lyy622516-web/phase_shifter/README.md

这是6bits移相器设计

当前腔体采用5 mm平底板、四块4 mm独立侧板和2 mm盖板，装配含PCB与左右两个SMA，共九件。SMA法兰孔为M2.2×0.45，针脚下侧至PCB顶面名义间隙0.25 mm。

四角各有两颗横向M2连接螺钉，共八颗：前角用M2×8，后角用M2×6。后角采用1 mm矩形接缝台阶，竖向框架保留六处连接位置；SMA、PCB、接口窗口及壳体外形保持原位置和尺寸。

- [加工文件包（六件壳体、七页工程图）](腔体/平底板腔体/加工文件_六件壳体.zip)
- [装配文件包（含PCB及两侧SMA）](腔体/平底板腔体/装配文件_含PCB及两侧SMA.zip)
- [原生模型、STEP及工程图](腔体/平底板腔体)
- [加工与装配说明](腔体/平底板腔体/说明.txt)

旧腔体模型及交付文件已移除，PCB和连接器参考源保存在[源模型](腔体/源模型)。设计报告保留在原目录，历史报告内容不代表本次几何已同步更新。
