lyy622516-web/phase_shifter/腔体/平底板腔体_侧向固定/说明.txt

移相器腔体（侧向固定版）

在 SolidWorks 中打开“移相器腔体.SLDASM”。装配包含六件壳体、PCB 参考件和左右 SMA，共九个组件。各组件及总装均提供 STEP。

四块 4 mm 厚侧板包围 5 mm 厚平底板，底面齐平，底板四周各留 0.02 mm 装配间隙。每块侧板开两个 Φ2.2 通孔，与底板边缘对应的 M2×0.4-6H 盲螺纹孔连接。底板攻丝底孔 Φ1.6，圆柱深 5 mm，有效牙深 4.5 mm。横向固定可采用 M2×8，穿过侧板及装配间隙后名义啮合约 3.98 mm。侧板四角和盖板的原连接仍保留。

每个 SMA 的 Φ4.1 穿墙孔和四个 M2.2×0.45 法兰孔均位于相应射频侧板上。法兰用 M2.2×5，1.7 mm 法兰厚度下名义啮合 3.3 mm。两侧针脚下缘到 PCB 顶面均为 0.250 mm。

壳体材料 6061-T6。普通线性尺寸公差 ±0.01 mm，普通光孔直径 +0.02/0 mm，螺纹按独立标注。工程图见“工程图”目录。SolidWorks 装配重开和九组件实体干涉核验通过，检查范围为已建模的壳体、SMA 和 PCB。
