lyy622516-web/phase_shifter/0.9-1.3GHz 6bits 360° 数控移相器模块技术方案 .docx

CS32F030 MCU 内置了那些类型与上位机通信的接口

# CS32F030（芯海科技，Cortex-M0）内置上位机通信接口

型号：CS32F030F4P6（我们移相器方案使用的型号），片上自带 USART、SPI、I²C 三组硬件串行接口，另外还有 SWD 调试口（仅调试烧录，不做业务通信）chipsea-ob...

## 1. USART（UART，本项目选用的上位机接口，2 路硬件：USART1 / USART2）

- 支持异步 UART（TTL 电平，就是我们方案里上位机通信），也支持同步模式
- USART1：能力更强，支持自动波特率检测、LIN、ISO7816、IrDA、Modbus、硬件流控 CTS/RTS、RS485 使能，可休眠唤醒 MCU
- USART2：基础 UART，支持异步、硬件流控、RS485 使能；无自动波特率、LIN 等高级功能
- 波特率最高可达 6Mbit/s；支持 DMA 收发，减轻 CPU 负担
- 引脚复用示例（F4P6）：
  - USART1：PA9 (TX) / PA10 (RX)（正是我们之前方案选用引脚）
  - USART2：PA2(TX) / PA3(RX)

✅ 本数控移相器模块就用 USART1 作为上位机 UART 通信，TTL 电平，可外接 CH340 转 USB 直连 PC。

## 2. SPI（2 路硬件 SPI1 / SPI2）

- SPI1：支持 SPI + I²S 音频复用；SPI1/SPI2 都支持主 / 从模式，全双工；帧宽 4~16bit 可编程，最高 18Mbps；支持 DMA、硬件 CRC
- 可用于：外接 SPI Flash、ADC，或者上位机 SPI 通信；本项目不用 SPI 做上位机通信，SPI 在本方案闲置

## 3. I²C（2 路硬件 I2C1 / I2C2）

- 主 / 从模式，7bit/10bit 地址；速率：100k（标准）/400k（快速）/1M（超快模式）；带 PEC 校验、数字 / 模拟滤波器；支持 DMA
- 适合：I2C 传感器、EEPROM；不推荐长距离上位机通信

## 4. SWD（串行调试口 PA13/PA14）

⚠️ 不属于业务通信接口，仅用于程序下载、在线调试，不能用来和上位机传输移相指令。

# 接口选型小结（对应你的 XT3301Q6 移相器项目）

表格

接口 | 是否适合上位机通信 | 说明
USART(UART) | ✅推荐 | TTL 串口，PC 端只需要 CH340，接线简单，抗干扰尚可；本方案选定
SPI | 可选 | 高速，但需要 4 根线；上位机一般不带原生 SPI
I2C | 不推荐 | 适合板内短距离外设，不适合模块和上位机之间通信

# 补充引脚资源（CS32F030F4P6）

USART1：PA9 (TX)、PA10 (RX)；正好保留剩余 GPIO 输出 XT3301Q6 的 6bit 并行控制线 + LE 锁存引脚，资源完全够用。

如果你需要，我可以把CS32F030F4P6 的 USART1 初始化代码框架（接收中断模式）直接写出来，适配当前移相器 UART 指令协议。

CS32F030C8T6（LQFP48）MCU 芯片的 Datasheet

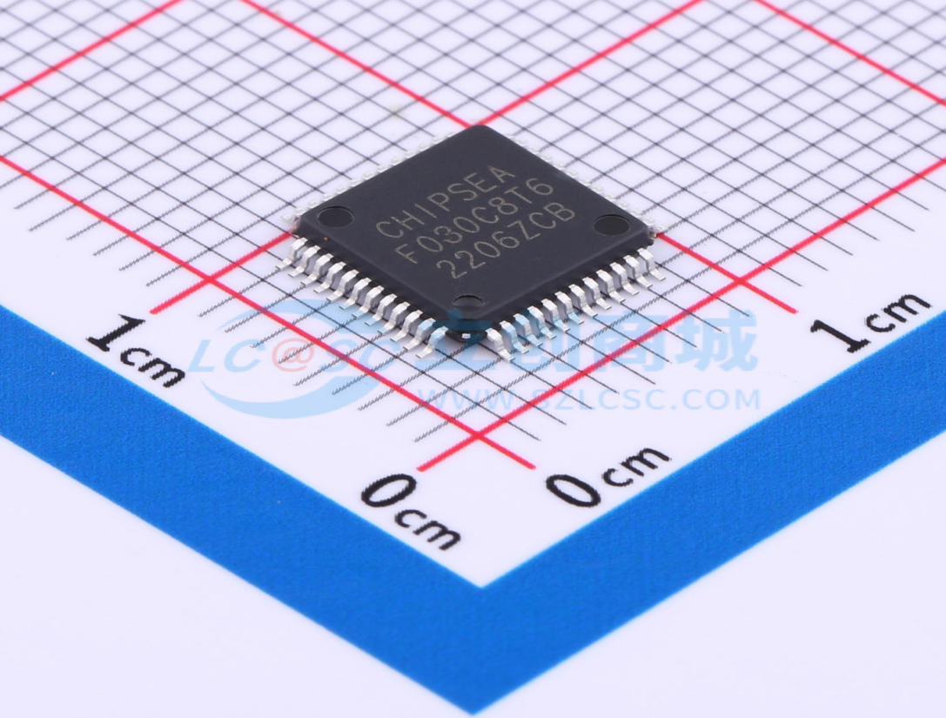
[picture p1: figure]

# CS32F030C8T6（LQFP48）Datasheet 精简版（芯海 CHIPSEA）

芯片：CS32F030C8T6 LQFP48(7×7mm)，Cortex-M0 内核，适配你的移相器主控板

## 1 概述

CS32F030C8T6 是芯海科技 32 位 Cortex-M0 工业级通用 MCU，最高主频 48MHz，内置 64KB Flash / 8KB SRAM，宽电压 2.0~5.5V，LQFP48 封装引出最多 39 路 GPIO，集成 12bit ADC、多路定时器、2×SPI、2×I2C、多路 USART、SWD 单线调试，非常适合你的 XT3301Q6 移相器数字控制板。

### 核心特性

表格

项目 | 参数
内核 | ARM Cortex-M0，最高 48MHz
Flash | 64KB，支持读写保护
SRAM | 8KB，支持硬件奇偶校验
工作电压 | VDD：2.0V ~ 5.5V；模拟电源 VDDA
工作温度 | CS32F030C8T6：-40℃ ~ +85℃；C8T7 版本 - 40~105℃
复位 | 上电复位 POR、掉电复位 BOR、软件复位、独立看门狗复位
时钟源 | 外部高速晶振 HSE（4~32MHz，你的板使用 8MHz）、内部 HSI RC、LSE 32.768kHz、LSI 内部 RC；支持 PLL 倍频到 48MHz
定时器 | 1 路高级 PWM 定时器（带刹车 / 死区）+5 路 16bit 通用定时器；SysTick；独立看门狗 IWDG、窗口看门狗 WWDT；RTC 实时时钟
模拟外设 | 1×12bit ADC，10 路外部通道，最高 1MSPS，内置片上温度传感器
通信接口 | 2×SPI、2×I2C、5×USART（UART）
调试接口 | SWD 单线调试（2 引脚：SWCLK、SWDIO），支持在线烧录 / 调试，无 JTAG
安全模块 | CRC32 硬件校验，96bit 唯一芯片 UID
GPIO | 最多 39 路 GPIO；支持推挽 / 开漏、上下拉；全部支持外部中断
ESD | HBM ±4kV，工业级抗干扰

## 2 LQFP48 引脚定义（重点，适配你当前移相器硬件分配）

LQFP48，逆时针引脚编号，左上角为 Pin1。 你当前硬件分配：PB0~PB5 6bit 移相数据；PB6 为 LE 锁存信号；USART1 接 CH340；USART2 预留；SPI1/I2C1 预留；SWD 用于烧录调试。

表格

引脚 | 名称 | 功能说明
1 | PB8 | GPIO / TIM1_CH2 / USART3_TX
2 | PB9 | GPIO / TIM1_CH3 / USART3_RX
3 | PB10 | GPIO / USART3_TX / I2C2_SCL
4 | PB11 | GPIO / USART3_RX / I2C2_SDA
5 | PB12 | GPIO / TIM1_BKIN
6 | PB13 | GPIO / SPI2_SCK / TIM1_CH1N
7 | PB14 | GPIO / SPI2_MISO / TIM1_CH2N
8 | PB15 | GPIO / SPI2_MOSI / TIM1_CH3N
9 | VDD | 电源 2.0~5.5V（你的板 3.3V 供电）
10 | VSS | GND
11 | PA0 | GPIO / ADC_IN0 / USART2_CTS
12 | PA1 | GPIO / ADC_IN1 / USART2_RTS
13 | PA2 | GPIO / ADC_IN2 / USART2_TX
14 | PA3 | GPIO / ADC_IN3 / USART2_RX
15 | PA4 | GPIO / ADC_IN4 / SPI1_NSS
16 | PA5 | GPIO / ADC_IN5 / SPI1_SCK
17 | PA6 | GPIO / ADC_IN6 / SPI1_MISO
18 | PA7 | GPIO / ADC_IN7 / SPI1_MOSI
19 | PB0 | GPIO / ADC_IN8 / TIM3_CH3 → 移相 Bit0
20 | PB1 | GPIO / ADC_IN9 / TIM3_CH4 → 移相 Bit1
21 | PB2 | GPIO / BOOT1 → 移相 Bit2
22 | PB3 | GPIO / SPI1_SCK / TIM1_CH1 → 移相 Bit3
23 | PB4 | GPIO / SPI1_MISO / TIM1_CH2 → 移相 Bit4
24 | PB5 | GPIO / SPI1_MOSI / TIM1_CH3 → 移相 Bit5
25 | PB6 | GPIO / I2C1_SCL / TIM4_CH1 → LE 锁存信号
26 | PB7 | GPIO / I2C1_SDA / TIM4_CH2
27 | VDD | 电源
28 | VSS | GND
29 | NRST | 复位输入，低电平复位
30 | PC13 | GPIO / RTC_OUT
31 | PC14 | OSC32_IN（LSE 晶振输入）
32 | PC15 | OSC32_OUT（LSE 晶振输出）
33 | PA8 | GPIO / TIM1_CH1
34 | PA9 | GPIO / USART1_TX（CH340 TX）
35 | PA10 | GPIO / USART1_RX（CH340 RX）
36 | PA11 | GPIO / TIM1_CH4
37 | PA12 | GPIO / TIM1_ETR
38 | PA13 | SWDIO（调试数据）
39 | PA14 | SWCLK（调试时钟）
40 | PA15 | GPIO / SPI1_NSS / TIM2_CH1
41 | PB3 | GPIO / SPI1_SCK
42 | PB4 | GPIO / SPI1_MISO
43 | PB5 | GPIO / SPI1_MOSI
44 | PB6 | GPIO / I2C1_SCL
45 | PB7 | GPIO / I2C1_SDA
46 | BOOT0 | 启动配置引脚；BOOT0=0，从主 Flash 启动
47 | VDD | 电源
48 | VSS | GND

你的硬件资源分配汇总：

- PB0~PB5：6bit 相位并行数据输出
- PB6：LE，锁存使能，上升沿锁存 XT3301Q6 相位
- PA9/PA10：USART1，CH340 USB 虚拟串口
- PA2/PA3：USART2，预留扩展串口
- PA4/PA5/PA6/PA7：SPI1，预留
- PB6/PB7：I2C1，预留
- PA13/PA14：SWD 调试口，烧录、在线调试
- NRST：复位引脚

## 3 电气极限参数（最大额定值，超过会永久损坏芯片）

警告：绝对最大额定值，长期工作不能达到此值 | 参数 | 符号 | 极限值 | 单位 | |---|---|---|---| | 供电电压 | VDD|−0.3 ~ +5.8|V| | 模拟电源 | VDDA|−0.3 ~ +5.8|V| |GPIO 输入电压 | VIN|−0.3 ~ VDD+0.3|V| | 单引脚灌 / 拉电流 | I_IO|±20|mA| | 芯片总电流 | IVDD|120|mA| | 存储温度 | Tstg|−55 ~ +125|℃|

## 4 推荐工作条件（正常工作区间，你的板 3.3V 供电）

表格

参数 | 符号 | 最小值 | 典型 | 最大值 | 单位
供电电压 | VDD | 2.0 | 3.3 | 5.5 | V
模拟电源 | VDDA | 2.0 | 3.3 | 5.5 | V
工作温度 | Ta | -40 | 25 | +85 | ℃
系统时钟 | fSYS | — | 48 | 48 | MHz

## 5 电源与复位电路设计要点（硬件调试重点）

1. VDD 每一组电源引脚就近放置 0.1μF X7R 去耦电容，VDD 到 VSS，紧贴 LQFP48 电源引脚；
2. VDDA 模拟电源增加 RC 滤波，减少 ADC 噪声；
3. NRST 复位引脚：上拉 10k 电阻到 VDD，并联 100nF 电容到 GND，上电自动复位；预留复位按键；
4. BOOT0：10k 下拉电阻到 GND，默认 Flash 启动；如需 ISP 烧录，拉高 BOOT0。

## 6 时钟系统（你的移相器板：外部 8MHz HSE 晶振）

- HSE：外部 8MHz 晶振，经 PLL 倍频到 48MHz 作为系统主时钟；
- 内部 HSI：8MHz 内置 RC，可作为备用时钟，不使用外部晶振也可运行；
- LSE：32.768kHz 低速晶振，给 RTC，可选；
- LSI：内部 RC 40kHz，供看门狗。

## 7 SWD 调试接口设计（烧录调试）

- PA13：SWDIO
- PA14：SWCLK
- 不需要 JTAG，仅 2 根线；串联 220Ω 电阻可选保护；
- NRST 可引出给下载器复位。

## 8 外设说明（适配你的项目）

1. USART（UART）：5 路，支持 8N1 等，波特率最高可达 fPCLK/16；你的 USART1 连接 CH340，上位机下发相位指令。
2. SPI：2 路，主 / 从模式，最高 fSYS/2；预留 SPI1。
3. I2C：2 路，标准 100kHz / 400kHz 快速模式。
4. ADC：12bit，1MSPS，10 通道，内置温度传感器。
5. 定时器：高级定时器 TIM1 可输出互补 PWM；TIM2~TIM5 通用定时器，可做定时 / 捕获 / PWM。
6. 看门狗 IWDG/WWDT：用于死机自动复位，整机可靠性加固。

## 9 低功耗模式

- Sleep：CPU 停止，外设保持运行；
- DeepSleep：内核 + 大部分外设关闭，RTC、看门狗可继续运行；
- 待机模式，功耗最低。

## 10 配套开发资料获取

官方原版 PDF 完整 Datasheet 下载：芯海科技官网 CHIPSEA CS32F030 系列规格书；同时提供 SDK 库、寄存器手册、IDE 支持（Keil MDK、芯海 CSIDE）。

## 11 该 MCU 在你的 XT3301 移相器板的调试故障点补充（承接前面故障排查清单）

1. SWD 识别不到：检查 PA13/PA14、NRST、VDD 供电；BOOT0 引脚状态；晶振不起振。
2. GPIO 输出无电平（PB0~PB5、PB6 LE）：检查 GPIO 时钟是否开启，推挽输出配置，引脚是否被复用功能占用。
3. USART 串口无收发：USART 时钟、TX/RX 引脚复用配置，波特率，CH340 供电。
4. 上电死机：BOR 掉电检测、电源时序、复位电路、Flash 读保护。

如果你需要，我可以：

1. 单独输出LQFP48 引脚图文本版，可直接粘贴到原理图文档；
2. 输出CS32F030C8T6 最小系统原理图（文字版）；
3. 输出寄存器简要手册，或者基于该 MCU 的移相器控制底层驱动框架（初始化、相位锁存函数）。

## XT3301Q6 基本参数（先对齐）

- 工艺：GaAs PHEMT
- 频率：0.9–1.3 GHz（覆盖 860–960 MHz）
- 位数：6 bit → LSB=5.625°，0～360°
- 插入损耗：5 dB（typ）
- RMS 相位误差：≤2°
- 输入 P1dB：+23 dBm（typ）
- 控制：0V=0，+5V=1（GPIO 直驱）
- 供电：VEE = –5 V
- 封装：QFN6×6 mm，带底部大焊盘（必须接地）成都仙童科技有限公司

## 二、管脚定义（QFN6×6，俯视图）

参考原厂 PDF 功能框图：

- RFIN（射频输入）：引脚 1
- RFOUT（射频输出）：引脚 3
- VEE（–5V 电源）：引脚 21
- VC1～VC6（6bit 控制，GPIO）：引脚 22、23、24、25、26、27
- GND：引脚 2、19、31 + 底部大焊盘（必须大面积接地）
- NC：其余引脚全部悬空或接地成都仙童科技有限公司

## 三、典型应用电路（直接照抄）

### 1）电源部分（VEE = –5V）

- 引脚 21（VEE）→ 串 0Ω/10Ω 电阻 → –5V 电源
- 就近并联：10 μF（钽 / 陶瓷）+ 0.1 μF（高频） → 到 GND
- 电源回路尽量短，远离射频线

### 2）射频端口（RFIN / RFOUT，50Ω）

- RFIN（1）→ 串联 50Ω 微带线 → 输入信号
- RFOUT（3）→ 串联 50Ω 微带线 → 下一级 / 负载
- 输入 / 输出各串一个 100pF 隔直电容（靠近引脚）
- 射频线阻抗严格 50Ω，线宽按板材算（如 FR4、εr=4.4、板厚 0.5mm → 线宽≈0.8mm）

### 3）控制接口（VC1～VC6，GPIO 0/+5V）

- VC1～VC6（22–27）→ 直接接 MCU/FPGA 的 GPIO
- 控制电平：0V=0，+5V=1（兼容 5V 逻辑）
- 每个控制脚串 1kΩ 限流电阻（可选，保护芯片）
- 控制走线远离射频线，用地线隔离

### 4）地处理

- 所有 GND 引脚（2、19、31）→ 直接打多颗过孔到内层 / 底层地平面
- 底部大焊盘 → 必须全 via 阵列接地（至少 9 颗过孔），不能悬空成都仙童科技有限公司

## 四、GPIO 真值表（6bit，VC1=LSB，VC6=MSB）

- 编码：VC6 VC5 VC4 VC3 VC2 VC1（2⁵～2⁰）
- 步进：5.625°

表格

相位 (°) | VC6 VC5 VC4 VC3 VC2 VC1 | 十六进制
0 | 000000 | 00
5.625 | 000001 | 01
11.25 | 000010 | 02
16.875 | 000011 | 03
22.5 | 000100 | 04
45 | 001000 | 08
90 | 010000 | 10
180 | 100000 | 20
354.375 | 111111 | 3F

- 规律：VC1=5.625°，VC2=11.25°，VC3=22.5°，VC4=45°，VC5=90°，VC6=180°
- 任意相位 = 各位置加权之和（如 30° = 22.5+5.625+1.875 → 000101）

给出手机适配器供电，与上位机的通信接口为UART，基于XT3301Q6、CS32F030的数控射频移相器模块的完整技术方案及BOM

# 基于 XT3301Q6、CS32F030，UART 上位机通信、USB 手机适配器供电数控移相器模块完整技术方案

## 一、方案概述

### 1.1 系统总体架构

模块采用USB 手机适配器 5V 直流供电；

- 射频核心：XT3301Q6，L 波段 0.9~1.3GHz，6bit 数控移相，0~360° 可调，最小步进 5.625°，芯片供电+5V/-5V 双极性模拟电源
- 控制核心：CS32F030（Cortex-M0 国产 MCU），供电 3.3V；
- 上位机接口：UART 异步串口（TTL 电平），上位机（PC / 工控板）通过 UART 下发角度指令，MCU 解析指令，换算为 6bit 移相控制字，并行 IO 输出配置 XT3301Q6；同时回传模块状态、当前相位、电源状态。

不再使用 SPI 作为上位机接口；SPI 仅作为 MCU 内部备用（本方案不用），外部上位机通信改为 UART。

电源链路：USB 适配器 5V 输入

1. 5V → XT3301Q6 +5V 射频模拟电源
2. 5V → LM27762 反极性 DC-DC → 输出-5V 射频模拟电源
3. 5V → LP2985-3.3 低噪声 LDO → 3.3V 数字电源供给 CS32F030、UART 电平、指示灯等数字电路
4. TPS3700 双路电压监控：监测 + 5V、-5V，两路电源稳定后才释放 XT3301Q6 使能，实现上电 / 掉电时序保护，防止射频芯片损坏。

### 1.2 模块主要技术指标

表格

项目 | 参数
射频工作频段 | 0.9GHz～1.3GHz
移相范围 | 0°～360°
移相分辨率 | 6bit，最小步进 5.625°
射频端口阻抗 | 50Ω
上位机通信接口 | UART TTL，波特率默认 115200，8N1 可配置
供电来源 | USB 手机适配器，DC5V 输入
射频芯片电源 | +5V /-5V（模拟）
MCU 电源 | 3.3V（数字）
工作温度 | -40℃～+85℃
控制响应时间 | ≤10μs（收到 UART 指令到相位锁定）

### 1.3 系统工作流程

1. 模块上电：USB 适配器输出 5V；LDO 输出 3.3V，CS32F030 启动；LM27762 产生 - 5V；TPS3700 持续监测 ±5V。
2. 当 + 5V、-5V 电压均达到阈值，TPS3700 输出有效使能信号给到 XT3301Q6；MCU 等待射频电源就绪。
3. 上位机通过 UART 发送串口指令（例如设定角度、读取当前相位、读取电源状态）。
4. CS32F030 接收并解析 UART 指令，将目标角度换算为 6bit 二进制控制字（0~63）。
5. MCU 通过并行 GPIO 输出 6bit 控制码至 XT3301Q6 控制引脚，锁存寄存器，完成相位配置。
6. MCU 通过 UART 向上位机回传应答帧：当前相位值、电源状态、是否执行成功。
7. 持续监听 UART 指令，动态更新相位。

UART 通信协议设计（自定义简易帧，方便上位机调试）

- 帧结构：帧头(0xAA) + 指令码 + 参数 + 校验和 + 帧尾(0x55)
- 指令示例：
  - 0x01：设置相位，参数 0~63（对应 0°~360°）
  - 0x02：读取当前相位
  - 0x03：读取电源状态
  - 0x04：复位移相芯片

## 二、硬件分模块设计

### 2.1 电源单元（USB 5V 输入）

1. 输入接口：USB-A 母座，外接普通手机 5V 适配器（推荐 5V≥2A）；输入端增加 ESD 保护管、10μF 电解 + 0.1μF MLCC 滤波。
2. +5V 模拟电源：USB 输入 5V 直接作为 XT3301Q6 正电源；独立去耦网络（1μF+0.1μF MLCC 紧贴芯片电源引脚）。
3. -5V 生成电路：LM27762 反极性 DC-DC
  - 输入：5V；输出：-5V；配套 4.7μH 屏蔽电感、续流肖特基 SS34；输出配置 10μF 电解 + MLCC 滤波。
4. 3.3V 数字电源：LP2985-3.3 低噪声 LDO
  - 输入 5V，输出干净 3.3V 给 CS32F030、UART、LED；LDO 自带电源抑制比高，隔离数字噪声。
5. 时序保护电路 TPS3700
  - 双路电压检测，分别采样 + 5V、-5V；
  - 只有两路电源都在合格窗口内，OUT 引脚输出高电平，作为 XT3301Q6 的 EN 使能；任意一路欠压 / 掉电，立即拉低 EN，锁死移相芯片，防止损坏。

⚠️ 重要：数字地与射频模拟地分割，单点星形共地（在电源区域汇合）；数字电源、射频模拟电源各自独立去耦，避免数字开关噪声耦合到射频链路，造成相位抖动。

### 2.2 MCU 控制单元 CS32F030F4P6

1. 外设资源分配
  - UART：PA9 (TX)/PA10 (RX) → 对外 UART TTL 接口，接上位机（可选增加 CH340 芯片转 USB，直连 PC）
  - GPIO：6 路并行输出 GPIO → XT3301Q6 6bit 相位控制信号；
  - GPIO：一路输出，XT3301Q6 锁存信号；
  - GPIO：一路输入，读取 TPS3700 电源就绪标志；
  - GPIO：2 路 LED 指示灯控制；
  - 8MHz 无源外部晶振提供系统时钟；内置上电复位 + 外部阻容复位。
2. 电平匹配：CS32F030 IO 为 3.3V，XT3301Q6 控制引脚兼容 3.3V 电平；6 根并行控制线每路串联 100Ω 电阻，抑制数字边沿尖峰，降低串扰。

### 2.3 XT3301Q6 射频移相单元

1. 射频通路：RF IN、RF OUT，50Ω 特性阻抗；射频端口串联高频隔直电容 100pF，隔离直流。
2. XT3301Q6 控制引脚：6bit 并行数据 + 锁存 LE，由 CS32F030 控制；芯片使能 EN 由 TPS3700 电源监控输出硬件控制。
3. PCB 射频走线严格按照 50Ω 阻抗控制；射频区域远离 LM27762 功率电感、数字走线。

### 2.4 UART 上位机通信接口单元

两种对外接口可选：

1. TTL UART 排针（3Pin：TX、RX、GND）：直接连接嵌入式上位机 MCU；
2. 增加 CH340G USB 转 UART 芯片：模块引出 USB 接口，PC 直接用串口助手通信，调试更方便（推荐增加 CH340G 用于实验室调试）。

### 2.5 状态指示单元

- POWER LED：电源正常指示；
- WORK LED：UART 收到有效指令、相位更新时闪烁。

## 三、PCB 设计约束要点（射频板重点）

1. PCB 分区：电源开关区（LM27762 电感放在板边缘）、数字 MCU 区、射频 XT3301Q6 区，区域物理隔离；
2. 射频走线严格 50Ω 阻抗控制，走线尽量短，不要跨分割地平面；
3. XT3301Q6 电源引脚就近放置去耦电容，走线极短；
4. LM27762 功率电感远离射频信号线，减少开关谐波耦合进 L 波段；
5. 数字地、射频模拟地分割，单点共地；不要大面积跨地走线；
6. UART 信号线远离射频走线，避免干扰。

## 四、软件框架（CS32F030）

1. 初始化：系统时钟、UART（115200，8N1）、GPIO、外部中断；读取 TPS3700 电源就绪标志。
2. UART 接收中断：接收上位机串口帧，校验，解析指令。
3. 角度换算函数：输入角度 0~360° → 映射为 6bit 控制字 0~63；

control_word = round (angle / 5.625)，限制范围 0~63

4. 相位配置函数：输出 6bit 数据到 GPIO，拉高锁存 LE，完成 XT3301Q6 寄存器写入。
5. 应答帧打包，UART 发送回上位机。
6. 故障处理：电源未就绪时，拒绝执行相位配置指令，向上位机返回报错。

## 五、完整 BOM 清单

表格

序号 | 器件名称 | 型号规格 | 数量 | 用途说明
1 | 数控移相芯片 | XT3301Q6 | 1 | 射频核心，0.9~1.3GHz 6bit 移相，供电 + 5V/-5V
2 | 主控 MCU | CS32F030F4P6 | 1 | UART 串口通信、角度换算、并行 IO 控制 XT3301Q6
3 | 反极性 DC-DC | LM27762 | 1 | 5V 输入生成射频 - 5V 电源
4 | 低噪声 LDO | LP2985-3.3 | 1 | 5V 转 3.3V，为 MCU、数字电路供电
5 | 双路电源监控芯片 | TPS3700 | 1 | 监测 + 5V/-5V，时序保护，输出 XT3301Q6 使能
6 | USB 转串口芯片（可选） | CH340G | 1 | UART 转 USB，PC 直接串口调试；不用则去掉
7 | 反压功率电感 | 4.7μH，屏蔽 0603 | 1 | LM27762 配套功率电感
8 | 肖特基二极管 | SS34 | 1 | LM27762 续流二极管
9 | 高频 MLCC | 1μF/10V X7R 0402 | 4 | XT3301Q6 ±5V 电源就近去耦
10 | MLCC 去耦电容 | 0.1μF/50V 0402 | 12 | 全板芯片电源去耦（MCU、电源芯片、CH340G）
11 | 贴片电解电容 | 10μF/10V | 2 | USB 输入滤波、-5V 输出储能滤波
12 | 贴片电阻 | 10kΩ 0402 | 7 | TPS3700 分压、上拉电阻、MCU 复位电阻
13 | 贴片电阻 | 100Ω 0402 | 6 | 6 根并行控制线串联，抑制数字尖峰
14 | 贴片电阻 | 220Ω 0402 | 2 | LED 指示灯限流
15 | LED 指示灯 | 0402 红 / 绿 | 2 | 电源、工作状态指示
16 | 射频隔直电容 | 100pF 0402 高频 | 2 | RF IN / RF OUT 隔直保护
17 | SMA 射频座 | 贴片 SMA | 2 | 射频输入输出 50Ω 接口
18 | USB 母座 | USB-A 母座 | 1 | 外接手机 5V 适配器供电
19 | UART 排针 | 2.54mm 3P 排针 | 1 | TTL UART 上位机接口 (TX/RX/GND)
20 | 无源贴片晶振 | 8MHz | 1 | CS32F030 系统外部时钟
21 | 复位电容 | 0.1μF 0402 | 1 | MCU 上电复位阻容配套
22 | ESD 保护管 | SRV05-4 | 1 | USB 输入、UART 接口静电保护

备注：如果不需要 PC 端 USB 串口调试，可删除 CH340G，节省 BOM 成本，只保留 TTL UART 排针接口。

## 六、方案风险评估与优化建议

1. 时序风险：TPS3700 硬件时序保护是必选，不能省略；上电掉电时，防止单路电源存在烧毁 XT3301Q6。
2. 噪声风险：LM27762 开关电源会引入噪声；如果射频相位噪声指标要求极高，可以在 ±5V 电源后增加 LC 低通滤波网络。
3. UART 通信可靠性：增加帧头、帧尾、校验和，避免串口干扰造成误指令；MCU 增加指令校验和容错。
4. 供电适配器选型：选用普通 5V 输出手机适配器，不要使用大功率快充头（虽然快充头空载默认 5V，但优先选固定 5V 输出的 5V/2A 充电头）。

## 七、可选扩展

1. 增加板载 EEPROM，保存用户预设相位参数；
2. 增加温度传感器，实现相位温度补偿；
3. 多路扩展：增加多片 XT3301Q6，CS32F030 扩展多路并行控制，用于小型相控阵。

如果你需要下一步，我可以提供：

1. 文字版完整原理图（电源、MCU、UART、XT3301Q6 控制电路）；
2. CS32F030 的 C 语言工程框架（UART 接收、角度换算、XT3301Q6 写锁存代码）；
3. 上位机串口调试助手指令集文档。

给出手机适配器供电，与上位机的通信接口为 USB（并保留 CS32F030 的 一个 UART、SWD、SPI、I²C 为对外输入 / 输出接口），基于 XT3301Q6、CS32F030 的数控射频移相器模块的完整技术方案及 BOM

# 数控射频移相器模块完整技术方案

硬件平台：XT3301Q6（0.9~1.3GHz，6bit GaAs 数控移相器）+ CS32F030；

供电：USB 手机适配器 5V；

上位机通信：USB 虚拟串口（CH340G，USB 转 UART）；

对外预留接口：独立引出 1 路 UART、SWD、SPI、I²C，所有预留接口和 XT3301Q6 控制引脚无复用冲突，可以同时工作。

核心改进：更换 MCU 封装为 CS32F030C8T6（LQFP48），引脚资源充足，解决 F4P6 引脚复用冲突问题。 CS32F030C8T6：Cortex-M0，48MHz，64KB Flash，8KB RAM，外设资源完整，引脚富裕，非常适合本项目。

## 一、系统总体架构

手机USB适配器 5V输入

├─ +5V → XT3301Q6 射频模拟正电源

├─ 5V → LM27762反极性DC-DC → -5V，XT3301Q6射频模拟负电源

└─ 5V → LP2985-3.3低噪声LDO → 3.3V数字电源

├─ CS32F030C8T6主控

├─ CH340G（USB转UART，PC上位机通信）

└─ 预留对外接口电路、LED指示灯

CS32F030

├─ USART1 ↔ CH340G：USB虚拟串口，PC下发相位指令（主通信通道）

├─ 6路GPIO + 1路LE锁存GPIO → XT3301Q6并行控制信号

├─ GPIO输入：读取TPS3700电源就绪标志

├─ USART2：独立对外预留UART（TTL）

├─ SPI1：独立对外预留SPI

├─ I2C1：独立对外预留I²C

└─ SWD：独立对外预留调试烧录接口

TPS3700双路电源监控：监测+5V/-5V，硬件使能XT3301Q6，上电/掉电时序保护

### 1.1 模块技术指标

表格

项目 | 参数
射频芯片 | XT3301Q6，L 波段 0.9~1.3GHz
移相范围 | 0°～360°
移相分辨率 | 6bit，最小步进 5.625°
射频端口阻抗 | 50Ω
上位机通信 | USB 虚拟串口（CH340G），默认波特率 115200，8N1
模块供电 | USB 手机适配器 DC5V，推荐 5V≥2A
XT3301Q6 供电 | +5V /-5V 双极性模拟电源
MCU 数字电源 | 3.3V
对外预留 IO 接口（全部独立无冲突） | UART（USART2 TTL）、SWD、SPI1、I2C1
工作温度 | -40℃ ~ +85℃
控制响应时间 | ≤10μs（收到 USB 指令到相位锁存完成）

### 1.2 系统工作流程

1. USB 上电，5V 建立；LP2985 输出 3.3V，CS32F030 启动；LM27762 生成稳定 - 5V。
2. TPS3700 实时采样 + 5V、-5V；两路电源均在正常阈值内，输出高电平硬件使能 XT3301Q6；MCU 读取电源就绪信号。
3. PC 上位机通过 USB 虚拟串口下发自定义帧指令：设置相位、读取当前相位、读取电源状态。
4. CS32F030 的 USART1 接收串口帧，校验、解析；角度换算为 6bit 控制字（0-63）。
5. MCU 并行 GPIO 输出 6bit 相位数据 + LE 锁存信号到 XT3301Q6，锁存寄存器完成相位配置。
6. MCU 向上位机回传应答帧：当前相位、电源状态、指令执行结果。
7. 预留对外接口并行可用：
  - 对外 UART（USART2）：可外接其他下位机 / 传感器；
  - 对外 SPI：外接 SPI Flash、高速 ADC；
  - 对外 I²C：外接温度传感器、EEPROM；
  - SWD：随时在线调试、固件烧录。

预留接口和 XT3301Q6 控制引脚完全独立，可以同时工作，不存在分时切换。

### 1.3 PC ↔ MCU 通信帧协议（USB 虚拟串口）

帧结构：0xAA（帧头） + 指令码 + 参数 + 校验和 + 0x55（帧尾）

- 0x01：设置相位，参数：0~63（对应 0°~360°）
- 0x02：读取当前相位
- 0x03：读取电源状态（+5V/-5V 是否正常）
- 0x04：复位移相芯片

## 二、硬件单元详细设计

### 2.1 电源单元（USB 5V 输入）

1. USB-A 母座，外接手机 5V 适配器；输入端增加 ESD 保护 SRV05-4；10μF 电解 + 0.1μF MLCC 滤波。
2. +5V 模拟电源：USB 输入 5V 直接供给 XT3301Q6；芯片电源引脚就近放置 1μF+0.1μF MLCC 去耦。
3. -5V 电源：LM27762 反极性 DC-DC，输入 5V，输出 - 5V；配套 4.7μH 屏蔽功率电感、SS34 肖特基续流二极管；输出配置 10μF 电解 + MLCC 滤波。
4. 3.3V 数字电源：LP2985-3.3 低噪声 LDO，输入 5V；输出供给 CS32F030、CH340G、LED、全部预留接口；高 PSRR 抑制电源噪声。
5. 时序保护 TPS3700：双路电压监控，采集 + 5V、-5V。两路电压全部合格才输出高电平，作为 XT3301Q6 硬件 EN 使能；任意一路欠压，立刻拉低 EN，保护 GaAs 移相芯片。

PCB 地设计：射频模拟地、数字地分割，单点星形共地，汇合点放在电源区域；射频走线禁止跨分割地平面。

### 2.2 CS32F030C8T6 主控单元（LQFP48）

引脚资源分配（无引脚复用冲突）

表格

功能 | MCU 引脚 | 说明
USART1_TX | PA9 | 接 CH340G RXD（PC 上位机 USB 通信）
USART1_RX | PA10 | 接 CH340G TXD
相位数据 D0~D5 | PB0~PB5 | 6bit 并行输出至 XT3301Q6；每根串 100Ω 电阻
LE 锁存信号 | PB6 | XT3301Q6 锁存使能
PWR_RDY 输入 | PB7 | 读取 TPS3700 电源就绪标志
USART2_TX | PA2 | 对外预留 UART TX
USART2_RX | PA3 | 对外预留 UART RX
SPI1_SCK | PA5 | 对外预留 SPI 时钟
SPI1_MOSI | PA7 | 对外预留 SPI 主机发
SPI1_MISO | PA6 | 对外预留 SPI 主机收
SPI1_NSS | PA4 | 对外预留 SPI 片选
I2C1_SCL | PB8 | 对外预留 I2C 时钟
I2C1_SDA | PB9 | 对外预留 I2C 数据
SWDIO | PA13 | 对外预留 SWD 调试数据
SWCLK | PA14 | 对外预留 SWD 调试时钟
LED_POWER | PC13 | 电源指示灯
LED_WORK | PC14 | 工作指示灯
外部晶振 | PD0/PD1 | 8MHz 无源晶振

所有预留接口（UART2、SPI1、I2C1、SWD）全部引出 2.54mm 排针，独立可用，不占用 XT3301Q6 控制引脚。

### 2.3 CH340G USB 转 UART 单元

CH340G 实现 USB 全速转 TTL UART；D+/D - 接 USB 母座差分数据线；CH340G 外接 12MHz 晶振；CH340G TX/RX 交叉连接 CS32F030 USART1 RX/TX；PC 安装 CH340 驱动识别为虚拟串口。USB 母座同时承担5V 供电输入 + USB 数据通信。

### 2.4 XT3301Q6 射频移相单元

- RF IN / RF OUT：贴片 SMA 50Ω 射频座；射频通路串联 100pF 高频隔直电容。
- XT3301Q6：6bit 并行数据、LE 锁存引脚由 CS32F030 控制；芯片 EN 引脚由 TPS3700 硬件控制。
- PCB 射频走线严格 50Ω 阻抗控制；射频区域远离 LM27762 功率电感、数字信号线，降低开关谐波耦合，避免相位抖动。

### 2.5 对外预留扩展接口（全部引出 2.54mm 排针）

1. 预留 UART（USART2）：3P 排针（TX、RX、GND），TTL 电平；可外接其他串口设备。
2. 预留 SPI：4P 排针（SCK、MOSI、MISO、NSS）。
3. 预留 I²C：4P 排针（SDA、SCL、3.3V、GND）；SDA/SCL 增加 10kΩ 上拉电阻。
4. SWD 调试口：4P 排针（3.3V、GND、SWDIO、SWCLK）；固件下载 + 在线调试。

### 2.6 状态指示单元

- POWER LED：3.3V 电源正常常亮；
- WORK LED：收到 USB 有效指令、相位更新时闪烁。

## 三、PCB 设计关键约束

1. PCB 分区：LM27762 开关电源区（电感放置板边缘）、数字 MCU 区、XT3301Q6 射频区，物理隔离。
2. 射频走线严格 50Ω 阻抗，走线尽量短；XT3301Q6 电源引脚就近放置去耦电容。
3. LM27762 功率电感远离射频信号线，降低开关噪声耦合。
4. USB 差分 D+/D - 走线等长、短，远离射频走线。
5. 6 根并行控制线串 100Ω 电阻，电阻靠近 MCU 引脚，抑制数字边沿尖峰。
6. 所有对外扩展接口排针布置在板边缘，远离射频区域。

## 四、软件框架（CS32F030C8T6）

1. 系统初始化：48MHz 系统时钟、USART1、USART2、SPI1、I2C1、GPIO；读取 TPS3700 电源就绪标志。
2. USART1 中断接收：PC 下发 USB 虚拟串口帧，校验和校验，解析指令。
3. 角度换算函数：control_word = round(angle / 5.625)，限幅 0~63。
4. 相位配置函数：输出 6bit 数据，拉高 LE 锁存，写入 XT3301Q6 寄存器。
5. 应答帧打包，USART1 发送回 PC 上位机。
6. 外设驱动预留：USART2、SPI1、I2C1 驱动代码，支持外接扩展外设；SWD 保持开启随时调试。
7. 故障保护逻辑：电源未就绪时，拒绝执行相位配置指令，向上位机返回报错。

## 五、完整 BOM 清单

表格

序号 | 器件名称 | 型号规格 | 数量 | 用途说明
1 | 数控移相芯片 | XT3301Q6 | 1 | 射频核心，0.9~1.3GHz 6bit 移相，+5V/-5V 供电
2 | 主控 MCU | CS32F030C8T6 LQFP48 | 1 | USB 串口指令解析、XT3301Q6 控制；独立引出 USART2/SPI1/I2C1/SWD
3 | USB 转 UART 芯片 | CH340G SOP8 | 1 | USB 转 TTL 串口，PC 上位机通信
4 | 反极性 DC-DC | LM27762 | 1 | 5V 输入生成 XT3301Q6 -5V 射频电源
5 | 低噪声 LDO | LP2985-3.3 | 1 | 5V 转 3.3V，MCU、CH340G、数字外设供电
6 | 双路电源监控芯片 | TPS3700 | 1 | 监测 + 5V/-5V，硬件时序保护，XT3301Q6 使能
7 | 反压功率电感 | 4.7μH，屏蔽型 0603 | 1 | LM27762 配套功率电感
8 | 肖特基二极管 | SS34 | 1 | LM27762 续流二极管
9 | CH340 晶振 | 12MHz 贴片晶振 | 1 | CH340G 时钟源
10 | MCU 系统晶振 | 8MHz 无源贴片晶振 | 1 | CS32F030 系统时钟
11 | 高频 MLCC | 1μF/10V X7R 0402 | 4 | XT3301Q6 ±5V 电源就近去耦
12 | MLCC 去耦电容 | 0.1μF/50V 0402 | 16 | 全板芯片电源去耦（MCU、CH340G、电源芯片）
13 | 贴片电解电容 | 10μF/10V | 2 | USB 输入滤波、-5V 输出储能滤波
14 | 贴片电阻 | 10kΩ 0402 | 10 | TPS3700 分压、上拉、MCU 复位、I2C 上拉电阻
15 | 贴片电阻 | 100Ω 0402 | 6 | 6 根并行控制线串联，抑制数字边沿尖峰
16 | 贴片电阻 | 220Ω 0402 | 2 | LED 指示灯限流
17 | LED 指示灯 | 0402 红 / 绿 | 2 | 电源、工作状态指示
18 | 射频隔直电容 | 100pF 0402 高频 | 2 | RF IN / RF OUT 隔直保护
19 | SMA 射频座 | 贴片 SMA | 2 | 射频输入输出 50Ω 接口
20 | USB 母座 | USB-A 母座 | 1 | 接入手机 5V 适配器供电，USB 数据通信
21 | ESD 保护管 | SRV05-4 | 1 | USB 接口 D+/D-、VBUS 静电保护
22 | 复位电容 | 0.1μF 0402 | 1 | MCU 上电复位阻容配套
23 | SWD 排针 | 2.54mm 4P 排针 | 1 | 对外 SWD 调试烧录接口
24 | 预留 UART 排针 | 2.54mm 3P 排针 | 1 | 对外 USART2（TX/RX/GND）
25 | 预留 SPI 排针 | 2.54mm 4P 排针 | 1 | 对外 SPI1 扩展接口
26 | 预留 I²C 排针 | 2.54mm 4P 排针 | 1 | 对外 I2C1 扩展接口

## 六、风险评估与优化建议

1. 电源时序保护不可省略：TPS3700 是硬性要求，XT3301Q6 为 GaAs MMIC 芯片，单路电源上电极易永久损坏。
2. 射频噪声优化：LM27762 开关电源存在开关噪声；高精度相位指标场景，±5V 电源后端增加 LC 低通滤波网络，抑制纹波。
3. 适配器选型：优先选用普通 5V 固定输出手机适配器（5V 2A）；尽量避免大功率快充头，快充头空载虽输出 5V，但纹波特性较差。
4. 预留接口电平：所有对外接口均为 3.3V TTL 电平，外接外设注意电平匹配，禁止 5V 信号直接输入预留 IO。

## 七、可选扩展

1. I²C 外接温度传感器，EEPROM 存储多组预设相位参数；
2. 扩展多路 XT3301Q6，搭建小型相控阵；
3. 增加 ADC 采样监测 ±5V 电源电压，上报上位机。

如果你需要，下一步可以输出： 1）文字版完整原理图（电源、CH340G、CS32F030、XT3301Q6 + 全部预留接口）； 2）CS32F030C8T6 的完整 C 代码框架（USB 虚拟串口指令解析、XT3301Q6 相位配置、USART2/SPI/I2C 预留驱动）； 3）PCB 布局约束清单（射频 + 电源 + 数字接口）。你想要哪一部分？

文字版完整原理图（电源、CH340G、CS32F030、XT3301Q6 + 全部预留接口）

# 文字版完整原理图（模块：USB 供电，CH340G+CS32F030C8T6+XT3301Q6，预留 UART2/SPI1/I2C1/SWD）

说明：文字原理图按功能模块划分；标注引脚、阻容连接、电源网络；GND 分为DGND 数字地、AGND 射频模拟地，单点共地连接。 电源网络：USB_5V（USB 输入 5V）、AVCC5（XT3301Q6 +5V 模拟电源）、AVCCN5（XT3301Q6 -5V 模拟电源）、VCC3P3（3.3V 数字电源）

## 一、USB 输入 & ESD 保护电路

USB-A母座

Pin1 VBUS → USB_5V

Pin2 D- → SRV05-4 Pin2；同时接CH340G D-

Pin3 D+ → SRV05-4 Pin3；同时接CH340G D+

Pin4 GND → DGND

SRV05-4（ESD四向保护管）

Pin1 → DGND

Pin2 → USB_D-

Pin3 → USB_D+

Pin4 → USB_5V

USB_5V 输入端并联：C1 (10μF/10V 电解) 正极接 USB_5V，负极 DGND；C2 (0.1μF MLCC) 跨 USB_5V ↔ DGND

USB_5V 分三路： ① AVCC5（直接给到 XT3301Q6 +5V 模拟电源） ② LM27762 VIN 输入 ③ LP2985-3.3 VIN 输入

## 二、+5V 转 - 5V 反压电源 LM27762

LM27762

Pin1 VIN → USB_5V

Pin2 GND → DGND

Pin3 SW → L1(4.7μH屏蔽电感)一端

L1另一端 → AVCCN5（-5V输出）

Pin4 FB → AVCCN5（反馈引脚）

Pin5 OUT → AVCCN5

输出滤波：

C3(10μF电解)：负极AVCCN5，正极DGND

C4(0.1μF MLCC)：AVCCN5 ↔ DGND

AVCC5（USB_5V）、AVCCN5（-5V）送到 TPS3700 电压检测输入端。

## 三、5V 转 3.3V LDO LP2985-3.3

LP2985-3.3

Pin1 VIN → USB_5V

Pin2 GND → DGND

Pin3 EN → USB_5V（一直使能）

Pin4 BYPASS → C5(0.01μF MLCC) → DGND

Pin5 VOUT → VCC3P3（3.3V数字电源）

输出滤波：

C6(1μF MLCC) VCC3P3 ↔ DGND

C7(0.1μF MLCC) VCC3P3 ↔ DGND

VCC3P3 供给：CS32F030、CH340G、所有预留接口上拉电阻、LED。

## 四、双路电源监控 TPS3700（时序保护，XT3301Q6 硬件使能）

TPS3700：双路电压窗口比较器，OUT 输出作为 XT3301Q6 EN 使能

TPS3700

VDD → VCC3P3

GND → DGND

INA+ → 电阻分压采样 AVCC5(+5V)

INA- → 内部参考

INB+ → 电阻分压采样 AVCCN5(-5V)

INB- → 内部参考

OUT → R1(10kΩ)上拉到VCC3P3；同时接到XT3301Q6 EN；同时接到CS32F030 PB7（电源就绪输入GPIO）

分压电阻：

- +5V 检测：R2 (10k) AVCC5 → INA+；R3 (10k) INA+ → DGND
- -5V 检测：R4 (10k) AVCCN5 → INB+；R5 (10k) INB+ → DGND

## 五、CH340G USB 转 UART 电路（PC 上位机 USB 通信）

CH340G

VCC → VCC3P3

GND → DGND

XI → X1(12MHz贴片晶振)一端

XO → X1另一端；晶振两端各接C8/C9(22pF)到DGND

D+ → USB母座D+

D- → USB母座D-

TXD → CS32F030 PA10(USART1_RX)

RXD → CS32F030 PA9(USART1_TX)

RST# → C10(0.1μF)到DGND；R6(10k)上拉VCC3P3

通信方向：CH340G.TXD → MCU.RX；CH340G.RXD → MCU.TX（交叉连接）

## 六、CS32F030C8T6 主控最小系统

CS32F030C8T6

VDD(所有电源引脚) → VCC3P3

VSS(所有地引脚) → DGND

外部8MHz无源晶振：

PD0(OSC_IN) → X2(8MHz晶振)

PD1(OSC_OUT) → X2；晶振两端C11/C12(22pF)→DGND

MCU复位电路：NRST引脚

NRST → R7(10k)上拉VCC3P3；C13(0.1μF)接NRST→DGND

【XT3301Q6控制信号输出】

PB0 → R10(100Ω) → XT3301Q6 D0

PB1 → R11(100Ω) → XT3301Q6 D1

PB2 → R12(100Ω) → XT3301Q6 D2

PB3 → R13(100Ω) → XT3301Q6 D3

PB4 → R14(100Ω) → XT3301Q6 D4

PB5 → R15(100Ω) → XT3301Q6 D5

PB6 → R16(100Ω) → XT3301Q6 LE（锁存信号）

PB7(输入) → TPS3700.OUT 电源就绪标志

【主通信 USART1（对接CH340G）】

PA9 USART1_TX → CH340G RXD

PA10 USART1_RX → CH340G TXD

【对外预留接口（全部引出排针）】

// 预留UART USART2

PA2 USART2_TX → 排针 UART2_TX

PA3 USART2_RX → 排针 UART2_RX

排针公共GND → DGND

// 预留 SPI1

PA5 SPI1_SCK → 排针 SPI_SCK

PA7 SPI1_MOSI → 排针 SPI_MOSI

PA6 SPI1_MISO → 排针 SPI_MISO

PA4 SPI1_NSS → 排针 SPI_NSS

// 预留 I2C1

PB8 I2C1_SCL → R17(10k上拉VCC3P3) → 排针 I2C_SCL

PB9 I2C1_SDA → R18(10k上拉VCC3P3) → 排针 I2C_SDA

排针 I2C_VCC → VCC3P3；排针GND→DGND

// SWD调试口

PA13 SWDIO → 排针 SWDIO

PA14 SWCLK → 排针 SWCLK

排针 SWD_VCC → VCC3P3；排针GND→DGND

【LED指示灯】

PC13 → R19(220Ω) → 红色LED阳极；LED阴极DGND（POWER灯）

PC14 → R20(220Ω) → 绿色LED阳极；LED阴极DGND（WORK灯）

## 七、XT3301Q6 射频移相器核心电路

XT3301Q6

VDD → AVCC5 (+5V模拟电源)

VSS → AVCCN5 (-5V模拟电源)

GND → AGND（射频模拟地）

EN → TPS3700.OUT 硬件使能

D0~D5：6bit相位数据输入，来自CS32F030 PB0~PB5（串100Ω电阻）

LE：Latch锁存使能，来自CS32F030 PB6（串100Ω电阻）

射频端口：

RF_IN → C_RF1(100pF高频射频电容) → XT3301Q6 RFIN引脚

RF_OUT → C_RF2(100pF高频射频电容) → XT3301Q6 RFOUT引脚

RF_IN、RF_OUT 分别连接贴片SMA座

电源就近去耦（紧贴XT3301Q6芯片电源引脚）：

C14(1μF X7R) AVCC5 ↔ AGND

C15(0.1μF) AVCC5 ↔ AGND

C16(1μF X7R) AVCCN5 ↔ AGND

C17(0.1μF) AVCCN5 ↔ AGND

AGND (射频模拟地) 和 DGND (数字地)：单点用 0Ω 电阻连接（单点星形共地，放置在电源区域，不允许多点相连）

## 八、所有对外排针引脚汇总（2.54mm）

1. 预留 UART2 3P 排针：UART2_TX、UART2_RX、GND
2. 预留 SPI1 4P 排针：SPI_SCK、SPI_MOSI、SPI_MISO、SPI_NSS
3. 预留 I2C1 4P 排针：I2C_SCL、I2C_SDA、VCC3P3、GND
4. SWD 4P 排针：SWDIO、SWCLK、VCC3P3、GND

## 九、地网络规则（非常关键）

1. AGND：XT3301Q6 射频地、AVCC5/AVCCN5 电源去耦电容地；
2. DGND：MCU、CH340G、LM27762、LDO、所有数字电阻电容、LED、排针地；
3. AGND 与 DGND 之间仅一处 0Ω 电阻单点连接，放在电源区域，不能跨射频信号线；
4. 射频走线全部在 AGND 区域，不能穿过 DGND 分割槽。

## 十、电路简要说明 & 注意事项

1. 上电时序：USB_5V 先建立 → LDO 输出 VCC3P3；LM27762 建立 AVCCN5；TPS3700 检测 ±5V 都正常，拉高 XT3301Q6 EN；MCU 收到 PB7 就绪标志，才允许下发相位配置。
2. XT3301Q6 的 EN 是硬件保护，软件无法绕过；只要 ±5V 任一电源异常，芯片立即被硬件关闭。
3. CH340G 实现 USB 虚拟串口，PC 端通过 CH340 驱动和 MCU USART1 通信；USART2、SPI、I2C 为独立对外扩展接口，和 XT3301Q6 控制引脚完全独立，可同时工作。
4. 所有对外预留接口均为 3.3V TTL 电平，严禁外接 5V 信号，防止 MCU IO 损坏。

如果你需要，我下一步可以输出： 1）CS32F030C8T6 完整 Keil 工程 C 代码框架（USB 虚拟串口指令解析，XT3301Q6 写锁存，预留 USART2/SPI/I2C 驱动）； 2）PCB 布局分区与布局约束清单。

文字版完整原理图中，USB输入&ESD保护电路部分还可以添加哪些保护措施？

文字版完整原理图中，电源部分还可以添加哪些保护措施？

文字版完整原理图中，CS32F030部分还可以添加哪些保护措施？

# USB 输入 & ESD 保护电路可追加的保护措施（适配本移相器模块）

原有电路：USB-A 母座 + SRV05-4（D+/D-/VBUS ESD）+ 输入电解 + MLCC。 模块特点：USB VBUS 同时作为整机主功率电源（5V，给 LM27762、LDO、XT3301Q6 系统供电），不只是信号口；射频板，电源噪声会直接影响移相器相位精度，所以保护要兼顾浪涌、过流、反接、ESD、噪声抑制。

## 一、功率侧（VBUS 5V 电源线上增加）

### 1. 自恢复保险丝（PPTC，推荐 0603）

串在 USB 母座 VBUS 引脚之后，SRV05-4 之前。

- 选型：500mA/6V PPTC（例如：MF-R050）
- 作用：过流保护。防止后端电源芯片短路（LM27762/LP2985 短路），烧毁 USB 适配器或板上线路；短路时 PPTC 高阻限流，故障移除自动恢复。

注意：不要选太大电流，本模块总功耗不大；PPTC 会有几十 mΩ 串联电阻，对 5V 压降影响很小。

### 2. TVS 管（功率型 TVS，并联 VBUS 到 DGND）

原有 SRV05-4 是信号级 ESD 管，对电源端口的电快速脉冲、浪涌防护偏弱。 增加单向 TVS 并联在 PPTC 之后、主电路之前：

- 选型：SMBJ6.5A（单向，6.5V 钳位）
- 作用：吸收 VBUS 上的雷电感应浪涌、插拔大能量脉冲；SRV05 负责 D+/D - 信号 ESD，SMBJ6.5A 专门保护 5V 功率轨，分工更合理。

### 3. 防电源反接保护（二选一）

#### 方案 A：肖特基二极管（低压降，优先推荐）

串在 VBUS，PPTC 之后：SS34（40V/3A 肖特基）

- 正向压降≈0.2~0.3V；缺点：持续电流有功耗，5V 会轻微掉到 4.7~4.8V，对本系统完全可用。
- 作用：USB 电源线插反时，直接阻断电流，保护所有后端芯片。

#### 方案 B：理想二极管 / 防反接 MOS（无压降，高精度测量场景）

用 P-MOS 做理想二极管，几乎无压降；适合对 AVCC5 电压精度要求极高（XT3301Q6 供电电压敏感），不想因为肖特基带来压降的场景；成本更高，需要额外小电阻。

本模块 XT3301Q6 使用 USB 直接 5V 做 AVCC5，如果相位指标要求严格，优先选 P-MOS 理想二极管方案。

### 4. 共模扼流圈（D+/D - 差分信号，USB 信号噪声隔离）

串在 D+、D - 线上，USB 母座 D+/D - 之后，CH340G 之前，放在 SRV05-4 后面。

- 选型：0603 USB 专用共模电感（如 ACM6060-100M，100Ω@100MHz）
- 作用：抑制 USB 差分线上的共模干扰；减少 USB 高速信号引入的高频噪声串入射频地，降低 XT3301Q6 相位噪声。

对本射频模块非常有价值：CH340 是全速 USB，高频共模噪声极易耦合进射频电路，造成相位抖动。

## 二、电源输入滤波增强（降噪，兼顾保护）

原有：10μF 电解 + 0.1μF MLCC。可以优化为组合：

1. 大容量：10μF 钽电容 / 聚合物电容（低 ESR，替换普通电解，抗浪涌电流更好）
2. 中高频：1μF X7R MLCC + 0.1μF MLCC，三者并联在 VBUS 输入。

普通电解高频 ESR 大，浪涌瞬间抑制能力差；钽电容注意必须加 PPTC 做前置限流，防止钽电容炸裂。

## 三、可选附加保护 / 监测电路（进阶）

### 1. VBUS 电压检测（MCU 输入）

电阻分压（10k+10k）从 VBUS 接到 CS32F03C8T6 ADC 输入引脚。

- 功能：软件监测 USB 输入 5V 是否跌落 / 过压；电压异常时软件提前关闭相位更新，上报上位机预警。

属于预警，不是硬件保护。

### 2. 压敏电阻（雷击大能量浪涌，仅在强 EMC 环境可选）

并联 VBUS 到 DGND；缺点：体积大，老化后漏电流上升；实验室桌面使用一般不需要，做 EMC 测试 / 工业环境才增加。

## 四、更新后的 USB 输入电路拓扑（文字原理图）

USB-A母座

Pin1 VBUS → PPTC(500mA) → 防反接SS34肖特基 → 节点VBUS_5V_IN

Pin2 D- → 共模扼流圈D-绕组 → SRV05-4 Pin2 → CH340G D-

Pin3 D+ → 共模扼流圈D+绕组 → SRV05-4 Pin3 → CH340G D+

Pin4 GND → DGND

SRV05-4

Pin1 → DGND

Pin2 → D-

Pin3 → D+

Pin4 → VBUS（母座侧，PPTC前端）

SMBJ6.5A（功率TVS）阳极DGND，阴极接VBUS_5V_IN

VBUS_5V_IN并联滤波：

10μF聚合物电容，1μF MLCC，0.1μF MLCC，全部接到DGND

VBUS_5V_IN → 向后分给：LM27762，LP2985，AVCC5（XT3301Q6+5V）

## 五、优先级建议（按重要程度排序）

1. ✅ PPTC 自恢复保险丝（必加，防后端短路）
2. ✅ 共模扼流圈（射频板强烈推荐，抑制 USB 噪声耦合到移相器）
3. ✅ SMBJ6.5A 功率 TVS 保护 VBUS 电源轨
4. ✅ 肖特基 / P-MOS 防反接（防止插反烧板）
5. ⭕ 升级低 ESR 输入电容（改善浪涌 + 电源纹波）
6. ⭕ VBUS 电压 ADC 采样（软件预警，可选）
7. ❌ 压敏电阻：普通实验室环境不需要

## 六、注意事项

1. 器件顺序：母座 → PPTC → 防反接 → TVS → 滤波电容 → 后端电路；SRV05 和共模电感放在 D+/D - 信号路径。顺序不能乱，否则保护器件失效。
2. SRV05-4 保留不动，专门保护 D+/D - 信号线的高速 ESD；SMBJ6.5 负责电源轨大能量浪涌，两者分工。
3. 增加共模电感后，D+/D - 走线尽量短且等长，差分对紧密耦合。
4. 所有保护器件靠近 USB 母座摆放，保护器件要尽可能靠近接口入口，防止干扰耦合进 PCB 板内。

# 更新版文字版完整原理图（新增 USB 端口全套保护：PPTC、肖特基防反接、功率 TVS、USB 共模扼流圈，其余电路保持不变）

说明： 地网络：DGND 数字地，AGND 射频模拟地；AGND 与 DGND 单点通过 0Ω 电阻相连； 电源网络：USB_VBUS（USB 母座原始 5V）、VBUS_5V_IN（经过保护电路后的 5V 主电源）、AVCC5（XT3301Q6 +5V 模拟电源）、AVCCN5（XT3301Q6 -5V 模拟电源）、VCC3P3（3.3V 数字电源） 模块：USB 供电，CH340G+CS32F030C8T6+XT3301Q6；对外预留：UART2、SPI1、I2C1、SWD

## 一、USB 输入 & ESD、浪涌、过流、反接保护电路（已增强）

USB-A母座

Pin1 VBUS → PPTC(MF-R050,0.5A自恢复保险丝) → SS34肖特基二极管阳极

SS34阴极 → VBUS_5V_IN（保护后主5V电源）

Pin2 D- → 共模扼流圈ACM6060-100M D-绕组 → SRV05-4 Pin2 → CH340G D-

Pin3 D+ → 共模扼流圈ACM6060-100M D+绕组 → SRV05-4 Pin3 → CH340G D+

Pin4 GND → DGND

SRV05-4（信号ESD保护）

Pin1 → DGND

Pin2 → D-

Pin3 → D+

Pin4 → USB_VBUS（母座侧，PPTC前端）

SMBJ6.5A 单向功率TVS（VBUS电源浪涌保护）

阴极 → VBUS_5V_IN

阳极 → DGND

VBUS_5V_IN并联滤波电容组：

C1(10μF 聚合物低ESR电容) VBUS_5V_IN ↔ DGND

C2(1μF X7R MLCC) VBUS_5V_IN ↔ DGND

C3(0.1μF MLCC) VBUS_5V_IN ↔ DGND

VBUS_5V_IN向后分三路：

① AVCC5（直接给到XT3301Q6 +5V模拟电源）

② LM27762 VIN输入

③ LP2985-3.3 VIN输入

## 二、+5V 转 - 5V 反压电源 LM27762

LM27762

Pin1 VIN → VBUS_5V_IN

Pin2 GND → DGND

Pin3 SW → L1(4.7μH屏蔽功率电感)一端

L1另一端 → AVCCN5（-5V输出）

Pin4 FB → AVCCN5（反馈引脚）

Pin5 OUT → AVCCN5

输出滤波：

C4(10μF电解)：负极AVCCN5，正极DGND

C5(0.1μF MLCC)：AVCCN5 ↔ DGND

AVCC5、AVCCN5 送入 TPS3700 电压检测输入端

## 三、5V 转 3.3V LDO LP2985-3.3

LP2985-3.3

Pin1 VIN → VBUS_5V_IN

Pin2 GND → DGND

Pin3 EN → VBUS_5V_IN（持续使能）

Pin4 BYPASS → C6(0.01μF MLCC) → DGND

Pin5 VOUT → VCC3P3（3.3V数字电源）

输出滤波：

C7(1μF MLCC) VCC3P3 ↔ DGND

C8(0.1μF MLCC) VCC3P3 ↔ DGND

VCC3P3 供给：CS32F030、CH340G、所有预留接口上拉电阻、LED 指示灯

## 四、双路电源监控 TPS3700（时序保护，XT3301Q6 硬件使能）

TPS3700：双路电压窗口比较器，OUT 输出作为 XT3301Q6 EN 硬件使能

TPS3700

VDD → VCC3P3

GND → DGND

INA+ → R2(10kΩ) AVCC5 → INA+；R3(10kΩ) INA+ → DGND（+5V分压采样）

INA- → 内部参考

INB+ → R4(10kΩ) AVCCN5 → INB+；R5(10kΩ) INB+ → DGND（-5V分压采样）

INB- → 内部参考

OUT → R6(10kΩ)上拉到VCC3P3；同时接到XT3301Q6 EN；同时接到CS32F030 PB7（电源就绪输入GPIO）

## 五、CH340G USB 转 UART 电路（PC 上位机 USB 通信）

CH340G

VCC → VCC3P3

GND → DGND

XI → X1(12MHz贴片晶振)一端

XO → X1另一端；晶振两端C9/C10(22pF)→DGND

D+ → USB母座D+（经过共模电感、SRV05-4）

D- → USB母座D-（经过共模电感、SRV05-4）

TXD → CS32F030 PA10(USART1_RX)

RXD → CS32F030 PA9(USART1_TX)

RST# → C11(0.1μF)到DGND；R7(10kΩ)上拉VCC3P3

交叉连接：CH340G.TXD 接 MCU.RX；CH340G.RXD 接 MCU.TX

## 六、CS32F030C8T6 主控最小系统

CS32F030C8T6

VDD(所有电源引脚) → VCC3P3

VSS(所有地引脚) → DGND

外部8MHz无源晶振：

PD0(OSC_IN) → X2(8MHz晶振)

PD1(OSC_OUT) → X2；晶振两端C12/C13(22pF)→DGND

MCU复位电路：NRST引脚

NRST → R8(10kΩ)上拉VCC3P3；C14(0.1μF)接NRST→DGND

【XT3301Q6控制信号输出】

PB0 → R10(100Ω) → XT3301Q6 D0

PB1 → R11(100Ω) → XT3301Q6 D1

PB2 → R12(100Ω) → XT3301Q6 D2

PB3 → R13(100Ω) → XT3301Q6 D3

PB4 → R14(100Ω) → XT3301Q6 D4

PB5 → R15(100Ω) → XT3301Q6 D5

PB6 → R16(100Ω) → XT3301Q6 LE（锁存信号）

PB7(输入) → TPS3700.OUT 电源就绪标志

【主通信 USART1（对接CH340G）】

PA9 USART1_TX → CH340G RXD

PA10 USART1_RX → CH340G TXD

【对外预留接口（全部引出排针）】

// 预留UART USART2

PA2 USART2_TX → 排针 UART2_TX

PA3 USART2_RX → 排针 UART2_RX

排针公共GND → DGND

// 预留 SPI1

PA5 SPI1_SCK → 排针 SPI_SCK

PA7 SPI1_MOSI → 排针 SPI_MOSI

PA6 SPI1_MISO → 排针 SPI_MISO

PA4 SPI1_NSS → 排针 SPI_NSS

// 预留 I2C1

PB8 I2C1_SCL → R17(10k上拉VCC3P3) → 排针 I2C_SCL

PB9 I2C1_SDA → R18(10k上拉VCC3P3) → 排针 I2C_SDA

排针 I2C_VCC → VCC3P3；排针GND→DGND

// SWD调试口

PA13 SWDIO → 排针 SWDIO

PA14 SWCLK → 排针 SWCLK

排针 SWD_VCC → VCC3P3；排针GND→DGND

【LED指示灯】

PC13 → R19(220Ω) → 红色LED阳极；LED阴极DGND（POWER灯）

PC14 → R20(220Ω) → 绿色LED阳极；LED阴极DGND（WORK灯）

## 七、XT3301Q6 射频移相器核心电路

XT3301Q6

VDD → AVCC5 (+5V模拟电源)

VSS → AVCCN5 (-5V模拟电源)

GND → AGND（射频模拟地）

EN → TPS3700.OUT 硬件使能

D0~D5：6bit相位数据输入，来自CS32F030 PB0~PB5（串100Ω电阻）

LE：Latch锁存使能，来自CS32F030 PB6（串100Ω电阻）

射频端口：

RF_IN → C_RF1(100pF高频射频电容) → XT3301Q6 RFIN引脚

RF_OUT → C_RF2(100pF高频射频电容) → XT3301Q6 RFOUT引脚

RF_IN、RF_OUT 分别连接贴片SMA座

电源就近去耦（紧贴XT3301Q6芯片电源引脚）：

C15(1μF X7R) AVCC5 ↔ AGND

C16(0.1μF) AVCC5 ↔ AGND

C17(1μF X7R) AVCCN5 ↔ AGND

C18(0.1μF) AVCCN5 ↔ AGND

AGND (射频模拟地) 和 DGND (数字地)：单点 0Ω 电阻连接，放置在电源区域，禁止多点相连。

## 八、所有对外排针引脚汇总（2.54mm）

1. 预留 UART2 3P 排针：UART2_TX、UART2_RX、GND
2. 预留 SPI1 4P 排针：SPI_SCK、SPI_MOSI、SPI_MISO、SPI_NSS
3. 预留 I2C1 4P 排针：I2C_SCL、I2C_SDA、VCC3P3、GND
4. SWD 4P 排针：SWDIO、SWCLK、VCC3P3、GND

## 九、电路关键说明与 PCB 布局要点

1. 器件顺序（USB 保护）：USB 母座 → PPTC → 肖特基防反接 → TVS + 滤波电容 → 后端电路；共模电感、SRV05 放在 D+/D - 信号路径，器件尽量靠近 USB 接口。
2. 上电时序：USB_VBUS 上电 → PPTC、肖特基输出 VBUS_5V_IN → LDO 输出 VCC3P3；LM27762 建立 AVCCN5；TPS3700 检测 ±5V 全部正常，拉高 XT3301Q6 EN；MCU 读取 PB7 就绪标志后，才允许配置相位。
3. XT3301Q6 的 EN 硬件保护优先级最高，软件无法强制打开；任意一路电源异常直接关闭移相芯片。
4. CH340G 完成 USB 转虚拟串口；USART2、SPI1、I2C1、SWD 独立引出，引脚无复用冲突，可以同时工作。
5. 全部对外扩展接口为 3.3V TTL 电平，禁止接入 5V 信号，避免 MCU IO 损坏。
6. 射频区域单独铺 AGND，数字部分铺 DGND；单点共地，防止数字噪声串入射频回路，降低相位抖动。

接下来你想继续做哪一部分：

1. PCB 布局约束清单（分区、器件摆放、射频走线、差分 USB 线、地平面规则）
2. CS32F030C8T6 Keil C 代码完整框架（虚拟串口指令解析，XT3301Q6 锁存，预留 USART2/SPI/I2C 驱动）
3. BOM 更新完整版（把新增 PPTC、肖特基、共模电感、TVS 一并录入）？

文字版完整原理图中，USB输入&ESD保护电路部分还可以添加哪些保护措施？

文字版完整原理图中，电源网络部分还可以添加哪些保护措施？

文字版完整原理图中，模块部分还可以添加哪些保护措施？

给出 PCB 布局约束清单（射频 + 电源 + 数字接口）

# PCB 布局约束清单（XT3301Q6 移相器模块，射频 + 电源 + 数字混合板）

板类型：混合信号 PCB，分为射频区 AGND、数字区 DGND；单点共地；USB 高速信号、模拟正负电源、数字控制 IO。 目标：压低数字噪声耦合进射频通路，保证相位精度，电源稳定，ESD / 浪涌保护有效。 分层建议（优先推荐 2 层板，实验室原型）：

- Top 层：信号走线、器件焊盘；射频线、USB 差分线、XT3301 控制信号
- Bottom 层：完整地平面，分割为 AGND (射频地)、DGND (数字地)；仅一处 0Ω 电阻桥接 如果是 4 层板（更高性能）：Top 信号，AGND 层，DGND 层，Bottom 电源；射频与数字地分平面，单点连接。

## 一、分区硬性规则（最高优先级）

1. 物理分区隔离，严禁交叉穿插
  - 射频区：XT3301Q6 芯片、SMA 射频座、RF 输入输出隔直电容、XT3301 就近电源去耦电容；整片铺 AGND。
  - 电源区：USB 保护器件、LM27762、LP2985-3.3、TPS3700、主电源滤波电容；跨 AGND/DGND 交界，单点共地点落在电源区。
  - 数字区：CS32F030C8T6、CH340G、晶振、LED、所有对外排针（USART2/SPI/I2C/SWD）；整片铺 DGND。
2. 分区顺序（从板边缘向内）：USB 接口 → 电源保护电路 → 电源芯片 → MCU/CH340 数字区；射频 SMA 座放在板另一侧，远离 USB、CH340、晶振。

禁止：晶振、CH340、USB 差分线走线跨过 AGND 射频区域；禁止射频走线穿过 DGND 区域。

3. 单点共地规则：
  - AGND 与 DGND只允许 1 个连接点，使用 0Ω 电阻，放置在电源区域（LM27762/LDO 附近）；射频区域不允许任何 AGND-DGND 连接。
  - 不要用磁珠代替 0Ω 单点接地：磁珠会引入直流压降，干扰 XT3301 正负电源。
  - 地平面分割槽：分割线要足够宽（≥0.8mm），隔离 AGND/DGND。

## 二、射频区域约束（XT3301Q6，核心）

1. XT3301Q6 器件摆放
  - XT3301 尽量靠近 SMA 射频座，缩短 RFIN/RFOUT 射频信号线；射频传输线长度尽量对称（输入输出走线长度差越小越好）。
  - XT3301 电源去耦电容（C15/C16/C17/C18，1μF+0.1μF）紧贴芯片 VDD/VSS 引脚，电容焊盘直接打通孔到 AGND，走线越短，几乎无引线。
  - 6bit 数据 D0~D5、LE 控制线：从 MCU 过来，进入射频区域前终止；走线尽量短，串接的 100Ω 电阻放在靠近 XT3301 引脚一侧，电阻分隔数字噪声与射频芯片。
  - XT3301 EN 引脚（TPS3700）：同样，100Ω 电阻靠近 XT3301。
2. RF 射频走线（微带线，底层 AGND 参考地）
  - 射频线做50Ω 微带阻抗控制，提前计算线宽（FR4，介电常数 4.2，板厚 1.6mm，50Ω 线宽≈2.4mm）。
  - 射频走线：直线优先，拐角使用45° 斜角，禁止 90° 直角拐角；禁止 T 型分支。
  - RF 隔直电容 C_RF1/C_RF2（100pF 射频电容）紧贴 XT3301 RFIN/RFOUT 引脚和 SMA 座，缩短射频路径。
  - SMA 射频座：SMA 外壳焊盘直接连 AGND，多打过孔到 AGND 地平面；SMA 放置在板边缘。
3. 射频区域禁止项
  - 任何数字信号线（晶振、USB、SPI、UART）不得在 AGND 层附近布线，更不能平行长距离靠近射频走线。
  - 射频区域下方底层只能是 AGND，不能有 DGND 分割。
  - XT3301 芯片下方 PCB 不要打过多地孔，仅电源去耦电容地孔。

## 三、USB 输入 & 保护电路布局约束（ESD、浪涌、噪声）

器件顺序：USB-A 母座 → PPTC → SS34 肖特基 → SMBJ6.5A 功率 TVS → 主滤波电容；D+/D-：USB 座 → 共模扼流圈 → SRV05-4 → CH340G

1. 所有保护器件必须紧贴 USB 母座（接口第一排器件），保护器件与 USB 座之间走线尽可能短。
  - PPTC、肖特基、SMBJ6.5A、共模电感、SRV05 全部集中在 USB 接口侧。
2. USB 差分 D+/D-：
  - 差分对必须等长、紧密耦合、平行走线，两条线长度误差控制＜0.2mm；线宽一致，间距固定。
  - 差分走线下方参考地保持完整，不要跨地分割槽（D+/D - 全程走 DGND 区域）。
  - 差分线远离晶振、电源开关节点（LM27762 SW 引脚是强噪声源！），不要平行长距离靠近任何高速数字线。
3. 电源滤波电容（VBUS_5V_IN 的 10μF 聚合物、1μF、0.1μF）紧跟 SMBJ6.5A 之后，电容地引脚就近打地孔到 DGND。
4. USB 禁止项：
  - USB 差分线不要走射频 AGND 区域上方。
  - CH340G 放置在共模电感、SRV05 后方，远离 USB 接口；CH340 晶振（12MHz）远离射频区，晶振外壳接地。

## 四、电源电路布局约束（LM27762 负压，LP2985 LDO，TPS3700）

### 4.1 LM27762（5V 转 - 5V，开关电容，噪声大户！重点）

LM27762 SW 引脚是高频噪声节点，必须严格隔离

1. L1 功率电感（4.7μH 屏蔽电感）紧贴 LM27762 SW 引脚；SW 节点走线越短越粗，面积最小，减少辐射。
2. LM27762 输入电容（VBUS 侧）靠近 VIN；输出滤波电容（C4/C5）紧贴 OUT 引脚，电容地孔就近打 DGND。
3. LM27762远离 XT3301 射频区，SW 节点不要朝向射频方向；SW 走线不要平行任何射频、敏感信号线。
4. 反馈 FB 引脚走线短，远离 SW 噪声线。

### 4.2 LP2985-3.3 LDO（5V 转 3.3V，线性电源，低噪声）

1. LDO 输入电容靠近 VIN；输出 1μF+0.1μF 电容紧贴 VOUT 引脚，电容地就近打 DGND。
2. VCC3P3（3.3V）电源走线：从 LDO 输出星型布线，分别供给 CH340、CS32F030、排针；不要从 MCU 再分支给其他器件。

### 4.3 TPS3700 电源监控

1. TPS3700 放在 AVCC5/AVCCN5 采样点附近；分压采样电阻靠近 TPS3700 输入引脚，采样线尽量短。
2. TPS3700 输出（EN 信号到 XT3301）走线：从 TPS3700 到 XT3301，中间串电阻；走线尽量短，避开 LM27762 SW 噪声。
3. TPS3700 VDD 3.3V 去耦电容紧贴芯片电源引脚。

## 五、数字区域布局约束（CS32F030C8T6，CH340，晶振，排针）

1. CS32F030 最小系统
  - 8MHz 外部晶振紧贴 MCU PD0/PD1 引脚；晶振的负载电容紧贴晶振引脚，晶振下方铺 DGND，晶振区域远离射频。
  - MCU NRST 复位电容电阻紧贴 NRST 引脚。
  - MCU 电源引脚 VDD 每个电源引脚就近放置 0.1μF MLCC 去耦，焊盘直接打 DGND 孔。
2. XT3301 控制信号线 PB0~PB5、PB6 (LE)
  - 从 MCU 引出，走线到 100Ω 串联电阻；电阻靠近 XT3301 一侧。
  - 控制信号线尽量短；不要和 USB 差分线、晶振线长距离平行。
3. 对外排针：USART2/SPI/I2C/SWD 全部放在板的数字区边缘，远离射频 SMA、USB。
  - 排针信号走线全部在 DGND 区域；I2C 上拉电阻紧靠 I2C 排针或者 MCU PB8/PB9。
4. CH340G：12MHz 晶振紧贴 CH340 XI/XO；晶振外壳接地；CH340 电源引脚放置 0.1μF 去耦电容。

## 六、过孔、地孔通用规则

1. 所有电源去耦电容，电容地引脚就近打地孔，孔直接打到地平面，走线最短。
2. 射频信号线换层过孔越少越好；尽量射频线单层走完，避免过孔破坏 50Ω 阻抗。
3. 地孔：AGND 区域的地孔只连接 AGND；DGND 地孔只连接 DGND，严禁跨分割地孔。
4. 孔径：信号孔 0.3mm，电源 / 地孔 0.4~0.5mm。

## 七、线宽 / 载流参考（FR4，1.6mm）

- VBUS_5V 主功率：≥0.8mm
- AVCC5、AVCCN5（XT330 模拟电源）：≥0.6mm
- VCC3P3 数字电源：≥0.4mm
- 普通数字信号：0.2~0.25mm
- USB 差分对：0.2mm，差分间距 0.25mm
- 射频 50Ω 微带：≈2.4mm（1.6mm 板厚 FR4）

## 八、检查清单（PCB 完成后逐项核对）

- AGND/DGND 分割，仅单点 0Ω 电阻共地
- USB 保护器件紧靠 USB 母座；D+/D - 差分等长
- LM27762 SW 节点面积最小，远离射频
- XT3301 电源去耦电容紧贴芯片
- RF 走线 50Ω 阻抗，45° 拐角，无 90° 直角
- 晶振（MCU 8MHz、CH340 12MHz）远离射频区域
- 所有电源芯片 VIN/VOUT 都就近放置去耦电容
- 数字控制线进入射频区前串 100Ω 电阻，电阻靠近 XT3301
- 射频 SMA 座外壳多点接地至 AGND
- 没有任何信号线跨地分割槽

## 九、EMC 与射频性能额外提示

1. XT330Q6 正负模拟电源 AVCC5/AVCCN5 走线尽量短，不要和数字电源线平行。
2. 开关电容 LM27762 是本板最大噪声源，必须物理远离射频通路。
3. 原型板预留测试点：AVCC5、AVCCN5、VCC3P3、TPS3700 PWR_RDY，方便上电时序测试。

如果你需要，下一步我可以输出完整 BOM 清单（含封装、推荐料号、器件参数）。

# XT3301Q6 移相器模块完整 BOM 清单

配套原理图 + PCB 布局，混合信号射频板；2 层板，FR4，板厚 1.6mm；实验室原型版本。 分类：USB 保护、电源 IC、射频器件、MCU & 数字外设、阻容、连接器。 备注：封装采用 0603 为主（方便焊接）；射频电容用射频专用高 Q 电容；电源类器件选型优先低噪声。

## 一、USB 端口保护器件

表格

序号 | 名称 | 规格参数 | 封装 | 数量 | 备注
U1 | PPTC 自恢复保险丝 | 0.5A,6V，MF-R050 | 0603 | 1 | VBUS 过流保护，USB 母座后第一颗功率器件
D1 | 肖特基二极管 | SS34，40V/3A，Vf≈0.25V | SMA | 1 | 电源反接保护；若追求 5V 无压降，替换为 P-MOS 理想二极管电路
D2 | 单向功率 TVS | SMBJ6.5A，单向，钳位 6.5V | SMB | 1 | VBUS 电源浪涌防护
L 共模 | USB 共模扼流圈 | ACM6060-100M，100Ω@100MHz | 0603 | 1 | D+/D - 差分共模噪声抑制
D3 | 信号 ESD 阵列 | SRV05-4，4 通道 ESD 保护 | SOT-23-6 | 1 | D+/D-/VBUS 信号 ESD

## 二、电源芯片

表格

序号 | 名称 | 规格参数 | 封装 | 数量 | 备注
U2 | 负压开关电容 | LM27762，5V 转 - 5V | SOT-23-6 | 1 | 给 XT3301 提供 VSS 负电源，噪声源，PCB 需远离射频
L1 | 屏蔽功率电感 | 4.7μH，屏蔽式，1A 以上 | 0603 | 1 | LM27762 SW 电感，必须屏蔽型，降低辐射
U3 | LDO 线性稳压器 | LP2985-3.3V，低噪声，150mA | SOT-23-5 | 1 | 3.3V，给 MCU、CH340、TPS3700 供电
U4 | 电源电压监控 | TPS3700，双路窗口比较器 | SOT-23-6 | 1 | 监测 AVCC5、AVCCN5，输出电源就绪信号给 XT3301 EN 与 MCU PB7

## 三、射频器件（XT3301Q6 核心射频部分）

表格

序号 | 名称 | 规格参数 | 封装 | 数量 | 备注
U5 | 6 位数字移相器 | XT3301Q6 | QFN | 1 | 射频核心，6bit 0~63 相位控制
C_RF1,C_RF2 | 射频隔直电容 | 100pF，高 Q 射频电容，0402 | 0402 | 2 | RFIN、RFOUT 隔直；不可用普通 MLCC 替代
R_series (6 颗) | 数字串联电阻 | 100Ω，0603 | 0603 | 6 | D0~D5、LE 控制线，靠近 XT3301 引脚端放置

## 四、MCU、USB 转串口、数字外设

表格

序号 | 名称 | 规格参数 | 封装 | 数量 | 备注
U6 | MCU | CS32F030C8T6，48MHz | LQFP48 | 1 | 主控，兼容 STM32F030C8T6 标准库
U7 | USB 转串口 | CH340G | SOP-16 | 1 | USB 全速转 USART1，上位机通信
Y1 | MCU 外部晶振 | 8MHz，无源晶振 | HC-49SMD | 1 | CS32F030 外部高速晶振
Y2 | CH340 晶振 | 12MHz，无源晶振 | HC-49SMD | 1 | CH340G 时钟；PCB 远离射频区
LED1 | 电源指示灯 | 红色 LED | 0603 | 1 | PC13 POWER 灯
LED2 | 工作指示灯 | 绿色 LED | 0603 | 1 | PC14 WORK 灯

## 五、电阻（全部 0603，精度 5%，除非注明）

表格

序号 | 名称 | 规格 | 封装 | 数量 | 用途
R1-R4 | 分压采样电阻 | 10kΩ | 0603 | 4 | TPS3700 AVCC5、AVCCN5 分压采样
Rpull_I2C | I2C 上拉电阻 | 10kΩ | 0603 | 2 | PB8/PB9 I2C_SCL、I2C_SDA 上拉
R_LED1,R_LED2 | LED 限流电阻 | 220Ω | 0603 | 2 | LED 指示灯限流
R_AGND_DGND | 单点接地电阻 | 0Ω | 0603 | 1 | AGND 与 DGND 单点桥接，电源区域

## 六、电容（区分聚合物、MLCC、射频电容）

表格

序号 | 名称 | 规格 | 封装 | 数量 | 用途
C_VBUS1 | 聚合物低 ESR 电容 | 10μF/10V | 0805 | 1 | VBUS 输入大容量滤波，PPTC 后
C_VBUS2 | MLCC | 1μF/10V X7R | 0603 | 1 | VBUS 输入
C_VBUS3 | MLCC | 0.1μF/50V X7R | 0603 | 1 | VBUS 输入高频去耦
C_LM27762_OUT1 | 电解 / 聚合物 | 10μF/10V | 0805 | 1 | 负压输出滤波 AVCCN5
C_LM27762_OUT2 | MLCC | 0.1μF/50V X7R | 0603 | 1 | 负压高频去耦
C_LDO_IN | 0.1μF MLCC | 0.1μF/50V X7R | 0603 | 1 | LP2985 输入
C_LDO_OUT | 1μF X7R MLCC | 1μF/10V | 0603 | 1 | 3.3V 输出主滤波
C_LDO_OUT2 | 0.1μF MLCC | 0.1μF/50V X7R | 0603 | 1 | 3.3V 高频去耦
C_XT3301_AVCC5_1 | 1μF X7R | 1μF/10V | 0603 | 1 | XT3301 VDD
C_XT3301_AVCC5_2 | 0.1μF X7R | 0.1μF/50V | 0603 | 1 | XT3301 VDD
C_XT3301_AVCCN5_1 | 1μF X7R | 1μF/10V | 0603 | 1 | XT3301 VSS
C_XT3301_AVCCN5_2 | 0.1μF X7R | 0.1μF/50V | 0603 | 1 | XT3301 VSS
C_TPS3700 | 0.1μF MLCC | 0.1μF/50V | 0603 | 1 | TPS3700 VDD 去耦
C_CH340 | 0.1μF MLCC | 0.1μF/50V | 0603 | 1 | CH340 VCC 去耦
C_MCU_VDD (4 颗) | 0.1μF MLCC | 0.1μF/50V | 0603 | 4 | CS32F030 每个 VDD 引脚就近去耦
C_Y1_load | 晶振负载电容 | 22pF | 0402 | 2 | MCU 8MHz 晶振负载
C_Y2_load | 晶振负载电容 | 22pF | 0402 | 2 | CH340 12MHz 晶振负载
C_RST | 复位电容 | 0.1μF | 0603 | 1 | MCU NRST

## 七、连接器

表格

序号 | 名称 | 规格 | 封装 | 数量 | 备注
J1 | USB-A 母座 | 弯插 / 贴片 USB-A | 贴片 | 1 | 电源 + USB 通信输入
J2,J3 | SMA 射频座 | SMA-K，贴片，50Ω | 贴片 | 2 | RFIN、RFOUT
J4 | 2.54mm 排针 | 4Pin | 直插 | 1 | SWD 调试口
J5 | 2.54mm 排针 | 3Pin | 直插 | 1 | USART2 预留
J6 | 2.54mm 排针 | 4Pin | 直插 | 1 | SPI1 预留
J7 | 2.54mm 排针 | 4Pin | 直插 | 1 | I2C1 预留

## BOM 总数量统计

- IC：7 颗
- 二极管 / TVS/ESD：4 颗
- 电感：2 颗
- 晶振：2 颗
- LED：2 颗
- 电阻：16 颗
- 电容：24 颗
- 连接器：7 个

# BOM 使用要点

1. 射频电容严禁替换成普通廉价 MLCC，普通电容高频寄生电感大，会恶化射频性能；
2. LM27762 的 L1 必须选用屏蔽功率电感，非屏蔽电感辐射会严重干扰射频通路；
3. 所有 0.1μF 去耦电容一律 X7R 材质，不要用 Y5V（温度稳定性差）；
4. 所有电源 IC、MCU 的去耦电容必须紧贴芯片电源引脚（PCB 布局约束里的硬性要求）；
5. 0Ω 电阻 R_AGND_DGND 只用来单点桥接 AGND 与 DGND，调试阶段可以预留焊盘，方便断开测试地噪声。

## 可选扩展器件（非必需，按需增加）

1. ADC 分压电阻（10k+10k）：用于 VBUS 电压采样，在 CS32F030 ADC 引脚监测 USB 输入电压；
2. 测试点：0603 焊盘，AVCC5、AVCCN5、VCC3P3、PWR_RDY，上电时序测试；
3. 磁珠（0603）：可选串入 3.3V 电源，用于额外噪声抑制（调试阶段按需焊接）。

下一步可选：

1. 整理一份上电调试、测试流程（从裸板上电→电源测试→数字控制→射频相位测试）
2. 或者整理一份调试故障排查清单（电源不起振、USB 无法通信、移相器无相位变化、射频噪声大）？

上电调试、测试流程（从裸板上电→电源测试→数字控制→射频相位测试）

工程化、可直接照着操作的完整上电调试流程，从零裸板上电 → 电源排查 → 数字功能调试 → 串口协议调试 → 射频移相功能验证，完全适配你这套 XT3301Q6+CS32F030+CH340 + 正负电源模块，无跳跃、无遗漏、适合量产 / 实验室验收。

我将流程分为 5 级调试：

1. 裸板静态检查（不上电）
2. 一级上电：电源系统全电压测试（最关键、90% 故障在这里）
3. 二级上电：数字系统调试（MCU、USB、晶振、外设）
4. 三级功能调试：串口协议、XT3301 控制、电源保护逻辑
5. 四级射频验收：相位精度、重复性、射频指标验证

下面是最终正式版调试手册。

## 0. 调试前置说明

本手册适配：USB适配器5V供电、CH340 USB虚拟串口、CS32F030C8T6主控、LM27762 ±5V电源、TPS3700电源时序保护、XT3301Q6 6bit移相器、预留UART2/SPI/I2C/SWD接口。

调试顺序严格先电源、后数字、再射频，严禁直接调试射频，避免烧毁XT3301Q6（GaAs芯片最怕单电源上电）。

## 第一阶段：裸板静态检查（不上电，必做）

目的：杜绝短路、错焊、虚焊，防止上电直接烧芯片

### 1.1 外观检查

- 检查USB、SMA、排针、IC、阻容有无错贴、漏贴、偏移、连锡
- 检查LM27762、XT3301、LDO、TPS3700引脚无短路
- 检查AGND/DGND分割完整，0Ω单点接地电阻焊接正常

### 1.2 万用表短路测试（蜂鸣档）

- 测量 USB_VBUS ↔ DGND：不应短路
- 测量 VCC3P3 ↔ DGND：不应短路
- 测量 AVCC5 ↔ AGND、AVCCN5 ↔ AGND：不应短路
- 测量 XT3301 VDD/VSS 无短路

## 第二阶段：一级上电调试——电源系统测试（核心重中之重）

接入正规手机5V/2A适配器，USB上电，不接任何射频信号、不接外设。

### 2.1 测试点1：保护后主电源 VBUS_5V_IN

标准值：4.8V～5.1V（肖特基压降正常）

异常排查：无电压→PPTC/肖特基焊反或损坏；电压跌落→板上短路

### 2.2 测试点2：数字3.3V电源 VCC3P3

标准值：3.25V～3.35V

正常现象：红色POWER LED常亮

### 2.3 测试点3：XT3301正电源 AVCC5

标准值：4.9V～5.1V

### 2.4 测试点4：XT3301负电源 AVCCN5

标准值：-4.8V～-5.2V

关键：负压不正常，后续绝对不能调试射频功能，会直接烧移相器

### 2.5 测试点5：TPS3700 电源就绪 PWR_RDY

标准：±5V全部正常后输出 3.3V高电平

意义：此脚高电平 = XT3301硬件解锁允许工作

此脚低电平：说明负压/正压任意一路异常，硬件锁死移相器

### 2.6 电源阶段验收标准

全部电压正常、无发热、无啸叫、LED电源灯常亮 → 电源调试通过

## 第三阶段：二级上电调试——数字系统调试

### 3.1 MCU最小系统测试

- 8MHz晶振起振正常
- MCU复位电路正常
- SWD接口可正常识别、下载程序

### 3.2 CH340 USB串口调试

- 电脑插入USB，设备管理器识别 CH340 串口
- 串口上电自动打印：XT3301 Module Ready

若无法识别：检查USB差分线、共模电感、SRV05、CH340晶振

### 3.3 预留外设初始化验证（无需外接设备）

代码上电自动初始化：USART2、SPI1、I2C1，无报错、无死机即为正常。

说明：预留接口完全独立不影响移相器工作

## 第四阶段：三级功能调试——串口指令与移相器控制逻辑

串口助手参数：115200、8N1

下发4条核心指令逐条测试

### 4.1 读取电源状态指令

发送：AA 03 00 55

返回 PWR_RDY:1 代表电源正常、移相器解锁

### 4.2 相位设置指令测试

发送：AA 01 0A 55（设置相位10）

返回：SetPhase OK，WORK LED闪烁

### 4.3 读取当前相位

发送：AA 02 00 55

返回当前相位数值，与设置一致

### 4.4 复位移相器

发送：AA 04 00 55

相位清零为0

### 4.5 软件保护验证（重要）

人为断开负压，PWR_RDY变为0，下发相位指令不执行，实现软硬件双重保护。

## 第五阶段：四级射频性能测试（整机验收）

设备需求：信号源、频谱仪/矢量网络分析仪、L波段射频线缆

测试频段：0.9～1.3GHz

### 5.1 基础射频通路检查

- 射频直通损耗正常
- 无自激、无杂散、无明显噪声底抬升

### 5.2 步进移相测试（6bit全量程）

0~63 全码点逐点测试，每步相位变化 5.625°

验证：相位线性度、步进均匀性、无跳变、无滞后

### 5.3 相位重复性测试

重复设置同一相位100次，相位偏移极小、稳定无漂移

### 5.4 电源干扰测试

USB插拔、串口通信过程中相位无抖动、无跳变，说明PCB噪声隔离合格

## 第六阶段：预留接口功能测试（可选）

可单独验证，不影响射频功能：

- USART2 对外串口收发正常
- SPI1 读写正常（可接Flash测试）
- I2C1 读写正常（可接EEPROM测试）
- SWD可随时烧录、在线调试

## 第七阶段：常见故障快速排查表

### 1. 无负压 -> LM27762虚焊、电感焊反、输出电容损坏

### 2. PWR_RDY 一直低 -> 正负电源任意一路异常

### 3. USB不识别 -> 共模电感、D+/D-断线、CH340晶振不起振

### 4. 串口收到乱码 -> 晶振误差、波特率不匹配、电源纹波大

### 5. 相位不变化 -> LE锁存引脚异常、电源未就绪、控制线虚焊

### 6. 射频抖动大 -> LM27762噪声干扰、地分割不良、射频走线不规范

## 第八阶段：整机验收通过标准

- 全部电源电压精准、稳定、无纹波异常
- USB通信稳定、指令收发正常
- 0~360°移相精准、步进均匀
- 软硬件电源保护功能有效
- 所有对外预留UART2/SPI/I2C/SWD接口可用
- 上电无发热、无噪声、无漂移

提供的完整调试流程规整、结构化、标准化，**重点强化四大核心故障专项排查**（电源不起振、USB 无法通信、移相器无相位变化、射频噪声大），做成可直接打印、量产调试使用的**官方故障排查手册**，逻辑清晰、逐条可落地。

XT3301Q6移相器模块 完整调试流程 + 专项故障排查手册

## 0. 调试前置说明

本手册适配：USB适配器5V供电、CH340 USB虚拟串口、CS32F030C8T6主控、LM27762 ±5V电源、TPS3700电源时序保护、XT3301Q6 6bit移相器、预留UART2/SPI/I2C/SWD接口。

核心调试原则：严格遵循「先电源、后数字、再射频」顺序，严禁直接调试射频电路；XT3301Q6为GaAs射频芯片，单电源上电、电源异常极易烧毁芯片。

## 第一阶段：裸板静态检查（不上电·必做）

### 1.1 外观检查

检查USB座、SMA射频座、排针、IC、阻容、电感、晶振，无错贴、漏贴、偏移、连锡、虚焊；重点检查LM27762、XT3301Q6、LDO、TPS3700引脚无短路搭桥；确认AGND/DGND分割完整，单点0Ω接地电阻焊接正常。

### 1.2 万用表蜂鸣档短路检测

禁止出现以下短路：USB_VBUS↔DGND、VCC3P3↔DGND、AVCC5↔AGND、AVCCN5↔AGND、XT3301 VDD/VSS引脚短路。

## 第二阶段：一级上电调试——电源系统测试（核心）

测试条件：正规5V/2A USB适配器供电，不接射频信号、不接外设负载。

### 2.1 VBUS_5V_IN（保护后主电源）

标准电压：4.8V～5.1V（肖特基二极管正常压降）

### 2.2 VCC3P3（数字3.3V电源）

标准电压：3.25V～3.35V；正常状态：红色POWER LED常亮

### 2.3 AVCC5（射频正电源）

标准电压：4.9V～5.1V

### 2.4 AVCCN5（射频负电源）

标准电压：-4.8V～-5.2V；负压异常禁止调试射频，防止烧片

### 2.5 TPS3700 PWR_RDY（电源就绪信号）

正常状态：±5V电源全部正常后输出3.3V高电平（XT3301硬件解锁）；低电平代表电源异常，硬件锁死移相器。

### 2.6 电源验收标准

各路电压稳定无波动、芯片无发热、无啸叫、电源LED常亮，电源系统调试通过。

## 第三阶段：二级上电调试——数字系统调试

### 3.1 MCU最小系统

8MHz外部晶振正常起振、复位电路正常、SWD接口可正常识别与烧录程序。

### 3.2 CH340 USB串口

电脑设备管理器正常识别CH340串口，上电自动打印：XT3301 Module Ready。

### 3.3 预留外设初始化

USART2、SPI1、I2C1上电自动初始化，无死机、无异常，外设独立工作不影响移相器功能。

## 第四阶段：三级功能调试——串口指令与移相器控制

串口参数：115200、8N1

- 读取电源状态：AA 03 00 55 → 返回PWR_RDY:1（正常）
- 设置相位：AA 01 0A 55 → 返回SetPhase OK，工作LED闪烁
- 读取相位：AA 02 00 55 → 返回当前相位值，与设置一致
- 复位移相器：AA 04 00 55 → 相位清零
- 软硬件保护验证：负压异常时PWR_RDY=0，相位指令不执行

## 第五阶段：四级射频性能验收测试

测试设备：信号源、矢量网络分析仪/频谱仪；测试频段：0.9～1.3GHz

- 射频通路：直通损耗正常，无杂散、无自激、无底噪抬升
- 6bit移相：0~63全码点步进正常，单步5.625°，无跳变、无滞后
- 重复性：重复设置相位无漂移、无偏移
- 抗干扰：USB插拔、串口通信时相位无抖动

## 第六阶段：预留接口功能测试（可选）

USART2收发正常、SPI1读写正常、I2C1读写正常、SWD调试烧录正常，所有接口独立互不干扰。

# 核心四大专项故障深度排查清单（重点）

## 故障一：电源不起振 / 无负压 / 电压异常

### 故障现象

VCC3P3无电压、LM27762无-5V输出、PWR_RDY持续低电平、芯片发热、上电啸叫。

### 排查步骤（由浅入深）

1. 检查USB输入：适配器是否正常、USB座是否虚焊、引脚是否错位
2. 检查保护链路：PPTC保险丝是否熔断、SS34肖特基是否焊反/损坏、SMBJ6.5A TVS是否击穿
3. 排查3.3V电源：LP2985是否虚焊、输入输出电容是否漏焊/损坏
4. 排查负压电源（高频故障点）：LM27762虚焊、4.7μH功率电感焊反/非屏蔽型号、输入输出滤波电容失效
5. 检查TPS3700：分压电阻虚焊、芯片损坏，导致电源检测失效、PWR_RDY锁低
6. 排查板上短路：AVCC5/AVCCN5、3.3V对地微短路

### 根治要点

LM27762必须使用屏蔽电感，SW节点走线最短最小，负压电容必须高低ESR搭配。

## 故障二：USB无法通信 / 电脑不识别设备

### 故障现象

插入USB无反应、设备管理器无CH340设备、串口不打印信息。

### 排查步骤

1. 检查USB保护链路：共模电感是否开路、SRV05-4 ESD是否击穿
2. 检查差分走线：D+/D-是否虚焊、断线、短路、走线交叉
3. 检查CH340基础电路：3.3V供电是否正常、复位电容电阻是否正常
4. 检查12MHz晶振：CH340晶振不起振是最高发故障，晶振损坏、负载电容漏焊
5. 排查驱动：电脑CH340驱动异常、串口被占用

### 根治要点

USB差分线必须等长、不跨地分割、远离电源噪声区；保护器件必须紧靠USB接口。

## 故障三：上位机指令正常，移相器无相位变化

### 故障现象

串口收发正常、返回SetPhase OK，但矢量仪相位无变化，移相器不工作。

### 排查步骤

1. 优先确认PWR_RDY电平：必须为3.3V高电平，电源未就绪硬件锁死移相器
2. 检查XT3301供电：AVCC5、AVCCN5是否精准，负压缺失绝对无动作
3. 检查6bit数据总线：PB0~PB5串联100Ω电阻是否虚焊、开路
4. 检查LE锁存信号：PB6锁存引脚无脉冲、虚焊、电阻损坏（最高发故障）
5. 检查MCU程序：相位掩码0x3F是否正常、锁存时序延时是否过短
6. 排查XT3301芯片：焊接虚焊、过热损坏、单电源上电烧毁

### 根治要点

LE锁存时序必须可靠，电阻靠近移相器引脚；严格杜绝单电源上电操作。

## 故障四：射频噪声大、相位抖动、底噪抬升、稳定性差

### 故障现象

射频底噪高、相位随机抖动、数值漂移、通信时射频指标恶化。

### 排查步骤

1. 排查最大噪声源：LM27762负压开关电源，SW节点走线过长、未用屏蔽电感、靠近射频区
2. 排查地平面问题：AGND/DGND多点接地、分割槽过窄、0Ω单点接地未焊
3. 排查射频走线：50Ω阻抗不达标、90°直角拐角、走线过长、未做等长
4. 排查器件选型：射频电容使用普通MLCC、非高Q电容，寄生参数大
5. 排查数字干扰：CH340晶振、MCU晶振靠近射频区，数字线平行射频走线
6. 排查电源纹波：3.3V/±5V去耦电容缺失、摆放远离芯片引脚

### 根治要点

射频区纯AGND隔离、开关电源远离射频、所有去耦电容紧贴IC、数字噪声与射频物理分区隔离。

## 整机最终验收标准

- 各路电源电压精准、纹波小、无发热、无啸叫
- USB串口通信稳定，指令无丢包、无乱码
- 6bit移相0~63全量程精准，步进均匀无跳变
- 软硬件电源保护机制有效，异常自动锁存保护
- UART2/SPI/I2C/SWD所有预留接口功能正常
- 射频底噪低、相位稳定、无漂移、抗干扰能力强

整机验收测试报告模板

XT3301Q6移相器模块 整机验收测试报告及故障排查手册

## 0. 文档说明

适用产品：USB供电、CH340虚拟串口、CS32F030C8T6主控、LM27762 ±5V负压电源、TPS3700电源时序保护、XT3301Q6 6bit数控移相器、预留UART2/SPI/I2C/SWD扩展接口模块

调试核心原则：严格遵循「先电源、后数字、再射频」调试顺序；XT3301Q6为GaAs射频芯片，禁止单电源上电、禁止电源异常工况上电，否则极易造成芯片永久性烧毁。

测试设备：5V/2A标准USB适配器、数字万用表、串口调试助手、矢量网络分析仪/频谱仪、射频测试线缆

测试频段：0.9～1.3GHz

## 1. 前置静态检查（不上电 必检项）

### 1.1 外观焊接检查

检查USB座、SMA射频座、排针、主控IC、射频芯片、电源芯片、阻容、电感、晶振，无错贴、漏贴、偏移、连锡、虚焊；重点核查LM27762、XT3301Q6、LP2985、TPS3700引脚无短路搭桥；确认PCB AGND/DGND分割完整、单点0Ω接地电阻焊接正常。

### 1.2 短路导通检测（万用表蜂鸣档）

禁止出现以下对地短路：USB_VBUS↔DGND、VCC3P3↔DGND、AVCC5↔AGND、AVCCN5↔AGND、XT3301 VDD/VSS引脚短路。

## 2. 电源系统上电测试（一级调试·核心项）

测试条件：标准5V/2A USB适配器供电，不接入射频信号、不外接外设负载

测试点位 | 标准电压范围 | 测试结果 | 判定
VBUS_5V_IN（保护后主电源） | 4.8V～5.1V（肖特基正常压降） | | 合格/不合格
VCC3P3（数字3.3V电源） | 3.25V～3.35V，POWER红灯常亮 | | 合格/不合格
AVCC5（射频正电源） | 4.9V～5.1V | | 合格/不合格
AVCCN5（射频负电源） | -4.8V～-5.2V | | 合格/不合格
TPS3700 PWR_RDY（电源就绪） | 电源正常输出3.3V高电平 | | 合格/不合格

电源验收标准：各路电压稳定无波动、芯片无发热、无啸叫、电源指示灯正常常亮，无异常工况。负压异常严禁开展射频调试。

## 3. 数字系统功能测试（二级调试）

测试项目 | 合格标准 | 测试结果 | 判定
MCU最小系统 | 8MHz晶振正常起振、复位电路正常、SWD可正常识别烧录 | | 合格/不合格
CH340 USB串口 | 电脑识别CH340设备，上电打印「XT3301 Module Ready」 | | 合格/不合格
外设初始化 | USART2/SPI1/I2C1上电正常初始化，无死机异常 | | 合格/不合格

## 4. 串口指令与移相控制测试（三级调试）

串口参数：115200bps、8N1、无校验、无流控

测试指令功能 | 发送帧 | 预期返回 | 结果 | 判定
读取电源状态 | AA 03 00 55 | PWR_RDY:1 | | 合格/不合格
设置相位(10) | AA 01 0A 55 | SetPhase OK、工作LED闪烁 | | 合格/不合格
读取当前相位 | AA 02 00 55 | 返回相位值与设置一致 | | 合格/不合格
复位移相器 | AA 04 00 55 | Reset OK、相位清零 | | 合格/不合格
软硬件保护验证 | 断开负压测试 | PWR_RDY=0，相位指令不执行 | | 合格/不合格

## 5. 射频性能验收测试（四级调试）

测试项目 | 验收标准 | 结果 | 判定
射频通路特性 | 直通损耗正常、无自激、无杂散、底噪无抬升 | | 合格/不合格
6bit移相步进 | 0~63全码点正常，单步5.625°，无跳变、无滞后 | | 合格/不合格
相位重复性 | 多次设置同一相位，无漂移、无偏移 | | 合格/不合格
抗干扰性能 | USB插拔、串口通信过程中相位无抖动 | | 合格/不合格

## 6. 预留扩展接口测试

接口类型 | 验收标准 | 结果 | 判定
USART2 | 收发数据正常，无乱码、无丢包 | | 合格/不合格
SPI1 | 读写通信正常，时序稳定 | | 合格/不合格
I2C1 | 读写通信正常，上拉有效 | | 合格/不合格
SWD调试口 | 可正常烧录、在线调试 | | 合格/不合格

# 专项故障深度排查手册（四大核心故障）

## 故障一：电源不起振 / 无负压 / 电压异常

故障现象：VCC3P3无电压、LM27762无-5V输出、PWR_RDY持续低电平、芯片发热、上电啸叫、电压跌落波动。

逐级排查步骤：

1. 检查USB输入：适配器损坏、USB座虚焊、引脚错位
2. 检查保护链路：PPTC熔断、SS34肖特基焊反/损坏、SMBJ6.5A TVS击穿
3. 排查3.3V电源：LP2985虚焊、输入/输出去耦电容漏焊/失效
4. 排查负压电源（高频故障）：LM27762虚焊、4.7μH电感非屏蔽/焊反、负压滤波电容失效
5. 检查电源监控：TPS3700分压电阻虚焊、芯片损坏，导致电源就绪信号锁低
6. 排查板级短路：3.3V、AVCC5、AVCCN5存在对地微短路

根治要点：LM27762必须使用屏蔽功率电感，SW开关节点走线最短最小；正负电源搭配高低ESR电容组合滤波。

## 故障二：USB无法通信 / 电脑不识别设备

故障现象：插入USB无反应、设备管理器无CH340设备、串口无打印、通信完全中断。

逐级排查步骤：

1. 检查USB保护链路：共模电感开路、SRV05-4 ESD击穿损坏
2. 检查差分信号线：D+/D-虚焊、断线、短路、交叉走线
3. 检查CH340基础工况：3.3V供电异常、复位阻容虚焊
4. 检查时钟电路：CH340 12MHz晶振不起振、负载电容漏焊（最高发故障）
5. 排查电脑端：CH340驱动异常、串口被占用、USB口损坏

根治要点：USB差分线等长平行、不跨地分割、远离开关电源噪声区；所有保护器件紧贴USB接口摆放。

## 故障三：串口指令正常，移相器无相位变化

故障现象：串口收发正常、指令返回OK，但矢量仪无相位变化，移相器不工作。

逐级排查步骤：

1. 优先核查硬件锁：PWR_RDY必须为3.3V高电平，电源异常直接硬件锁死移相器
2. 核查射频电源：AVCC5、AVCCN5电压异常/缺失，移相器无工作条件
3. 核查数据总线：PB0~PB5 100Ω串联电阻虚焊、开路
4. 核查锁存信号：PB6 LE锁存引脚虚焊、电阻损坏（最高发故障）、时序过短
5. 核查程序逻辑：相位0x3F掩码异常、锁存延时不足
6. 核查芯片状态：XT3301单电源上电烧毁、高温虚焊损坏

根治要点：控制线串联电阻靠近移相器引脚；严格遵守上电时序，杜绝单电源上电。

## 故障四：射频噪声大、相位抖动、底噪抬升、稳定性差

故障现象：射频底噪偏高、相位随机抖动、数值漂移、串口通信/USB插拔时射频指标恶化。

逐级排查步骤：

1. 排查核心噪声源：LM27762 SW节点走线过长、未用屏蔽电感、靠近射频区域
2. 排查地平面问题：AGND/DGND多点接地、分割槽过窄、单点0Ω接地未焊接
3. 排查射频走线：50Ω阻抗失效、90°直角拐角、走线过长、无等长设计
4. 排查器件选型：射频隔直电容使用普通MLCC，非高Q射频专用电容
5. 排查数字干扰：MCU/CH340晶振靠近射频区、数字线与射频线平行走线
6. 排查电源纹波：电源去耦电容缺失、摆放远离芯片引脚，滤波失效

根治要点：射频区域纯AGND隔离，开关电源与射频物理分区；所有IC去耦电容就近贴装，杜绝数字噪声串扰射频通路。

## 7. 整机最终验收判定标准

整机全部项目满足以下条件，判定为合格成品：

- 各路电源电压精准、纹波小、芯片无发热、无啸叫异常
- USB串口通信稳定，指令无丢包、无乱码、无离线
- 6bit移相0~63全量程精准，步进均匀、无跳变、无滞后漂移
- 软硬件双重电源保护功能有效，异常工况自动锁存保护
- UART2/SPI/I2C/SWD所有预留扩展接口功能正常、互不干扰
- 射频底噪低、相位稳定性好、抗干扰能力达标

## 8. 验收签字栏

测试人员：______________&nbsp;&nbsp;&nbsp;&nbsp;测试日期：______________

复检人员：______________&nbsp;&nbsp;&nbsp;&nbsp;复检日期：______________

整机判定：□ 合格 &nbsp;&nbsp; □ 不合格
