lyy622516-web/phase_shifter/外挂数控移相模块链路预算_简版.docx

外挂数控移相模块射频链路预算

工作频点：922.5 MHz

# 1 链路预算目的

本链路预算用于估算可重构端机接入外挂数控移相模块后，在922.5 MHz工作频点处由射频开关、连接器、同轴线、PCB传输线、隔直电容和XT3301Q6数控移相器共同引入的总插入损耗，为后续发射功率配置、两路幅度匹配以及相干增强实验提供依据。

# 2 射频链路组成

外挂移相支路按照“端机发射链路→SPDT1→Mini-SMA连接器→同轴线→外挂移相模块→同轴线→Mini-SMA连接器→SPDT2→端机后级放大链路”的结构接入。模块内部主要包含输入/输出射频连接器、50 Ω PCB传输线、射频隔直电容以及XT3301Q6数控移相器。

【图 1 射频链路流程图预留位置】

建议图示：端机TX → SPDT1 → Mini-SMA → 同轴线 → 外挂移相模块（XT3301Q6） → 同轴线 → Mini-SMA → SPDT2 → DA/PA

# 3 预算参数与工程取值

XT3301Q6在0.9～1.3 GHz范围内典型插入损耗约为5 dB。Mini-SMA连接界面、同轴线及PCB走线损耗会随具体型号、长度、加工质量和阻抗匹配情况变化，因此下表中的连接器、同轴线、PCB走线和隔直电容损耗采用922.5 MHz附近的工程估算值。后续确定具体连接器和线缆型号后，应以器件数据手册或VNA实测结果替换。

损耗项 | 数量 | 单项预算 | 合计
SPDT射频开关 | 2个 | 0.35 dB/个 | 0.70 dB
Mini-SMA连接界面 | 4处 | 0.10 dB/处 | 0.40 dB
RG316级同轴线 | 2根 | 约1.2 dB/m | 与长度有关
PCB 50 Ω传输线 | 输入+输出 | 工程估算 | 0.10 dB
100 pF射频隔直电容 | 2处 | 约0.05 dB/处 | 0.10 dB
XT3301Q6 | 1个 | 典型约5.0 dB | 5.00 dB

# 4 链路预算计算

设单根同轴线长度为 l（单位：m），同轴线单位长度衰减系数为 α，则两根同轴线产生的总损耗为：

L_cable = 2 α l

外挂移相支路的总插入损耗可表示为：

L_total = L_SPDT + L_connector + L_cable + L_PCB + L_DCblock + L_phase

当每根同轴线长度取0.2 m、单位长度损耗按1.2 dB/m估算时：

L_cable = 2 × 1.2 × 0.2 = 0.48 dB

L_total = 0.70 + 0.40 + 0.48 + 0.10 + 0.10 + 5.00 = 6.78 dB

因此，20 cm双同轴线条件下，外挂移相支路的典型总插入损耗约为：

L_total ≈ 6.8 dB

考虑连接器驻波、加工误差、不同移相码状态下的幅度波动以及器件离散性，工程设计时建议按7.0～7.5 dB进行预算。

# 5 功率传输示例

若第一级SPDT前的射频输入功率为10 dBm，则经过外挂移相支路后的输出功率可按下式估算：

P_out = P_in - L_total

P_out = 10 - 6.78 = 3.22 dBm

因此，当外挂支路输入功率为10 dBm时，在上述20 cm同轴线假设下，返回端机后级前的射频功率约为3.2 dBm。实际结果应通过矢量网络分析仪测量模块及线缆组合后的S21进行校准。

# 6 不同同轴线长度下的预算结果

单根同轴线长度 | 两根同轴线损耗 | 外挂链路典型总插损
10 cm | 0.24 dB | 约6.54 dB
20 cm | 0.48 dB | 约6.78 dB
30 cm | 0.72 dB | 约7.02 dB
50 cm | 1.20 dB | 约7.50 dB

# 7 预算结论

在922.5 MHz工作频点下，以XT3301Q6典型插损5 dB、两根20 cm RG316级同轴线及4处Mini-SMA连接界面为例，外挂数控移相支路的典型总插入损耗约为6.8 dB。工程设计建议按7.0～7.5 dB留出裕量。后续样机完成后，应分别测试同轴线、外挂模块以及整条外挂支路的S21，以实测值更新最终链路预算。
