lyy622516-web/phase_shifter/设计报告/0.9-1.3GHz_6bit数控移相器模块设计报告_优化版.docx

0.9–1.3 GHz 6 bit 数控移相器模块设计报告

面向可重构超高频蜂窝物联网端机分布式相干增强验证

2026 年 9 月

修订记录

版本 | 日期 | 修订内容 | 说明
V1.0 | 2026-09-10 | 基于原数控移相器方案与可重构端机设计报告重构文档框架 | 形成工程化设计报告
V1.1 | 2026-09-10 | 修正 XT3301Q6 供电、控制接口、电平转换及负压电源方案 | 本文件当前版本

本次优化的关键修订

序号 | 原方案问题/不足 | 优化处理
1 | XT3301Q6 被描述为“+5 V/−5 V 双模拟电源”，且额外设置 LE 锁存引脚。 | 按现有 XT3301Q6 资料改为 VEE=−5 V；+5 V 仅用于控制高电平；器件本体仅保留 VC1～VC6 六路并行控制，不虚构 LE 引脚。
2 | CS32F030 的 3.3 V GPIO 被直接接入 XT3301Q6 0/+5 V 控制端。 | 增加 3.3 V→5 V 控制电平转换。推荐 HCT 族 5 V 缓冲/锁存器；若强调纯国产离散实现，可采用六路 NMOS 开漏反相电平转换。
3 | LM27762 被按“带电感反相 DC-DC”使用，拓扑与器件真实结构不一致。 | 改用 SGM2066 低噪声开关电容反相器，5 V 输入产生 −5 V，无需功率电感，更适合射频偏置环境。
4 | TPS3700 直接监测 −5 V 的思路不成立，且国产替代器件 SGM865 采购不便。 | 改为 SGM882BA。+5 V 采用电阻分压监测；−5 V 通过正电压偏置网络映射至 0.4 V 阈值范围，再进行欠压判断。
5 | 原文偏“聊天记录式方案”，同一器件参数重复且前后不一致。 | 按可重构端机设计报告的“指标—总体方案—工作原理—硬件设计—PCB—调试测试—BOM”主线重构，每个主要器件单独设置参数表。
6 | 在射频链路中考虑新增监测器件。 | 本方案不在耦合器后或移相模块内部新增 RF 功率监测器；相位/功率验收由外部 VNA、频谱仪或目标接收端完成。

目 录

中文摘要

一、数控移相器模块功能与技术指标要求

二、数控移相器模块技术方案及工作原理

三、硬件设计与主要器件选型

四、控制软件与通信协议设计

五、PCB 与结构设计约束

六、加工与装配方案

七、功能与性能调试及测试方案

八、风险分析与工程优化建议

九、完整 BOM 建议

十、总结

附录 A 主要控制公式

附录 B Mermaid 系统连接关系源码

附录 C 资料来源与核对清单

中文摘要

本报告面向可重构超高频蜂窝物联网端机的分布式相干增强验证需求，对 0.9～1.3 GHz、6 bit、360° 数控移相器外挂模块进行工程化优化设计。模块以 XT3301Q6 为射频核心，以 CS32F030C8T6 为控制核心，主工作频点为 922.5 MHz，并通过 UART/USB 接口接受相位设置与扫描指令。为了与可重构端机现有架构保持一致，模块不改变端机原有两点式、三点式基站及辅助基站工作链路，而是作为可调发射支路的外挂相位控制单元，由端机中的射频开关决定是否接入。

一、数控移相器模块功能与技术指标要求

1.1 设计定位

该模块不是独立的 RFID 读写器，而是可重构超高频蜂窝物联网端机在相干信号增强验证模式下的外挂射频功能模块。可重构端机在普通工作模式下通过端机内 SPDT 选择直通链路；在相干增强验证模式下，将可调发射端 TX2 的射频信号切换至本模块，经数控移相后再返回端机后级发射链路。参考发射端 TX1 保持直通，用于建立固定相位参考。这样既不破坏原端机三种基础模式，也便于独立测试移相模块本身。

图 1-1 数控移相器模块在可重构端机中的位置关系

1.2 主要技术指标

指标项目 | 设计值/目标值 | 说明
工作频段 | 0.9～1.3 GHz | 覆盖 UHF RFID 主要验证频段，重点验证 922.5 MHz
相位范围 | 0°～360° | 6 bit 数控
相位分辨率 | 5.625°/LSB | 64 个码点
典型插入损耗 | 约 5 dB | 以 XT3301Q6 数据资料为基准，最终以实测为准
RMS 相位误差 | ≤2°（资料值） | 以 XT3301Q6 数据资料为基准，最终以实测为准
射频输入 | ≤+18 dBm | 相对典型输入 P1dB≈+23 dBm 预留工程余量
射频端口阻抗 | 50 Ω | SMA 输入/输出
控制接口 | UART 为主，USB 调试可选 | 上位机或端机 MCU 下发相位码/扫描命令
供电输入 | DC 5 V | USB 5 V 或独立 5 V 供电
负电源 | −5 V | 由 SGM3206 产生，供 XT3301Q6 VEE
数字电源 | 3.3 V | 由 SGM2036产生，供 MCU 等数字电路
控制高电平 | 5 V | XT3301Q6 VC1～VC6 控制电平，必须经电平转换
环境温度目标 | −40 ℃～+85 ℃ | 以控制器与射频器件共同工作范围为设计边界

二、数控移相器模块技术方案及工作原理

2.1 总体技术方案

模块总体上分为射频移相单元、主控单元、电平转换单元、负压电源单元、3.3 V 数字电源单元、电源状态监测单元和通信调试单元。5 V 输入一方面直接作为控制高电平和 HCT 电平转换器的电源，另一方面经 SGM2066 产生 −5 V，经 SGM2036S-3.3 产生 3.3 V。CS32F030C8T6 根据 UART 命令生成 6 bit 相位控制字，经 3.3 V→5 V 电平转换后送入 XT3301Q6 的 VC1～VC6。射频信号从 RFIN 进入，经 XT3301Q6 调相后从 RFOUT 输出。

图 2-1 模块顶层整体连接框图（预留）

2.2 与可重构端机的接口关系

在可重构端机技术方案中，外挂移相器不应固定串接在全部工作模式的公共发射链路中，而应通过端机内两只 SPDT 形成直通路径/外挂路径二选一。普通两点式、三点式基站及三点式辅助基站模式选择直通路径；相干增强验证模式下，TX2 选择外挂路径。这样可以避免移相器约 5 dB 插损长期叠加在普通发射链路上，同时便于在同一块端机硬件上完成基础功能与相干实验的兼容。

图 2-2 端机直通路径与外挂移相路径切换示意图

2.3 数控移相工作原理

XT3301Q6 采用 6 bit 并行数字控制。设控制位数为 N=6，则理论相位步进为：

Δφ_LSB = 360°/2^6 = 5.625°

理论最大量化误差 = ±(5.625°/2) = ±2.8125°

由于移相器内部不同相位位的插损、寄生参数和工艺偏差并不完全一致，理论设定值与 922.5 MHz 下的实测相位之间会存在偏差。工程实现时不应仅依赖理论 5.625° 步进，而是在后续实测过程中在频谱仪上建立从控制码到实测相位的标定表，后续方便上位机按标定表进行相位扫描或目标相位设置。

2.4 分布式相干增强验证原理

在相干增强实验中，TX1 作为参考发射端，TX2 作为可调发射端。两个端机共用同一个外部 48 MHz 参考源，并配置在同一射频频点。外部同源参考解决“频率一致”问题，数控移相器解决“相位差可调”问题，发射功率配置或衰减调节解决“幅度尽量接近”问题。对于目标点处两路复包络幅度 A1、A2，相位差 Δφ，其合成功率与相位差的关系可表示为：

PΣ ∝ A1² + A2² + 2A1A2 cos(Δφ)

当 A1=A2=A 且 Δφ=0° 时，理想合成功率为单路功率的 4 倍，相对单路提高约 6 dB；当 Δφ≈180° 时，理想情况下趋近相消。实际测试中只需要扫描 TX2 的相位码并观察目标点接收功率随相位呈周期变化，即可验证相干增强是否建立。

图 2-3 分布式相干增强验证框图

三、硬件设计与主要器件选型

3.1器件选型

3.1 XT3301Q6 射频移相单元

XT3301Q6 是本模块的射频核心。射频输入和输出均按 50 Ω 设计。

参数 | 指标
器件型号 | XT3301Q6
工艺 | GaAs PHEMT
工作频率 | 0.9～1.3 GHz
相位位数 | 6 bit
理论相位步进 | 5.625°
典型插入损耗 | 约 5 dB
RMS 相位误差 | ≤2°（现有资料值）
典型输入 P1dB | 约 +23 dBm
工程建议输入上限 | ≤+18 dBm，预留压缩余量
控制电平 | 0 V / +5 V
负电源 | VEE=−5 V
射频端口 | RFIN、RFOUT，50 Ω
封装 | QFN 6 mm×6 mm，底部大焊盘接地

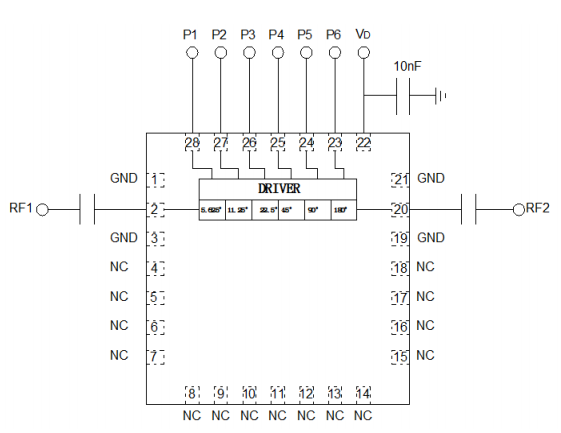
[picture p2: figure]

图 3-1 XT3301Q6 典型应用原理图

3.2 CS32F030C8T6 主控单元

主控采用芯海 CS32F030C8T6。其作用是完成 UART 指令接收、相位角到控制码的换算、六位并行控制输出、电源状态读取、相位扫描状态机以及调试接口管理。

参数 | 指标
内核 | 32 位 ARM Cortex-M0
最高主频 | 48 MHz
Flash | 最高 64 KB
SRAM | 最高 8 KB
工作电压 | 2.0～5.5 V
USART | 2 路
SPI | 2 路
I²C | 2 路
ADC | 12 bit
调试接口 | SWD
推荐封装 | LQFP48（C8T6）
本模块供电 | 3.3 V

3.3 3.3 V→5 V 控制电平转换单元

XT3301Q6 的 VC1～VC6 按datasheet采用 0/+5 V 控制，因此不能继续使用 MCU 的 3.3 V GPIO 直接驱动。该方案使用 5 V 供电的 HCT 族 8 位锁存/缓冲器，例如 74HCT574 类器件。HCT 输入高电平阈值约 2 V，可可靠识别 3.3 V MCU 输出，而输出端可提供接近 5 V 的逻辑高电平；同时 8 位锁存结构可以实现多位同步更新，避免六个控制位依次翻转导致的瞬态错误相位。

参数 | HCT 锁存/缓冲基线要求
供电 | 4.5～5.5 V
输入高电平阈值 | ≤2.0 V，保证 3.3 V GPIO 可识别
输出高电平 | 接近 5 V，满足 XT3301Q6 控制需求
通道数 | ≥6 路
更新方式 | 并行数据 + 单次锁存
输出使能 | 默认使能，必要时由 PWR_RDY 控制
布局要求 | 靠近 XT3301Q6 控制端，控制线远离 RF 走线

3.4 SGM3206 −5V 负压电源单元

XT3301Q6 的 VEE 需要 −5 V。方案采用圣邦微 SGM3206 低噪声稳压开关电容电压逆变器实现。SGM3206 输入范围覆盖 5 V USB 供电，稳压输出可设为 −5 V，典型应用仅需飞跨电容、输入电容、泵输出电容和负输出电容，不需要功率电感，可显著减少磁场辐射和开关节点面积。

参数 | 指标
器件型号 | SGM2066XTDE8G/TR
输入电压 | 2.7～5.5 V
稳压负输出范围 | −1.5～−5 V
输出电流限制 | 250 mA（典型）
−5 V/100 mA 典型压差 | 34 mV
输出噪声 | 28 μV RMS（典型，VIN=5 V）
静态电流 | 410 μA（典型）
软启动 | 内置
外围 | 4 个陶瓷电容，无需电感
封装 | TDFN 2 mm×2 mm-8AL
温度范围 | −40 ℃～+125 ℃

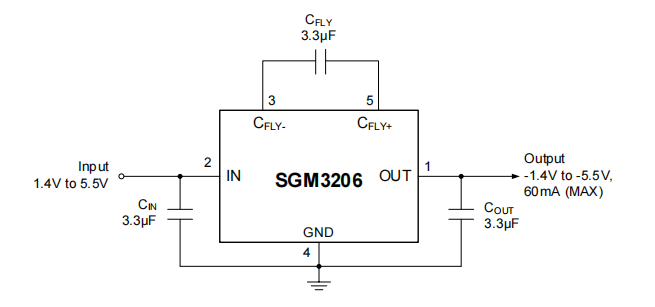
[picture p3: figure]

图 3-3 SGM3206 负压电源原理图

3.5 USB/UART 通信与接口保护单元

USB使用UART-USB芯片后再使用Micro USB接口连接进行串口通信。该模块选用CH340进行 USB转UART，USB 入口保护采用保险丝、TVS和ESD分工处理：功率器件负责 VBUS 过流与浪涌，低电容 ESD 器件负责 D+/D−。

四、控制软件与通信协议设计

4.1 软件功能

4.2 相位标定表

理论码值与实际相位存在器件误差，因此在 922.5 MHz 下建立 64 点标定表。每个码点记录实测相位、插入损耗和相对 0 码的相位增量。上位机需要设置某一目标相位时，可查表选择误差最小的码值，而不是简单使用理论线性关系。

五、PCB 与结构设计约束

5.1 功能分区

PCB沿信号流向布置：SMA 输入→XT3301Q6→SMA 输出形成最短射频主通道；控制 MCU、USB 接口和数字接口布置在射频主通道一侧；SGM3206 和其他电源器件靠近电源入口但与 RFIN/RFOUT 保持物理间距。版图设计需要把把 AGND 与 DGND分开。

而是在完整地平面基础上通过功能分区、回流路径控制和地过孔围栏降低耦合。

5.2 射频布局约束

RFIN 与 RFOUT 走线按 50 Ω 单端微带或共面波导设计，尽量短、少过孔、少拐角。XT3301Q6 的底部焊盘应设置均匀接地过孔阵列，芯片周围设置地过孔围栏。100 pF 隔直电容必须选高 Q、适用于 1 GHz 左右的射频器件，并靠近芯片射频引脚。数字控制线应避开与 RF 线长距离平行，必要时在进入射频区域前串联 22～100 Ω 阻尼电阻。

5.3 电源布局约束

SGM2066 的飞跨电容和泵电容必须紧贴芯片，所有大电流环路面积最小化。虽然 SGM2066 不需要电感，但其开关电容节点仍属于高 dv/dt 噪声节点，禁止靠近 RFIN/RFOUT 和 XT3301Q6 控制引脚。3.3 V LDO 的输入、输出电容紧贴芯片。XT3301Q6 的 −5 V 去耦建议采用 0.1 μF + 1 μF 组合并就近回到射频地。

六、加工与装配方案

6.1 PCB 加工要求

射频板材可继续采用 FR-4 作为原型验证方案，但必须在 0.9～1.3 GHz 范围内按实际板厚、铜厚和介电常数计算 50 Ω 走线。若追求更高的相位重复性和更低的温漂，可在后续版本评估低损耗射频板材。QFN/TDFN 器件焊盘尺寸、阻焊开窗和散热焊盘应严格按数据手册推荐封装制作。

6.2 装配顺序

七、功能与性能调试及测试方案

7.1 测试平台

模块测试使用矢量网络分析仪完成 S 参数与相位扫描

使用示波器/逻辑分析仪检查六路控制电平和锁存时序

使用数字万用表/示波器检查 5 V、3.3 V 与 −5 V 电源。

八、风险分析与工程优化建议

风险 | 表现 | 优化措施
控制电平不兼容 | 3.3 V 直接驱动导致高电平余量不足或码值异常 | 强制加入 3.3 V→5 V 电平转换；投板前核对 XT3301Q6 VIH/VIL
多位切换毛刺 | 多个控制位不同时翻转，瞬间经过错误相位码 | 使用 HCT 锁存器统一更新，或同端口原子写 GPIO
负压纹波耦合 | 相位/插损随电源噪声抖动 | SGM2066 紧凑布局、独立去耦、与 RF 物理隔离
−5 V 监测误判 | 负压不能直接进入 SGM882 输入 | 采用正负偏置网络并做最坏情况计算
输入功率过高 | 移相器压缩或损坏 | 工程建议输入≤+18 dBm；模块布置在 DA/PA 前级
码值相位非线性 | 理论 5.625° 与实测存在偏差 | 建立 922.5 MHz 64 点标定表
USB 噪声 | PC/USB 共模干扰进入射频地 | 共模扼流圈+ESD+分区；正式实验优先 TTL UART/独立 5 V
结构/连接器重复性 | SMA/线缆重复插拔引入相位变化 | 固定线缆、统一扭矩、实验前做 through/reference 校准
温漂 | 长时间测试峰值相位缓慢移动 | 预留温度记录，必要时建立温度-相位补偿表

九、完整 BOM 建议

以下 BOM 用于原型验证，具体品牌、封装和物料编码在投板前应根据库存与数据手册二次确认。射频芯片、负压电源、电源监控和控制电平转换属于关键物料，不建议仅按“同封装”直接替代。

位号 | 器件 | 主要规格 | 封装 | 数量 | 用途
U1 | XT3301Q6 | 6 bit 数控移相器，0.9～1.3 GHz | QFN6×6 | 1 | 射频核心
U2 | CS32F030C8T6 | Cortex-M0，48 MHz，64 KB Flash | LQFP48 | 1 | 主控 MCU
U3 | SGM2066 | 5 V→−5 V 低噪声开关电容反相器 | TDFN2×2-8 | 1 | 负压电源
U4 | SGM2036S-3.3 | 3.3 V/300 mA LDO | SOT-23-5 | 1 | 数字电源
U5 | SGM882BA | 双路 400 mV 基准电源监测 | SOT-23-6 | 1 | 5 V/−5 V 状态监测
U6 | 74HCT574 类 | 8 bit 5 V HCT 锁存/缓冲 | TSSOP/SOIC20 | 1 | 3.3 V→5 V、同步更新
U7 | CH340G（可选） | USB 转 UART | SOP16 | 1 | PC 调试
Y1 | 8 MHz 晶振 | MCU HSE | 贴片 | 1 | 主控时钟
Y2 | 12 MHz 晶振（CH340G 时） | CH340G 时钟 | 贴片 | 1 | USB-UART
D1 | SMBJ6.5A 类 | 单向功率 TVS | SMB | 1 | VBUS 浪涌
D2 | 低电容 ESD 阵列 | USB D+/D− 保护 | SOT-23-6 | 1 | USB ESD
F1 | PPTC 0.5 A | ≥6 V | 0603 | 1 | VBUS 过流
L1 | USB 共模扼流圈 | 90～100 Ω@100 MHz | 0603/0805 | 1 | USB 共模滤波
C_RF1/2 | 100 pF 高Q | 1 GHz 射频隔直 | 0402 | 2 | RFIN/RFOUT
C_NEG | 4.7 μF/1 μF/2.2 μF 等 | 按 SGM2066 典型应用 | 0402/0603 | 4 | 负压电荷泵
C_DEC | 0.1 μF/1 μF | X7R | 0402/0603 | 若干 | 芯片去耦
R_MON | 102k/10k/93.1k/100k | 1% 或更高精度 | 0402/0603 | 4 | SGM882 阈值网络
R_CTRL | 22～100 Ω | 控制线阻尼 | 0402 | 6~7 | 抑制边沿振铃
J1/J2 | SMA-K | 50 Ω | 贴片 | 2 | RF 输入/输出
J3 | UART 3Pin | TX/RX/GND | 2.54 mm | 1 | 端机主控制接口
J4 | SWD 4Pin | 3.3V/GND/SWDIO/SWCLK | 2.54 mm | 1 | 烧录调试

十、总结

本优化版数控移相器模块围绕可重构端机的分布式相干增强验证任务重新定义了系统边界和硬件实现方式。模块不改变端机已有的普通读写模式，而是作为 TX2 的外挂相位可调路径，通过端机 SPDT 选择接入。方案保留 XT3301Q6 与 CS32F030 国产核心器件，并将负压电源、3.3 V LDO、电源监控分别优化为 SGM2066、SGM2036S-3.3 和 SGM882BA；同时补充了原方案缺失的 3.3 V→5 V 控制电平转换与同步更新机制。

从实验流程看，模块的核心目标不是实时闭环追踪相位，而是提供可重复、可标定、可扫描的 64 级相位控制。先通过 VNA 建立 922.5 MHz 的码值—相位—插损标定表，再在两端机共用 48 MHz 同源参考的条件下扫描 TX2 相位码，观察目标点接收功率的周期性变化与增强峰值，即可完成分布式相干增强的关键验证。后续原理图、PCB 版图和实测曲线可直接插入本文已经预留的图位中。

附录 A 主要控制公式

1）6 bit 理论相位步进：

Δφ = 360° / 2^6 = 5.625°

2）目标角度到控制码：

k = round(φ_target / 5.625°), k ∈ {0,1,…,63}

3）两路相干叠加：

PΣ ∝ A1² + A2² + 2A1A2 cos(Δφ)

4）+5 V 欠压分压：

Vmon1 = V5 × Rbot / (Rtop + Rbot)

5）−5 V 偏置监测节点：

Vmon2 = (V5 × Rn + Vneg × Rp) / (Rp + Rn)

附录 B Mermaid 系统连接关系源码

以下代码可直接复制到支持 Mermaid 的编辑器中生成系统连接关系图，后续导出 PNG/SVG 后插入图 2-1 预留位置。

flowchart LR
VIN[5V输入] --> PROT[输入保护/滤波]
PROT --> NEG[SGM2066 -5V]
PROT --> LDO[SGM2036S-3.3]
PROT --> LVL[5V HCT电平转换]
LDO --> MCU[CS32F030C8T6]
UART[UART/USB] --> MCU
MCU -->|D0~D5/CLK| LVL
LVL -->|0/5V VC1~VC6| PS[XT3301Q6]
NEG -->|VEE=-5V| PS
PROT --> MON[SGM882BA]
NEG --> MON
MON -->|PWR_RDY| MCU
RFIN[RF IN 50Ω] --> PS --> RFOUT[RF OUT 50Ω]

附录 C 资料来源与核对清单

1. 《可重构超高频蜂窝物联网端机设计报告-20260620》：用于本报告章节组织、端机工作模式、外挂移相器位置、48 MHz 同源参考与相干增强实验主线。

2. 《0.9-1.3GHz 6bits 360° 数控移相器模块技术方案》：作为原方案输入，本文对其中电源、电平与监控部分进行了工程化修订。

3. XT3301Q6 Rev1.2 数据资料：用于核对 0.9～1.3 GHz、6 bit、VEE=−5 V、VC1～VC6 0/+5 V 控制及射频端口定义。

4. 芯海 CS32F030 数据手册/官网资料：用于核对 Cortex-M0、48 MHz、Flash/SRAM 与通信接口。

5. 圣邦微 SGM2066 Datasheet：用于核对输入范围、−5 V 输出、电流限制、噪声、封装与典型应用。

6. 圣邦微 SGM2036S Datasheet：用于核对 3.3 V LDO 输入范围、300 mA 输出与封装。

7. 圣邦微 SGM882 Datasheet：用于核对 400 mV 基准、双比较器、传播延迟、开漏输出与 SOT-23-6 封装。

8. 南京沁恒 CH340 系列资料：用于 USB-UART 调试接口设计。

0.9–1.3 GHz 6 bit 数控移相器模块设计报告
