lyy622516-web/phase_shifter/设计报告/6bits 0.9-1.3GHz 移相器模块技术方案与设计报告 龙彦宇 20260920.docx

密 级:内部、华为公司

编 号: CRFICS_FRPT02_20260920

6bits 0.9-1.3GHz射频移相器技术方案与设计报告

龙彦宇

射频集成电路与系统研究中心

电子科技大学信息与通信工程学院

2026年09月20日

Revision History

Version # | Author | A. Description Of Change B. Summary of Review | Issued By/Date
1.0 | 龙彦宇 | 初稿 | 2026年09月10日

# 中文摘要（给出关键词）

关键词：

# 英文摘要（给出关键词）

Keywords:

# 一、6bits射频移相器模块应用场景及研制背景

## 1.1 6bits射频移相器模块应用场景及研制背景

本模块面向FTTx（FTTH、FTTB、FTTR等的统称，Fiber to the x）与超高频(Ultra-High Frequency-UHF) RFID融合的无源物联系统。在该类系统中，无源超高频RFID标签（以下简称标签）的接收灵敏度与上行链路预算是制约标签识别距离的关键因素，提升端机向标签方向发射的射频信号强度，是增大标签到端机通信距离的有效途径；采用多台超高频无源物联可重构端机（以下简称端机）在目标位置处分布式同时发射射频信号、在标签处实现射频信号相干功率合成，可提升目标位置处的接收功率，进而改善系统的覆盖能力与吞吐容量。

相干功率合成的效果由多路发射射频信号在目标位置处的相对相位直接决定。设两路复包络幅度分别为A₁、A₂、相位差为Δφ，当A₁=A₂=A且Δφ=0°时，理想合成功率为单路功率的4倍、相对单路提高约6 dB；当Δφ≈180°时，理想情况下趋近相消。因此，要使多台端机发射的射频信号在标签处稳定同相叠加，各发射支路之间必须同时满足同频与同相两个条件。

然而，端机各发射支路包含独立的锁相环、滤波网络、射频线缆与天线，其引入的相位延迟与器件离散性、工作频点及环境温度相关：即使多台端机配置在同一射频频点，其发射射频信号到达目标位置处的绝对相位仍不可预知且随时间漂移，仅靠各端机共用同一参考源只能保证频率一致，无法保证相位对准。因此，需在端机发射支路中引入相位可实时调控的器件，通过相位扫描与标定获取相位—功率关系并据以补偿相位差，使目标位置处两路发射射频信号趋于同相。6bits数控射频移相器以5.625°的相位步进覆盖0°～360°，可满足上述需求，是本系统相干增强验证实验中的关键相位调控单元。

在上述任务背景下，本模块研制FTTx-UHF RFID融合超高频无源物联可重构端机在相干增强验证模式下的外挂射频移相功能模块。该模块不固定串接于端机的公共发射链路，而是通过端机内两只单刀双掷开关（Single Pole Double Throw-SPDT）在直通路径与外挂移相路径之间二选一接入：普通两点式、三点式基站及三点式辅助基站模式选择直通路径；相干增强验证模式下，由可调发射端TX2选择外挂路径，参考发射端TX1保持直通，用于建立固定相位参考。这样既不破坏端机原有的三种基础工作模式，也避免移相器约5 dB的插入损耗叠加在普通发射链路上，同时便于对移相模块本身进行独立测试。

本模块的研制目标是在0.9～1.3 GHz频段（重点验证922.5 MHz）内提供0°～360°、6bits分辨率的数控相移，与外挂48MHz时钟参考源模块配合，共同解决相干增强实验中同频与同相两个问题，为多端机分布式相干功率合成验证提供可控的相位调节手段。

图1-1 6bits数控射频移相器模块在可重构端机中的位置关系

## 1.2 6bits射频移相器模块功能

本模块的功能是在端机相干增强验证模式下，为可调发射端TX2的发射支路提供0°～360°、6bits分辨率的数控相移，上位机可按需设定并扫描TX2发射射频信号的相位。0.9-1.3GHz 6bits 数控射频移相器模块不是独立的超高频RFID读写器，仅是端机在相干增强验证模式下端机外挂接入的射频移相功能模块，其功能及主要技术指标要求如下。

1) 工作频段：0.9～1.3 GHz，覆盖了中国超高频RFID系统工作频段920MHz-925MHz
2) 射频信号移相范围： 0°～360°
3) 射频信号最小移相量：5.625°
4) 射频信号移相精度(RMS)：2°
5) 移相附加插损（增益）：6dB（14dB）
6) 射频信号输入/输出端口回波损耗：<-12dB@ SAM 50Ω
7) 与上位机的通信接口：USB、UART
8) 上位机经UART下发相位码与相位扫描指令，支持0～63全部64个码值的遍历扫描与状态回读。

## 1.3 6bits射频移相器模块技术指标

依据任务需求与端机外挂移相路径的接口要求，本模块须达到的主要技术指标如下表1-1所示。

表1-1 6bits射频移相器模块技术指标要求

指标项目 | 设计值/目标值 | 说明
工作频段 | 0.9～1.3 GHz | 覆盖中国UHF RFID 系统工作频段920MHz-925MHz
相位范围 | 0°～360° | 6 bit 数控
相位分辨率 | 5.625°@LSB | 64 个码点
附加插入损耗（无内置LNA） | 6 dB | XT3301Q6 移相器芯片附加插入损耗+2个SMA接口损耗+PCB上射频信号传输损耗
附加插入增益(内置LNA) | 14dB | LNA增益-附加插入损耗
RMS 移相精度 | ≤2° | 基于XT3301Q6 芯片数据
最大许可输入射频信号功率 | ≤18 dBm | 基于XT3301Q6 芯片数据
射频信号输入端口回波损耗 | <-20dB@50 Ω | 基于XT3301Q6 芯片数据
射频信号输出端口回波损耗 | <-20dB@50 Ω 或<-12dB@50 Ω（内置LNA的输端口） | 基于XT3301Q6 芯片、FW1103 LNA芯片数据
与上位机通信(控制)接口 | UART、USB 调试 | 上位机下发相位码/扫描命令
供电方式 | DC 5V@1A | USB 5V@1A 或独立 5 V电源供电
工作温度范围 | -55C°~+85C°
贮存温度范围 | -65C°~+150C°

# 二、6bits射频移相器模块技术方案及工作原理

针对端机相干增强验证对发射支路相位调控能力的功能与性能要求，经分析、预算等论证，形成如下的6bits射频移相器模块技术方案及工作原理。该模块不是独立的超高频RFID读写器，而是端机在相干增强验证模式下的外挂射频移相功能模块。端机在普通工作模式下通过端机内SPDT选择直通链路；在相干增强验证模式下，将可调发射端TX2的射频信号切换至本模块，经数控移相后再返回端机后级发射链路，参考发射端TX1保持直通，用于建立固定相位参考。

## 2.1 6bits射频移相器模块总体技术方案

请在原方案基础上，XT3301Q6芯片输出端口到模块输出SMA端口之间插入两个SPDT射频开关，一种工作模式是XT3301Q6芯片输出射频信号经过两个SPDT射频开关直通到模块输出SMA端口，另一种工作模式是XT3301Q6芯片输出射频信号经过SPDT开关后，输入FW1103 LNA，低噪声放大后再经SPDT输出到模块输出SMA端口；两个SPDT的通路选择性由上位机控制。

请按照前述功能要求，以及我对前面内容修改方式，认真彻底补充完善该技术方案与设计报告，做到层次清晰、逻辑严密、表述简明准确严谨、图表格式规范！

设计的6bits射频移相器模块电路架构如图2-1所示，其由射频移相单元、主控单元、电平转换单元、负压电源单元、3.3 V数字电源单元、电源状态监测单元和通信调试单元等构成：5 V输入一方面直接作为控制高电平和电平转换器的电源，另一方面经SGM3206电荷泵产生−5 V供射频移相单元的VEE、经SGM2036S-3.3产生3.3 V供主控等数字电路；主控CS32F030C8T6根据UART命令生成6 bit相位控制字，经3.3 V→5 V电平转换后送入射频移相单元的VC1～VC6；射频信号从RFIN输入，经射频移相单元调相后从RFOUT输出。

图2-1 6bits射频移相器模块顶层整体连接框图

本模块的射频链路、控制链路与供电链路三条链路相互独立。射频链路的信号流程为：射频信号由RFIN端口经SMA连接器、隔直电容与匹配网络送入射频移相单元的射频输入端，移相单元按VC1～VC6所确定的相位设定值对射频信号调相后由其射频输出端输出，再经隔直电容与匹配网络送至RFOUT端口，最后经SMA连接器输出至端机的后续发射链路。

控制链路的信号流程为：上位机经USB接口与USB转UART芯片将相位码设置指令或相位扫描指令转换为串口数据，送入主控CS32F030C8T6的通用异步收发器（Universal Asynchronous Receiver/Transmitter-UART）接口，主控按指令解析出目标相位值并换算为6 bit相位控制字，由通用输入输出（General Purpose Input/Output-GPIO）端口并行输出，经3.3 V到5 V电平转换单元转换为0/+5 V电平后送入射频移相单元的VC1～VC6，实现相位的设定与切换；主控同时经串口向上位机回读当前相位码与电源状态。

供电链路的流程为：直流5 V输入一方面直接作为电平转换单元的B侧电源与射频移相单元的控制高电平电源，另一方面分两路分别送入负压电源单元与3.3 V数字电源单元，经SGM3206电荷泵反相后产生−5 V供射频移相单元的VEE，经SGM2036S-3.3线性稳压后产生3.3 V供主控与通信单元使用；三路供电的接地点在参考地点处单点汇接，避免数字电路的开关噪声经公共地阻抗耦合至射频移相单元的负偏置回路。

本模块的上电与工作流程如下：

（1）直流5 V接入后，3.3 V数字电源单元先建立稳定输出，主控完成复位与初始化，进入等待串口指令状态；

（2）负压电源单元将5 V反相产生−5 V，为射频移相单元的VEE提供负偏置，使射频移相单元的6个相位位具备工作条件；

（3）主控将VC1～VC6初始化为确定的初始码值，经电平转换后送入射频移相单元；

（4）上位机经USB转UART下发相位码设置指令或相位扫描指令，主控换算控制字后更新VC1～VC6，射频移相单元按新的控制字改变对射频信号的相移量；

（5）射频信号在RFIN与RFOUT之间经射频移相单元调相后输出，完成一次相位设定；

（6）模块在扫描模式下按上位机指令遍历0～63全部码值并逐码回读状态，供上位机建立控制码与实测相位的对应关系。

本模块的对外接口与信号定义如下表2-1所示。

表2-1 6bits射频移相器模块对外接口与信号定义

接口 / 信号 | 类型 | 电平 / 形式 | 功能说明
RFIN | 射频输入 | 50 Ω，SMA | 接收端机可调发射端TX2支路送来的射频信号
RFOUT | 射频输出 | 50 Ω，SMA | 输出调相后的射频信号至端机后级发射链路
直流5 V输入 | 电源输入 | DC 5 V | 模块总供电，兼作控制高电平与电平转换单元B侧电源
USB接口 | 通信调试 | Micro USB | 经CH340转换为UART，与上位机通信
UART | 通信 | 3.3 V串口电平 | 与端机主控通信，接收相位码与扫描指令
VC1～VC6 | 控制 | 0 / +5 V | 6 bit相位控制字输入，由电平转换单元驱动
VEE | 电源 | −5 V | 射频移相单元负偏置，由SGM3206产生
电源状态监测 | 状态 | 3.3 V逻辑 | 供电状态回读，供主控判断供电是否正常

## 2.2 6bits射频移相器模块与可重构端机的接口关系

在端机技术方案中，外挂移相器不应固定串接在全部工作模式的公共发射链路中，而应通过端机内两只SPDT形成直通路径与外挂路径二选一的接入方式：普通两点式、三点式基站及三点式辅助基站模式选择直通路径；相干增强验证模式下，由可调发射端TX2选择外挂路径。这样可以避免移相器约5 dB的插入损耗长期叠加在普通发射链路上，同时便于在同一块端机硬件上完成基础功能与相干增强验证实验的兼容。端机直通路径与外挂移相路径的切换关系如图2-2所示。

图2-2 端机直通路径与外挂移相路径切换示意图

直通路径与外挂移相路径的信号流程分别为：直通路径下，端机内第一只SPDT将射频信号由可调发射端TX2的射频链路直接引至第二只SPDT，信号不经过本模块，其损耗仅为两只SPDT与连接线缆的插入损耗；外挂移相路径下，两只SPDT同时切换，射频信号由第一只SPDT经miniSMA接头与同轴线送入本模块的RFIN端口，经射频移相单元调相后从RFOUT端口输出，再经同轴线与miniSMA接头返回第二只SPDT，随后进入端机后级发射链路。

两条路径的切换控制逻辑与联锁要求为：两只SPDT由同一模式变量控制并保持同向同步切换，不允许出现一只开关选择直通、另一只开关选择外挂的混合状态，否则将形成开路支路、引入额外反射，甚至造成信号中断。

本模块不固定串接于端机的公共发射链路，而是以二选一的接入方式工作，其设计意图在于：避免移相单元约5 dB的插入损耗长期叠加在普通发射链路上，保证端机在普通工作模式下的发射功率与识别距离不受影响；同时也便于对移相模块本身进行独立测试与标定，即在模块不接入端机时即可完成插入损耗与相位特性的测量。

## 2.3 数控移相工作原理

本模块的射频移相单元选用XT3301Q6，其相位步进为5.625°，而理论移相误差为2.8125°：若要设定任意一个目标相位值，实际只能选择64个移相码中最接近的离散档位，理论上的最大量化误差即为半个相位步进2.8125°。例如相位设30°时，附近可选档位为28.125°与33.75°，选28.125°时误差为30°−28.125°=1.875°，而最坏情况发生在两个档位正中间，因此最大为2.8125°。

射频移相单元内部由6个级联的相位位构成，各位的相移量按二进制加权分别为180°、90°、45°、22.5°、11.25°与5.625°，分别对应控制位VC6、VC5、VC4、VC3、VC2与VC1，其中VC6为最高有效位（Most Significant Bit-MSB）、VC1为最低有效位（Least Significant Bit-LSB）。每一位通过内部开关在参考路径与延迟路径之间选择，各位相移量与该位取值的乘积之和即为所选相位码对应的总相移量：VC6取1时计入180°，VC5取1时计入90°，VC4取1时计入45°，VC3取1时计入22.5°，VC2取1时计入11.25°，VC1取1时计入5.625°。

码值与相移量的对应关系举例说明：目标相位为30°时，按二进制加权分解为22.5°+5.625°+1.875°，而1.875°不足一个最低有效位，在64个码点中只能选取最接近的档位，可选档位为28.125°与33.75°，取28.125°时的设定误差为1.875°；目标相位为90°时，可由VC5置1、其余位置0直接实现，设定误差为0°。码值由0逐次加1时，各位按二进制进位规律翻转，总相移量以5.625°为步进递增，6 bit共64个码值，相移在354.375°之后回到0°，形成一个步进为5.625°的完整相位环路。

移相控制字到射频相移量的映射按下述步骤实现：

（1）上位机下发目标相位值，主控按四舍五入规则将其量化为最接近的码值，量化关系为码值约等于目标相位除以5.625°后取整，量化的理论最大误差为半个步进即2.8125°；

（2）主控将该码值转换为6 bit并行数据，按VC6（MSB）至VC1（LSB）的顺序映射至通用输入输出端口；

（3）6 bit数据经电平转换单元由3.3 V转换为0/+5 V电平，送入射频移相单元的VC1～VC6引脚，其中逻辑1对应+5 V、逻辑0对应0 V；

（4）射频移相单元内部各位的开关按控制字选通对应的参考路径或延迟路径，各路相移量在射频通路上叠加，输出端得到对应码值的相移量。

由于移相器内部不同相位位的插入损耗、寄生参数和工艺偏差并不完全一致，理论设定值与922.5 MHz下的实测相位之间会存在偏差。因此在后续实测过程中不能仅依赖理论5.625°步进，而应在频谱仪上建立从控制码到实测相位的标定表，后续便于上位机按标定表进行相位扫描或目标相位设置。

## 2.4 相干增强验证原理

在相干增强验证实验中，TX1作为参考发射端，TX2作为可调发射端。两台端机共用同一个外部48MHz参考源并配置在同一射频频点：外部同源参考解决频率一致问题，数控射频移相器解决相位差可调问题，端机发射功率配置或外接衰减调节解决幅度尽量接近问题。对于目标位置处两路复包络幅度A₁、A₂、相位差Δφ，其合成功率与相位差的关系可表示为

PΣ ∝ A1² + A2² + √(2A1A2 cos(Δφ))

当A₁=A₂=A且Δφ=0°时，理想合成功率为单路功率的4倍、相对单路提高约6 dB；当Δφ≈180°时，理想情况下趋近相消。实际测试中只需扫描TX2的相位码并观察目标位置处接收功率随相位呈周期变化，即可验证相干增强是否建立。分布式多端机相干增强验证的系统构成如图2-3所示。

两路射频信号在目标位置处的合成结果由两路信号的复包络幅度与相位差共同决定。合成功率等于两路功率之和加上两路功率乘积的平方根与相位差余弦值乘积的二倍，其中后一项为相干项，随相位差按余弦规律变化：当Δφ=0°时相干项取最大值，合成功率等于两路功率之和加上两路功率乘积平方根的二倍，两路幅度相等时该值等于单路功率的4倍、相对单路提高约6 dB；当Δφ=180°时相干项取负向最大值，合成功率取最小值，两路幅度相等时理想情况下趋近于零。

工程上以相干增强量Gcoh衡量相干合成的效果，其定义为相位扫描所得最大稳定合成功率与两路非相干线性功率和之差，其中非相干功率和由两路单路实测功率按线性功率相加后再取对数得到。取两路幅度相等的理想情形，最大合成功率为单路功率的4倍、非相干功率和为单路功率的2倍，二者之比为2，故理想的相干增强量为3 dB。据此可给出相位误差对相干增强量的定量影响：相干增强量等于1与相位差余弦值之和的常用对数的10倍，相位差为0°时该值为3.01 dB，相位差为45°时降至约2.3 dB，相位差为90°时降至0 dB，相位差为180°时趋于完全相消；若要求相干增强量不低于2 dB，则两路之间的相位差须控制在约54°以内，若以2.5 dB作为内部目标，则相位差须控制在约39°以内。本模块5.625°的相位步进与不超过2°的RMS相位误差所对应的量化误差与器件误差之和远小于上述相位差上限，因此6 bit数控移相的分辨率足以支撑相干增强验证。

两路幅度不完全相等时，相干增强量下降的幅度较小，但相位扫描曲线的对比度会明显降低。以两路功率差0.5 dB为例，理想情况下相干增强量仅由3.01 dB降至约3.00 dB，而合成功率的最大值与最小值之比由无穷大降至约30.8 dB；以两路功率差6 dB为例，相干增强量降至约2.56 dB，最大值与最小值之比进一步降至约9.6 dB。对比度下降会使相位扫描曲线的峰值变钝、最优码值的判定精度降低，因此测试时仍须按第5.6.2节的方法将两路功率差控制在0.5 dB以内，并以1 dB作为初步调试上限。

实际验证中只需扫描TX2的相位码并观察目标位置处接收功率随相位呈周期变化，即可验证相干增强是否建立：接收功率最大点对应两路信号在目标位置处接近同相，最小点对应两路信号接近反相，最大点与最小点之间的功率差则反映了两路幅度匹配程度与背景噪声水平。

图2-3 分布式多端机相干增强验证系统框图

## 2.5 外挂移相支路链路预算

据XT3301Q6的技术数据手册可知，在920 MHz附近该移相器的插入损耗在−5.5 dB左右，其插入损耗随频率的变化关系如图2-4所示。

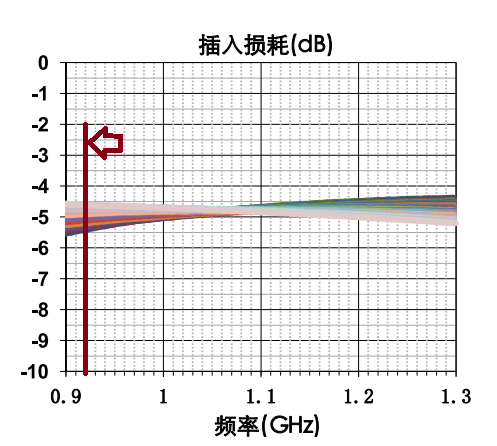
[picture p4: figure]

图2-4 XT3301Q6数控移相器插入损耗随频率的变化

外挂移相支路的插入损耗由射频移相单元、miniSMA接头与同轴线的插入损耗共同构成，其预算方法为：先按器件数据手册确定射频移相单元在工作频点的插入损耗，再按支路中接头与线缆的数量与单件损耗逐项累加，最后按连接器驻波、加工误差、不同移相码状态下的幅度波动以及器件离散性预留工程裕量。

除射频移相单元自身的插入损耗外，外挂移相支路的损耗还包括SMA接头与同轴电缆的插入损耗。

同时miniSMA接头插入损耗约为0.15dB,再结合移相器和同轴线的插入损耗，假设20cm同轴线插入损耗约为0.5dB则外挂移相支路的总插入损耗可表示为下式，其中 L_connector、L_cable、L_phase 分别为SMA接头、同轴线和移相器的插入损耗，三者损耗之和约为6.8 dB,考虑连接器驻波、加工误差、不同移相码状态下的幅度波动以及器件离散性，工程设计时建议按7～7.2dB进行预算。

L_total = L_connector + L_cable + L_phase

外挂移相支路的插入损耗预算如下表2-2所示。

表2-2 外挂移相支路插入损耗预算

损耗项 | 数量 | 单件损耗 | 小计
射频移相单元（XT3301Q6，920 MHz附近） | 1 | 约5.5 dB | 5.5 dB
miniSMA接头 | 2 | 约0.15 dB | 0.3 dB
20 cm同轴线（往返各1根） | 2 | 约0.5 dB | 1.0 dB
合计 | — | — | 约6.8 dB
工程预算值（含驻波、加工误差、移相码间幅度波动与器件离散性裕量） | — | — | 7.0～7.2 dB

由表2-2可知，外挂移相支路的插入损耗合计约6.8 dB，考虑连接器驻波、加工误差、不同移相码状态下的幅度波动以及器件离散性，工程设计时建议按7.0～7.2 dB进行预算。该预算值用于确定相干增强验证时两路发射功率的补偿方式：TX2支路因插入移相模块而多出约6.8 dB的损耗，须通过端机的发射功率配置或外接衰减器的调节，使两路到达目标位置处的功率差控制在0.5 dB以内，否则TX1与TX2之间的幅度不平衡会使相位扫描曲线的峰值变钝、降低最优码值的判定精度。

# 三、6bits射频移相器模块硬件电路设计与主要器件选型

## 3.1 主要器件选型

### 3.1.1 XT3301Q6射频移相单元

XT3301Q6是本模块的射频核心，其射频输入和输出均按50 Ω设计，采用GaAs PHEMT工艺，主要技术参数如下表3-1所示。

表3-1 XT3301Q6射频移相单元主要技术参数

参数 | 指标
器件型号 | XT3301Q6
工艺 | GaAs PHEMT
工作频率 | 0.9～1.3 GHz
相位位数 | 6 bit
理论相位步进 | 5.625°
典型插入损耗 | 约 5 dB
RMS 相位误差 | ≤2°
典型输入 P1dB | 约 +23 dBm
工程建议输入上限 | ≤+18 dBm，预留压缩余量
控制电平 | 0 V / +5 V
负电源 | VEE=−5 V
射频端口 | RFIN、RFOUT，50 Ω
封装 | QFN 6 mm×6 mm，底部大焊盘接地


图3-1 XT3301Q6射频移相单元典型应用原理图

### 3.1.2 CS32F030C8T6主控单元

本模块主控采用芯海科技CS32F030C8T6，其作用是完成UART指令接收、相位角到控制码的换算、六位并行控制输出、电源状态读取、相位扫描状态机以及调试接口管理，主要技术参数如下表3-2所示。

表3-2 CS32F030C8T6主控单元主要技术参数

参数 | 指标
内核 | 32 位 ARM Cortex-M0
最高主频 | 48 MHz
Flash | 最高 64 KB
SRAM | 最高 8 KB
工作电压 | 2.0～5.5 V
USART | 2 路
SPI | 2 路
I²C | 2 路
ADC | 12 bit
调试接口 | SWD
推荐封装 | LQFP48（C8T6）
本模块供电 | 3.3 V

### 3.1.3 3.3V到5V控制电平转换单元

XT3301Q6的VC1～VC6按数据手册采用0/+5 V控制，因此不能继续使用主控MCU的3.3 V GPIO直接驱动。该方案使用5 V供电的AiP74LVC8T245TA24.TR，其为无锡中微爱芯的8位双电源双向电平转换收发器，具有三态输出，A、B两侧可以采用不同电源电压，因此能够用于3.3 V MCU控制5 V VC1～VC6的场景，其主要技术参数如下表3-3所示。

表3-3 AiP74LVC8T245TA24.TR电平转换单元主要技术参数

参数 | 指标
功能 | 8位双电源电平转换
A侧供电 | 3.3 V
B侧供电 | 5V
电源范围 | 1.2～5.5 V
控制方向 | A→B
数据速率 | 420 Mbps @3.3 V→5 V
输出驱动 | ±24 mA @3.0 V
静态电流 | ≤30 μA
封装 | TSSOP-24
生产厂家 | 无锡中微爱芯

### 3.1.4 负压电源单元

XT3301Q6的VEE需要−5 V，负电源模块采用圣邦微SGM3206电荷泵电压逆变器。该器件支持1.4～5.5 V输入电压，可直接由系统5 V电源供电，并通过电荷泵方式将输入正电压反相得到负电压输出，在5 V输入条件下可为XT3301Q6提供接近−5 V的负偏置电源。SGM3206最大输出电流为60 mA，高于XT3301Q6约8 mA的负电源需求，具有充足的电流裕量；其典型应用仅需配置输入电容、飞跨电容及输出电容，不需要外接功率电感，有利于降低外围器件数量、减小板级面积并简化电源布局。其主要技术参数如下表3-4所示，典型应用原理图如图3-2所示。

表3-4 SGM3206负压电源单元主要技术参数

参数 | 指标
输入范围 | 1.4～5.5 V
本方案输入 | 5 V
输出 | −5 V
最大输出电流 | 60 mA
静态电流 | 115 μA typ
典型输出阻抗 | 10 Ω
工作温度 | −40～+85 ℃
封装 | SOT-23-5
生产厂家 | 圣邦微


图3-2 SGM3206负压电源单元典型应用原理图

### 3.1.5 3.3V数字电源单元

主控等数字电路所需的3.3 V由SGM2036S-3.3低压差线性稳压器对系统5 V输入稳压后提供。该路电源与射频移相单元的−5 V负偏置、5 V控制电平电源相互独立，以减小数字电路开关噪声经电源耦合对射频移相单元相位特性的影响。

### 3.1.6 USB/UART通信与接口保护单元

本模块的USB接口使用UART-USB芯片后再使用Micro USB接口连接进行串口通信，选用CH340进行USB转UART。USB入口保护采用保险丝、瞬态电压抑制二极管（Transient Voltage Suppressor-TVS）和静电放电（Electrostatic Discharge-ESD）防护器件分工处理：功率器件负责VBUS的过流与浪涌防护，低电容ESD器件负责D+/D−的静电防护。

## 3.2 原理图设计

本模块目前处于技术方案与工作原理分析阶段，器件的具体连接关系、外围元件参数取值与原理图（Schematic）的绘制将后续采用AD25平台完成。为便于方案评审与后续设计落地，本节给出原理图的设计内容与实施步骤。

## 3.3 PCB板图设计

本模块目前处于技术方案与工作原理分析阶段，器件的具体连接关系、外围元件参数取值与PCB板图（Layout）的绘制将后续采用AD25平台完成。为便于方案评审与后续设计落地，本节给出板图的设计内容与实施步骤。

本模块的板图设计须同时满足射频走线的阻抗连续以及射频区域与数字控制走线、负压电荷泵开关噪声源之间的隔离要求。

# 四、6bits射频移相器模块加工与装配方案

## 4.1 加工方案

本模块的加工对象为印制板（Printed Circuit Board-PCB），其加工方案的确定以原理图与板图定版为前提：射频移相单元为QFN封装且底部带大焊盘，主控为LQFP封装，板面上同时存在射频走线与电荷泵开关走线，因此加工方案须在板图定版后依据实际叠层与器件封装补充具体的工艺参数。

板图定版后须补充确定并写入本节的工艺参数包括：PCB板材与层叠结构、板厚与铜厚、最小线宽/线距、0.9～1.3 GHz射频走线的50 Ω阻抗控制要求，以及结构件的加工方式与表面处理。

## 4.2 装配方案

# 五、6bits射频移相器模块功能与性能调试与测试方案

本模块的调试与测试分为两个层次：一是模块自身的供电、控制接口、射频插入损耗与相位特性测试，二是模块经端机内两只SPDT接入外挂移相支路后，在相干增强验证中的相位调控效果测试。前者以矢量网络分析仪的S参数与相位测量为主要手段，后者以目标位置处合成功率随移相码的变化规律为判据。

## 5.1 调测平台与仪器配置

### 5.1.1 测试仪器与设备清单

本模块的相位与插入损耗测量依赖矢量网络分析仪的校准精度，目标位置处合成功率验证则依赖频谱分析仪或功率计的动态范围。所有射频连接均应使用阻抗50 Ω的同轴线缆与SMA转接器，并在使用前标定线缆损耗；相位的对比测量应在同一台仪器、同一次校准与同一线缆配置下完成。所需仪器设备如下表5-1所示。

表5-1 测试仪器与设备清单

序号 | 仪器 / 设备名称 | 主要技术要求 | 用途
1 | 矢量网络分析仪 | 频率范围覆盖0.9～1.3GHz，具备相位与S参数测量能力 | 插入损耗、回波损耗与64码相位标定
2 | 频谱分析仪 | 频率范围覆盖922.5MHz，动态范围满足测量需求 | 目标点合成功率监测与相干增强验证
3 | 射频模拟信号源 | 频率覆盖922.5MHz，输出功率可调 | 提供测试载波与线性度测试激励
4 | 数字示波器 | 带宽不低于1GHz，具备外部触发 | 控制时序验证、上电时序与包络观测
5 | 可编程直流稳压电源 | 具备电压与电流读数 | 模块5V供电与电流测量
6 | 可编程衰减器 | 衰减范围覆盖测试需求，步进可编程 | 调节目标点两路功率以匹配幅度
7 | 上位机与USB转UART模块 | 支持串口指令下发与状态回读 | 相位码写入、相位扫描与状态读取

### 5.1.2 被测模块与测试连接关系

被测模块为6bits数控射频移相器模块样机，由直流5 V供电，射频输入与输出均为SMA端口，控制接口以UART为主。测量模块自身的插入损耗与相位特性时，RFIN接矢量网络分析仪端口1、RFOUT接端口2，矢量网络分析仪的校准面应延伸至模块的SMA端面，以排除测试线缆的影响；测量外挂移相支路的总插入损耗时，被测对象扩展为“端机SPDT1—miniSMA—同轴线—移相模块—同轴线—miniSMA—SPDT2”的完整支路。控制接口由上位机经USB转UART模块下发相位码。

## 5.2 供电测试

本模块的电源结构为：5 V输入一方面直接作为控制高电平与电平转换器的电源，另一方面经SGM3206电荷泵产生−5 V供XT3301Q6的VEE，经SGM2036S-3.3产生3.3 V供主控等数字电路。三路电源的建立顺序与电压数值直接关系到射频器件能否正常工作，因此需逐路测试：逐路测量其电压数值与纹波，核验−5 V先于或同时于射频信号建立，并核验负电源支路电流不超过SGM3206的60 mA输出能力、模块总功耗处于设计预算范围以内。

## 5.3 控制接口与逻辑功能测试

模块的相位调节能力由主控CS32F030C8T6通过UART接收指令、生成6bits相位控制字，经电平转换后送入XT3301Q6的VC1～VC6实现，因此控制链路的正确性是相位特性测试的前提。由上位机经USB转UART模块下发相位码设置指令，覆盖0～63的全部64个码值，逐一确认指令被正确接收与执行；验证模块能够按上位机指令完成64码的连续遍历扫描，并在扫描过程中保持状态可读、无丢码与错码；验证复位后模块回到确定的状态。该功能是后续在相干增强实验中自动搜索最优移相码的基础。

## 5.4 射频S参数与插入损耗测试

插入损耗是本模块最重要的射频指标之一。移相器典型约5 dB的插入损耗与连接器、同轴线、隔直电容的损耗共同构成外挂移相支路的总插入损耗，直接决定相干增强验证时两路发射功率能否匹配，因此需要分别测量模块自身与完整支路两个层次。在0.9～1.3 GHz频段内测量模块的S21、S11与S22，绘制插入损耗与回波损耗随频率的变化曲线，用于确认模块在全工作频段内的匹配状态与插损水平。

## 5.5 相位特性测试

相位特性是本模块的核心功能指标。移相器的相位步进为5.625°，而理论移相误差为2.8125°：若要设定任意一个目标相位值，实际只能选择64个移相码中最接近的离散档位，理论上的最大量化误差即为半个相位步进，例如相位设30°时，附近可选档位为28.125°与33.75°，选28.125°时误差为1.875°，而最坏情况发生在两个档位正中间。由于移相器内部不同相位位的插入损耗、寄生参数与工艺偏差并不完全一致，理论设定值与922.5 MHz下的实测相位之间还会存在偏差，因此在后续实测过程中不能仅依赖理论5.625°步进，而应在矢量网络分析仪上建立从控制码到实测相位的标定表。

## 5.6 端机联调验证测试

模块自身指标合格并不等于其在系统中可用。在端机技术方案中，外挂移相器通过端机内两只SPDT在直通路径与外挂路径之间二选一接入：普通两点式、三点式基站及三点式辅助基站模式选择直通路径，相干增强验证模式下由可调发射端TX2选择外挂路径，参考发射端TX1保持直通。因此联调验证需覆盖路径切换功能、外挂支路总插入损耗以及相位调控对目标位置处合成功率的实际作用。

### 5.6.1 直通路径与外挂路径切换功能测试

由端机软件控制两只SPDT，在直通路径与外挂路径之间反复切换，确认两种状态下的射频通路均能正常建立且互不串扰，切换前后端机在普通工作模式下的发射与接收功能不受影响。该测试用于验证外挂移相模块不破坏端机原有三种基础工作模式的设计意图。

### 5.6.2 64码扫描与目标位置处相干增强验证测试

两台端机共用同一个外部48MHz参考源并配置在同一射频频点，TX1作为参考发射端保持直通，TX2作为可调发射端接入外挂移相模块。测试按以下步骤进行：先分别仅开启单台端机，在同一目标接收位置处、相同测量通路与带宽下测量单路功率P₁与P₂，注意不得直接把两个dBm数值相加，计算前应换算为线性功率；再用端机的发射功率配置或外接衰减调节匹配两路功率，匹配目标为两路功率差不超过0.5 dB，1 dB作为初步调试上限；随后两路同时发射，TX1固定，TX2从码0扫描至码63，每次写码后等待控制及射频稳定再采集同长度窗口，重复不少于3轮。

# 六、6bits射频移相器模块测试及结果

本模块当前处于方案与工作原理分析阶段，尚未完成样机加工与装配，本章给出测试记录方法与记录表，待样机加工、装配和联调完成后，将每次测试的日期、地点、温湿度、样机编号、软件版本、仪器型号、线缆损耗、频点、功率、RSSI和结论填入测试报告，并附原始数据或截图。

## 6.1 测试记录表

表中空白处为实测填写区，测试时应同时保存仪器截图或原始数据文件，不得以设计值或理论值代替实测记录。

表6-1 供电与静态工作点测试记录表（待测）

测试项目 | 设计要求 / 判据 | 实测值 | 结论 | 备注
5V输入电压 | 标称5V
−5V负电源电压 | 供XT3301Q6的VEE
3.3V数字电源电压 | 供主控等数字电路
负电源支路电流 | 不超过SGM3206的60mA输出能力
模块总功耗 | 在设计预算范围内
上电时序 | −5V先于或同时于射频信号建立

表6-2 插入损耗与S参数测试记录表（待测）

频点 | 插入损耗（dB） | 输入回波损耗（dB） | 输出回波损耗（dB）
922.5MHz
… | … | — | —

表6-3 64码相位标定测试记录表（待测，922.5 MHz）

相位码 | 标称相位（°） | 实测相位（°） | 相位误差（°） | 插入损耗（dB） | 备注
0 | 0
1 | 5.625
2 | 11.25
3 | 16.875
… | … | … | … | … | …

## 6.2 测试结论

本节用于给出模块是否达到技术指标要求的结论。当前阶段尚未完成样机加工与装配，各项测试数据待样机联调完成后填入上述记录表并据此形成结论。结论中应明确受测样机编号、测试日期、测试地点、仪器型号与校准状态，并对未达标项给出原因定位与下一轮改进措施。

# 七、总结

本模块面向FTTx与超高频RFID融合无源物联系统的相干增强验证需求，研制了一款6bits数控射频移相器模块。模块以GaAs PHEMT工艺的XT3301Q6为射频移相单元，在0.9～1.3 GHz频段内提供0°～360°、5.625°步进的数控相移；以CS32F030C8T6为主控单元，通过UART接收指令并生成6bits相位控制字；控制字经AiP74LVC8T245完成3.3 V到5 V电平转换后送入XT3301Q6的VC1～VC6；5 V输入经SGM3206电荷泵产生−5 V负偏置、经SGM2036S-3.3产生3.3 V数字电源。

模块不固定串接于端机的公共发射链路，而是通过端机内两只SPDT在直通路径与外挂移相路径之间二选一接入：普通两点式、三点式基站及三点式辅助基站模式选择直通路径，相干增强验证模式下由可调发射端TX2选择外挂路径，参考发射端TX1保持直通以建立固定相位参考。这样既不破坏端机原有的三种基础工作模式，也避免移相器约5 dB的插入损耗长期叠加在普通发射链路上，同时便于对移相模块本身进行独立测试。

本数控射频移相器模块围绕端机的分布式相干增强验证任务重新定义了系统边界和硬件实现方式。模块不改变端机已有的普通读写模式，而是作为TX2的外挂相位可调路径，通过端机SPDT选择接入；其核心目标是提供可重复、可标定、可扫描的64级相位控制。两台端机在共用48MHz同源参考的条件下扫描TX2的相位码，观察目标位置处接收功率的周期性变化与增强峰值，即可完成分布式相干增强的关键验证。

本模块目前处于技术方案与工作原理分析阶段，电路原理图与PCB板图尚未绘制，加工与装配方案、样机实测数据待后续补充。

# 附件：引用的技术文献清单

1) 元器件/芯片datasheet清单

超高频无源物联可重构端机datasheet（文档名称）

2) 应用的设计开发平台文档清单
（1） Altium Designer 25
（2） Matlab2016

13 Not for use or disclosure outside CRFICS，SICE，UESTC. except under prior written agreement
