lyy622516-web/phase_shifter/6bit数控移相器模块datasheet/CH340G SOP16 USB-UART转换芯片成套资料/CH340G SOP16 USB-UART转换芯片成套资料 20260910.png

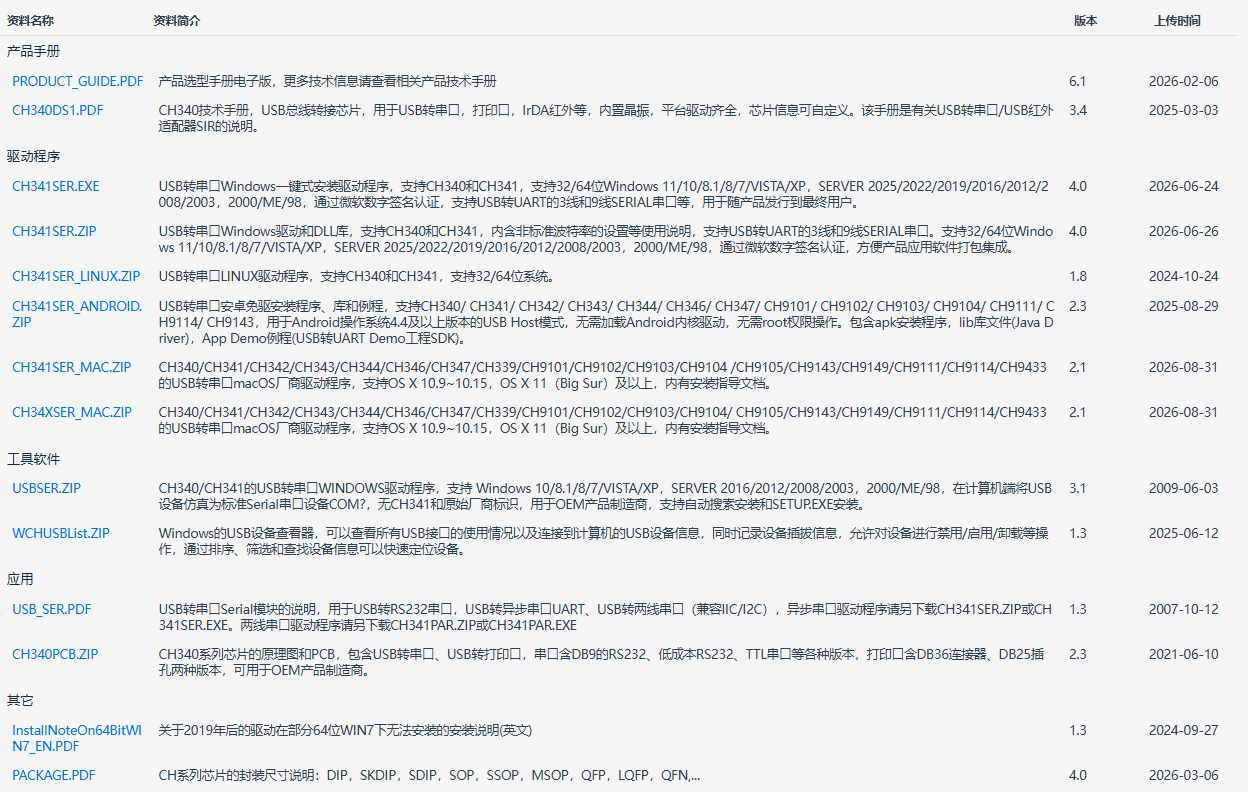
6bit数控移相器模块datasheet/CH340G SOP16 USB-UART转换芯片成套资料/CH340G SOP16 USB-UART转换芯片成套资料 20260910.png
