lyy622516-web/phase_shifter/6bit数控移相器模块datasheet/SS34 肖特基二极管 SMA DO‑214AC封装  40V3A LM27762 续流二极管 Datasheet.jpg

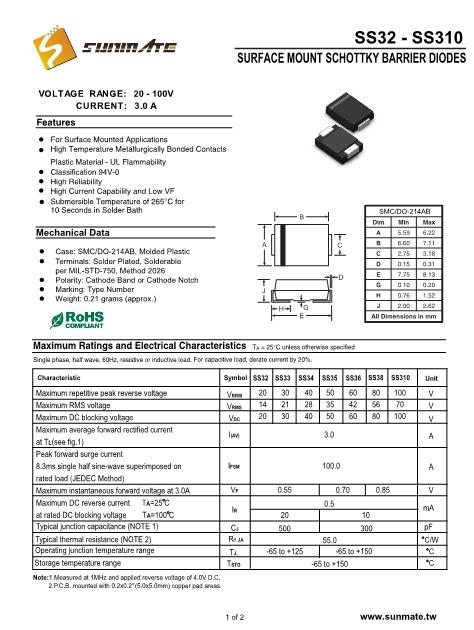
6bit数控移相器模块datasheet/SS34 肖特基二极管 SMA DO‑214AC封装 40V3A LM27762 续流二极管 Datasheet.jpg
