lyy622516-web/phase_shifter/腔体/平底板腔体/3D预览/盖板_3D.png

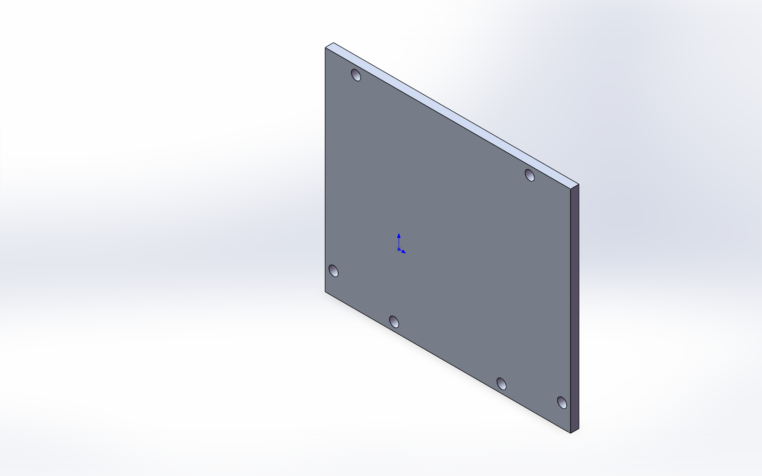
腔体/平底板腔体/3D预览/盖板_3D.png
