lyy622516-web/phase_shifter/腔体/平底板腔体/工程图/审查预览/右射频侧板_工程图.png

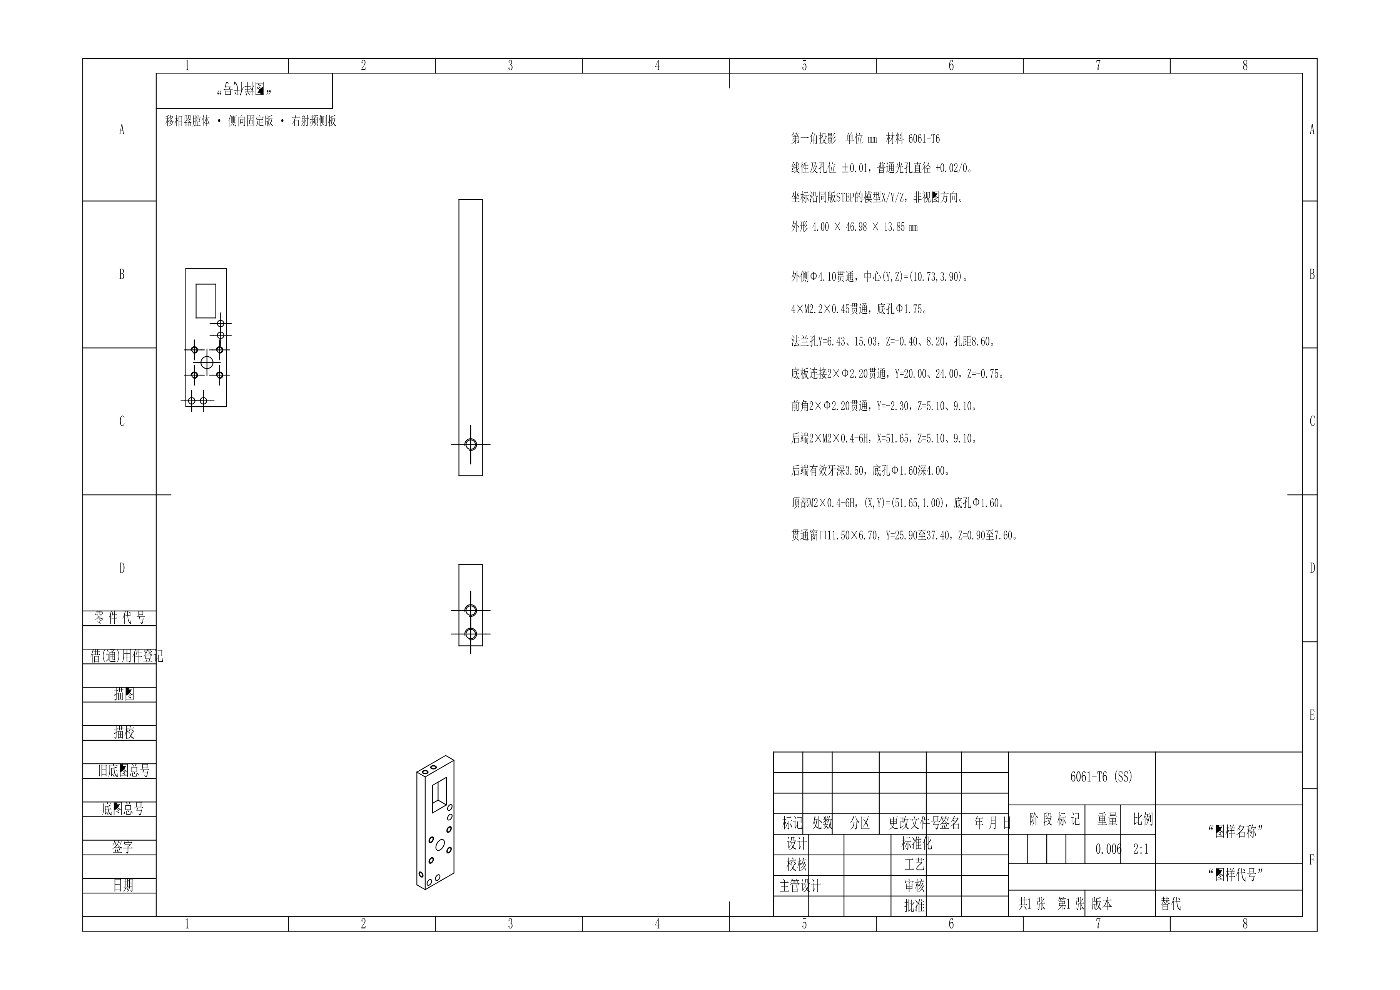
腔体/平底板腔体/工程图/审查预览/右射频侧板_工程图.png
