lyy622516-web/phase_shifter/腔体/平底板腔体/工程图/审查预览/盖板_工程图.png

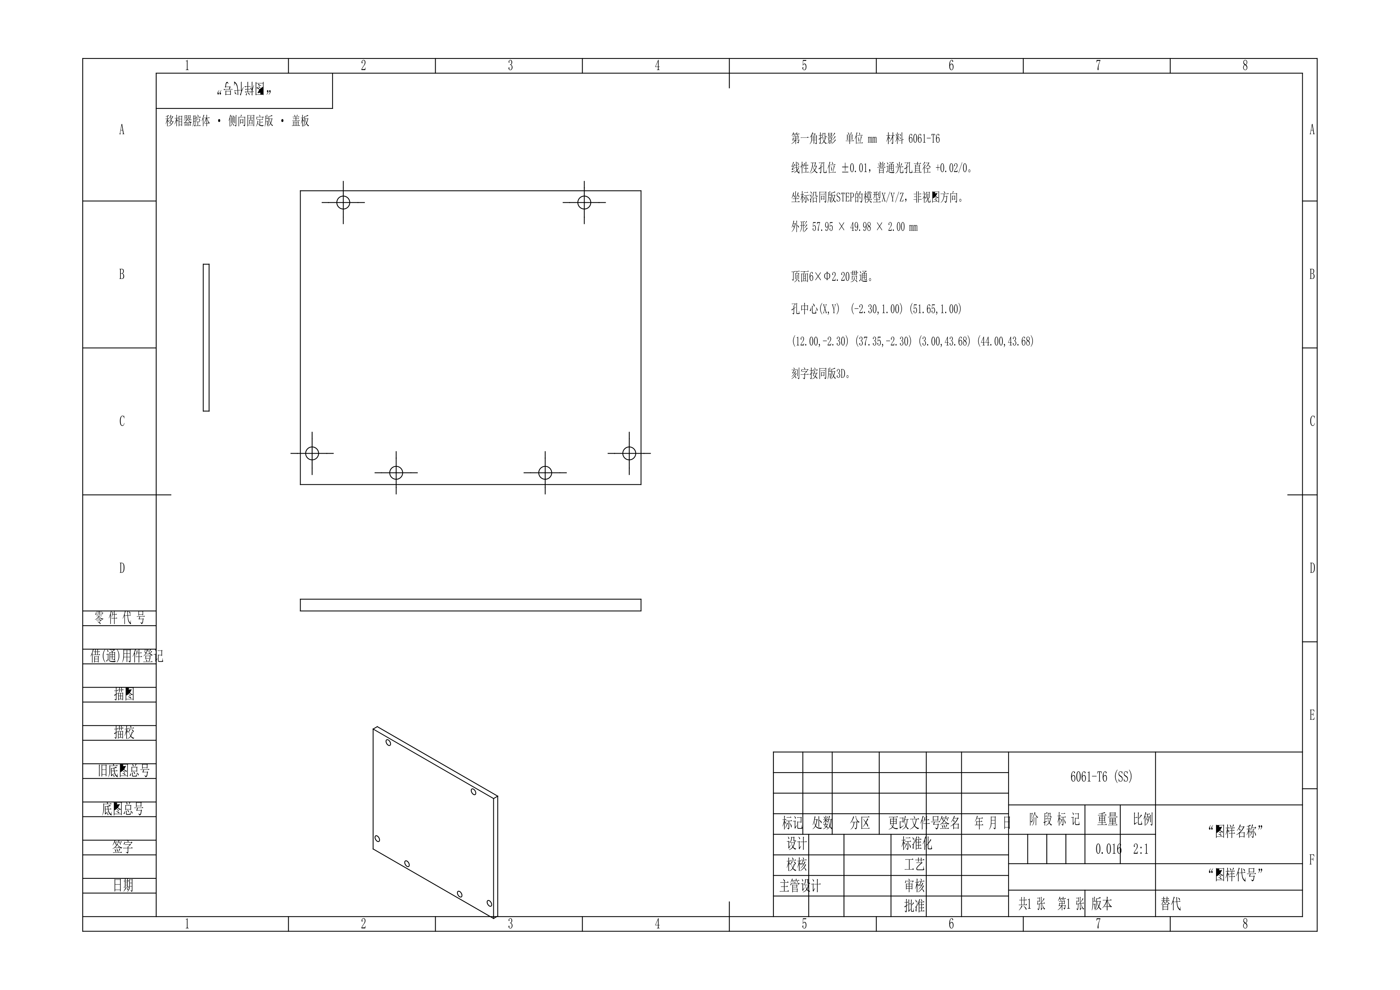
腔体/平底板腔体/工程图/审查预览/盖板_工程图.png
