lyy622516-web/phase_shifter/腔体/平底板腔体_侧向固定/移相器腔体.SLDASM

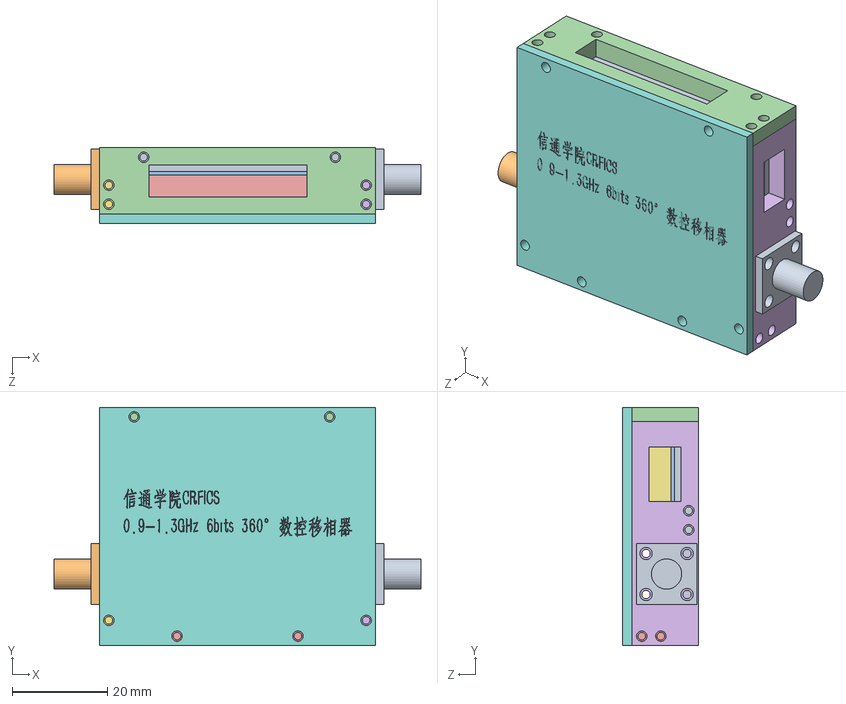
[picture p63: CAD file, 2026-11-04]
腔体/平底板腔体_侧向固定/移相器腔体.SLDASM
77.0 x 50.0 x 15.9 mm
底板
盖板
左射频侧板
右射频侧板
前侧板
后接口侧板
PCB参考
SMA左
SMA右
