lyy622516-web/phase_shifter/腔体/3D_PHASE_SHIFTER_2026-10-27.step

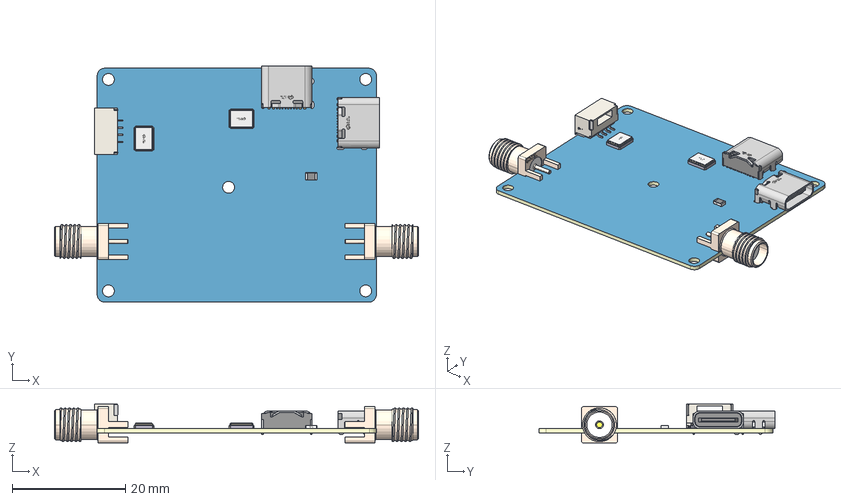
[picture p64: CAD file, 2026-10-31]
腔体/3D_PHASE_SHIFTER_2026-10-27.step
64.3 x 41.7 x 6.85 mm
Board~u1Mw
TopCopper~u1Mw
BottomCopper~u1Mw
TopSilkscreen~u1Mw
BottomSilkscreen~u1Mw
TopFpcStiffener~u1Mw
BottomFpcStiffener~u1Mw
CRYSTAL-SMD_4P-L3.2-W2.5-BL~CRYSTAL-SMD_4P-L3.2-W2.5-BL~u1Mw x 2
SMA-SMD_BWSMA-KE-P001~SMA-SMD_SMA-KHDC10~u1Mw x 2
TYPEC_16PIN~TYPE-C-SMD_TYPE-C-16PIN-L7.35~u1Mw x 2
J4_1.25~CONN-SMD_4P-P1.25_XUNPU_WAFER-GH1.25-4PWB~u1Mw
0805~R0805贴片电阻~u1Mw
