lyy622516-web/phase_shifter/腔体/平底板腔体/后接口侧板.step

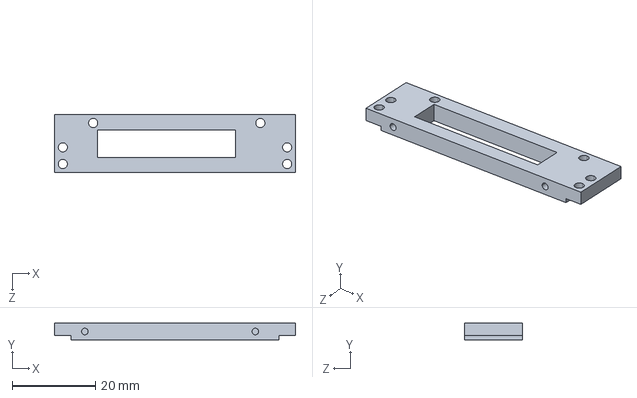
[picture p65: CAD file, 2026-11-04]
腔体/平底板腔体/后接口侧板.step
58.0 x 4.00 x 13.9 mm
