lyy622516-web/phase_shifter/腔体/平底板腔体/工程图/盖板_工程图.dxf

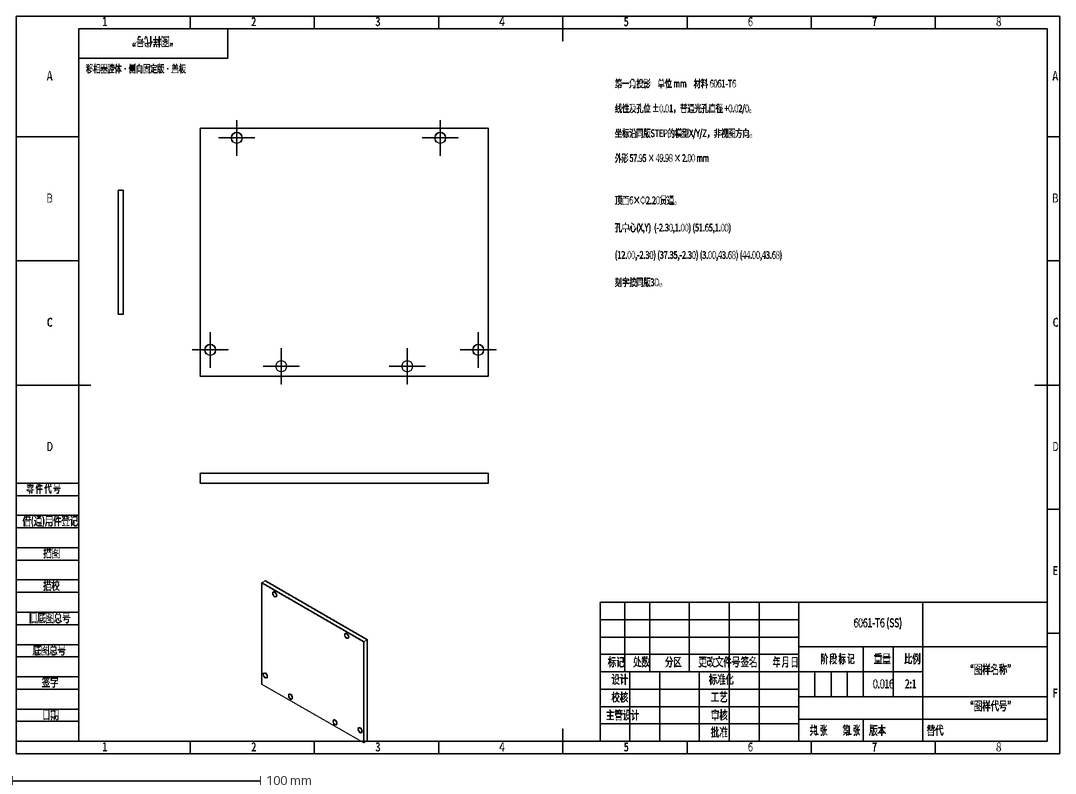
[picture p66: CAD file, 2026-11-04]
腔体/平底板腔体/工程图/盖板_工程图.dxf
移相器腔体 · 侧向固定版 · 盖板
第一角投影 单位 mm 材料 6061-T6
线性及孔位 ±0.01，普通光孔直径 +0.02/0。
坐标沿同版STEP的模型X/Y/Z，非视图方向。
外形 57.95 × 49.98 × 2.00 mm
顶面6×Φ2.20贯通。
孔中心(X,Y) (-2.30,1.00) (51.65,1.00)
(12.00,-2.30) (37.35,-2.30) (3.00,43.68) (44.00,43.68)
刻字按同版3D。
审核
校核
设计
标记
处数
分区
更改文件号
签名
年 月 日
工艺
标准化
批准
阶 段 标 记
共 张
第 张
重量
比例
日期
签字
底图总号
旧底图总号
描校
描图
借(通)用件登记
零 件 代 号
版本
主管设计
替代
“图样代号”
2:1
1
0.016
“图样名称”
6061-T6 (SS)
2
7
6
5
4
3
8
F
E
D
C
B
A
