lyy622516-web/phase_shifter/腔体/平底板腔体_侧向固定/盖板.SLDPRT

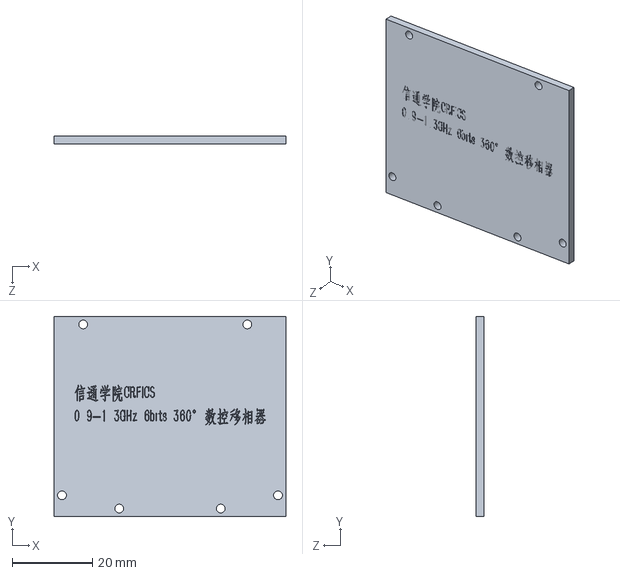
[picture p67: CAD file, 2026-11-04]
腔体/平底板腔体_侧向固定/盖板.SLDPRT
58.0 x 50.0 x 2.00 mm
