lyy622516-web/phase_shifter/腔体/源模型/SMA_四孔12.7_绝缘段4_简化.SLDPRT

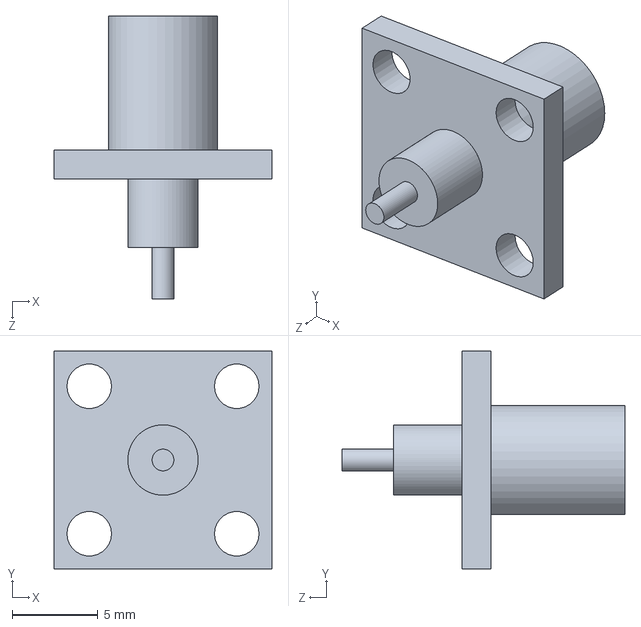
[picture p68: CAD file, 2026-11-03]
腔体/源模型/SMA_四孔12.7_绝缘段4_简化.SLDPRT
12.7 x 12.7 x 16.5 mm
