lyy622516-web/phase_shifter/腔体/平底板腔体/工程图/底板_工程图.dxf

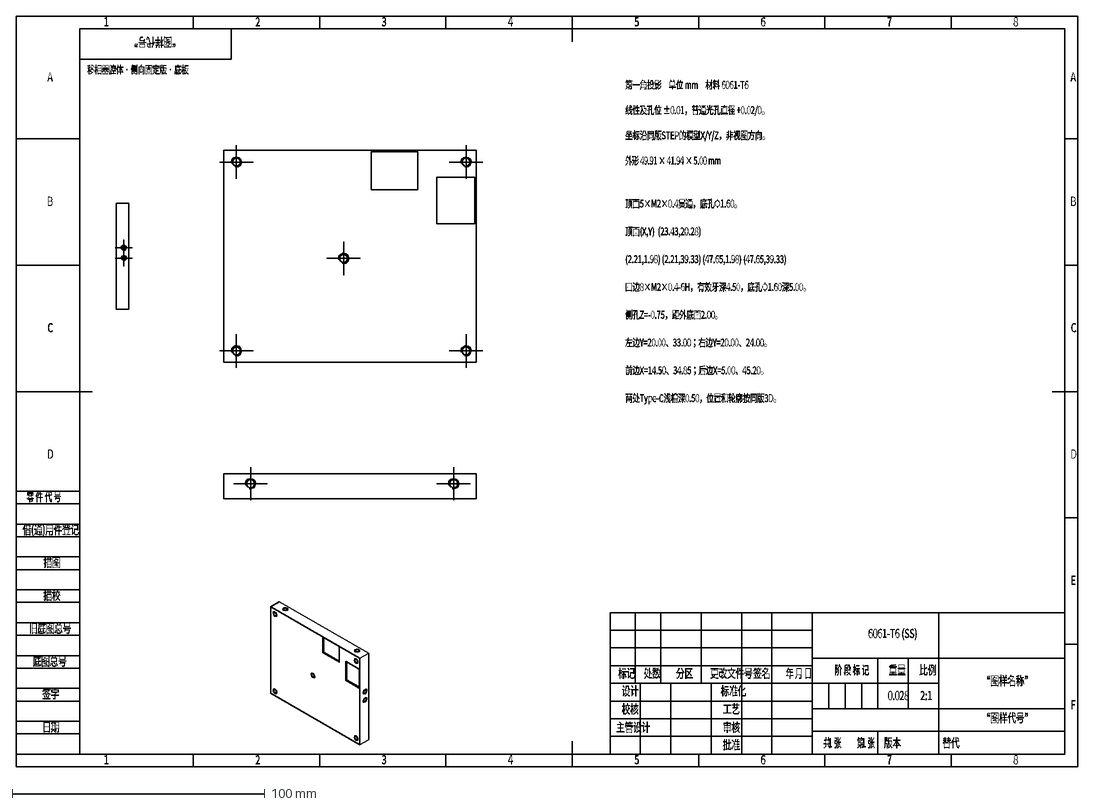
[picture p69: CAD file, 2026-11-04]
腔体/平底板腔体/工程图/底板_工程图.dxf
移相器腔体 · 侧向固定版 · 底板
第一角投影 单位 mm 材料 6061-T6
线性及孔位 ±0.01，普通光孔直径 +0.02/0。
坐标沿同版STEP的模型X/Y/Z，非视图方向。
外形 49.91 × 41.94 × 5.00 mm
顶面5×M2×0.4贯通，底孔Φ1.60。
顶面(X,Y) (23.43,20.28)
(2.21,1.98) (2.21,39.33) (47.65,1.98) (47.65,39.33)
四边8×M2×0.4-6H，有效牙深4.50，底孔Φ1.60深5.00。
侧孔Z=-0.75，距外底面2.00。
左边Y=20.00、33.00；右边Y=20.00、24.00。
前边X=14.50、34.85；后边X=5.00、45.20。
两处Type-C浅槽深0.50，位置和轮廓按同版3D。
审核
校核
设计
标记
处数
分区
更改文件号
签名
年 月 日
工艺
标准化
批准
阶 段 标 记
共 张
第 张
重量
比例
日期
签字
底图总号
旧底图总号
描校
描图
借(通)用件登记
零 件 代 号
版本
主管设计
替代
“图样代号”
2:1
1
0.028
“图样名称”
6061-T6 (SS)
2
7
6
5
4
3
8
F
E
D
C
B
A
