lyy622516-web/phase_shifter/腔体/平底板腔体/左射频侧板.step

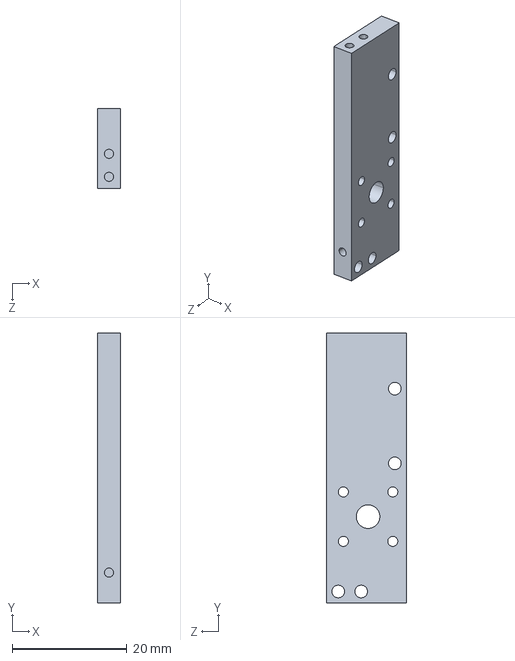
[picture p70: CAD file, 2026-11-04]
腔体/平底板腔体/左射频侧板.step
4.00 x 47.0 x 13.9 mm
