lyy622516-web/phase_shifter/腔体/平底板腔体/SMA右.step

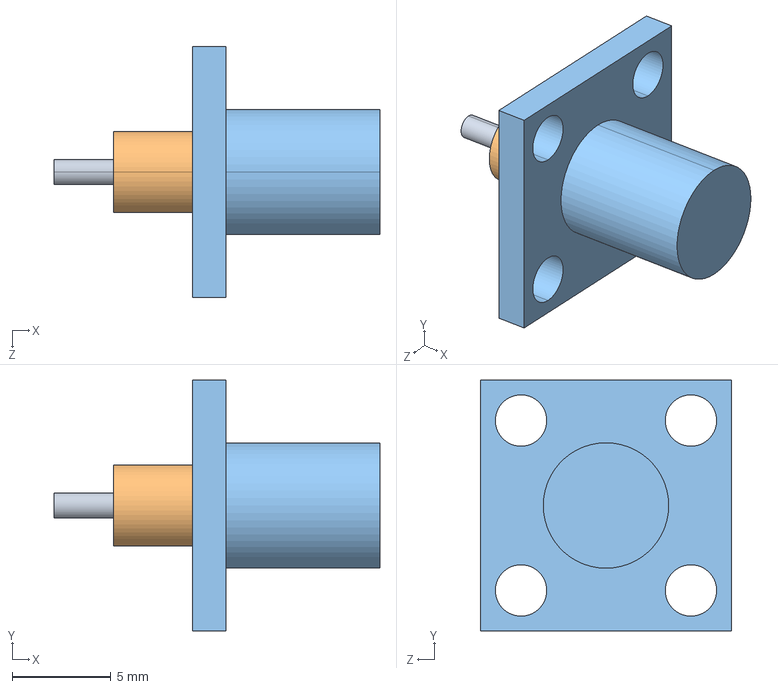
[picture p71: CAD file, 2026-11-04]
腔体/平底板腔体/SMA右.step
16.5 x 12.7 x 12.7 mm
