lyy622516-web/phase_shifter/腔体/平底板腔体_侧向固定/左射频侧板.SLDPRT

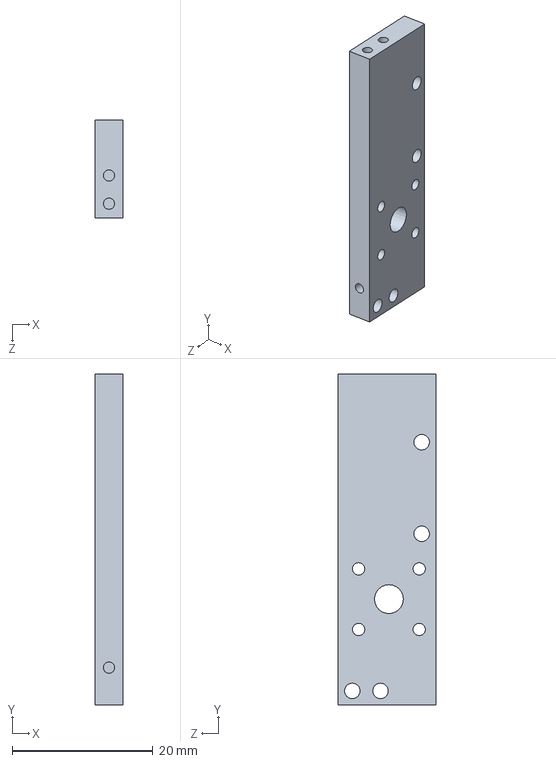
[picture p73: CAD file, 2026-11-04]
腔体/平底板腔体_侧向固定/左射频侧板.SLDPRT
4.00 x 47.0 x 13.9 mm
