lyy622516-web/phase_shifter/腔体/平底板腔体_侧向固定/前侧板.SLDPRT

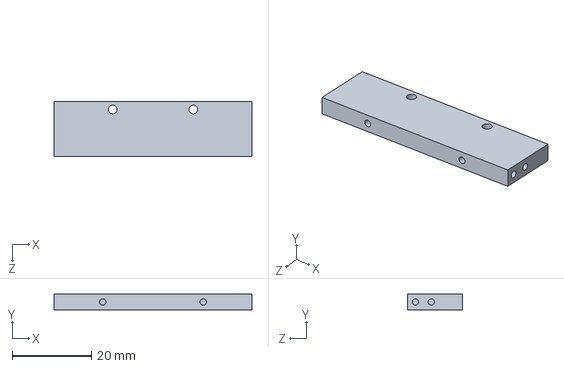
[picture p75: CAD file, 2026-11-04]
腔体/平底板腔体_侧向固定/前侧板.SLDPRT
49.9 x 4.00 x 13.9 mm
