lyy622516-web/phase_shifter/腔体/平底板腔体/PCB参考.step

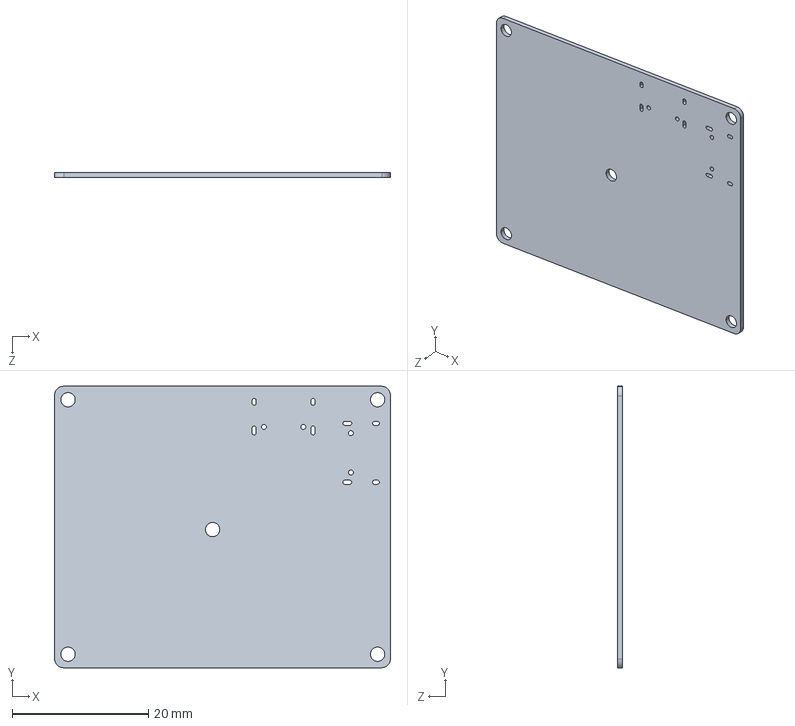
[picture p77: CAD file, 2026-11-04]
腔体/平底板腔体/PCB参考.step
49.3 x 41.3 x 0.766 mm
