lyy622516-web/phase_shifter/腔体/平底板腔体/工程图/右射频侧板_工程图.dxf

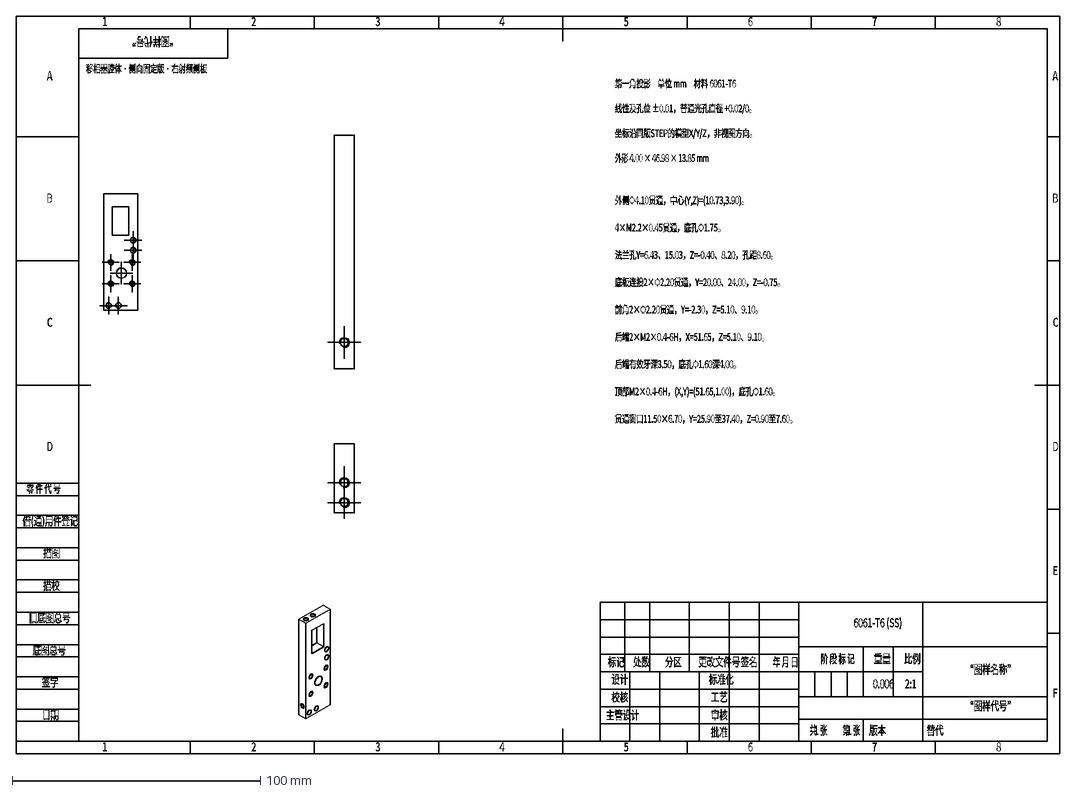
[picture p78: CAD file, 2026-11-04]
腔体/平底板腔体/工程图/右射频侧板_工程图.dxf
移相器腔体 · 侧向固定版 · 右射频侧板
第一角投影 单位 mm 材料 6061-T6
线性及孔位 ±0.01，普通光孔直径 +0.02/0。
坐标沿同版STEP的模型X/Y/Z，非视图方向。
外形 4.00 × 46.98 × 13.85 mm
外侧Φ4.10贯通，中心(Y,Z)=(10.73,3.90)。
4×M2.2×0.45贯通，底孔Φ1.75。
法兰孔Y=6.43、15.03，Z=-0.40、8.20，孔距8.60。
底板连接2×Φ2.20贯通，Y=20.00、24.00，Z=-0.75。
前角2×Φ2.20贯通，Y=-2.30，Z=5.10、9.10。
后端2×M2×0.4-6H，X=51.65，Z=5.10、9.10。
后端有效牙深3.50，底孔Φ1.60深4.00。
顶部M2×0.4-6H，(X,Y)=(51.65,1.00)，底孔Φ1.60。
贯通窗口11.50×6.70，Y=25.90至37.40，Z=0.90至7.60。
审核
校核
设计
标记
处数
分区
更改文件号
签名
年 月 日
工艺
标准化
批准
阶 段 标 记
共 张
第 张
重量
比例
日期
签字
底图总号
旧底图总号
描校
描图
借(通)用件登记
零 件 代 号
版本
主管设计
替代
“图样代号”
2:1
1
0.006
“图样名称”
6061-T6 (SS)
2
7
6
5
4
3
8
F
E
D
C
B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
