lyy622516-web/phase_shifter/腔体/平底板腔体_侧向固定/底板.SLDPRT

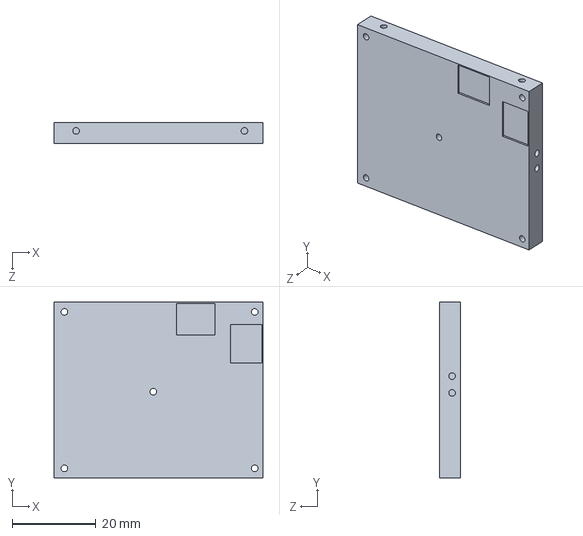
[picture p79: CAD file, 2026-11-04]
腔体/平底板腔体_侧向固定/底板.SLDPRT
49.9 x 41.9 x 5.00 mm
