lyy622516-web/phase_shifter/腔体/平底板腔体/前侧板.step

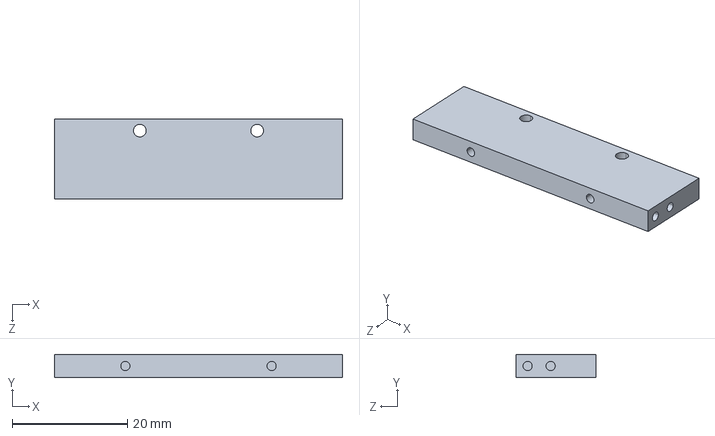
[picture p80: CAD file, 2026-11-04]
腔体/平底板腔体/前侧板.step
50.0 x 4.00 x 13.9 mm
