lyy622516-web/phase_shifter/腔体/平底板腔体/底板.step

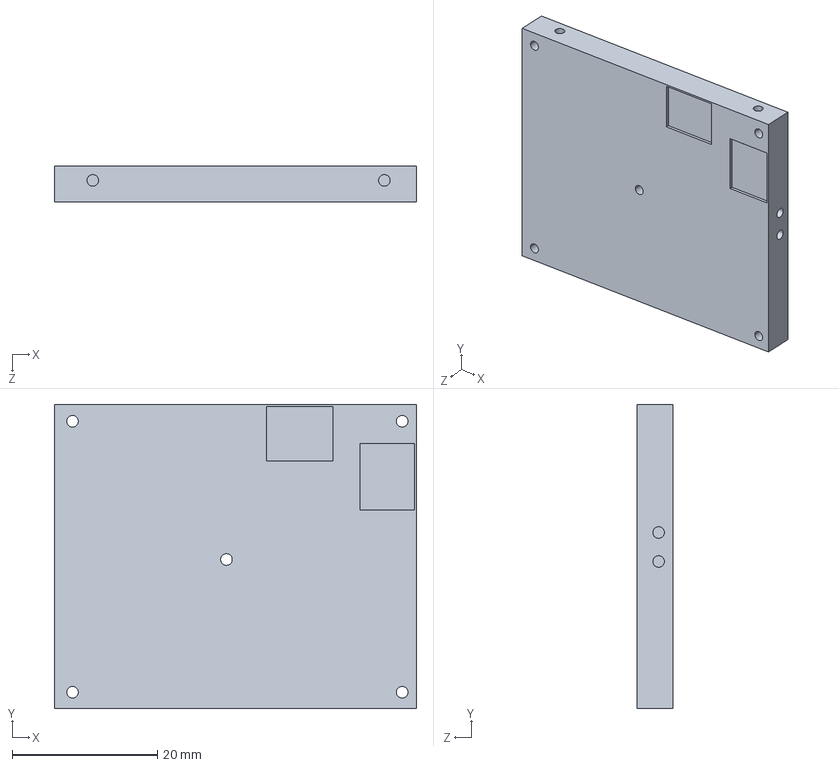
[picture p81: CAD file, 2026-11-04]
腔体/平底板腔体/底板.step
49.9 x 41.9 x 5.00 mm
