lyy622516-web/phase_shifter/腔体/源模型/电路板参考/3D_PHASE_SHIFTER_2026-10-31.step

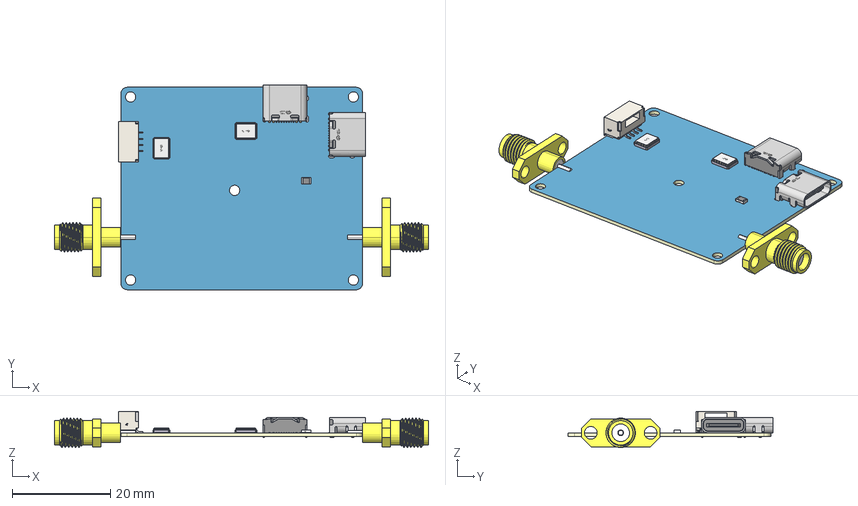
[picture p82: CAD file, 2026-10-31]
腔体/源模型/电路板参考/3D_PHASE_SHIFTER_2026-10-31.step
76.3 x 41.7 x 7.35 mm
Board~SNnK
TopCopper~SNnK
BottomCopper~SNnK
TopSilkscreen~SNnK
BottomSilkscreen~SNnK
TopFpcStiffener~SNnK
BottomFpcStiffener~SNnK
0805~R0805贴片电阻~hDe1
J4_1.25~CONN-SMD_4P-P1.25_XUNPU_WAFER-GH1.25-4PWB~PAck
CRYSTAL-SMD_4P-L3.2-W2.5-BL~CRYSTAL-SMD_4P-L3.2-W2.5-BL~fSab x 2
TYPEC_16PIN~TYPE-C-SMD_TYPE-C-16PIN-L7.35~ixpr x 2
SMA-SMD_BWSMA-KE-P001~CONN-TH_HL-SMA-KFD1011~zbNH x 2
