lyy622516-web/phase_shifter/(list of files, cad)

Other CAD files:
腔体/源模型/电路板参考/J2~TYPEC_16PIN~TYPE-C-SMD_TYPE-C-16PIN-L7.35~P95g.step.SLDASM
腔体/源模型/电路板参考/C5~0805~R0805____________~LFKa.step.SLDASM
腔体/源模型/电路板参考/U2~CRYSTAL-SMD_4P-L3.2-W2.5-BL~CRYSTAL-SMD_4P-L3.2-W2.5-BL~OQWZ.step.SLDASM
腔体/源模型/电路板参考/U10~CRYSTAL-SMD_4P-L3.2-W2.5-BL~CRYSTAL-SMD_4P-L3.2-W2.5-BL~miDO.step.SLDASM
腔体/源模型/电路板参考/J1~TYPEC_16PIN~TYPE-C-SMD_TYPE-C-16PIN-L7.35~CO1h.step.SLDASM
腔体/源模型/电路板参考/3D_PHASE_SHIFTER_2026-10-31.step.SLDASM
腔体/源模型/电路板参考/U8~J4_1.25~CONN-SMD_4P-P1.25_XUNPU_WAFER-GH1.25-4PWB~5ncf.step.SLDASM
腔体/源模型/电路板参考/RF2~SMA-SMD_BWSMA-KE-P001~CONN-TH_HL-SMA-KFD1011~BwMJ.step.SLDASM
腔体/源模型/电路板参考/RF1~SMA-SMD_BWSMA-KE-P001~CONN-TH_HL-SMA-KFD1011~wpvQ.step.SLDASM
腔体/源模型/电路板参考/Board~SNnK.step.SLDPRT
腔体/平底板腔体/右射频侧板.step
腔体/平底板腔体/SMA左.step
腔体/平底板腔体_侧向固定/后接口侧板.SLDPRT
腔体/平底板腔体/移相器腔体.step
腔体/平底板腔体_侧向固定/右射频侧板.SLDPRT
腔体/源模型/电路板参考/J4_1.25~CONN-SMD_4P-P1.25_XUNPU_WAFER-GH1.25-4PWB~PAck.step.SLDPRT
腔体/平底板腔体_侧向固定/SMA右.SLDPRT
腔体/源模型/电路板参考/TYPEC_16PIN~TYPE-C-SMD_TYPE-C-16PIN-L7.35~ixpr.step.SLDPRT
腔体/平底板腔体_侧向固定/SMA左.SLDPRT
腔体/源模型/电路板参考/CRYSTAL-SMD_4P-L3.2-W2.5-BL~CRYSTAL-SMD_4P-L3.2-W2.5-BL~fSab.step.SLDPRT
腔体/平底板腔体/盖板.step
腔体/平底板腔体_侧向固定/PCB参考.SLDPRT
腔体/源模型/电路板参考/0805~R0805____________~hDe1.step.SLDPRT
腔体/源模型/电路板参考/SMA-SMD_BWSMA-KE-P001~CONN-TH_HL-SMA-KFD1011~zbNH.step.SLDPRT
腔体/平底板腔体/工程图/前侧板_工程图.SLDDRW
腔体/平底板腔体/工程图/右射频侧板_工程图.SLDDRW
腔体/平底板腔体/工程图/后接口侧板_工程图.SLDDRW
腔体/平底板腔体/工程图/左射频侧板_工程图.SLDDRW
腔体/平底板腔体/工程图/底板_工程图.SLDDRW
腔体/平底板腔体/工程图/盖板_工程图.SLDDRW
腔体/平底板腔体/盖板.SLDPRT
腔体/平底板腔体/移相器腔体.SLDASM
腔体/平底板腔体_侧向固定/工程图/前侧板_工程图.SLDDRW
腔体/平底板腔体_侧向固定/工程图/右射频侧板_工程图.SLDDRW
腔体/平底板腔体_侧向固定/工程图/后接口侧板_工程图.SLDDRW
腔体/平底板腔体_侧向固定/工程图/左射频侧板_工程图.SLDDRW
腔体/平底板腔体_侧向固定/工程图/底板_工程图.SLDDRW
腔体/平底板腔体_侧向固定/工程图/盖板_工程图.SLDDRW
