lyy622516-web/phase_shifter/腔体/平底板腔体/工程图/前侧板_工程图.pdf

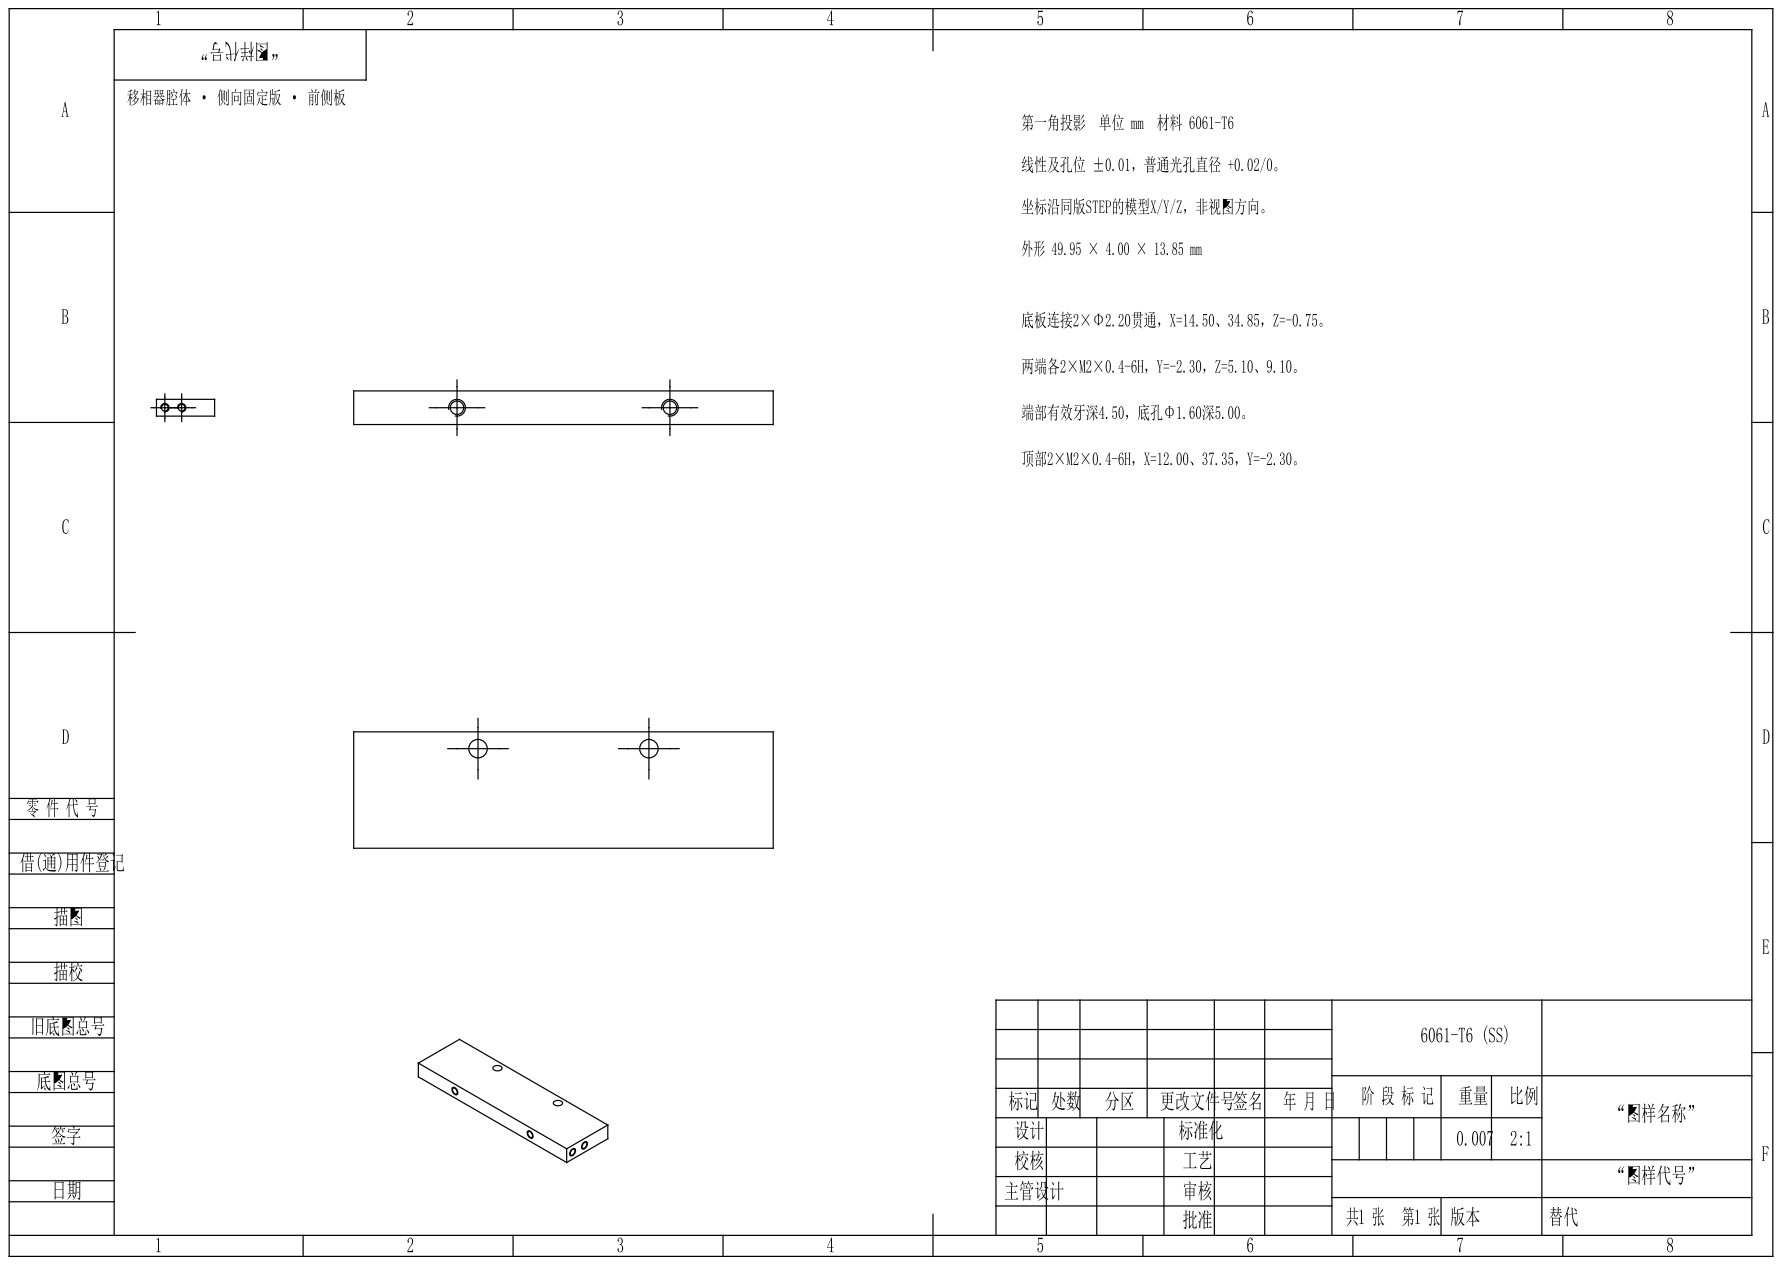
[picture p90: page 1]
