lyy622516-web/phase_shifter/腔体/平底板腔体/工程图/右射频侧板_工程图.pdf

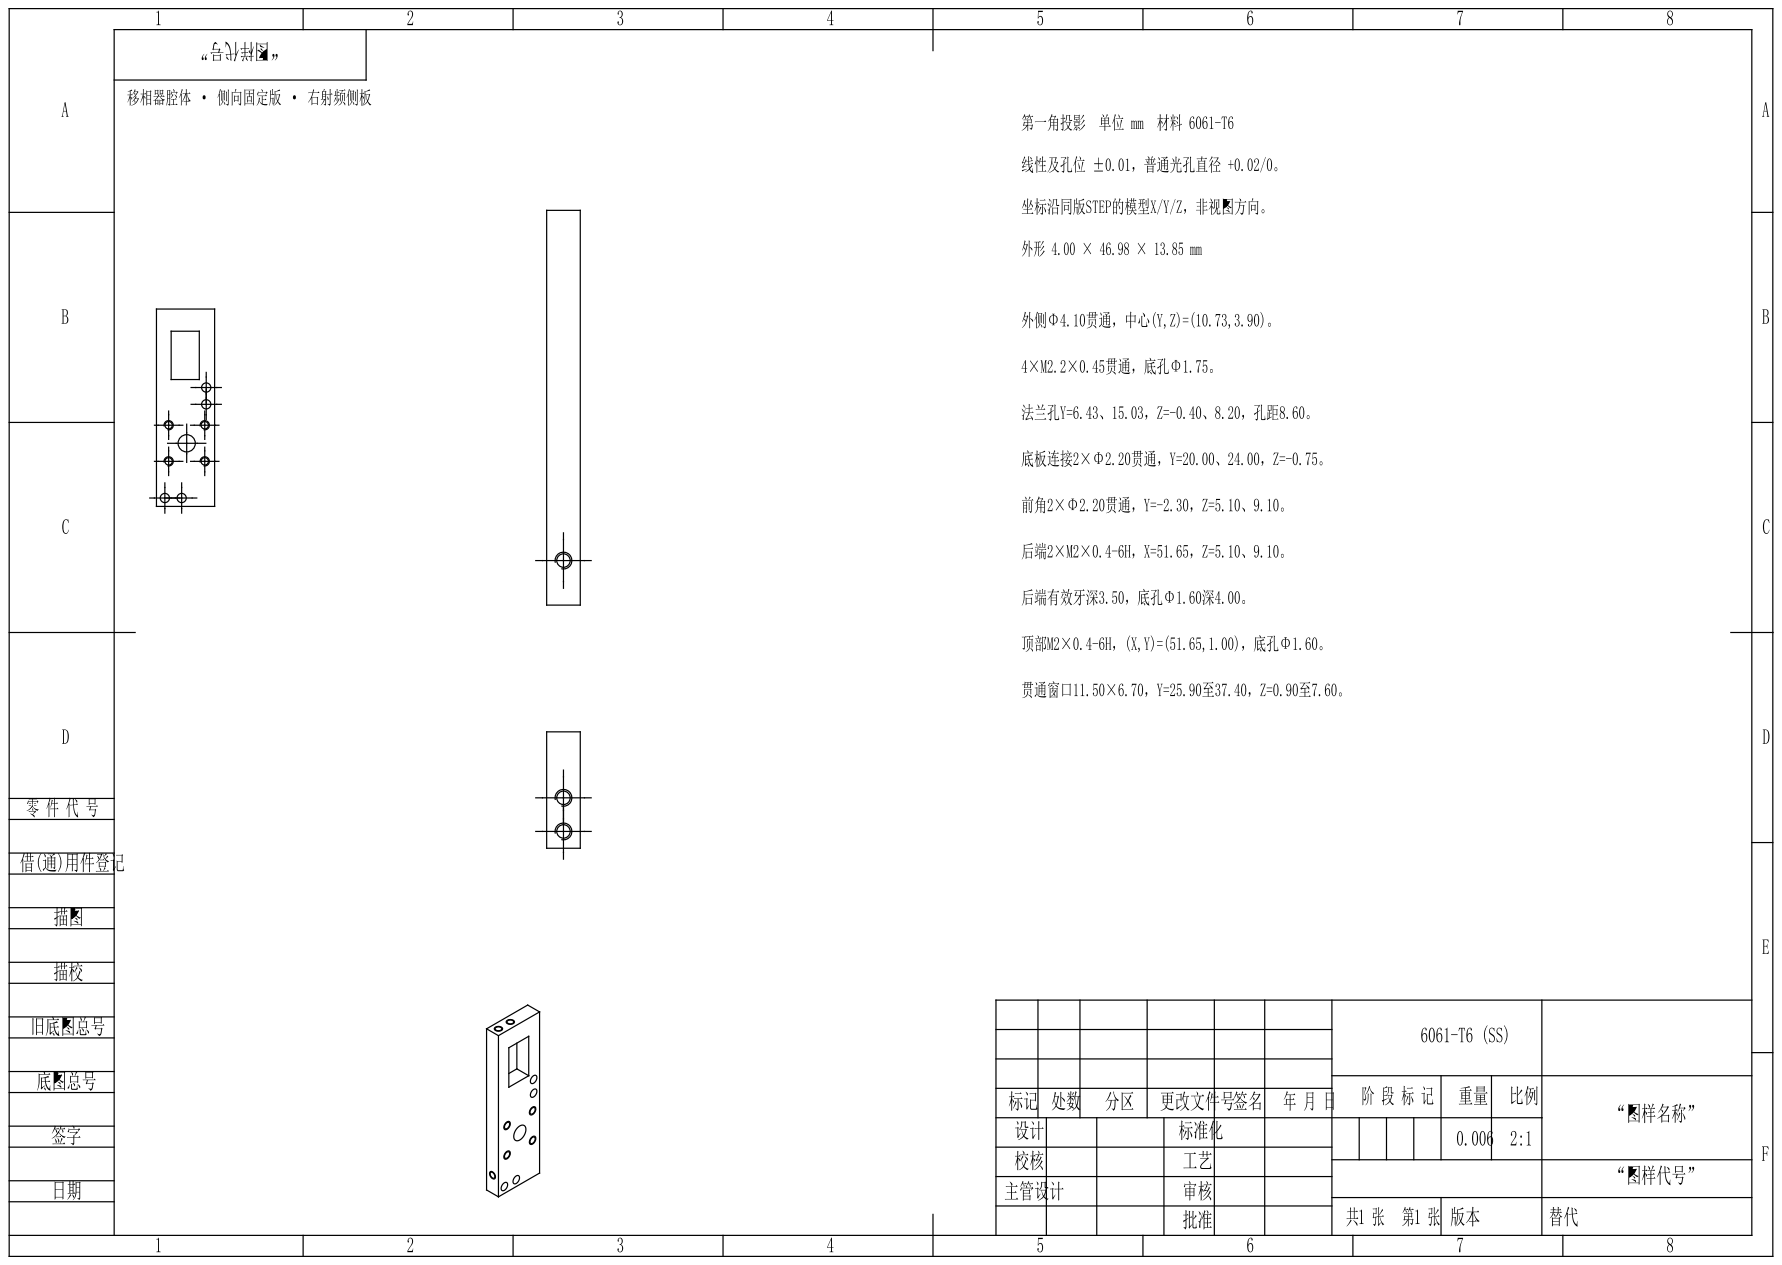
[picture p91: page 1]
