lyy622516-web/phase_shifter/腔体/平底板腔体/工程图/后接口侧板_工程图.pdf

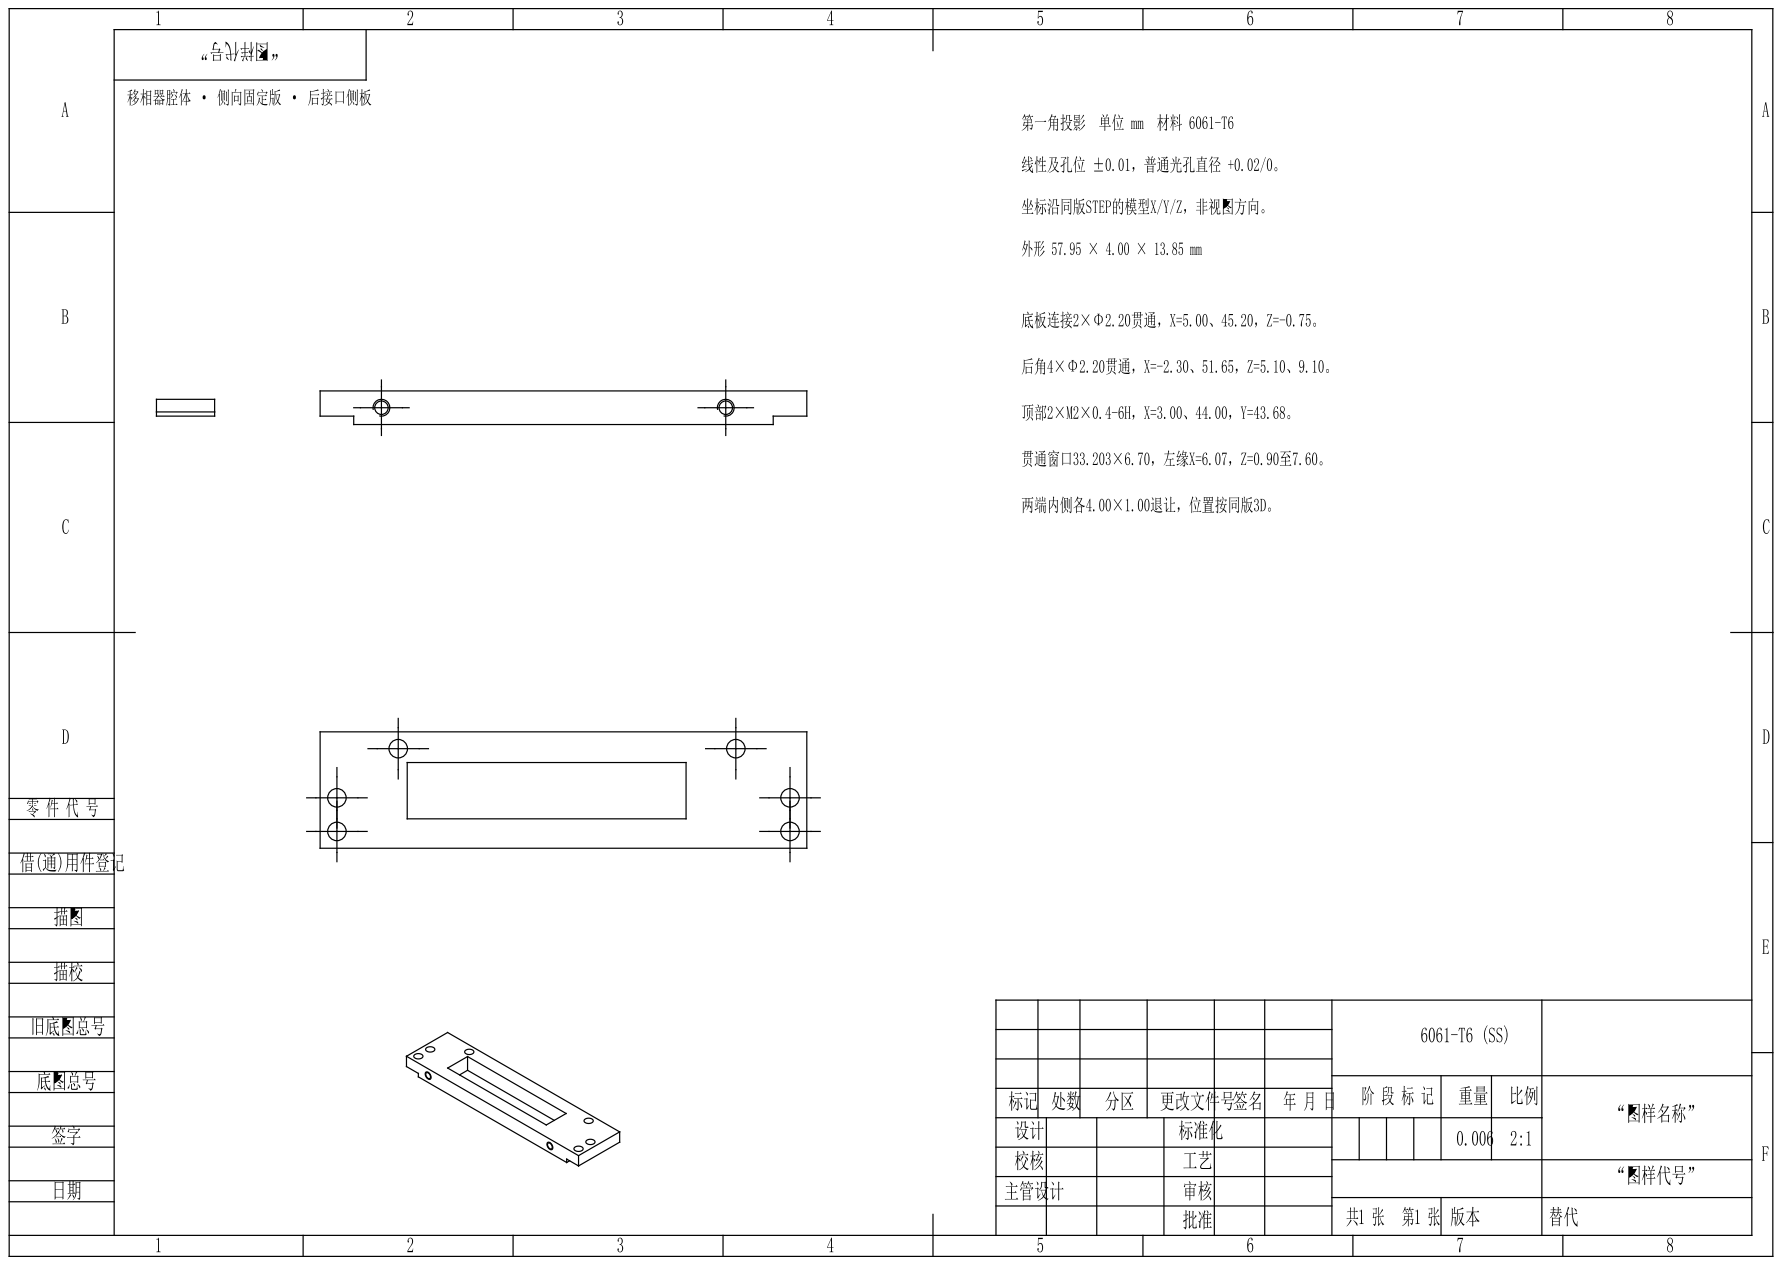
[picture p92: page 1]
