lyy622516-web/phase_shifter/腔体/平底板腔体/工程图/左射频侧板_工程图.pdf

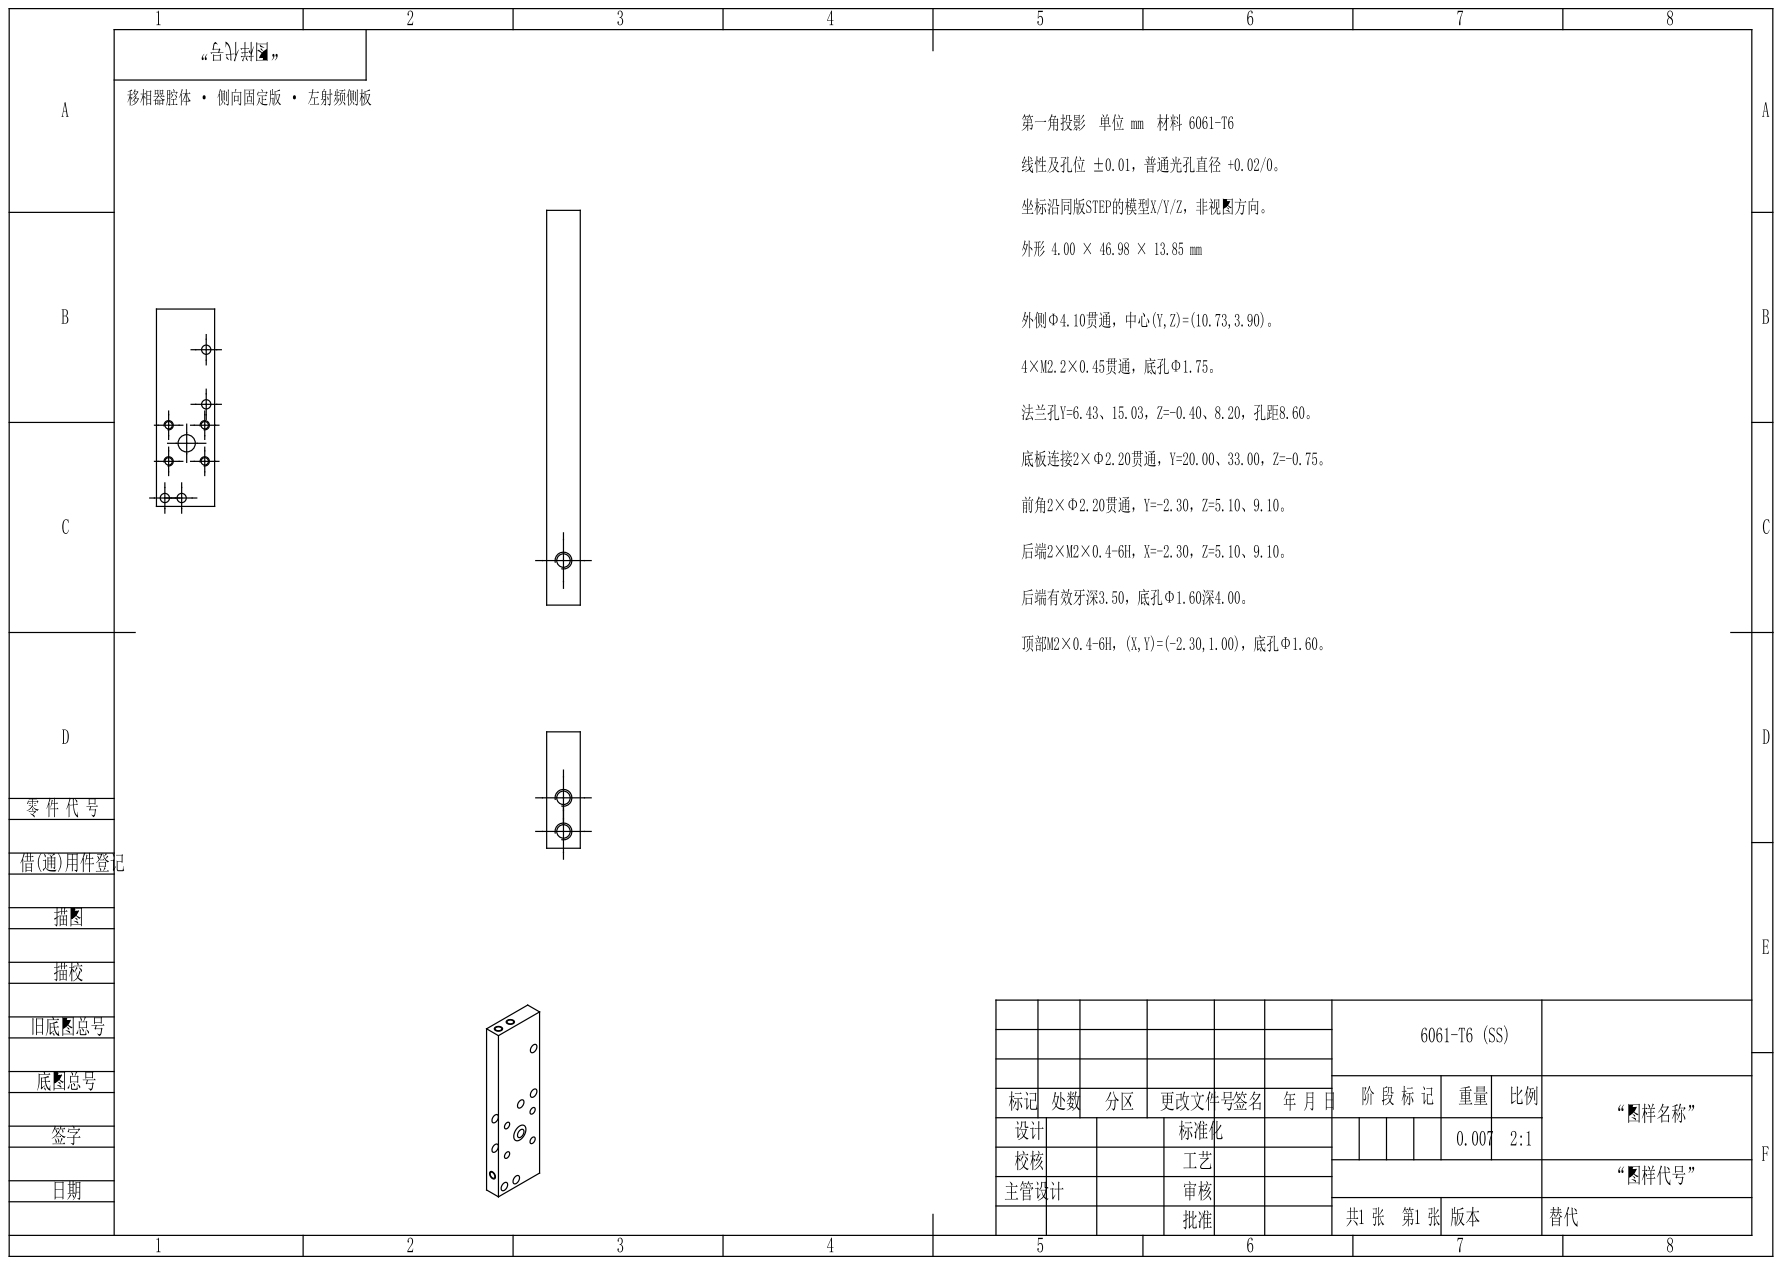
[picture p93: page 1]
