lyy622516-web/phase_shifter/腔体/平底板腔体/工程图/底板_工程图.pdf

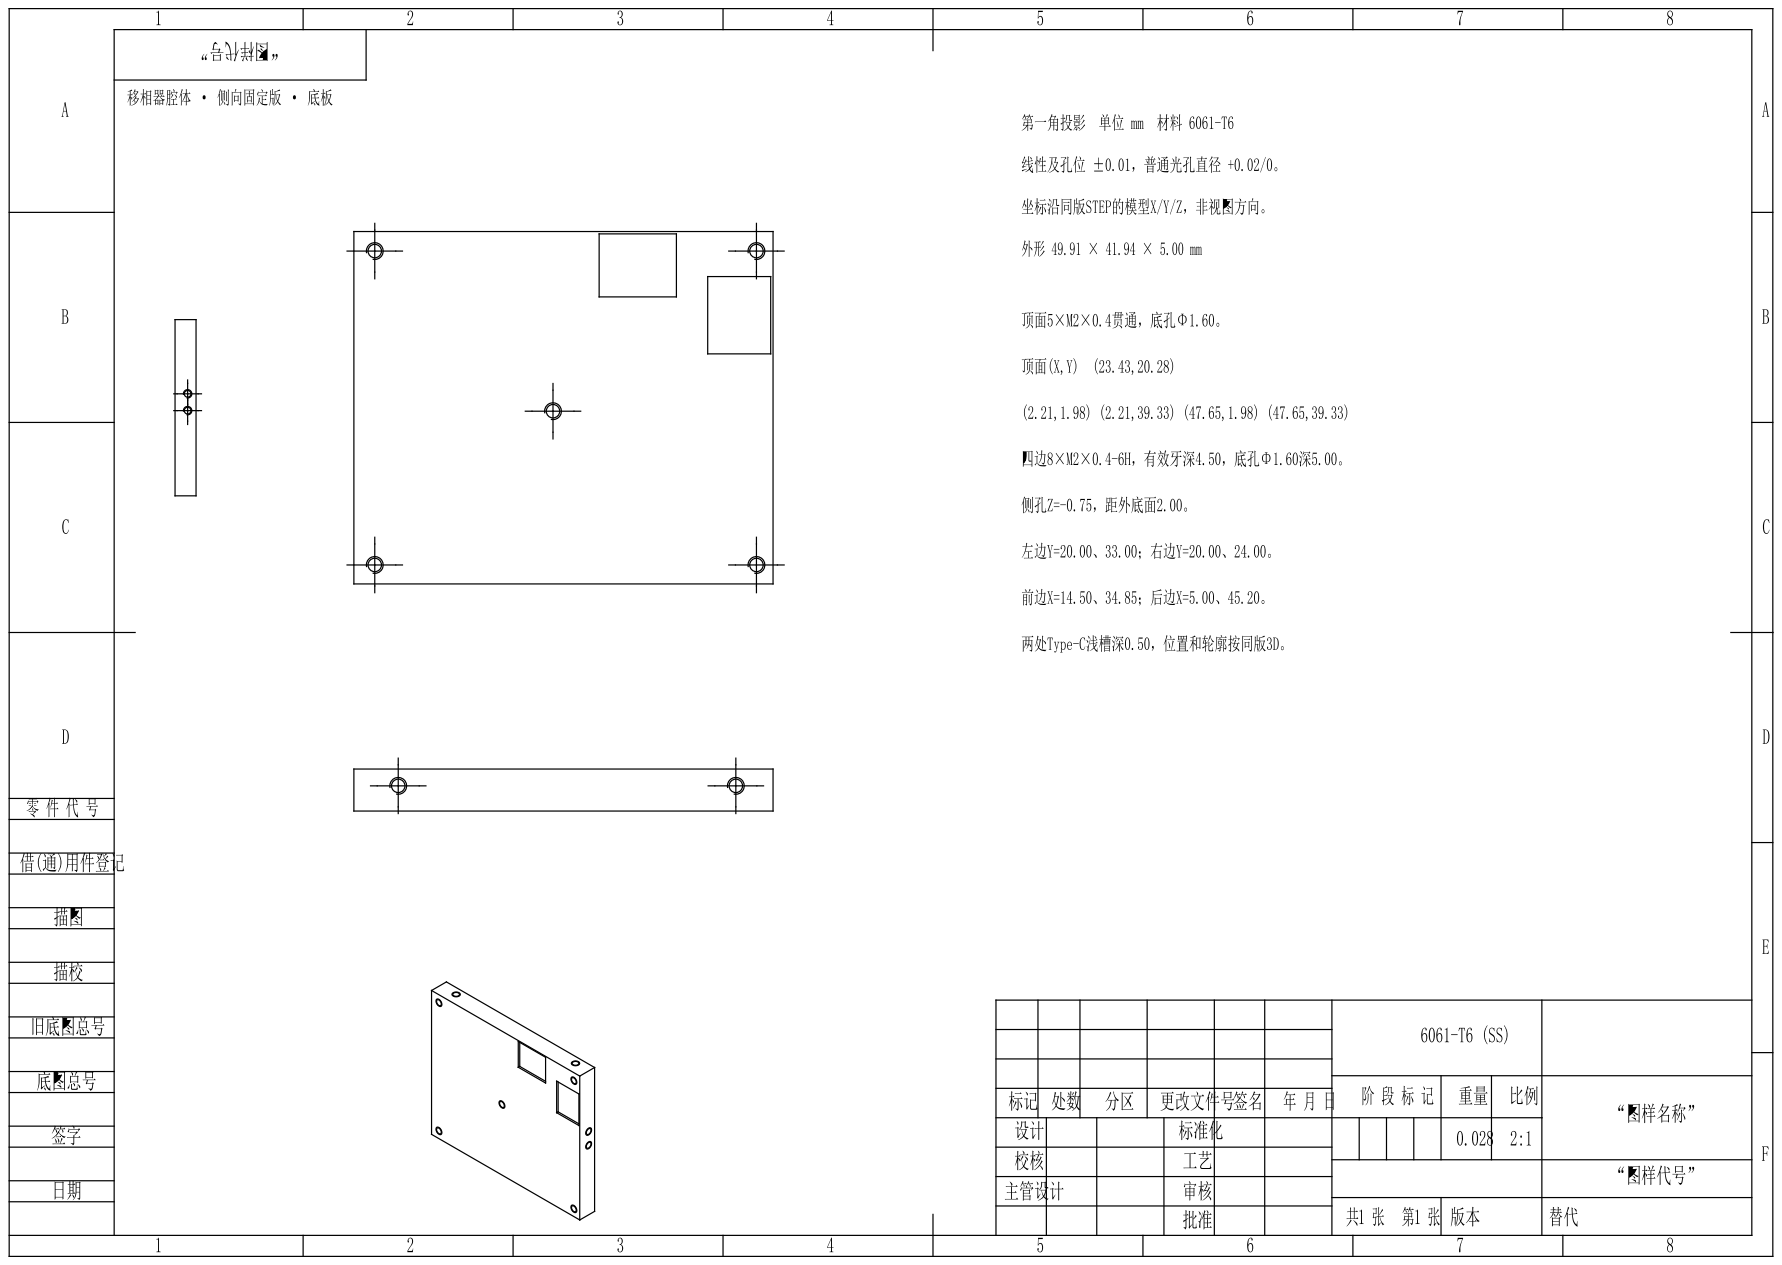
[picture p94: page 1]
