lyy622516-web/phase_shifter/腔体/平底板腔体/工程图/盖板_工程图.pdf

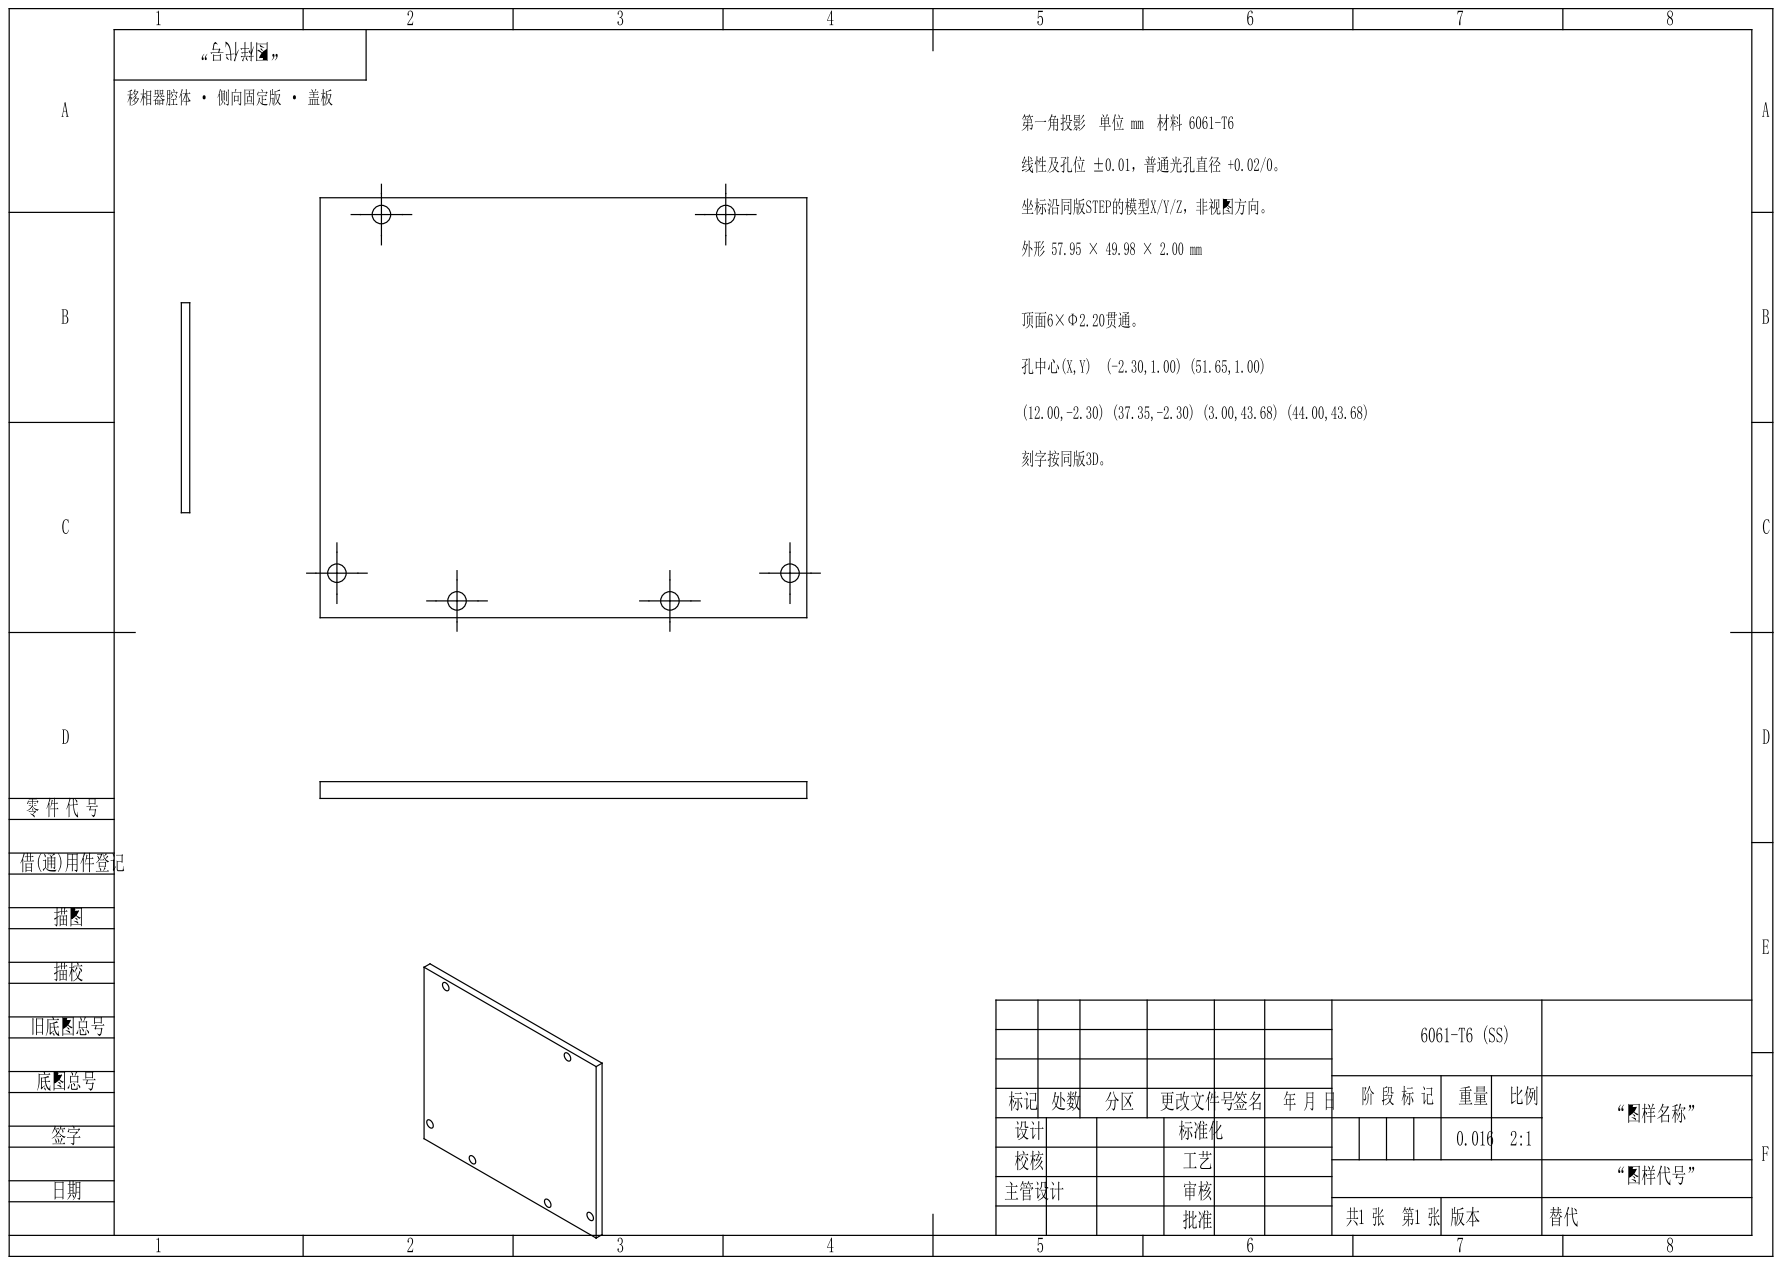
[picture p95: page 1]
