lyy622516-web/phase_shifter/(list of files, drawings)

Other design files:
0.9-1.3GHz 6bits 360° 数控移相器模块加工文档/PHASE_SHIFTER.PcbDoc
phase_shifter/BaseStation_1.SCHLIB
phase_shifter/BS_RFE_BB_20230506.PcbLib
phase_shifter/IO.SchDoc
phase_shifter/lichuang/Altium_AIP74LVC8T245TA24.TR_2026-09-30/AIP74LVC8T245TA24.TR/AIP74LVC8T245TA24.TR.pcbdoc
phase_shifter/lichuang/Altium_AIP74LVC8T245TA24.TR_2026-09-30/AIP74LVC8T245TA24.TR/AIP74LVC8T245TA24.TR.PrjPcb
phase_shifter/lichuang/Altium_AIP74LVC8T245TA24.TR_2026-09-30/AIP74LVC8T245TA24.TR/AIP74LVC8T245TA24.TR/AIP74LVC8T245TA24.TR.schdoc
phase_shifter/lichuang/Altium_B5819W_C7420330_2026-10-08/B5819W_C7420330/B5819W_C7420330.pcbdoc
phase_shifter/lichuang/Altium_B5819W_C7420330_2026-10-08/B5819W_C7420330/B5819W_C7420330.PrjPcb
phase_shifter/lichuang/Altium_B5819W_C7420330_2026-10-08/B5819W_C7420330/B5819W_C7420330/B5819W_C7420330.schdoc
phase_shifter/lichuang/Altium_BWSMA-KE-P001_2026-09-30/BWSMA-KE-P001/BWSMA-KE-P001.pcbdoc
phase_shifter/lichuang/Altium_BWSMA-KE-P001_2026-09-30/BWSMA-KE-P001/BWSMA-KE-P001.PrjPcb
phase_shifter/lichuang/Altium_BWSMA-KE-P001_2026-09-30/BWSMA-KE-P001/BWSMA-KE-P001/BWSMA-KE-P001.schdoc
phase_shifter/lichuang/Altium_CH340G_2026-09-30/CH340G/CH340G.pcbdoc
phase_shifter/lichuang/Altium_CH340G_2026-09-30/CH340G/CH340G.PrjPcb
phase_shifter/lichuang/Altium_CH340G_2026-09-30/CH340G/CH340G/CH340G.schdoc
phase_shifter/lichuang/Altium_HX PZ2.0-1X10P ZZ_2026-09-29/HX PZ2.0-1X10P ZZ/HX PZ2.0-1X10P ZZ.pcbdoc
phase_shifter/lichuang/Altium_HX PZ2.0-1X10P ZZ_2026-09-29/HX PZ2.0-1X10P ZZ/HX PZ2.0-1X10P ZZ.PrjPcb
phase_shifter/lichuang/Altium_HX PZ2.0-1X10P ZZ_2026-09-29/HX PZ2.0-1X10P ZZ/HX PZ2.0-1X10P ZZ/HX PZ2.0-1X10P ZZ.schdoc
phase_shifter/lichuang/Altium_IBSP3030ADJMS10R00_2026-09-30/IBSP3030ADJMS10R00/IBSP3030ADJMS10R00.pcbdoc
phase_shifter/lichuang/Altium_IBSP3030ADJMS10R00_2026-09-30/IBSP3030ADJMS10R00/IBSP3030ADJMS10R00.PrjPcb
phase_shifter/lichuang/Altium_IBSP3030ADJMS10R00_2026-09-30/IBSP3030ADJMS10R00/IBSP3030ADJMS10R00/IBSP3030ADJMS10R00.schdoc
phase_shifter/lichuang/Altium_LM27762DSSR_2026-09-30/LM27762DSSR/LM27762DSSR.pcbdoc
phase_shifter/lichuang/Altium_LM27762DSSR_2026-09-30/LM27762DSSR/LM27762DSSR.PrjPcb
phase_shifter/lichuang/Altium_LM27762DSSR_2026-09-30/LM27762DSSR/LM27762DSSR/LM27762DSSR.schdoc
phase_shifter/lichuang/Altium_SGM2576YN5G_TR_2026-10-08/SGM2576YN5G_TR/SGM2576YN5G_TR.pcbdoc
phase_shifter/lichuang/Altium_SGM2576YN5G_TR_2026-10-08/SGM2576YN5G_TR/SGM2576YN5G_TR.PrjPcb
phase_shifter/lichuang/Altium_SGM2576YN5G_TR_2026-10-08/SGM2576YN5G_TR/SGM2576YN5G_TR/SGM2576YN5G_TR.schdoc
phase_shifter/lichuang/Altium_TPS2116DRLR_2026-10-08/TPS2116DRLR/TPS2116DRLR.pcbdoc
phase_shifter/lichuang/Altium_TPS2116DRLR_2026-10-08/TPS2116DRLR/TPS2116DRLR.PrjPcb
phase_shifter/lichuang/Altium_TPS2116DRLR_2026-10-08/TPS2116DRLR/TPS2116DRLR/TPS2116DRLR.schdoc
phase_shifter/lichuang/Altium_TPS631000DRLR_2026-10-12/TPS631000DRLR/TPS631000DRLR.pcbdoc
phase_shifter/lichuang/Altium_TPS631000DRLR_2026-10-12/TPS631000DRLR/TPS631000DRLR.PrjPcb
phase_shifter/lichuang/Altium_TPS631000DRLR_2026-10-12/TPS631000DRLR/TPS631000DRLR/TPS631000DRLR.schdoc
phase_shifter/lichuang/Altium_TYPE-C 16PIN 2MD(073)_2026-09-28/TYPE-C 16PIN 2MD(073)/TYPE-C 16PIN 2MD(073).pcbdoc
phase_shifter/lichuang/Altium_TYPE-C 16PIN 2MD(073)_2026-09-28/TYPE-C 16PIN 2MD(073)/TYPE-C 16PIN 2MD(073).PrjPcb
phase_shifter/lichuang/Altium_TYPE-C 16PIN 2MD(073)_2026-09-28/TYPE-C 16PIN 2MD(073)/TYPE-C 16PIN 2MD(073)/TYPE-C 16PIN 2MD(073).schdoc
phase_shifter/lichuang/HDR-TH_8P-P2.00-V-M.pcbdoc
phase_shifter/lichuang/HDR-TH_10P-P2.00-V-M-1.pcbdoc
phase_shifter/lichuang/QFN-28_L6.0-W6.0-P0.65-BL-EP3.7.pcbdoc
phase_shifter/MCU.SchDoc
phase_shifter/PcbLib1.PcbLib
phase_shifter/PHASE_SHIFTER.PcbDoc
phase_shifter/phase_shifter.PrjPcb
phase_shifter/power.SchDoc
phase_shifter/RF_circuit.SchDoc
phase_shifter/SHIFTER.SchDoc
phase_shifter/shifter_V2.PcbDoc
phase_shifter/TOP.SchDoc
