lyy622516-web/phase_shifter/phase-shifter/phase-shifter/ps/src/main.c

/**
  * @file    main.c 
  * @brief   Main program body
  * @author  ChipSea MCU Group
  * @version V1.0.0
  * @date   2018.11.01         
  * @copyright CHIPSEA TECHNOLOGIES (SHENZHEN) CORP.
  * @note 
  * <h2><center>&copy; COPYRIGHT 2018 ChipSea</center></h2>
  *
  */

#include "main.h"

/**
  * @fn int main(void)
  * @brief  Main program.   MCU clock setting is  configured  through SystemInit() 
  *          in startup file (startup_cs32f0xx.s) before to enter to application main.       
  * @param  None
  * @return None
  */
int main(void)
{  
    while(1)
    {
        __asm("nop");
        __asm("nop");
        __asm("nop");
        __asm("nop");
    }
}
