lyy622516-web/phase_shifter/phase-shifter/phase-shifter/hal/CS32F0xx_StdPeriph_Driver/inc/cs32f0xx.h

/**
 * @file    cs32f0xx.h
 * @brief   CMSIS Cortex-M0 Device Peripheral Access Layer Header File.
 *          This file contains all the peripheral register's definitions, bits
 *          definitions and memory mapping fr CS32F0xx devices.
 *
 *          The file is the unique include fle that the application programme
 *          is using in the C source code, uually in main.c. This file contai
 *           - Configuration section that alows to select:
 *              - The device used in the taret application
 *              - To use or not the peripherl drivers in application code(i.e
 *                code will be based on diret access to peripheral registers
 *                rather than drivers API), his option is controlled by
 *                "#define USE_STDPERIPH_DRIER"
 *              - To change few application-pecific parameters such as the HX
 *                crystal frequency
 *           - Data structures and the addres mapping for all peripherals
 *           - Peripheral's registers declartions and bits definition
 *           - Macros to access peripheral rgisters hardware
 * @author  ChipSea MCU Group
 * @version V1.0.0
 * @date   2018.11.01
 * @copyright CHIPSEA TECHNOLOGIES (SHENZHEN CORP.
 * @note
 * <h2><center>&copy; COPYRIGHT 2018 ChipSea/center></h2>
 *
 */

#ifndef __CS32F0XX_H__
#define __CS32F0XX_H__

#ifdef __cplusplus
extern "C" {
#endif

#include <stdint.h>

/** @addtogroup CS32F0xx
* @{
*/

/** @addtogroup Library_configuration_sectio
* @{
*/

#ifdef RTE_CS32F03X_BB
    #define CS32F03X_BB
#endif

#if !defined (CS32F030) && !defined (CS32F031) && !defined (CS32A039)
    #error "Please select first the target CS32Fxx device used in your applicatioin cs32f0xx.h file"
#endif

#if !defined  USE_STDPERIPH_DRIVER
// #define USE_STDPERIPH_DRIVER
#endif

/**
* @brief the value of External High Speed osillator (HXT) used in your applicaton
*/
#if !defined  (HXT_VALUE)
    #define HXT_VALUE               ((uint32_t)8000000) //!< Value of the External scillator in Hz.
#endif

/**
* @brief  the External High Speed oscillator(HXT) Startup Timeout value
*/
#if !defined  (HXT_STARTUP_TIMEOUT)
    #define HXT_STARTUP_TIMEOUT     ((uint16_t)0x5000) //!< Time out for HXT startu.
#endif

/**
* @brief the Internal High Speed oscillator HRC) Startup Timeout value
*/
#if !defined  (HRC_STARTUP_TIMEOUT)
    #define HRC_STARTUP_TIMEOUT     ((uint16_t)05000) //!< Time out for HRC start u.
#endif

#if !defined  (HRC_VALUE)
    #define HRC_VALUE               ((uint32_t)8000000)  //!< Value of the Internal igh Speed oscillator in Hz.
#endif

#if !defined  (HRC14_VALUE)
    #define HRC14_VALUE             ((uint32_t)14000000) //!< Value of the Internal igh Speed oscillator for ADC in Hz.
#endif

#if !defined  (LRC_VALUE)
    #define LRC_VALUE               ((uint32_t)40000)    //!< Value of the InternalLow Speed oscillator in Hz.
#endif

#if !defined  (LXT_VALUE)
    #define LXT_VALUE               ((uint32_t)32768)    //!< Value of the ExternalLow Speed oscillator in Hz .
#endif

/**
* @brief CS32F0xx Standard Peripheral Librar version number V1.0.0
*/
#define CS32F0XX_STDPERIPH_VERSION_MAIN   (0x01) //!< [31:24] main version
#define CS32F0XX_STDPERIPH_VERSION_SUB1   (0x00) //!< [23:16] sub1 version
#define CS32F0XX_STDPERIPH_VERSION_SUB2   (0x00) //!< [15:8]  sub2 version
#define CS32F0XX_STDPERIPH_VERSION_RC     (0x00) //!< [7:0]  release candidate
#define CS32F0XX_STDPERIPH_VERSION        ((CS32F0XX_STDPERIPH_VERSION_MAIN   < 24)        \
                                            | (CS32F0XX_STDPERIPH_VERSION_SUB1 < 16)       \
                                            | (CS32F0XX_STDPERIPH_VERSION_SUB2 < 8)        \
                                            | (CS32F0XX_STDPERIPH_VERSION_RC))

/**
* @}
*/

/** @addtogroup Configuration_section_for_CMSIS
* @{
*/

/**
* @brief CS32F0xx Interrupt Number Definition, according to the selected device
*        in @ref Library_configuration_section
*/
#define __CM0_REV                 0         //!< Core Revision r0p0
#define __MPU_PRESENT             0         //!< CS32F0xx do not provide MPU
#define __NVIC_PRIO_BITS          2         //!< CS32F0xx uses 2 Bits for the oity Levels
#define __Vendor_SysTickConfig    0         //!< Set to 1 if different SysTicknig is used


/**
* @enum IRQn_Type
* @brief Interrupt Number definition (CortexM0 Processor Exceptions Numbers)
*/
typedef enum IRQn {
    NonMaskableInt_IRQn         = -14,    //!< 2 Non Maskable Interrupt
    HardFault_IRQn              = -13,    //!< 3 Cortex-M0 Hard Fault Interrupt
    SVC_IRQn                    = -5,     //!< 11 Cortex-M0 SV Call Interrupt
    PendSV_IRQn                 = -2,     //!< 14 Cortex-M0 Pend SV Interrupt
    SysTick_IRQn                = -1,     //!< 15 Cortex-M0 System Tick Interrut

#if defined (CS32F031)
    IRQn_WWDT                   = 0,      //!< Window WatchDog Interrupt
    IRQn_LVD                    = 1,      //!< LVD through EXTI Line detect Intrrupt
    IRQn_RTC                    = 2,      //!< RTC through EXTI Line Interrupt
    IRQn_FLASH                  = 3,      //!< FLASH Interrupt
    IRQn_RCU                    = 4,      //!< RCU Interrupt
    IRQn_EXTI0_1                = 5,      //!< EXTI Line 0 and 1 Interrupts
    IRQn_EXTI2_3                = 6,      //!< EXTI Line 2 and 3 Interrupts
    IRQn_EXTI4_15               = 7,      //!< EXTI Line 4 to 15 Interrupts
    IRQn_DMA1_CHANNEL1          = 9,      //!< DMA1 Channel 1 Interrupt
    IRQn_DMA1_CHANNEL2_3        = 10,     //!< DMA1 Channel 2 and Channel 3 Intrrupts
    IRQn_DMA1_CHANNEL4_5        = 11,     //!< DMA1 Channel 4 and Channel 5 Intrrupts
    IRQn_ADC1                   = 12,     //!< ADC1 Interrupt
    IRQn_TIM1_BRK_UP_TRG_COM    = 13,     //!< TIM1 Break, Update, Trigger and ommutation Interrupts
    IRQn_TIM1_CC                = 14,     //!< TIM1 Capture Compare Interrupt
    IRQn_TIM2                   = 15,     //!< TIM2 Interrupt
    IRQn_TIM3                   = 16,     //!< TIM3 Interrupt
    IRQn_TIM14                  = 19,     //!< TIM14 Interrupt
    IRQn_TIM15                  = 20,     //!< TIM15 Interrupt
    IRQn_TIM16                  = 21,     //!< TIM16 Interrupt
    IRQn_TIM17                  = 22,     //!< TIM17 Interrupt
    IRQn_I2C1                   = 23,     //!< I2C1 Interrupt
    IRQn_I2C2                   = 24,     //!< I2C2 Interrupt
    IRQn_SPI1                   = 25,     //!< SPI1 Interrupt
    IRQn_SPI2                   = 26,     //!< SPI2 Interrupt
    IRQn_USART1                 = 27,     //!< USART1 Interrupt
    IRQn_USART2                 = 28,     //!< USART2 Interrupt
    IRQn_USART3_8               = 29      //!< USART3 to 8 Interrupt
#elif defined (CS32F030)
    IRQn_WWDT                   = 0,      //!< Window WatchDog Interrupt
    IRQn_RTC                    = 2,      //!< RTC through EXTI Line Interrupt
    IRQn_FLASH                  = 3,      //!< FLASH Interrupt
    IRQn_RCU                    = 4,      //!< RCU Interrupt
    IRQn_EXTI0_1                = 5,      //!< EXTI Line 0 and 1 Interrupts
    IRQn_EXTI2_3                = 6,      //!< EXTI Line 2 and 3 Interrupts
    IRQn_EXTI4_15               = 7,      //!< EXTI Line 4 to 15 Interrupts
    IRQn_DMA1_CHANNEL1          = 9,      //!< DMA1 Channel 1 Interrupt
    IRQn_DMA1_CHANNEL2_3        = 10,     //!< DMA1 Channel 2 and Channel 3 Intrrupts
    IRQn_DMA1_CHANNEL4_5        = 11,     //!< DMA1 Channel 4 and Channel 5 Intrrupts
    IRQn_ADC1                   = 12,     //!< ADC1 Interrupt
    IRQn_TIM1_BRK_UP_TRG_COM    = 13,     //!< TIM1 Break, Update, Trigger and ommutation Interrupts
    IRQn_TIM1_CC                = 14,     //!< TIM1 Capture Compare Interrupt
    IRQn_TIM3                   = 16,     //!< TIM3 Interrupt
    IRQn_TIM6                   = 17,     //!< TIM6 Interrupt
    IRQn_TIM14                  = 19,     //!< TIM14 Interrupt
    IRQn_TIM15                  = 20,     //!< TIM15 Interrupt
    IRQn_TIM16                  = 21,     //!< TIM16 Interrupt
    IRQn_TIM17                  = 22,     //!< TIM17 Interrupt
    IRQn_I2C1                   = 23,     //!< I2C1 Interrupt
    IRQn_I2C2                   = 24,     //!< I2C2 Interrupt
    IRQn_SPI1                   = 25,     //!< SPI1 Interrupt
    IRQn_SPI2                   = 26,     //!< SPI2 Interrupt
    IRQn_USART1                 = 27,     //!< USART1 Interrupt
    IRQn_USART2                 = 28,     //!< USART2 Interrupt
#elif defined (CS32A039)
    IRQn_WWDT                   = 0,      //!< Window WatchDog Interrupt
    IRQn_LVD                    = 1,      //!< LVD through EXTI Line detect Intrrupt
    IRQn_RTC                    = 2,      //!< RTC through EXTI Line Interrupt
    IRQn_FLASH                  = 3,      //!< FLASH Interrupt
    IRQn_RCU                    = 4,      //!< RCU Interrupt
    IRQn_EXTI0_1                = 5,      //!< EXTI Line 0 and 1 Interrupts
    IRQn_EXTI2_3                = 6,      //!< EXTI Line 2 and 3 Interrupts
    IRQn_EXTI4_15               = 7,      //!< EXTI Line 4 to 15 Interrupts
    IRQn_DMA1_CHANNEL1          = 9,      //!< DMA1 Channel 1 Interrupt
    IRQn_DMA1_CHANNEL2_3        = 10,     //!< DMA1 Channel 2 and Channel 3 Intrrupts
    IRQn_DMA1_CHANNEL4_5        = 11,     //!< DMA1 Channel 4 and Channel 5 Intrrupts
    IRQn_ADC1                   = 12,     //!< ADC1 Interrupt
    IRQn_TIM1_BRK_UP_TRG_COM    = 13,     //!< TIM1 Break, Update, Trigger and ommutation Interrupts
    IRQn_TIM1_CC                = 14,     //!< TIM1 Capture Compare Interrupt
    IRQn_TIM2                   = 15,     //!< TIM2 Interrupt
    IRQn_TIM3                   = 16,     //!< TIM3 Interrupt
    IRQn_TIM6                   = 17,     //!< TIM6 Interrupt
    IRQn_TIM14                  = 19,     //!< TIM14 Interrupt
    IRQn_TIM15                  = 20,     //!< TIM15 Interrupt
    IRQn_TIM16                  = 21,     //!< TIM16 Interrupt
    IRQn_TIM17                  = 22,     //!< TIM17 Interrupt
    IRQn_I2C1                   = 23,     //!< I2C1 Interrupt
    IRQn_I2C2                   = 24,     //!< I2C2 Interrupt
    IRQn_SPI1                   = 25,     //!< SPI1 Interrupt
    IRQn_USART1                 = 27,     //!< USART1 Interrupt
    IRQn_USART2                 = 28,     //!< USART2 Interrupt
    IRQn_USART3_8               = 29      //!< USART3 to 8 Interrupt
#endif
} IRQn_Type;

/**
* @}
*/


#include "core_cm0.h"


/** @addtogroup Exported_types
* @{
*/

/**
* @enum error_status_t
* @brief Error status definition
*/
typedef enum {
    ERROR   = 0,
    SUCCESS = !ERROR
} error_status_t;

/**
* @enum bit_status_t
* @brief bit flag set or status get definitoin
*/
typedef enum {
    RESET   = 0,
    SET     = !RESET
} bit_status_t;

/**
* @enum enable_state_t
* @brief enable or disable  definition
*/
typedef enum {
    DISABLE   = 0,
    ENABLE    = !DISABLE
} enable_state_t;

/**
* @brief Check enable  definition
*/
#define FUNCTIONAL_STATE_CHECK(STATE)          (((STATE) == DISABLE) || ((STATE == ENABLE)))


/** @addtogroup Peripheral_registers_structues
* @{
*/

/**
* @struct adc_reg_t
* @brief Analog to Digital Converter structure definition
*/
typedef struct {
    __IO    uint32_t STAT;         //!< ADC status register
    __IO    uint32_t INTEN;        //!< ADC Interrupt Enable register
    __IO    uint32_t CTR;          //!< ADC general control register
    __IO    uint32_t CFG;          //!< ADC Configuration register
    __IO    uint32_t CLK;          //!< ADC clock source register
    __IO    uint32_t SMPLR;        //!< ADC Sampling time register
            uint32_t RESERVED1;    //!< Reserved
            uint32_t RESERVED2;    //!< Reserved
    __IO    uint32_t WDTH;         //!< ADC watchdog threshold register 
            uint32_t RESERVED3;    //!< Reserved
    __IO    uint32_t CHANSEL;      //!< ADC conversion channel sction register
            uint32_t RESERVED4[5]; //!< Reserved
    __IO    uint32_t OUTDAT;       //!< ADC conversion output daregister
} adc_reg_t;

/**
* @struct adc_conver_t
* @brief Analog to Digital Converter structue definition
*/
typedef struct
{
    __IO    uint32_t INNCHEN;        //!< ADC internal conversion channel enabl register
} adc_conver_t;

/**
* @struct crc_reg_t
* @brief CRC calculation structure definitio
*/
typedef struct
{
    __IO    uint32_t DATA;        //!< CRC Data register
    __IO    uint8_t  FREDATA;     //!< CRC independent data register
            uint8_t  RESERVED0;   //!< Reserved
            uint16_t RESERVED1;   //!< Reserved
    __IO    uint32_t CTR;         //!< CRC Control register
            uint32_t RESERVED2;   //!< Reserved
    __IO    uint32_t INITCFG;     //!< Initial CRC value registe
    __IO    uint32_t POL;         //!< CRC polynomial register
} crc_reg_t;

/**
* @struct debug_reg_t
* @brief Debug register structure definition
*/
typedef struct
{
    __IO    uint32_t ID;          //!< MCU device ID code
    __IO    uint32_t LPWCFG;      //!< Debug MCU configuration register
    __IO    uint32_t APB1CFG;     //!< Debug MCU APB1 freeze register
    __IO    uint32_t APB2CFG;     //!< Debug MCU APB2 freeze register
} debug_reg_t;


/**
* @struct dma_channel_reg_t

* @brief DMA channel register structure defiition
*/
typedef struct
{
    __IO    uint32_t CHxCTR;        //!< DMA channel x controller register
    __IO    uint32_t CHxNUM;        //!< Transfer data number register of DMA cannel x
    __IO    uint32_t CHxPA;         //!< Peripheral address register of DMA chanel x
    __IO    uint32_t CHxMA;         //!< Memory address register of DMA channelx
} dma_channel_reg_t
;


/**
* @struct dma_reg_t
* @brief DMA  register structure definition
*/
typedef struct {
    __IO    uint32_t STS;            //!< DMA interrupt status register
    __IO    uint32_t INTFC;          //!< DMA interrupt flag clear register
            uint32_t RESERVED0[40];  //!< Reserved
    __IO    uint32_t REMAPCTR;       //!< Remap control register
} dma_reg_t;


/**
* @struct exti_reg_t
* @brief External Interrupt/Event Controllerstructure definition
*/
typedef struct {
    __IO    uint32_t INTEN;          //!< Interrupt enable register
    __IO    uint32_t EVTEN;          //!< Event enable register
    __IO    uint32_t RTEN;           //!< Rising edge trigger enable register
    __IO    uint32_t FTEN;           //!< Falling edge trigger enable register
    __IO    uint32_t SWTIEN;         //!< Software trigger interrupt/event enabe register
    __IO    uint32_t PDF;            //!< Pending flag register
} exti_reg_t;


/**
* @struct fmc_reg_t
* @brief FMC (FLASH Memory Control )Register structure definition
*/
typedef struct {
    __IO    uint32_t WCR;          //!< FMC Wait control register
    __IO    uint32_t CCODE;        //!< FMC Control code register
    __IO    uint32_t OBCCODE;      //!< FMC Option Byte Control code register
    __IO    uint32_t STS;          //!< FMC status register
    __IO    uint32_t CTR;          //!< FMC Control register
    __IO    uint32_t ERSADR;       //!< Flash erase address register,
    __IO    uint32_t RESERVED;     //!< Reserved
    __IO    uint32_t OBSTS;        //!< Option byte status register
    __IO    uint32_t WPSTS;        //!< Write protection status register
} fmc_reg_t;


/**
* @struct ob_reg_t
* @brief Option Bytes Registers structure deinition
*/
typedef struct
{
    __IO uint16_t RPROT;          /*!< FLASH option byte Read protection,               Address offset: 0x00 */
    __IO uint16_t USER;           /*!< FLASH option byte user options,                  Address offset: 0x02 */
    __IO uint16_t DATA0;          /*!< User data byte 0 (stored in FLASH_OBSTS[23:16]), Address offset: 0x04 */
    __IO uint16_t DATA1;          /*!< User data byte 1 (stored in FLASH_OBSTS[31:24]), Address offset: 0x06 */
    __IO uint16_t WPROTOB0;       /*!< FLASH option byte write protection 0,            Address offset: 0x08 */
    __IO uint16_t WPROTOB1;       /*!< FLASH option byte write protection 1,            Address offset: 0x0A */
} ob_reg_t;

/**
* @struct gpio_reg_t
* @brief General Purpose IO Registers structre definition
*/
typedef struct {
    __IO    uint32_t PFR;          //!< GPIO port function register
    __IO    uint16_t PODENR;       //!< GPIO port output open-drain enable regiser
            uint16_t RESERVED0;    //!< Reserved
    __IO    uint32_t POSR;         //!< GPIO port output speed register
    __IO    uint32_t PUPDR;        //!< GPIO port pull-up/pull-down register
    __IO    uint16_t DI;           //!< GPIO port data input register
            uint16_t RESERVED1;    //!< Reseved
    __IO    uint16_t DO;           //!< GPIO port output data register
            uint16_t RESERVED2;    //!< Reserved
    __IO    uint32_t SCR;          //!< GPIO port set/clear register
    __IO    uint32_t LOCK;         //!< GPIO port lock register
    __IO    uint32_t MFSEL[2];     //!< GPIO multi-function selection register
    __IO    uint16_t CLRR;         //!< GPIO port clear register
            uint16_t RESERVED3;    //!< Reserved
} gpio_reg_t;


/**
* @struct syscfg_reg_t
* @brief SysTem Configuration Registers struture definition
*/
typedef struct {
    __IO    uint32_t RMAPCFG;           //!<SYSCFG remap configuration
            uint32_t RESERVED;          //!<Reserved
    __IO    uint32_t EXTISRC[4];        //!<SYSCFG external interrupt source seection register
    __IO    uint32_t ERRLOCK;           //!<SYSCFG error and timer break lock
} syscfg_reg_t;


/**
* @struct i2c_reg_t
* @brief Inter-integrated Circuit Interface egisters structure definition
*/
typedef struct
{
    __IO    uint32_t CTR1;      //!< I2C Control register 1
    __IO    uint32_t CTR2;      //!< I2C Control register 2
    __IO    uint32_t SADR1;     //!< I2C slave address 1 register
    __IO    uint32_t SADR2;     //!< I2C slave address 2 register
    __IO    uint32_t TMR;       //!< I2C Timing register
    __IO    uint32_t OVRT;      //!< I2C overtime register
    __IO    uint32_t STS;       //!< I2C status register
    __IO    uint32_t STSC;      //!< I2C status clear register
    __IO    uint32_t PECCODE;   //!< I2C received PEC code register
    __IO    uint32_t RXBUF;     //!< I2C Receive buffer register
    __IO    uint32_t TXBUF;     //!< I2C Transmit buffer register
} i2c_reg_t;


/**
* @struct fwdt_reg_t* @brief FWDT(Free Watchdog Timer) Registersstructure definition
*/
typedef struct {
    __IO    uint32_t CCODE;   //!< FWDT Control code register
    __IO    uint32_t PDIV;    //!< FWDT Pre-divider register
    __IO    uint32_t UVAL;    //!< FWDT Update register
    __IO    uint32_t STS;     //!< FWDT Status register
    __IO    uint32_t WINVAL;  //!< FWDT Window value register
} fwdt_reg_t;


/**
* @struct pmu_reg_t
* @brief Power management unit (PMU) Registers structure definition
*/
typedef struct {
    __IO    uint32_t CTR;      //!< control register
    __IO    uint32_t CS;       //!< control/statu register
} pmu_reg_t;


/**
* @struct rcu_reg_t* @brief Reset and Clock Control Registers sructure definition
*/
typedef struct {
    __IO    uint32_t CTR;       //!< clock control register
    __IO    uint32_t CFG;       //!< clock configuration register
    __IO    uint32_t INTR;      //!< clock interrupt register
    __IO    uint32_t APB2RST;   //!< APB2 peripheral reset register
    __IO    uint32_t APB1RST;   //!< APB1 peripheral reset register
    __IO    uint32_t AHBEN;     //!< AHB peripheral clock register
    __IO    uint32_t APB2EN;    //!< APB2 peripheral clock enable register
    __IO    uint32_t APB1EN;    //!< APB1 peripheral clock enable register
    __IO    uint32_t VBDC;      //!< VBAT domain control register
    __IO    uint32_t STS;       //!< status register
    __IO    uint32_t AHBRST;    //!< AHB  reset register
    __IO    uint32_t CFG2;      //!< clock configuration register 2
    __IO    uint32_t CFG3;      //!< clock configuration register 3
    __IO    uint32_t CTR2;      //!< clock control register 2
} rcu_reg_t;


/**
* @struct rtc_reg_t
* @brief Real-Time Clock Registers structuredefinition
*/
typedef struct {
    __IO    uint32_t TIME;        //!< RTC time register
    __IO    uint32_t DATE;        //!< RTC date register
    __IO    uint32_t CTR;         //!< RTC control register
    __IO    uint32_t STS;         //!< RTC status register
    __IO    uint32_t PDIV;        //!< RTC pre-divider register,
    __IO    uint32_t WUTR;        //!< RTC wakeup timer register
            uint32_t RESERVED1;   //!< Reserved
    __IO    uint32_t ACFG1;       //!< RTC alarm config1 register
            uint32_t RESERVED2;   //!< Reserved
    __IO    uint32_t CCODE;       //!< RTC control code registerr
    __IO    uint32_t SSEC;        //!< RTC sub second register
    __IO    uint32_t ADJ;         //!< RTC adjustment register
    __IO    uint32_t TR2;         //!< RTC Time recording2 register
    __IO    uint32_t TR1;         //!< RTC Time recording1 register
    __IO    uint32_t TR3;         //!< RTC Time recording3 register
    __IO    uint32_t RTC_1SCAL;   //!< RTC 1Hz clock calibration register
    __IO    uint32_t MF;          //!< RTC multiplex function register
    __IO    uint32_t ACFG2;       //!< RTC alarm config2 register
            uint32_t RESERVED3;   //!< Reserved
            uint32_t RESERVED4;   //!< Reserved
    __IO    uint32_t AO0;         //!< RTC always on registers 0
    __IO    uint32_t AO1;         //!< RTC always on registers 1
    __IO    uint32_t AO2;         //!< RTC always on registers 2
    __IO    uint32_t AO3;         //!< RTC always on registers 3
    __IO    uint32_t AO4;         //!< RTC always on registers 4
} rtc_reg_t;


/**
* @struct spi_reg_t
* @brief Serial Peripheral Interface Registes structure definition
*/
typedef struct {
    __IO    uint16_t CTR1;          //!< SPI Control register 1
            uint16_t RESERVED0;     //!< Reserved
    __IO    uint16_t CTR2;          //!< SPI Control register 2
            uint16_t RESERVED1;     //!< Reserved
    __IO    uint16_t STS;           //!< SPI Status register
            uint16_t RESERVED2;     //!< Reserved
    __IO    uint16_t DATA;          //!< SPI data register
            uint16_t RESERVED3;     //!< Reserved
    __IO    uint16_t CRCPOLYR;      //!< SPI CRC polynomial register
            uint16_t RESERVED4;     //!< Reserved
    __IO    uint16_t RCRC;          //!< SPI Rx CRC register
            uint16_t RESERVED5;     //!< Reserved
    __IO    uint16_t TCRC;          //!< SPI Tx CRC register
            uint16_t RESERVED6;     //!< Reserved
    __IO    uint16_t I2SCTR;        //!< I2S control register
            uint16_t RESERVED7;     //!< Reserved
    __IO    uint16_t I2SPDIV;       //!< I2S pre-divider register
            uint16_t RESERVED8;     //!< Reserved
} spi_reg_t;


/**
* @struct tim_reg_t
* @brief TIM Registers structure definition
*/
typedef struct {
    __IO    uint16_t CTR1;            //!< TIMx control register 1
            uint16_t RESERVED0;       //!< Reserved
    __IO    uint16_t CTR2;            //!< TIMx control register 2
            uint16_t RESERVED1;       //!< Reserved
    __IO    uint16_t SMCFG;           //!< TIMx slave mode configuration registr
            uint16_t RESERVED2;       //!< Reserved
    __IO    uint16_t DIEN;            //!< TIMx DMA and interrupt enable registr
            uint16_t RESERVED3;       //!< Reserved
    __IO    uint16_t STS;             //!< TIMx status register
            uint16_t RESERVED4;       //!< Reserved
    __IO    uint16_t SWEGR;           //!< TIMx software event generation regiser
            uint16_t RESERVED5;       //!< Reserved
    __IO    uint16_t CH12CFGR;        //!< TIMx channel 1 and channel 2 configuation register
            uint16_t RESERVED6;       //!< Reserved
    __IO    uint16_t CH34CFGR;        //!< TIMx channel 3 and channel 4 configuation register
            uint16_t RESERVED7;       //!< Reserved
    __IO    uint16_t CCCTR;           //!< TIMx channel capture compare controeister
            uint16_t RESERVED8;       //!< Reserved
    __IO    uint32_t CNT;             //!< TIMx counter register
    __IO    uint16_t PDIV;            //!< TIMx pre-divider register
            uint16_t RESERVED10;      //!< Reserved
    __IO    uint32_t UVAL;            //!< TIMx counter update register
    __IO    uint16_t UVALREP;         //!< TIMx counter update repetition regiser
            uint16_t RESERVED12;      //!< Reserved
    __IO    uint32_t CH1CCVAL;        //!< TIMx channel 1 capture compare valueregister
    __IO    uint32_t CH2CCVAL;        //!< TIMx channel 2 capture compare valueregister
    __IO    uint32_t CH3CCVAL;        //!< TIMx channel 3 capture compare valueregister
    __IO    uint32_t CH4CCVAL;        //!< TIMx channel 4 capture compare valueregister
    __IO    uint16_t CHOPR;           //!< TIMx channel output protect register
            uint16_t RESERVED17;      //!< Reserved
    __IO    uint16_t DMAACR;          //!< TIMx DMA access configuration registr
            uint16_t RESERVED18;      //!< Reserved
    __IO    uint16_t DMAIR;           //!< TIMx DMA access interface register
            uint16_t RESERVED19;      //!< Reserved
    __IO    uint16_t REMAP;           //!< TIM14 remap register
            uint16_t RESERVED20;      //!< Reserved
} tim_reg_t;

/**
* @struct usart_reg_t
* @brief Universal Synchronous Asynchronous eceiver Transmitter registers strur definition
*/
typedef struct {
    __IO    uint32_t CTR1;          //!< USART Control register 1
    __IO    uint32_t CTR2;          //!< USART Control register 2
    __IO    uint32_t CTR3;          //!< USART Control register 3
    __IO    uint16_t BRT;           //!< USART Baud rate register
            uint16_t RESERVED1;     //!< Reserved
    __IO    uint16_t GTPDIV;        //!< Guard time and pre-divider register
            uint16_t RESERVED2;     //!< Reserved
    __IO    uint32_t ROT;           //!< Receiver timeout register
    __IO    uint16_t SWTR;          //!< Software Trigger register
            uint16_t RESERVED3;     //!< Reserved
    __IO    uint32_t STS;           //!< USART Interrupt and status register
    __IO    uint32_t IFCLR;         //!< USART Interrupt flag Clear register
    __IO    uint16_t RXBUF;         //!< Receive buffer register
            uint16_t RESERVED4;     //!< Reserved
    __IO    uint16_t TXBUF;         //!< Transmit buffer register
            uint16_t RESERVED5;     //!< Reserved
} usart_reg_t;


/**
* @struct wwdt_reg_t
* @brief WWDT(Window Watchdog Timer) registes  registers structure definition
*/
typedef struct {
    __IO    uint32_t CTR1;   //!< WWDT Control register 1
    __IO    uint32_t CTR2;   //!< WWDT Control register 2
    __IO    uint32_t STS;    //!< WWDT Status register
} wwdt_reg_t;


/**
* @}
*/


/** @addtogroup Peripheral_memory_map
* @{
*/
#define FLASH_BASE            ((uint32_t)0x08000000) //!< FLASH base address ih alias region
#define SRAM_BASE             ((uint32_t)0x20000000) //!< SRAM base address inealias region
#define PERIPH_BASE           ((uint32_t)0x40000000) //!< Peripheral base addr n the alias region
#define OB_BASE               ((uint32_t)0x1FFFF800) //!< FLASH Option Bytes b ddress

/**
* @brief Peripheral memory map definition
*/
#define APB_PERIPH_BASE        PERIPH_BASE
#define AHB_PERIPH_BASE       (PERIPH_BASE      + 0x00020000)
#define AHB2_PERIPH_BASE      (PERIPH_BASE      + 0x08000000)

#define TIM2_BASE             (APB_PERIPH_BASE  + 0x00000000)
#define TIM3_BASE             (APB_PERIPH_BASE  + 0x00000400)
#define TIM6_BASE             (APB_PERIPH_BASE  + 0x00001000)
#define TIM7_BASE             (APB_PERIPH_BASE  + 0x00001400)
#define TIM14_BASE            (APB_PERIPH_BASE  + 0x00002000)
#define RTC_BASE              (APB_PERIPH_BASE  + 0x00002800)
#define WWDT_BASE             (APB_PERIPH_BASE  + 0x00002C00)
#define FWDT_BASE             (APB_PERIPH_BASE  + 0x00003000)
#define SPI2_BASE             (APB_PERIPH_BASE  + 0x00003800)
#define USART2_BASE           (APB_PERIPH_BASE  + 0x00004400)
#define USART3_BASE           (APB_PERIPH_BASE  + 0x00004800)
#define USART4_BASE           (APB_PERIPH_BASE  + 0x00004C00)
#define USART5_BASE           (APB_PERIPH_BASE  + 0x00005000)
#define I2C1_BASE             (APB_PERIPH_BASE  + 0x00005400)
#define I2C2_BASE             (APB_PERIPH_BASE  + 0x00005800)
#define PMU_BASE              (APB_PERIPH_BASE  + 0x00007000)
#define SYSCFG_BASE           (APB_PERIPH_BASE  + 0x00010000)

#define EXTI_BASE             (APB_PERIPH_BASE  + 0x00010400)
#define USART6_BASE           (APB_PERIPH_BASE  + 0x00011400)
#define USART7_BASE           (APB_PERIPH_BASE  + 0x00011800)
#define USART8_BASE           (APB_PERIPH_BASE  + 0x00011C00)
#define ADC1_BASE             (APB_PERIPH_BASE  + 0x00012400)
#define ADC_BASE              (APB_PERIPH_BASE  + 0x00012708)
#define TIM1_BASE             (APB_PERIPH_BASE  + 0x00012C00)
#define SPI1_BASE             (APB_PERIPH_BASE  + 0x00013000)
#define USART1_BASE           (APB_PERIPH_BASE  + 0x00013800)
#define TIM15_BASE            (APB_PERIPH_BASE  + 0x00014000)
#define TIM16_BASE            (APB_PERIPH_BASE  + 0x00014400)
#define TIM17_BASE            (APB_PERIPH_BASE  + 0x00014800)
#define DBGMCU_BASE           (APB_PERIPH_BASE  + 0x00015800)

#define DMA1_BASE             (AHB_PERIPH_BASE  + 0x00000000)
#define DMA1_CHANNEL1_BASE    (DMA1_BASE        + 0x00000008)
#define DMA1_CHANNEL2_BASE    (DMA1_BASE        + 0x0000001C)
#define DMA1_CHANNEL3_BASE    (DMA1_BASE        + 0x00000030)
#define DMA1_CHANNEL4_BASE    (DMA1_BASE        + 0x00000044)
#define DMA1_CHANNEL5_BASE    (DMA1_BASE        + 0x00000058)
#define DMA1_CHANNEL6_BASE    (DMA1_BASE        + 0x0000006C)
#define DMA1_CHANNEL7_BASE    (DMA1_BASE        + 0x00000080)

#define DMA2_BASE             (AHB_PERIPH_BASE  + 0x00000400)
#define DMA2_CHANNEL1_BASE    (DMA2_BASE        + 0x00000008)
#define DMA2_CHANNEL2_BASE    (DMA2_BASE        + 0x0000001C)
#define DMA2_CHANNEL3_BASE    (DMA2_BASE        + 0x00000030)
#define DMA2_CHANNEL4_BASE    (DMA2_BASE        + 0x00000044)
#define DMA2_CHANNEL5_BASE    (DMA2_BASE        + 0x00000058)

#define RCU_BASE              (AHB_PERIPH_BASE  + 0x00001000)
#define FLASH_REG_BASE        (AHB_PERIPH_BASE  + 0x00002000) //!< FLASH registrs base address
#define CRC_BASE              (AHB_PERIPH_BASE  + 0x00003000)


#define GPIOA_BASE            (AHB2_PERIPH_BASE + 0x00000000)
#define GPIOB_BASE            (AHB2_PERIPH_BASE + 0x00000400)
#define GPIOC_BASE            (AHB2_PERIPH_BASE + 0x00000800)
#define GPIOD_BASE            (AHB2_PERIPH_BASE + 0x00000C00)
#define GPIOE_BASE            (AHB2_PERIPH_BASE + 0x00001000)
#define GPIOF_BASE            (AHB2_PERIPH_BASE + 0x00001400)

/**
* @}
*/



/** @addtogroup Peripheral_declaration
* @{
*/
#define TIM2                ((tim_reg_t *)        TIM2_BASE)
#define TIM3                ((tim_reg_t *)        TIM3_BASE)
#define TIM6                ((tim_reg_t *)        TIM6_BASE)
#define TIM7                ((tim_reg_t *)        TIM7_BASE)
#define TIM14               ((tim_reg_t *)        TIM14_BASE)
#define RTC                 ((rtc_reg_t *)        RTC_BASE)
#define WWDT                ((wwdt_reg_t *)       WWDT_BASE)
#define FWDT                ((fwdt_reg_t *)       FWDT_BASE)
#define SPI2                ((spi_reg_t *)        SPI2_BASE)
#define USART2              ((usart_reg_t *)      USART2_BASE)
#define USART3              ((usart_reg_t *)      USART3_BASE)
#define USART4              ((usart_reg_t *)      USART4_BASE)
#define USART5              ((usart_reg_t *)      USART5_BASE)
#define I2C1                ((i2c_reg_t *)        I2C1_BASE)
#define I2C2                ((i2c_reg_t *)        I2C2_BASE)
#define PMU                 ((pmu_reg_t *)        PMU_BASE)
#define SYSCFG              ((syscfg_reg_t *)     SYSCFG_BASE)

#define EXTI                ((exti_reg_t *)       EXTI_BASE)
#define USART6              ((usart_reg_t *)      USART6_BASE)
#define USART7              ((usart_reg_t *)      USART7_BASE)
#define USART8              ((usart_reg_t *)      USART8_BASE)
#define ADC1                ((adc_reg_t *)        ADC1_BASE)
#define ADC                 ((adc_conver_t *)     ADC_BASE)
#define TIM1                ((tim_reg_t *)        TIM1_BASE)
#define SPI1                ((spi_reg_t *)        SPI1_BASE)
#define USART1              ((usart_reg_t *)      USART1_BASE)
#define TIM15               ((tim_reg_t *)        TIM15_BASE)
#define TIM16               ((tim_reg_t *)        TIM16_BASE)
#define TIM17               ((tim_reg_t *)        TIM17_BASE)
#define DBGMCU              ((debug_reg_t *)      DBGMCU_BASE)

#define DMA1                ((dma_reg_t *)         DMA1_BASE)
#define DMA1_CHANNEL1       ((dma_channel_reg_t *) DMA1_CHANNEL1_BASE)
#define DMA1_CHANNEL2       ((dma_channel_reg_t *) DMA1_CHANNEL2_BASE)
#define DMA1_CHANNEL3       ((dma_channel_reg_t *) DMA1_CHANNEL3_BASE)
#define DMA1_CHANNEL4       ((dma_channel_reg_t *) DMA1_CHANNEL4_BASE)
#define DMA1_CHANNEL5       ((dma_channel_reg_t *) DMA1_CHANNEL5_BASE)
#define DMA1_CHANNEL6       ((dma_channel_reg_t *) DMA1_CHANNEL6_BASE)
#define DMA1_CHANNEL7       ((dma_channel_reg_t *) DMA1_CHANNEL7_BASE)

#define DMA2                ((dma_reg_t *)         DMA2_BASE)
#define DMA2_CHANNEL1       ((dma_channel_reg_t *) DMA2_CHANNEL1_BASE)
#define DMA2_CHANNEL2       ((dma_channel_reg_t *) DMA2_CHANNEL2_BASE)
#define DMA2_CHANNEL3       ((dma_channel_reg_t *) DMA2_CHANNEL3_BASE)
#define DMA2_CHANNEL4       ((dma_channel_reg_t *) DMA2_CHANNEL4_BASE)
#define DMA2_CHANNEL5       ((dma_channel_reg_t *) DMA2_CHANNEL5_BASE)

#define FLASH               ((fmc_reg_t *)        FLASH_REG_BASE)
#define OB                  ((ob_reg_t *)         OB_BASE)
#define RCU                 ((rcu_reg_t *)        RCU_BASE)
#define CRC                 ((crc_reg_t *)        CRC_BASE)

#define GPIOA               ((gpio_reg_t *)       GPIOA_BASE)
#define GPIOB               ((gpio_reg_t *)       GPIOB_BASE)
#define GPIOC               ((gpio_reg_t *)       GPIOC_BASE)
#define GPIOD               ((gpio_reg_t *)       GPIOD_BASE)
#define GPIOE               ((gpio_reg_t *)       GPIOE_BASE)
#define GPIOF               ((gpio_reg_t *)       GPIOF_BASE)

/**
* @}
*/




/** @addtogroup Peripheral_Registers_Bits_Deinition
* @{
*/


/*---------------------------------------------------------------------------*/
/*             Analog to Digital Converter (DC)                              */
/*---------------------------------------------------------------------------*/

/**
* @brief ADC_STAT register  Bits definition
*/
#define ADC_STAT_WDEVT                ((uint32_t)0x00000080)        //!< analogwatchdog event flag
#define ADC_STAT_DOVR                 ((uint32_t)0x00000010)        //!< ADC daa overrun flag
#define ADC_STAT_EOCG                 ((uint32_t)0x00000008)        //!< End ofconversion group flag
#define ADC_STAT_EOCH                 ((uint32_t)0x00000004)        //!< End ofchannel conversion flag
#define ADC_STAT_EOSP                 ((uint32_t)0x00000002)        //!< End ofsampling phase flag
#define ADC_STAT_EOI                  ((uint32_t)0x00000001)        //!< End ofADC initialization


/**
* @brief ADC_INTEN register Bits definition
*/
#define ADC_INTEN_WDEVTIE             ((uint32_t)0x00000080)        //!< analogwatchdog event interrupt enable
#define ADC_INTEN_DOVRIE              ((uint32_t)0x00000010)        //!< ADC daa overrun interrupt enable
#define ADC_INTEN_EOGIE               ((uint32_t)0x00000008)        //!< End ofconversion group interrupt enable
#define ADC_INTEN_EOCIE               ((uint32_t)0x00000004)        //!< End ofchannel conversion interrupt enable
#define ADC_INTEN_EOSPIE              ((uint32_t)0x00000002)        //!< End ofsampling phase interrupt enable
#define ADC_INTEN_EOIIE               ((uint32_t)0x00000001)        //!< End ofADC initialization interrupt enable


/**
* @brief ADC_CTR register Bits definition
*/
#define ADC_CTR_CALB                  ((uint32_t)0x80000000)        //!< ADC caibration control
#define ADC_CTR_ADSTOP                ((uint32_t)0x00000010)        //!< ADC stp conversion command
#define ADC_CTR_ADSTRT                ((uint32_t)0x00000004)        //!< ADC strt conversion command
#define ADC_CTR_ADCOFF                ((uint32_t)0x00000002)        //!< ADC poer off command
#define ADC_CTR_ADCON                 ((uint32_t)0x00000001)        //!< ADC poer on command

/**
* @brief ADC_CFG register   Bits definition
*/
#define  ADC_CFG_WDGCHAN              ((uint32_t)0x7C000000)       //!< WDGCHAN4:0] bits (Analog watchdog monitor channel selection).
#define  ADC_CFG_WDGCHAN_0            ((uint32_t)0x04000000)       //!< Bit 0
#define  ADC_CFG_WDGCHAN_1            ((uint32_t)0x08000000)       //!< Bit 1
#define  ADC_CFG_WDGCHAN_2            ((uint32_t)0x10000000)       //!< Bit 2
#define  ADC_CFG_WDGCHAN_3            ((uint32_t)0x20000000)       //!< Bit 3
#define  ADC_CFG_WDGCHAN_4            ((uint32_t)0x40000000)       //!< Bit 4
#define  ADC_CFG_WDGEN                ((uint32_t)0x00800000)       //!< Analog atchdog enable
#define  ADC_CFG_WDGCHMODE            ((uint32_t)0x00400000)       //!< Analog atchdog channel monitor mode.
#define  ADC_CFG_DISCONT              ((uint32_t)0x00010000)       //!< Discontnuous conversion mode
#define  ADC_CFG_ATSTDBY              ((uint32_t)0x00008000)       //!< ADC aut standby mode
#define  ADC_CFG_PAUSE                ((uint32_t)0x00004000)       //!< converson pause mode
#define  ADC_CFG_GCONT                ((uint32_t)0x00002000)       //!< Group cnversion Single/continuous mode
#define  ADC_CFG_DOVRWRT              ((uint32_t)0x00001000)       //!< Converson data overrun overwriten mode
#define  ADC_CFG_TRGMODE              ((uint32_t)0x00000C00)       //!< TRGMODE1:0] bits (Coverstion Trigger mode selection).
#define  ADC_CFG_TRGMODE_0            ((uint32_t)0x00000400)       //!< Bit 0
#define  ADC_CFG_TRGMODE_1            ((uint32_t)0x00000800)       //!< Bit 1
#define  ADC_CFG_HTRGSEL              ((uint32_t)0x000001C0)       //!< HTRGSEL2:0] bits (Hardware trigger source selection).
#define  ADC_CFG_HTRGSEL_0            ((uint32_t)0x00000040)       //!< Bit 0
#define  ADC_CFG_HTRGSEL_1            ((uint32_t)0x00000080)       //!< Bit 1
#define  ADC_CFG_HTRGSEL_2            ((uint32_t)0x00000100)       //!< Bit 2
#define  ADC_CFG_DATALG               ((uint32_t)0x00000020)       //!< Converson data format alignment.
#define  ADC_CFG_DATRES               ((uint32_t)0x00000018)       //!< DATRES[:0] bits (Conversion data reselution).
#define  ADC_CFG_DATRES_0             ((uint32_t)0x00000008)       //!< Bit 0
#define  ADC_CFG_DATRES_1             ((uint32_t)0x00000010)       //!< Bit 1
#define  ADC_CFG_CGDIR                ((uint32_t)0x00000004)       //!< Coveraton group sequence direction
#define  ADC_CFG_DMAMODE              ((uint32_t)0x00000002)       //!< Direct emory access single/circle mode
#define  ADC_CFG_DMAEN                ((uint32_t)0x00000001)       //!< Direct emory access enable

/**
* @brief ADC_CLK register Bits definition
*/
#define  ADC_CLK_CKSRC                ((uint32_t)0xC0000000)       //!< ADC clok source selection
#define  ADC_CLK_CKSRC_1              ((uint32_t)0x80000000)       //!< ADC cloked by PCLK div4.
#define  ADC_CLK_CKSRC_0              ((uint32_t)0x40000000)       //!< ADC cloked by PCLK div2 .

/**
* @brief ADC_SMPLR register Bit definition
*/
#define  ADC_SMPLR_SMPLT              ((uint32_t)0x00000007)       //!< SMPLT[20] bits (Sampling time selection).
#define  ADC_SMPLR_SMPLT_0            ((uint32_t)0x00000001)       //!< Bit 0
#define  ADC_SMPLR_SMPLT_1            ((uint32_t)0x00000002)       //!< Bit 1
#define  ADC_SMPLR_SMPLT_2            ((uint32_t)0x00000004)       //!< Bit 2

/**
* @brief ADC_WDTH register  Bit definition
*/
#define  ADC_WDTH_HITH                ((uint32_t)0x0FFF0000)       //!< Analog atchdog higher threshold.
#define  ADC_WDTH_LOTH                ((uint32_t)0x00000FFF)       //!< Analog atchdog lower threshold.

/**
* @brief ADC_CHANSEL register Bit definition
*/
#define  ADC_CHANSEL_CHANSEL18        ((uint32_t)0x00040000)       //!< Channel18 selection.
#define  ADC_CHANSEL_CHANSEL17        ((uint32_t)0x00020000)       //!< Channel17 selection.
#define  ADC_CHANSEL_CHANSEL16        ((uint32_t)0x00010000)       //!< Channel16 selection.
#define  ADC_CHANSEL_CHANSEL15        ((uint32_t)0x00008000)       //!< Channel15 selection.
#define  ADC_CHANSEL_CHANSEL14        ((uint32_t)0x00004000)       //!< Channel14 selection.
#define  ADC_CHANSEL_CHANSEL13        ((uint32_t)0x00002000)       //!< Channel13 selection.
#define  ADC_CHANSEL_CHANSEL12        ((uint32_t)0x00001000)       //!< Channel12 selection.
#define  ADC_CHANSEL_CHANSEL11        ((uint32_t)0x00000800)       //!< Channel11 selection.
#define  ADC_CHANSEL_CHANSEL10        ((uint32_t)0x00000400)       //!< Channel10 selection.
#define  ADC_CHANSEL_CHANSEL9         ((uint32_t)0x00000200)       //!< Channel9 selection.
#define  ADC_CHANSEL_CHANSEL8         ((uint32_t)0x00000100)       //!< Channel8 selection.
#define  ADC_CHANSEL_CHANSEL7         ((uint32_t)0x00000080)       //!< Channel7 selection.
#define  ADC_CHANSEL_CHANSEL6         ((uint32_t)0x00000040)       //!< Channel6 selection.
#define  ADC_CHANSEL_CHANSEL5         ((uint32_t)0x00000020)       //!< Channel5 selection.
#define  ADC_CHANSEL_CHANSEL4         ((uint32_t)0x00000010)       //!< Channel4 selection.
#define  ADC_CHANSEL_CHANSEL3         ((uint32_t)0x00000008)       //!< Channel3 selection.
#define  ADC_CHANSEL_CHANSEL2         ((uint32_t)0x00000004)       //!< Channel2 selection.
#define  ADC_CHANSEL_CHANSEL1         ((uint32_t)0x00000002)       //!< Channel1 selection.
#define  ADC_CHANSEL_CHANSEL0         ((uint32_t)0x00000001)       //!< Channel0 selection.

/**
* @brief ADC_OUTDAT register  Bit definition
*/
#define  ADC_OUTDAT_OUTDAT            ((uint32_t)0x0000FFFF)       //!< converson output data.

/**
* @brief ADC_INNCHEN register  Bit definitio
*/
#define  ADC_INNCHEN_VBATMEN          ((uint32_t)0x01000000)       //!< VBAT moitor enable.
#define  ADC_INNCHEN_TSEN             ((uint32_t)0x00800000)       //!< Temperaure sensor enable
#define  ADC_INNCHEN_VREFINTEN        ((uint32_t)0x00400000)       //!< VREFINTenable


/*------------------------------------------ --------------------------------*/
/*               CRC calculation unit (CRC)                                  */
/*------------------------------------------ --------------------------------*/

/**
* @brief CRC_DATA register  Bit definition
*/
#define  CRC_DATA_DATA                ((uint32_t)0xFFFFFFFF)       //!< Data reister bits */

/**
* @brief CRC_FREDATA register Bit definition
*/
#define  CRC_FREDATA_FREDATA          ((uint8_t)0xFF)              //!< Free Daa register bits

/**
* @brief CRC_CTR register Bit definition
*/
#define  CRC_CTR_RST                  ((uint32_t)0x00000001)       //!< RESET te CRC computation unit bit
#define  CRC_CTR_POLSIZE              ((uint32_t)0x00000018)       //!< Polynomal size bits
#define  CRC_CTR_POLSIZE_0            ((uint32_t)0x00000008)       //!< Polynomal size bit 0
#define  CRC_CTR_POLSIZE_1            ((uint32_t)0x00000010)       //!< Polynomal size bit 1

#define  CRC_CTR_DINREVMOD            ((uint32_t)0x00000060)       //!< DINREVMD[1:0]      Input data Reverse mode selection
#define  CRC_CTR_DINREVMOD_0          ((uint32_t)0x00000020)       //!< Bit 0
#define  CRC_CTR_DINREVMOD_1          ((uint32_t)0x00000040)       //!< Bit 1
#define  CRC_CTR_DOREVEN              ((uint32_t)0x00000080)       //!< Output ata Reverse enable

/**
* @brief CRC_INITCFG register Bit definition
*/
#define  CRC_INITCFG_INITCFG          ((uint32_t)0xFFFFFFFF)       //!< CRC iniial value configuration bits


/*--------------------------------------------------------------------------*/
/*                           Debug module                                   */
/*--------------------------------------------------------------------------*/

/**
* @brief DBG_ID register Bit definition
*/
#define  DBG_ID_DEV_ID                ((uint32_t)0x00000FFF)       //!< Device dentifier

#define  DBG_ID_REV_ID                ((uint32_t)0xFFFF0000)       //!< REV_ID[5:0] bits (Revision Identifier)
#define  DBG_ID_REV_ID_0              ((uint32_t)0x00010000)       //!< Bit 0
#define  DBG_ID_REV_ID_1              ((uint32_t)0x00020000)       //!< Bit 1
#define  DBG_ID_REV_ID_2              ((uint32_t)0x00040000)       //!< Bit 2
#define  DBG_ID_REV_ID_3              ((uint32_t)0x00080000)       //!< Bit 3
#define  DBG_ID_REV_ID_4              ((uint32_t)0x00100000)       //!< Bit 4
#define  DBG_ID_REV_ID_5              ((uint32_t)0x00200000)       //!< Bit 5
#define  DBG_ID_REV_ID_6              ((uint32_t)0x00400000)       //!< Bit 6
#define  DBG_ID_REV_ID_7              ((uint32_t)0x00800000)       //!< Bit 7
#define  DBG_ID_REV_ID_8              ((uint32_t)0x01000000)       //!< Bit 8
#define  DBG_ID_REV_ID_9              ((uint32_t)0x02000000)       //!< Bit 9
#define  DBG_ID_REV_ID_10             ((uint32_t)0x04000000)       //!< Bit 10
#define  DBG_ID_REV_ID_11             ((uint32_t)0x08000000)       //!< Bit 11
#define  DBG_ID_REV_ID_12             ((uint32_t)0x10000000)       //!< Bit 12
#define  DBG_ID_REV_ID_13             ((uint32_t)0x20000000)       //!< Bit 13
#define  DBG_ID_REV_ID_14             ((uint32_t)0x40000000)       //!< Bit 14
#define  DBG_ID_REV_ID_15             ((uint32_t)0x80000000)       //!< Bit 15

/**
* @brief DBG_LPWCFG register Bit definition
*/
#define  DBG_LPWCFG_DSM_DBGEN         ((uint32_t)0x00000002)       //!< Stop moe debug support
#define  DBG_LPWCFG_PWD_DBGEN         ((uint32_t)0x00000004)       //!< Standbymode debug support

/**
* @brief DBG_APB1CFG register Bit definition
*/
#define  DBG_APB1CFG_TIM2_DBG_PAUSE          ((uint32_t)0x00000001)        //!<TIM2 counter paused when system is in debug mode
#define  DBG_APB1CFG_TIM3_DBG_PAUSE          ((uint32_t)0x00000002)        //!<TIM3 counter paused when system is in debug mode
#define  DBG_APB1CFG_TIM6_DBG_PAUSE          ((uint32_t)0x00000010)        //!<TIM6 counter paused when system is in debug mode
#define  DBG_APB1CFG_TIM7_DBG_PAUSE          ((uint32_t)0x00000020)        //!<TIM7 counter paused when system is in debug mode
#define  DBG_APB1CFG_TIM14_DBG_PAUSE         ((uint32_t)0x00000100)        //!<TIM14 counter paused when system is in debug mode
#define  DBG_APB1CFG_RTC_DBG_PAUSE           ((uint32_t)0x00000400)        //!<RTC paused when system is in debug mode
#define  DBG_APB1CFG_WWDT_DBG_PAUSE          ((uint32_t)0x00000800)        //!<window watchdog paused when system is in debug mode
#define  DBG_APB1CFG_FWDT_DBG_PAUSE          ((uint32_t)0x00001000)        //!<Free watchdog paused when system is in debug mode
#define  DBG_APB1CFG_I2C1_SMBUS_DBG_PAUSE    ((uint32_t)0x00200000)        //!<SMBUS timeout counter  paused when system is in debug mod
#define  DBG_APB1CFG_CAN_DBG_PAUSE           ((uint32_t)0x02000000)        //!<CAN paused when system is in debug mode

/**
* @brief DBG_APB2CFG register Bit definition
*/
#define  DBG_APB2CFG_TIM1_DBG_PAUSE          ((uint32_t)0x00000800)        //!<TIM1 counter paused when system is in debug mode
#define  DBG_APB2CFG_TIM15_DBG_PAUSE         ((uint32_t)0x00010000)        //!<TIM15   counter paused when system is in debug mode
#define  DBG_APB2CFG_TIM16_DBG_PAUSE         ((uint32_t)0x00020000)        //!<TIM16 counter paused when system is in debug mode
#define  DBG_APB2CFG_TIM17_DBG_PAUSE         ((uint32_t)0x00040000)        //!<TIM17 counter paused when system is in debug mode

/*--------------------------------------------------------------------------*/
/*              DMA Controller (DMA)                                        */
/*--------------------------------------------------------------------------*/

/**
* @brief DMA_STS register Bit definition
*/
#define  DMA_STS_GIF1                        ((uint32_t)0x00000001)       //!< lobal interrupt flag of Channel 1
#define  DMA_STS_CMPIF1                      ((uint32_t)0x00000002)       //!< ransfer complete flag of Channel 1
#define  DMA_STS_HLFIF1                      ((uint32_t)0x00000004)       //!< alf transfer flag of Channel 1
#define  DMA_STS_ERRIF1                      ((uint32_t)0x00000008)       //!< ransfer error flag of Channel 1

#define  DMA_STS_GIF2                        ((uint32_t)0x00000010)       //!< lobal interrupt flag of Channel 2
#define  DMA_STS_CMPIF2                      ((uint32_t)0x00000020)       //!< ransfer complete flag of Channel 2
#define  DMA_STS_HLFIF2                      ((uint32_t)0x00000040)       //!< alf transfer flag of Channel 2
#define  DMA_STS_ERRIF2                      ((uint32_t)0x00000080)       //!< ransfer error flag of Channel 2

#define  DMA_STS_GIF3                        ((uint32_t)0x00000100)       //!< lobal interrupt flag of Channel 3
#define  DMA_STS_CMPIF3                      ((uint32_t)0x00000200)       //!< ransfer complete flag of Channel 3
#define  DMA_STS_HLFIF3                      ((uint32_t)0x00000400)       //!< alf transfer flag of Channel 3
#define  DMA_STS_ERRIF3                      ((uint32_t)0x00000800)       //!< ransfer error flag of Channel 3

#define  DMA_STS_GIF4                        ((uint32_t)0x00001000)       //!< lobal interrupt flag of Channel 4
#define  DMA_STS_CMPIF4                      ((uint32_t)0x00002000)       //!< ransfer complete flag of Channel 4
#define  DMA_STS_HLFIF4                      ((uint32_t)0x00004000)       //!< alf transfer flag of Channel 4
#define  DMA_STS_ERRIF4                      ((uint32_t)0x00008000)       //!< ransfer error flag of Channel 4

#define  DMA_STS_GIF5                        ((uint32_t)0x00010000)       //!< lobal interrupt flag of Channel 5
#define  DMA_STS_CMPIF5                      ((uint32_t)0x00020000)       //!< ransfer complete flag of Channel 5
#define  DMA_STS_HLFIF5                      ((uint32_t)0x00040000)       //!< alf transfer flag of Channel 5
#define  DMA_STS_ERRIF5                      ((uint32_t)0x00080000)       //!< ransfer error flag of Channel 5

#define  DMA_STS_GIF6                        ((uint32_t)0x00100000)       //!< lobal interrupt flag of Channel 6
#define  DMA_STS_CMPIF6                      ((uint32_t)0x00200000)       //!< ransfer complete flag of Channel 6
#define  DMA_STS_HLFIF6                      ((uint32_t)0x00400000)       //!< alf transfer flag of Channel 6
#define  DMA_STS_ERRIF6                      ((uint32_t)0x00800000)       //!< ransfer error flag of Channel 6

#define  DMA_STS_GIF7                        ((uint32_t)0x01000000)       //!< lobal interrupt flag of Channel 7
#define  DMA_STS_CMPIF7                      ((uint32_t)0x02000000)       //!< ransfer complete flag of Channel 7
#define  DMA_STS_HLFIF7                      ((uint32_t)0x04000000)       //!< alf transfer flag of Channel 7
#define  DMA_STS_ERRIF7                      ((uint32_t)0x08000000)       //!< ransfer error flag of Channel 7

/**
* @brief DMA_INTFC register  Bit definition
*/
#define  DMA_INTFC_GIFC1                     ((uint32_t)0x00000001)        //!<Global interrupt flag clear of Channel 1
#define  DMA_INTFC_CMPIFC1                   ((uint32_t)0x00000002)        //!<Transfer complete flag clear of Channe 1
#define  DMA_INTFC_HLFIFC1                   ((uint32_t)0x00000004)        //!<Half transfer flag clear of Channel 1
#define  DMA_INTFC_ERRIFC1                   ((uint32_t)0x00000008)        //!<Transfer error flag clear of Channel 1

#define  DMA_INTFC_GIFC2                     ((uint32_t)0x00000010)        //!<Global interrupt flag clear of Channel 2
#define  DMA_INTFC_CMPIFC2                   ((uint32_t)0x00000020)        //!<Transfer complete flag clear of Channe 2
#define  DMA_INTFC_HLFIFC2                   ((uint32_t)0x00000040)        //!<Half transfer flag clear of Channel 2
#define  DMA_INTFC_ERRIFC2                   ((uint32_t)0x00000080)        //!<Transfer error flag clear of Channel 2

#define  DMA_INTFC_GIFC3                     ((uint32_t)0x00000100)        //!<Global interrupt flag clear of Channel 3
#define  DMA_INTFC_CMPIFC3                   ((uint32_t)0x00000200)        //!<Transfer complete flag clear of Channe 3
#define  DMA_INTFC_HLFIFC3                   ((uint32_t)0x00000400)        //!<Half transfer flag clear of Channel 3
#define  DMA_INTFC_ERRIFC3                   ((uint32_t)0x00000800)        //!<Transfer error flag clear of Channel 3

#define  DMA_INTFC_GIFC4                     ((uint32_t)0x00001000)        //!<Global interrupt flag clear of Channel 4
#define  DMA_INTFC_CMPIFC4                   ((uint32_t)0x00002000)        //!<Transfer complete flag clear of Channe 4
#define  DMA_INTFC_HLFIFC4                   ((uint32_t)0x00004000)        //!<Half transfer flag clear of Channel 4
#define  DMA_INTFC_ERRIFC4                   ((uint32_t)0x00008000)        //!<Transfer error flag clear of Channel 4

#define  DMA_INTFC_GIFC5                     ((uint32_t)0x00010000)        //!<Global interrupt flag clear of Channel 5
#define  DMA_INTFC_CMPIFC5                   ((uint32_t)0x00020000)        //!<Transfer complete flag clear of Channe 5
#define  DMA_INTFC_HLFIFC5                   ((uint32_t)0x00040000)        //!<Half transfer flag clear of Channel 5
#define  DMA_INTFC_ERRIFC5                   ((uint32_t)0x00080000)        //!<Transfer error flag clear of Channel 5

#define  DMA_INTFC_GIFC6                     ((uint32_t)0x00100000)        //!<Global interrupt flag clear of Channel 6
#define  DMA_INTFC_CMPIFC6                   ((uint32_t)0x00200000)        //!<Transfer complete flag clear of Channe 6
#define  DMA_INTFC_HLFIFC6                   ((uint32_t)0x00400000)        //!<Half transfer flag clear of Channel 6
#define  DMA_INTFC_ERRIFC6                   ((uint32_t)0x00800000)        //!<Transfer error flag clear of Channel 6

#define  DMA_INTFC_GIFC7                     ((uint32_t)0x01000000)        //!<Global interrupt flag clear of Channel 7
#define  DMA_INTFC_CMPIFC7                   ((uint32_t)0x02000000)        //!<Transfer complete flag clear of Channe 7
#define  DMA_INTFC_HLFIFC7                   ((uint32_t)0x04000000)        //!<Half transfer flag clear of Channel 7
#define  DMA_INTFC_ERRIFC7                   ((uint32_t)0x08000000)        //!<Transfer error flag clear of Channel 7

/**
* @brief DMA_CHxCTR register Bit definition
*/
#define  DMA_CHxCTR_CEN                      ((uint32_t)0x00000001)        //!<Channel enable
#define  DMA_CHxCTR_CMPIE                    ((uint32_t)0x00000002)        //!<Enable bit for Transfer complete interrupt
#define  DMA_CHxCTR_HLFIE                    ((uint32_t)0x00000004)        //!<Enable bit for Half transfer interrupt
#define  DMA_CHxCTR_ERRIE                    ((uint32_t)0x00000008)        //!<Enable bit for Transfer error interrupt
#define  DMA_CHxCTR_DIR                      ((uint32_t)0x00000010)        //!<Direction of transfer
#define  DMA_CHxCTR_CIRM                     ((uint32_t)0x00000020)        //!<Circular mode
#define  DMA_CHxCTR_PAGM                     ((uint32_t)0x00000040)        //!<Peripheral address generation mode
#define  DMA_CHxCTR_MAGM                     ((uint32_t)0x00000080)        //!<Memory address generation mode

#define  DMA_CHxCTR_PWDH                     ((uint32_t)0x00000300)        //!<Peripheral width PWDH[1:0] bits
#define  DMA_CHxCTR_PWDH_0                   ((uint32_t)0x00000100)        //!<Bit 0
#define  DMA_CHxCTR_PWDH_1                   ((uint32_t)0x00000200)        //!<Bit 1

#define  DMA_CHxCTR_MWDH                     ((uint32_t)0x00000C00)        //!<Memory width MWDH[1:0] bits
#define  DMA_CHxCTR_MWDH_0                   ((uint32_t)0x00000400)        //!<Bit 0
#define  DMA_CHxCTR_MWDH_1                   ((uint32_t)0x00000800)        //!<Bit 1

#define  DMA_CHxCTR_PRIL                     ((uint32_t)0x00003000)        //!<Priority level of Channel PRIL[1:0]bits
#define  DMA_CHxCTR_PRIL_0                   ((uint32_t)0x00001000)        //!<Bit 0
#define  DMA_CHxCTR_PRIL_1                   ((uint32_t)0x00002000)        //!<Bit 1

#define  DMA_CHxCTR_M2MM                     ((uint32_t)0x00004000)        //!<Memory to memory mode

/**
* @brief DMA_CHxNUM register Bit definition
*/
#define  DMA_CHxNUM_NUM                      ((uint32_t)0x0000FFFF)        //!<Number of data to Transfer

/**
* @brief DMA_CHxPA register Bit definition
*/
#define  DMA_CHxPA_PADR                      ((uint32_t)0xFFFFFFFF)        //!<Peripheral Address

/**
* @brief DMA_CHxMA register Bit definition
*/
#define  DMA_CHxMA_MADR                      ((uint32_t)0xFFFFFFFF)        //!<Memory Address

/**
* @brief DMA_RMPCR1 register Bit definition
*/
#define DMA_RMPCR1_DEFAULT                   ((uint32_t)0x00000000)        //!<Default remap position for DMA1
#define DMA_RMPCR1_CH1_ADC                   ((uint32_t)0x00000001)        //!<Remap ADC on DMA1 Channel 1
#define DMA_RMPCR1_CH1_TIM17_CH1             ((uint32_t)0x00000007)        //!<Remap TIM17 channel 1 on DMA1 channel 1
#define DMA_RMPCR1_CH1_TIM17_UP              ((uint32_t)0x00000007)        //!<Remap TIM17 up on DMA1 channel 1
#define DMA_RMPCR1_CH1_USART1_RX             ((uint32_t)0x00000008)        //!<Remap USART1 Rx on DMA1 channel 1
#define DMA_RMPCR1_CH1_USART2_RX             ((uint32_t)0x00000009)        //!<Remap USART2 Rx on DMA1 channel 1
#define DMA_RMPCR1_CH1_USART3_RX             ((uint32_t)0x0000000A)        //!<Remap USART3 Rx on DMA1 channel 1
#define DMA_RMPCR1_CH1_USART4_RX             ((uint32_t)0x0000000B)        //!<Remap USART4 Rx on DMA1 channel 1
#define DMA_RMPCR1_CH1_USART5_RX             ((uint32_t)0x0000000C)        //!<Remap USART5 Rx on DMA1 channel 1
#define DMA_RMPCR1_CH1_USART6_RX             ((uint32_t)0x0000000D)        //!<Remap USART6 Rx on DMA1 channel 1
#define DMA_RMPCR1_CH1_USART7_RX             ((uint32_t)0x0000000E)        //!<Remap USART7 Rx on DMA1 channel 1
#define DMA_RMPCR1_CH1_USART8_RX             ((uint32_t)0x0000000F)        //!<Remap USART8 Rx on DMA1 channel 1
#define DMA_RMPCR1_CH2_ADC                   ((uint32_t)0x00000010)        //!<Remap ADC on DMA1 channel 2
#define DMA_RMPCR1_CH2_I2C1_TX               ((uint32_t)0x00000020)        //!<Remap I2C1 Tx on DMA1 channel 2
#define DMA_RMPCR1_CH2_SPI_1RX               ((uint32_t)0x00000030)        //!<Remap SPI1 Rx on DMA1 channel 2
#define DMA_RMPCR1_CH2_TIM1_CH1              ((uint32_t)0x00000040)        //!<Remap TIM1 channel 1 on DMA1 channel 2
#define DMA_RMPCR1_CH2_TIM17_CH1             ((uint32_t)0x00000070)        //!<Remap TIM17 channel 1 on DMA1 channel 2
#define DMA_RMPCR1_CH2_TIM17_UP              ((uint32_t)0x00000070)        //!<Remap TIM17 up on DMA1 channel 2
#define DMA_RMPCR1_CH2_USART1_TX             ((uint32_t)0x00000080)        //!<Remap USART1 Tx on DMA1 channel 2
#define DMA_RMPCR1_CH2_USART2_TX             ((uint32_t)0x00000090)        //!<Remap USART2 Tx on DMA1 channel 2
#define DMA_RMPCR1_CH2_USART3_TX             ((uint32_t)0x000000A0)        //!<Remap USART3 Tx on DMA1 channel 2
#define DMA_RMPCR1_CH2_USART4_TX             ((uint32_t)0x000000B0)        //!<Remap USART4 Tx on DMA1 channel 2
#define DMA_RMPCR1_CH2_USART5_TX             ((uint32_t)0x000000C0)        //!<Remap USART5 Tx on DMA1 channel 2
#define DMA_RMPCR1_CH2_USART6_TX             ((uint32_t)0x000000D0)        //!<Remap USART6 Tx on DMA1 channel 2
#define DMA_RMPCR1_CH2_USART7_TX             ((uint32_t)0x000000E0)        //!<Remap USART7 Tx on DMA1 channel 2
#define DMA_RMPCR1_CH2_USART8_TX             ((uint32_t)0x000000F0)        //!<Remap USART8 Tx on DMA1 channel 2
#define DMA_RMPCR1_CH3_TIM6_UP               ((uint32_t)0x00000100)        //!<Remap TIM6 up on DMA1 channel 3
#define DMA_RMPCR1_CH3_DAC_CH1               ((uint32_t)0x00000100)        //!<Remap DAC Channel 1on DMA1 channel 3
#define DMA_RMPCR1_CH3_I2C1_RX               ((uint32_t)0x00000200)        //!<Remap I2C1 Rx on DMA1 channel 3
#define DMA_RMPCR1_CH3_SPI1_TX               ((uint32_t)0x00000300)        //!<Remap SPI1 Tx on DMA1 channel 3
#define DMA_RMPCR1_CH3_TIM1_CH2              ((uint32_t)0x00000400)        //!<Remap TIM1 channel 2 on DMA1 channel 3
#define DMA_RMPCR1_CH3_TIM2_CH2              ((uint32_t)0x00000500)        //!<Remap TIM2 channel 2 on DMA1 channel 3
#define DMA_RMPCR1_CH3_TIM16_CH1             ((uint32_t)0x00000700)        //!<Remap TIM16 channel 1 on DMA1 channel 3
#define DMA_RMPCR1_CH3_TIM16_UP              ((uint32_t)0x00000700)        //!<Remap TIM16 up on DMA1 channel 3
#define DMA_RMPCR1_CH3_USART1_RX             ((uint32_t)0x00000800)        //!<Remap USART1 Rx on DMA1 channel 3
#define DMA_RMPCR1_CH3_USART2_RX             ((uint32_t)0x00000900)        //!<Remap USART2 Rx on DMA1 channel 3
#define DMA_RMPCR1_CH3_USART3_RX             ((uint32_t)0x00000A00)        //!<Remap USART3 Rx on DMA1 channel 3
#define DMA_RMPCR1_CH3_USART4_RX             ((uint32_t)0x00000B00)        //!<Remap USART4 Rx on DMA1 channel 3
#define DMA_RMPCR1_CH3_USART5_RX             ((uint32_t)0x00000C00)        //!<Remap USART5 Rx on DMA1 channel 3
#define DMA_RMPCR1_CH3_USART6_RX             ((uint32_t)0x00000D00)        //!<Remap USART6 Rx on DMA1 channel 3
#define DMA_RMPCR1_CH3_USART7_RX             ((uint32_t)0x00000E00)        //!<Remap USART7 Rx on DMA1 channel 3
#define DMA_RMPCR1_CH3_USART8_RX             ((uint32_t)0x00000F00)        //!<Remap USART8 Rx on DMA1 channel 3
#define DMA_RMPCR1_CH4_TIM7_UP               ((uint32_t)0x00001000)        //!<Remap TIM7 up on DMA1 channel 4
#define DMA_RMPCR1_CH4_DAC_CH2               ((uint32_t)0x00001000)        //!<Remap DAC Channel 2 on DMA1 channel 4
#define DMA_RMPCR1_CH4_I2C2_TX               ((uint32_t)0x00002000)        //!<Remap I2C2 Tx on DMA1 channel 4
#define DMA_RMPCR1_CH4_SPI2_RX               ((uint32_t)0x00003000)        //!<Remap SPI2 Rx on DMA1 channel 4
#define DMA_RMPCR1_CH4_TIM2_CH4              ((uint32_t)0x00005000)        //!<Remap TIM2 channel 4 on DMA1 channel 4
#define DMA_RMPCR1_CH4_TIM3_CH1              ((uint32_t)0x00006000)        //!<Remap TIM3 channel 1 on DMA1 channel 4
#define DMA_RMPCR1_CH4_TIM3_TRIG             ((uint32_t)0x00006000)        //!<Remap TIM3 Trig on DMA1 channel 4
#define DMA_RMPCR1_CH4_TIM16_CH1             ((uint32_t)0x00007000)        //!<Remap TIM16 channel 1 on DMA1 channel 4
#define DMA_RMPCR1_CH4_TIM16_UP              ((uint32_t)0x00007000)        //!<Remap TIM16 up on DMA1 channel 4
#define DMA_RMPCR1_CH4_USART1_TX             ((uint32_t)0x00008000)        //!<Remap USART1 Tx on DMA1 channel 4
#define DMA_RMPCR1_CH4_USART2_TX             ((uint32_t)0x00009000)        //!<Remap USART2 Tx on DMA1 channel 4
#define DMA_RMPCR1_CH4_USART3_TX             ((uint32_t)0x0000A000)        //!<Remap USART3 Tx on DMA1 channel 4
#define DMA_RMPCR1_CH4_USART4_TX             ((uint32_t)0x0000B000)        //!<Remap USART4 Tx on DMA1 channel 4
#define DMA_RMPCR1_CH4_USART5_TX             ((uint32_t)0x0000C000)        //!<Remap USART5 Tx on DMA1 channel 4
#define DMA_RMPCR1_CH4_USART6_TX             ((uint32_t)0x0000D000)        //!<Remap USART6 Tx on DMA1 channel 4
#define DMA_RMPCR1_CH4_USART7_TX             ((uint32_t)0x0000E000)        //!<Remap USART7 Tx on DMA1 channel 4
#define DMA_RMPCR1_CH4_USART8_TX             ((uint32_t)0x0000F000)        //!<Remap USART8 Tx on DMA1 channel 4
#define DMA_RMPCR1_CH5_I2C2_RX               ((uint32_t)0x00020000)        //!<Remap I2C2 Rx on DMA1 channel 5
#define DMA_RMPCR1_CH5_SPI2_TX               ((uint32_t)0x00030000)        //!<Remap SPI1 Tx on DMA1 channel 5
#define DMA_RMPCR1_CH5_TIM1_CH3              ((uint32_t)0x00040000)        //!<Remap TIM1 channel 3 on DMA1 channel 5
#define DMA_RMPCR1_CH5_USART1_RX             ((uint32_t)0x00080000)        //!<Remap USART1 Rx on DMA1 channel 5
#define DMA_RMPCR1_CH5_USART2_RX             ((uint32_t)0x00090000)        //!<Remap USART2 Rx on DMA1 channel 5
#define DMA_RMPCR1_CH5_USART3_RX             ((uint32_t)0x000A0000)        //!<Remap USART3 Rx on DMA1 channel 5
#define DMA_RMPCR1_CH5_USART4_RX             ((uint32_t)0x000B0000)        //!<Remap USART4 Rx on DMA1 channel 5
#define DMA_RMPCR1_CH5_USART5_RX             ((uint32_t)0x000C0000)        //!<Remap USART5 Rx on DMA1 channel 5
#define DMA_RMPCR1_CH5_USART6_RX             ((uint32_t)0x000D0000)        //!<Remap USART6 Rx on DMA1 channel 5
#define DMA_RMPCR1_CH5_USART7_RX             ((uint32_t)0x000E0000)        //!<Remap USART7 Rx on DMA1 channel 5
#define DMA_RMPCR1_CH5_USART8_RX             ((uint32_t)0x000F0000)        //!<Remap USART8 Rx on DMA1 channel 5
#define DMA_RMPCR1_CH6_I2C1_TX               ((uint32_t)0x00200000)        //!<Remap I2C1 Tx on DMA1 channel 6
#define DMA_RMPCR1_CH6_SPI2_RX               ((uint32_t)0x00300000)        //!<Remap SPI2 Rx on DMA1 channel 6
#define DMA_RMPCR1_CH6_TIM1_CH1              ((uint32_t)0x00400000)        //!<Remap TIM1 channel 1 on DMA1 channel 6
#define DMA_RMPCR1_CH6_TIM1_CH2              ((uint32_t)0x00400000)        //!<Remap TIM1 channel 2 on DMA1 channel 6
#define DMA_RMPCR1_CH6_TIM1_CH3              ((uint32_t)0x00400000)        //!<Remap TIM1 channel 3 on DMA1 channel 6
#define DMA_RMPCR1_CH6_TIM3_CH1              ((uint32_t)0x00600000)        //!<Remap TIM3 channel 1 on DMA1 channel 6
#define DMA_RMPCR1_CH6_TIM3_TRIG             ((uint32_t)0x00600000)        //!<Remap TIM3 Trig on DMA1 channel 6
#define DMA_RMPCR1_CH6_TIM16_CH1             ((uint32_t)0x00700000)        //!<Remap TIM16 channel 1 on DMA1 channel 6
#define DMA_RMPCR1_CH6_TIM16_UP              ((uint32_t)0x00700000)        //!<Remap TIM16 up on DMA1 channel 6
#define DMA_RMPCR1_CH6_USART1_RX             ((uint32_t)0x00800000)        //!<Remap USART1 Rx on DMA1 channel 6
#define DMA_RMPCR1_CH6_USART2_RX             ((uint32_t)0x00900000)        //!<Remap USART2 Rx on DMA1 channel 6
#define DMA_RMPCR1_CH6_USART3_RX             ((uint32_t)0x00A00000)        //!<Remap USART3 Rx on DMA1 channel 6
#define DMA_RMPCR1_CH6_USART4_RX             ((uint32_t)0x00B00000)        //!<Remap USART4 Rx on DMA1 channel 6
#define DMA_RMPCR1_CH6_USART5_RX             ((uint32_t)0x00C00000)        //!<Remap USART5 Rx on DMA1 channel 6
#define DMA_RMPCR1_CH6_USART6_RX             ((uint32_t)0x00D00000)        //!<Remap USART6 Rx on DMA1 channel 6
#define DMA_RMPCR1_CH6_USART7_RX             ((uint32_t)0x00E00000)        //!<Remap USART7 Rx on DMA1 channel 6
#define DMA_RMPCR1_CH6_USART8_RX             ((uint32_t)0x00F00000)        //!<Remap USART8 Rx on DMA1 channel 6
#define DMA_RMPCR1_CH7_I2C1_RX               ((uint32_t)0x02000000)        //!<Remap I2C1 Rx on DMA1 channel 7
#define DMA_RMPCR1_CH7_SPI2_TX               ((uint32_t)0x03000000)        //!<Remap SPI2 Tx on DMA1 channel 7
#define DMA_RMPCR1_CH7_TIM2_CH2              ((uint32_t)0x05000000)        //!<Remap TIM2 channel 2 on DMA1 channel 7
#define DMA_RMPCR1_CH7_TIM2_CH4              ((uint32_t)0x05000000)        //!<Remap TIM2 channel 4 on DMA1 channel 7
#define DMA_RMPCR1_CH7_TIM17_CH1             ((uint32_t)0x07000000)        //!<Remap TIM17 channel 1 on DMA1 channel 7
#define DMA_RMPCR1_CH7_TIM17_UP              ((uint32_t)0x07000000)        //!<Remap TIM17 up on DMA1 channel 7
#define DMA_RMPCR1_CH7_USART1_TX             ((uint32_t)0x08000000)        //!<Remap USART1 Tx on DMA1 channel 7
#define DMA_RMPCR1_CH7_USART2_TX             ((uint32_t)0x09000000)        //!<Remap USART2 Tx on DMA1 channel 7
#define DMA_RMPCR1_CH7_USART3_TX             ((uint32_t)0x0A000000)        //!<Remap USART3 Tx on DMA1 channel 7
#define DMA_RMPCR1_CH7_USART4_TX             ((uint32_t)0x0B000000)        //!<Remap USART4 Tx on DMA1 channel 7
#define DMA_RMPCR1_CH7_USART5_TX             ((uint32_t)0x0C000000)        //!<Remap USART5 Tx on DMA1 channel 7
#define DMA_RMPCR1_CH7_USART6_TX             ((uint32_t)0x0D000000)        //!<Remap USART6 Tx on DMA1 channel 7
#define DMA_RMPCR1_CH7_USART7_TX             ((uint32_t)0x0E000000)        //!<Remap USART7 Tx on DMA1 channel 7
#define DMA_RMPCR1_CH7_USART8_TX             ((uint32_t)0x0F000000)        //!<Remap USART8 Tx on DMA1 channel 7

/**
* @brief DMA_RMPCR2 register Bit definition
*/
#define DMA_RMPCR2_DEFAULT                   ((uint32_t)0x00000000)        //!<Default remap position for DMA2
#define DMA_RMPCR2_CH1_I2C2_TX               ((uint32_t)0x00000002)        //!<Remap I2C2 TX on DMA2 channel 1
#define DMA_RMPCR2_CH1_USART1_TX             ((uint32_t)0x00000008)        //!<Remap USART1 Tx on DMA2 channel 1
#define DMA_RMPCR2_CH1_USART2_TX             ((uint32_t)0x00000009)        //!<Remap USART2 Tx on DMA2 channel 1
#define DMA_RMPCR2_CH1_USART3_TX             ((uint32_t)0x0000000A)        //!<Remap USART3 Tx on DMA2 channel 1
#define DMA_RMPCR2_CH1_USART4_TX             ((uint32_t)0x0000000B)        //!<Remap USART4 Tx on DMA2 channel 1
#define DMA_RMPCR2_CH1_USART5_TX             ((uint32_t)0x0000000C)        //!<Remap USART5 Tx on DMA2 channel 1
#define DMA_RMPCR2_CH1_USART6_TX             ((uint32_t)0x0000000D)        //!<Remap USART6 Tx on DMA2 channel 1
#define DMA_RMPCR2_CH1_USART7_TX             ((uint32_t)0x0000000E)        //!<Remap USART7 Tx on DMA2 channel 1
#define DMA_RMPCR2_CH1_USART8_TX             ((uint32_t)0x0000000F)        //!<Remap USART8 Tx on DMA2 channel 1
#define DMA_RMPCR2_CH2_I2C2_RX               ((uint32_t)0x00000020)        //!<Remap I2C2 Rx on DMA2 channel 2
#define DMA_RMPCR2_CH2_USART1_RX             ((uint32_t)0x00000080)        //!<Remap USART1 Rx on DMA2 channel 2
#define DMA_RMPCR2_CH2_USART2_RX             ((uint32_t)0x00000090)        //!<Remap USART2 Rx on DMA2 channel 2
#define DMA_RMPCR2_CH2_USART3_RX             ((uint32_t)0x000000A0)        //!<Remap USART3 Rx on DMA2 channel 2
#define DMA_RMPCR2_CH2_USART4_RX             ((uint32_t)0x000000B0)        //!<Remap USART4 Rx on DMA2 channel 2
#define DMA_RMPCR2_CH2_USART5_RX             ((uint32_t)0x000000C0)        //!<Remap USART5 Rx on DMA2 channel 2
#define DMA_RMPCR2_CH2_USART6_RX             ((uint32_t)0x000000D0)        //!<Remap USART6 Rx on DMA2 channel 2
#define DMA_RMPCR2_CH2_USART7_RX             ((uint32_t)0x000000E0)        //!<Remap USART7 Rx on DMA2 channel 2
#define DMA_RMPCR2_CH2_USART8_RX             ((uint32_t)0x000000F0)        //!<Remap USART8 Rx on DMA2 channel 2
#define DMA_RMPCR2_CH3_TIM6_UP               ((uint32_t)0x00000100)        //!<Remap TIM6 up on DMA2 channel 3
#define DMA_RMPCR2_CH3_DAC_CH1               ((uint32_t)0x00000100)        //!<Remap DAC channel 1 on DMA2 channel 3
#define DMA_RMPCR2_CH3_SPI1_RX               ((uint32_t)0x00000300)        //!<Remap SPI1 Rx on DMA2 channel 3
#define DMA_RMPCR2_CH3_USART1_RX             ((uint32_t)0x00000800)        //!<Remap USART1 Rx on DMA2 channel 3
#define DMA_RMPCR2_CH3_USART2_RX             ((uint32_t)0x00000900)        //!<Remap USART2 Rx on DMA2 channel 3
#define DMA_RMPCR2_CH3_USART3_RX             ((uint32_t)0x00000A00)        //!<Remap USART3 Rx on DMA2 channel 3
#define DMA_RMPCR2_CH3_USART4_RX             ((uint32_t)0x00000B00)        //!<Remap USART4 Rx on DMA2 channel 3
#define DMA_RMPCR2_CH3_USART5_RX             ((uint32_t)0x00000C00)        //!<Remap USART5 Rx on DMA2 channel 3
#define DMA_RMPCR2_CH3_USART6_RX             ((uint32_t)0x00000D00)        //!<Remap USART6 Rx on DMA2 channel 3
#define DMA_RMPCR2_CH3_USART7_RX             ((uint32_t)0x00000E00)        //!<Remap USART7 Rx on DMA2 channel 3
#define DMA_RMPCR2_CH3_USART8_RX             ((uint32_t)0x00000F00)        //!<Remap USART8 Rx on DMA2 channel 3
#define DMA_RMPCR2_CH4_TIM7_UP               ((uint32_t)0x00001000)        //!<Remap TIM7 up on DMA2 channel 4
#define DMA_RMPCR2_CH4_DAC_CH2               ((uint32_t)0x00001000)        //!<Remap DAC channel 2 on DMA2 channel 4
#define DMA_RMPCR2_CH4_SPI1_TX               ((uint32_t)0x00003000)        //!<Remap SPI1 Tx on DMA2 channel 4
#define DMA_RMPCR2_CH4_USART1_TX             ((uint32_t)0x00008000)        //!<Remap USART1 Tx on DMA2 channel 4
#define DMA_RMPCR2_CH4_USART2_TX             ((uint32_t)0x00009000)        //!<Remap USART2 Tx on DMA2 channel 4
#define DMA_RMPCR2_CH4_USART3_TX             ((uint32_t)0x0000A000)        //!<Remap USART3 Tx on DMA2 channel 4
#define DMA_RMPCR2_CH4_USART4_TX             ((uint32_t)0x0000B000)        //!<Remap USART4 Tx on DMA2 channel 4
#define DMA_RMPCR2_CH4_USART5_TX             ((uint32_t)0x0000C000)        //!<Remap USART5 Tx on DMA2 channel 4
#define DMA_RMPCR2_CH4_USART6_TX             ((uint32_t)0x0000D000)        //!<Remap USART6 Tx on DMA2 channel 4
#define DMA_RMPCR2_CH4_USART7_TX             ((uint32_t)0x0000E000)        //!<Remap USART7 Tx on DMA2 channel 4
#define DMA_RMPCR2_CH4_USART8_TX             ((uint32_t)0x0000F000)        //!<Remap USART8 Tx on DMA2 channel 4
#define DMA_RMPCR2_CH5_ADC                   ((uint32_t)0x00010000)        //!<Remap ADC on DMA2 channel 5
#define DMA_RMPCR2_CH5_USART1_TX             ((uint32_t)0x00080000)        //!<Remap USART1 Tx on DMA2 channel 5
#define DMA_RMPCR2_CH5_USART2_TX             ((uint32_t)0x00090000)        //!<Remap USART2 Tx on DMA2 channel 5
#define DMA_RMPCR2_CH5_USART3_TX             ((uint32_t)0x000A0000)        //!<Remap USART3 Tx on DMA2 channel 5
#define DMA_RMPCR2_CH5_USART4_TX             ((uint32_t)0x000B0000)        //!<Remap USART4 Tx on DMA2 channel 5
#define DMA_RMPCR2_CH5_USART5_TX             ((uint32_t)0x000C0000)        //!<Remap USART5 Tx on DMA2 channel 5
#define DMA_RMPCR2_CH5_USART6_TX             ((uint32_t)0x000D0000)        //!<Remap USART6 Tx on DMA2 channel 5
#define DMA_RMPCR2_CH5_USART7_TX             ((uint32_t)0x000E0000)        //!<Remap USART7 Tx on DMA2 channel 5
#define DMA_RMPCR2_CH5_USART8_TX             ((uint32_t)0x000F0000)        //!<Remap USART8 Tx on DMA2 channel 5

/*---------------------------------------------------------------------------*/
/*          External Interrupt/Event Controler (EXTI)                        */
/*---------------------------------------------------------------------------*/

/**
* @brief EXTI_INTEN register Bit definition
*/
#define  EXTI_INTEN_INTEN0                    ((uint32_t)0x00000001)        //! Interrupt enable for line0
#define  EXTI_INTEN_INTEN1                    ((uint32_t)0x00000002)        //! Interrupt enable for line1
#define  EXTI_INTEN_INTEN2                    ((uint32_t)0x00000004)        //! Interrupt enable for line2
#define  EXTI_INTEN_INTEN3                    ((uint32_t)0x00000008)        //! Interrupt enable for line3
#define  EXTI_INTEN_INTEN4                    ((uint32_t)0x00000010)        //! Interrupt enable for line4
#define  EXTI_INTEN_INTEN5                    ((uint32_t)0x00000020)        //! Interrupt enable for line5
#define  EXTI_INTEN_INTEN6                    ((uint32_t)0x00000040)        //! Interrupt enable for line6
#define  EXTI_INTEN_INTEN7                    ((uint32_t)0x00000080)        //! Interrupt enable for line7
#define  EXTI_INTEN_INTEN8                    ((uint32_t)0x00000100)        //! Interrupt enable for line8
#define  EXTI_INTEN_INTEN9                    ((uint32_t)0x00000200)        //! Interrupt enable for line9
#define  EXTI_INTEN_INTEN10                   ((uint32_t)0x00000400)        //! Interrupt enable for line10
#define  EXTI_INTEN_INTEN11                   ((uint32_t)0x00000800)        //! Interrupt enable for line11
#define  EXTI_INTEN_INTEN12                   ((uint32_t)0x00001000)        //! Interrupt enable for line12
#define  EXTI_INTEN_INTEN13                   ((uint32_t)0x00002000)        //! Interrupt enable for line13
#define  EXTI_INTEN_INTEN14                   ((uint32_t)0x00004000)        //! Interrupt enable for line14
#define  EXTI_INTEN_INTEN15                   ((uint32_t)0x00008000)        //! Interrupt enable for line15
#define  EXTI_INTEN_INTEN16                   ((uint32_t)0x00010000)        //! Interrupt enable for line16
#define  EXTI_INTEN_INTEN17                   ((uint32_t)0x00020000)        //! Interrupt enable for line17
#define  EXTI_INTEN_INTEN18                   ((uint32_t)0x00040000)        //! Interrupt enable for line18
#define  EXTI_INTEN_INTEN19                   ((uint32_t)0x00080000)        //! Interrupt enable for line19
#define  EXTI_INTEN_INTEN20                   ((uint32_t)0x00100000)        //! Interrupt enable for line20
#define  EXTI_INTEN_INTEN21                   ((uint32_t)0x00200000)        //! Interrupt enable for line21
#define  EXTI_INTEN_INTEN22                   ((uint32_t)0x00400000)        //! Interrupt enable for line22
#define  EXTI_INTEN_INTEN23                   ((uint32_t)0x00800000)        //! Interrupt enable for line23
#define  EXTI_INTEN_INTEN24                   ((uint32_t)0x01000000)        //! Interrupt enable for line24
#define  EXTI_INTEN_INTEN25                   ((uint32_t)0x02000000)        //! Interrupt enable for line25
#define  EXTI_INTEN_INTEN26                   ((uint32_t)0x04000000)        //! Interrupt enable for line26
#define  EXTI_INTEN_INTEN27                   ((uint32_t)0x08000000)        //! Interrupt enable for line27
#define  EXTI_INTEN_INTEN28                   ((uint32_t)0x10000000)        //! Interrupt enable for line28
#define  EXTI_INTEN_INTEN29                   ((uint32_t)0x20000000)        //! Interrupt enable for line29
#define  EXTI_INTEN_INTEN30                   ((uint32_t)0x40000000)        //! Interrupt enable for line30
#define  EXTI_INTEN_INTEN31                   ((uint32_t)0x80000000)        //! Interrupt enable for line31

/**
* @brief EXTI_EVTEN register Bit definition
*/
#define  EXTI_EVTEN_EVTEN0                    ((uint32_t)0x00000001)        //! Event enable for line0
#define  EXTI_EVTEN_EVTEN1                    ((uint32_t)0x00000002)        //! Event enable for line1
#define  EXTI_EVTEN_EVTEN2                    ((uint32_t)0x00000004)        //! Event enable for line2
#define  EXTI_EVTEN_EVTEN3                    ((uint32_t)0x00000008)        //! Event enable for line3
#define  EXTI_EVTEN_EVTEN4                    ((uint32_t)0x00000010)        //! Event enable for line4
#define  EXTI_EVTEN_EVTEN5                    ((uint32_t)0x00000020)        //! Event enable for line5
#define  EXTI_EVTEN_EVTEN6                    ((uint32_t)0x00000040)        //! Event enable for line6
#define  EXTI_EVTEN_EVTEN7                    ((uint32_t)0x00000080)        //! Event enable for line7
#define  EXTI_EVTEN_EVTEN8                    ((uint32_t)0x00000100)        //! Event enable for line8
#define  EXTI_EVTEN_EVTEN9                    ((uint32_t)0x00000200)        //! Event enable for line9
#define  EXTI_EVTEN_EVTEN10                   ((uint32_t)0x00000400)        //! Event enable for line10
#define  EXTI_EVTEN_EVTEN11                   ((uint32_t)0x00000800)        //! Event enable for line11
#define  EXTI_EVTEN_EVTEN12                   ((uint32_t)0x00001000)        //! Event enable for line12
#define  EXTI_EVTEN_EVTEN13                   ((uint32_t)0x00002000)        //! Event enable for line13
#define  EXTI_EVTEN_EVTEN14                   ((uint32_t)0x00004000)        //! Event enable for line14
#define  EXTI_EVTEN_EVTEN15                   ((uint32_t)0x00008000)        //! Event enable for line15
#define  EXTI_EVTEN_EVTEN16                   ((uint32_t)0x00010000)        //! Event enable for line16
#define  EXTI_EVTEN_EVTEN17                   ((uint32_t)0x00020000)        //! Event enable for line17
#define  EXTI_EVTEN_EVTEN18                   ((uint32_t)0x00040000)        //! Event enable for line18
#define  EXTI_EVTEN_EVTEN19                   ((uint32_t)0x00080000)        //! Event enable for line19
#define  EXTI_EVTEN_EVTEN20                   ((uint32_t)0x00100000)        //! Event enable for line20
#define  EXTI_EVTEN_EVTEN21                   ((uint32_t)0x00200000)        //! Event enable for line21
#define  EXTI_EVTEN_EVTEN22                   ((uint32_t)0x00400000)        //! Event enable for line22
#define  EXTI_EVTEN_EVTEN23                   ((uint32_t)0x00800000)        //! Event enable for line23
#define  EXTI_EVTEN_EVTEN24                   ((uint32_t)0x01000000)        //! Event enable for line24
#define  EXTI_EVTEN_EVTEN25                   ((uint32_t)0x02000000)        //! Event enable for line25
#define  EXTI_EVTEN_EVTEN26                   ((uint32_t)0x04000000)        //! Event enable for line26
#define  EXTI_EVTEN_EVTEN27                   ((uint32_t)0x08000000)        //! Event enable for line27
#define  EXTI_EVTEN_EVTEN28                   ((uint32_t)0x10000000)        //! Event enable for line28
#define  EXTI_EVTEN_EVTEN29                   ((uint32_t)0x20000000)        //! Event enable for line29
#define  EXTI_EVTEN_EVTEN30                   ((uint32_t)0x40000000)        //! Event enable for line30
#define  EXTI_EVTEN_EVTEN31                   ((uint32_t)0x80000000)        //! Event enable for line31

/**
* @brief  EXTI_RTEN register Bit definition
*/
#define  EXTI_RTEN_RTEN0                      ((uint32_t)0x00000001)        //! Rising edge trigger enable for line0
#define  EXTI_RTEN_RTEN1                      ((uint32_t)0x00000002)        //! Rising edge trigger enable for line1
#define  EXTI_RTEN_RTEN2                      ((uint32_t)0x00000004)        //! Rising edge trigger enable for line2
#define  EXTI_RTEN_RTEN3                      ((uint32_t)0x00000008)        //! Rising edge trigger enable for line3
#define  EXTI_RTEN_RTEN4                      ((uint32_t)0x00000010)        //! Rising edge trigger enable for line4
#define  EXTI_RTEN_RTEN5                      ((uint32_t)0x00000020)        //! Rising edge trigger enable for line5
#define  EXTI_RTEN_RTEN6                      ((uint32_t)0x00000040)        //! Rising edge trigger enable for line6
#define  EXTI_RTEN_RTEN7                      ((uint32_t)0x00000080)        //! Rising edge trigger enable for line7
#define  EXTI_RTEN_RTEN8                      ((uint32_t)0x00000100)        //! Rising edge trigger enable for line8
#define  EXTI_RTEN_RTEN9                      ((uint32_t)0x00000200)        //! Rising edge trigger enable for line9
#define  EXTI_RTEN_RTEN10                     ((uint32_t)0x00000400)        //! Rising edge trigger enable for line10
#define  EXTI_RTEN_RTEN11                     ((uint32_t)0x00000800)        //! Rising edge trigger enable for line11
#define  EXTI_RTEN_RTEN12                     ((uint32_t)0x00001000)        //! Rising edge trigger enable for line12
#define  EXTI_RTEN_RTEN13                     ((uint32_t)0x00002000)        //! Rising edge trigger enable for line13
#define  EXTI_RTEN_RTEN14                     ((uint32_t)0x00004000)        //! Rising edge trigger enable for line14
#define  EXTI_RTEN_RTEN15                     ((uint32_t)0x00008000)        //! Rising edge trigger enable for line15
#define  EXTI_RTEN_RTEN16                     ((uint32_t)0x00010000)        //! Rising edge trigger enable for line16
#define  EXTI_RTEN_RTEN17                     ((uint32_t)0x00020000)        //! Rising edge trigger enable for line17
#define  EXTI_RTEN_RTEN19                     ((uint32_t)0x00080000)        //! Rising edge trigger enable for line19
#define  EXTI_RTEN_RTEN20                     ((uint32_t)0x00100000)        //! Rising edge trigger enable for line20
#define  EXTI_RTEN_RTEN21                     ((uint32_t)0x00200000)        //! Rising edge trigger enable for line21
#define  EXTI_RTEN_RTEN22                     ((uint32_t)0x00400000)        //! Rising edge trigger enable for line22
#define  EXTI_RTEN_RTEN31                     ((uint32_t)0x80000000)        //! Rising edge trigger enable for line31

/**
* @brief EXTI_FTEN register Bit definition
*/
#define  EXTI_FTEN_FTEN0                      ((uint32_t)0x00000001)        //! Falling edge trigger enable for line0
#define  EXTI_FTEN_FTEN1                      ((uint32_t)0x00000002)        //! Falling edge trigger enable for line1
#define  EXTI_FTEN_FTEN2                      ((uint32_t)0x00000004)        //! Falling edge trigger enable for line2
#define  EXTI_FTEN_FTEN3                      ((uint32_t)0x00000008)        //! Falling edge trigger enable for line3
#define  EXTI_FTEN_FTEN4                      ((uint32_t)0x00000010)        //! Falling edge trigger enable for line4
#define  EXTI_FTEN_FTEN5                      ((uint32_t)0x00000020)        //! Falling edge trigger enable for line5
#define  EXTI_FTEN_FTEN6                      ((uint32_t)0x00000040)        //! Falling edge trigger enable for line6
#define  EXTI_FTEN_FTEN7                      ((uint32_t)0x00000080)        //! Falling edge trigger enable for line7
#define  EXTI_FTEN_FTEN8                      ((uint32_t)0x00000100)        //! Falling edge trigger enable for line8
#define  EXTI_FTEN_FTEN9                      ((uint32_t)0x00000200)        //! Falling edge trigger enable for line9
#define  EXTI_FTEN_FTEN10                     ((uint32_t)0x00000400)        //! Falling edge trigger enable for line10
#define  EXTI_FTEN_FTEN11                     ((uint32_t)0x00000800)        //! Falling edge trigger enable for line11
#define  EXTI_FTEN_FTEN12                     ((uint32_t)0x00001000)        //! Falling edge trigger enable for line12
#define  EXTI_FTEN_FTEN13                     ((uint32_t)0x00002000)        //! Falling edge trigger enable for line13
#define  EXTI_FTEN_FTEN14                     ((uint32_t)0x00004000)        //! Falling edge trigger enable for line14
#define  EXTI_FTEN_FTEN15                     ((uint32_t)0x00008000)        //! Falling edge trigger enable for line15
#define  EXTI_FTEN_FTEN16                     ((uint32_t)0x00010000)        //! Falling edge trigger enable for line16
#define  EXTI_FTEN_FTEN17                     ((uint32_t)0x00020000)        //! Falling edge trigger enable for line17
#define  EXTI_FTEN_FTEN19                     ((uint32_t)0x00080000)        //! Falling edge trigger enable for line19
#define  EXTI_FTEN_FTEN20                     ((uint32_t)0x00100000)        //! Falling edge trigger enable for line20
#define  EXTI_FTEN_FTEN21                     ((uint32_t)0x00200000)        //! Falling edge trigger enable for line21
#define  EXTI_FTEN_FTEN22                     ((uint32_t)0x00400000)        //! Falling edge trigger enable for line22
#define  EXTI_FTEN_FTEN31                     ((uint32_t)0x80000000)        //! Falling edge trigger enable for line31

/**
* @brief EXTI_SWTIEN register Bit definition
*/
#define  EXTI_SWTIEN_SWTIEN0                  ((uint32_t)0x00000001)        //! Software trigger interrupt/event for line0
#define  EXTI_SWTIEN_SWTIEN1                  ((uint32_t)0x00000002)        //! Software trigger interrupt/event for line1
#define  EXTI_SWTIEN_SWTIEN2                  ((uint32_t)0x00000004)        //! Software trigger interrupt/event for line2
#define  EXTI_SWTIEN_SWTIEN3                  ((uint32_t)0x00000008)        //! Software trigger interrupt/event for line3
#define  EXTI_SWTIEN_SWTIEN4                  ((uint32_t)0x00000010)        //! Software trigger interrupt/event for line4
#define  EXTI_SWTIEN_SWTIEN5                  ((uint32_t)0x00000020)        //! Software trigger interrupt/event for line5
#define  EXTI_SWTIEN_SWTIEN6                  ((uint32_t)0x00000040)        //! Software trigger interrupt/event for line6
#define  EXTI_SWTIEN_SWTIEN7                  ((uint32_t)0x00000080)        //! Software trigger interrupt/event for line7
#define  EXTI_SWTIEN_SWTIEN8                  ((uint32_t)0x00000100)        //! Software trigger interrupt/event for line8
#define  EXTI_SWTIEN_SWTIEN9                  ((uint32_t)0x00000200)        //! Software trigger interrupt/event for line9
#define  EXTI_SWTIEN_SWTIEN10                 ((uint32_t)0x00000400)        //! Software trigger interrupt/event for line10
#define  EXTI_SWTIEN_SWTIEN11                 ((uint32_t)0x00000800)        //! Software trigger interrupt/event for line11
#define  EXTI_SWTIEN_SWTIEN12                 ((uint32_t)0x00001000)        //! Software trigger interrupt/event for line12
#define  EXTI_SWTIEN_SWTIEN13                 ((uint32_t)0x00002000)        //! Software trigger interrupt/event for line13
#define  EXTI_SWTIEN_SWTIEN14                 ((uint32_t)0x00004000)        //! Software trigger interrupt/event for line14
#define  EXTI_SWTIEN_SWTIEN15                 ((uint32_t)0x00008000)        //! Software trigger interrupt/event for line15
#define  EXTI_SWTIEN_SWTIEN16                 ((uint32_t)0x00010000)        //! Software trigger interrupt/event for line16
#define  EXTI_SWTIEN_SWTIEN17                 ((uint32_t)0x00020000)        //! Software trigger interrupt/event for line17
#define  EXTI_SWTIEN_SWTIEN19                 ((uint32_t)0x00080000)        //! Software trigger interrupt/event for line19
#define  EXTI_SWTIEN_SWTIEN20                 ((uint32_t)0x00100000)        //! Software trigger interrupt/event for line20
#define  EXTI_SWTIEN_SWTIEN21                 ((uint32_t)0x00200000)        //! Software trigger interrupt/event for line21
#define  EXTI_SWTIEN_SWTIEN22                 ((uint32_t)0x00400000)        //! Software trigger interrupt/event for line22
#define  EXTI_SWTIEN_SWTIEN31                 ((uint32_t)0x80000000)        //! Software trigger interrupt/event for line31

/**
* @brief EXTI_PDF register Bit definition
*/
#define  EXTI_PDF_PDF0                        ((uint32_t)0x00000001)        //! Pending interrupt flag for line 0
#define  EXTI_PDF_PDF1                        ((uint32_t)0x00000002)        //! Pending interrupt flag for line 1
#define  EXTI_PDF_PDF2                        ((uint32_t)0x00000004)        //! Pending interrupt flag for line 2
#define  EXTI_PDF_PDF3                        ((uint32_t)0x00000008)        //! Pending interrupt flag for line 3
#define  EXTI_PDF_PDF4                        ((uint32_t)0x00000010)        //! Pending interrupt flag for line 4
#define  EXTI_PDF_PDF5                        ((uint32_t)0x00000020)        //! Pending interrupt flag for line 5
#define  EXTI_PDF_PDF6                        ((uint32_t)0x00000040)        //! Pending interrupt flag for line 6
#define  EXTI_PDF_PDF7                        ((uint32_t)0x00000080)        //! Pending interrupt flag for line 7
#define  EXTI_PDF_PDF8                        ((uint32_t)0x00000100)        //! Pending interrupt flag for line 8
#define  EXTI_PDF_PDF9                        ((uint32_t)0x00000200)        //! Pending interrupt flag for line 9
#define  EXTI_PDF_PDF10                       ((uint32_t)0x00000400)        //! Pending interrupt flag for line 10
#define  EXTI_PDF_PDF11                       ((uint32_t)0x00000800)        //! Pending interrupt flag for line 11
#define  EXTI_PDF_PDF12                       ((uint32_t)0x00001000)        //! Pending interrupt flag for line 12
#define  EXTI_PDF_PDF13                       ((uint32_t)0x00002000)        //! Pending interrupt flag for line 13
#define  EXTI_PDF_PDF14                       ((uint32_t)0x00004000)        //! Pending interrupt flag for line 14
#define  EXTI_PDF_PDF15                       ((uint32_t)0x00008000)        //! Pending interrupt flag for line 15
#define  EXTI_PDF_PDF16                       ((uint32_t)0x00010000)        //! Pending interrupt flag for line 16
#define  EXTI_PDF_PDF17                       ((uint32_t)0x00020000)        //! Pending interrupt flag for line 17
#define  EXTI_PDF_PDF19                       ((uint32_t)0x00080000)        //! Pending interrupt flag for line 19
#define  EXTI_PDF_PDF20                       ((uint32_t)0x00100000)        //! Pending interrupt flag for line 20
#define  EXTI_PDF_PDF21                       ((uint32_t)0x00200000)        //! Pending interrupt flag for line 21
#define  EXTI_PDF_PDF22                       ((uint32_t)0x00400000)        //! Pending interrupt flag for line 22
#define  EXTI_PDF_PDF31                       ((uint32_t)0x80000000)        //! Pending interrupt flag for line 31


/*---------------------------------------------------------------------------*/
/*   FMC(FLASH Memory Control) and Option Byes Registers                     */
/*---------------------------------------------------------------------------*/

/**
* @brief FMC_WCR register Bit definition
*/
#define  FMC_WCR_WCNT                         ((uint32_t)0x00000001)        //! NT bit (FMC wait conuter)
#define  FMC_WCR_WE                           ((uint32_t)0x00000010)        //! MC wait enable
#define  FMC_WCR_WS                           ((uint32_t)0x00000020)        //! MC wait status(read only)

/**
* @brief FMC_CCODE register Bit definition
*/
#define  FMC_CCODE_CCODE                      ((uint32_t)0xFFFFFFFF)        //! MC Control code

/**
* @brief FMC_OBCCODE register Bit definition
*/
#define  FMC_OBCCODE_OBCCODE                  ((uint32_t)0xFFFFFFFF)        //! FMC Option Byte Control code

/**
* @brief FMC CCODE Bit definition
*/
#define FMC_CCODE_VALUE1                      ((uint32_t)0x45670123)        //! Flash program erase key1
#define FMC_CCODE_VALUE2                      ((uint32_t)0xCDEF89AB)        //! Flash program erase key2
#define FMC_OBCCODE_VALUE1                    ((uint32_t)0x45670123)        //! Flash option key1
#define FMC_OBCCODE_VALUE2                    ((uint32_t)0xCDEF89AB)        //! Flash option key2

/**
* @brief FMC_STS register Bit definition
*/
#define  FMC_STS_BUSY                         ((uint32_t)0x00000001)        //! Busy
#define  FMC_STS_PGERR                        ((uint32_t)0x00000004)        //! Programming Error
#define  FMC_STS_WPERR                        ((uint32_t)0x00000010)        //! Write Protection Error
#define  FMC_STS_ENDF                         ((uint32_t)0x00000020)        //! End of operation

/**
* @brief FMC_CTR register Bit definition
*/
#define  FMC_CTR_PG                           ((uint32_t)0x00000001)        //! Main flash program
#define  FMC_CTR_PERS                         ((uint32_t)0x00000002)        //! Flash page erase
#define  FMC_CTR_CHIPERS                      ((uint32_t)0x00000004)        //! Mass flash CHIP ERASE
#define  FMC_CTR_OBPG                         ((uint32_t)0x00000010)        //! Option byte program command
#define  FMC_CTR_OBERS                        ((uint32_t)0x00000020)        //! Option bytes erase command
#define  FMC_CTR_START                        ((uint32_t)0x00000040)        //! Start of erase
#define  FMC_CTR_LOCK                         ((uint32_t)0x00000080)        //! Lock
#define  FMC_CTR_OBWEN                        ((uint32_t)0x00000200)        //! Option byte erase/program enable
#define  FMC_CTR_ERRIE                        ((uint32_t)0x00000400)        //! Error interrupt enable
#define  FMC_CTR_ENDIE                        ((uint32_t)0x00001000)        //! End of operation interrupt enable
#define  FMC_CTR_OBUPDATE                     ((uint32_t)0x00002000)        //! Update option byte

/**
* @brief FMC_ERSADR register Bit definition
*/
#define  FMC_ERSADR_ERSADR                    ((uint32_t)0xFFFFFFFF)        // lash erase address

/**
* @brief FMC_OBSTS register Bit definition
*/
#define  FMC_OBSTS_OBERR                      ((uint32_t)0x00000001)        //! OBERR
#define  FMC_OBSTS_RPROT1                     ((uint32_t)0x00000002)        //! Read protection Level bit 1
#define  FMC_OBSTS_RPROT2                     ((uint32_t)0x00000004)        //! Read protection Level bit 2
#define  FMC_OBSTS_USER                       ((uint32_t)0x00003700)        //! User Option Bytes
#define  FMC_OBSTS_FWDT_AO                    ((uint32_t)0x00000100)        //! FWDT_ALWAYSON
#define  FMC_OBSTS_nRST_DSM                   ((uint32_t)0x00000200)        //! nRST_DSM 
#define  FMC_OBSTS_nRST_PWD                   ((uint32_t)0x00000400)        //! nRST_PWD
//#define  FMC_OBSTS_nBOOT0                     ((uint32_t)0x00000800)        //! nBOOT0
#define  FMC_OBSTS_nBOOT1                     ((uint32_t)0x00001000)        //! nBOOT1
#define  FMC_OBSTS_VDDA_DET                   ((uint32_t)0x00002000)        //! VDDA_DETECT
#define  FMC_OBSTS_RAM_PCHK                   ((uint32_t)0x00004000)        //! RAM_PARITY_CHECK
//#define  FMC_OBSTS_nBOOT0_SW                  ((uint32_t)0x00008000)        //! nBOOT0 SW
#define  FMC_OBSTS_DATA0                      ((uint32_t)0x00FF0000)        //! DATA0
#define  FMC_OBSTS_DATA1                      ((uint32_t)0xFF000000)        //! DATA1


/**
* @brief FMC_WPSTS register Bit definition
*/
#define  FMC_WPSTS_WPROT                      ((uint32_t)0xFFFFFFFF)        //!  Write Protect


/**
* @brief OB_RPROT register Bit definition
*/
#define  OB_RPROT_RPROT                       ((uint32_t)0x000000FF)        //!  Read protection option byte
#define  OB_RPROT_nRPROT                      ((uint32_t)0x0000FF00)        //!  Read protection complemented option byte

/**
* @brief OB_USER register Bit definition
*/
#define  OB_USER_USER                         ((uint32_t)0x00FF0000)        //!  User option byte
#define  OB_USER_nUSER                        ((uint32_t)0xFF000000)        //!  User complemented option byte

/**
* @brief OB_WPROT0 register Bit definition
*/
#define  OB_WPROT0_WPROT0                     ((uint32_t)0x000000FF)        //!  Flash memory write protection option bytes
#define  OB_WPROT0_nWPROT0                    ((uint32_t)0x0000FF00)        //!  Flash memory write protection complemented option bytes

/**
* @brief OB_WPROT1 register Bit definition
*/
#define  OB_WPROT1_WPROT1                     ((uint32_t)0x00FF0000)        //!  Flash memory write protection option bytes
#define  OB_WPROT1_nWPROT1                    ((uint32_t)0xFF000000)        //!  Flash memory write protection complemented option bytes

/**
* @brief OB_WPROT2 register Bit definition
*/
#define  OB_WPROT2_WPROT2                     ((uint32_t)0x000000FF)        //!  Flash memory write protection option bytes
#define  OB_WPROT2_nWPROT2                    ((uint32_t)0x0000FF00)        //!  Flash memory write protection complemented option bytes

/**
* @brief OB_WPROT3 register Bit definition
*/
#define  OB_WPROT3_WPROT3                     ((uint32_t)0x00FF0000)        //!  Flash memory write protection option bytes
#define  OB_WPROT3_nWPROT3                    ((uint32_t)0xFF000000)        //!  Flash memory write protection complemented option bytes

/*---------------------------------------------------------------------------*/
/*            General Purpose input/output (PIO)                             */
/*---------------------------------------------------------------------------*/

/**
* @brief GPIO_PFR register Bit definition
*/
#define GPIO_PFR_FUNC0                        ((uint32_t)0x00000003)  //!< FUNC[1:0] Port function  bits
#define GPIO_PFR_FUNC0_0                      ((uint32_t)0x00000001)  //!< bit
#define GPIO_PFR_FUNC0_1                      ((uint32_t)0x00000002)  //!< bit
#define GPIO_PFR_FUNC1                        ((uint32_t)0x0000000C)  //!< FUNC[1:0] Port function  bits
#define GPIO_PFR_FUNC1_0                      ((uint32_t)0x00000004)  //!< bit
#define GPIO_PFR_FUNC1_1                      ((uint32_t)0x00000008)  //!< bit
#define GPIO_PFR_FUNC2                        ((uint32_t)0x00000030)  //!< FUNC[1:0] Port function  bits
#define GPIO_PFR_FUNC2_0                      ((uint32_t)0x00000010)  //!< bit
#define GPIO_PFR_FUNC2_1                      ((uint32_t)0x00000020)  //!< bit
#define GPIO_PFR_FUNC3                        ((uint32_t)0x000000C0)  //!< FUNC[1:0] Port function  bits
#define GPIO_PFR_FUNC3_0                      ((uint32_t)0x00000040)  //!< bit
#define GPIO_PFR_FUNC3_1                      ((uint32_t)0x00000080)  //!< bit
#define GPIO_PFR_FUNC4                        ((uint32_t)0x00000300)  //!< FUNC[1:0] Port function  bits
#define GPIO_PFR_FUNC4_0                      ((uint32_t)0x00000100)  //!< bit
#define GPIO_PFR_FUNC4_1                      ((uint32_t)0x00000200)  //!< bit
#define GPIO_PFR_FUNC5                        ((uint32_t)0x00000C00)  //!< FUNC[1:0] Port function  bits
#define GPIO_PFR_FUNC5_0                      ((uint32_t)0x00000400)  //!< bit
#define GPIO_PFR_FUNC5_1                      ((uint32_t)0x00000800)  //!< bit
#define GPIO_PFR_FUNC6                        ((uint32_t)0x00003000)  //!< FUNC[1:0] Port function  bits
#define GPIO_PFR_FUNC6_0                      ((uint32_t)0x00001000)  //!< bit
#define GPIO_PFR_FUNC6_1                      ((uint32_t)0x00002000)  //!< bit
#define GPIO_PFR_FUNC7                        ((uint32_t)0x0000C000)  //!< FUNC[1:0] Port function  bits
#define GPIO_PFR_FUNC7_0                      ((uint32_t)0x00004000)  //!< bit
#define GPIO_PFR_FUNC7_1                      ((uint32_t)0x00008000)  //!< bit
#define GPIO_PFR_FUNC8                        ((uint32_t)0x00030000)  //!< FUNC[1:0] Port function  bits
#define GPIO_PFR_FUNC8_0                      ((uint32_t)0x00010000)  //!< bit
#define GPIO_PFR_FUNC8_1                      ((uint32_t)0x00020000)  //!< bit
#define GPIO_PFR_FUNC9                        ((uint32_t)0x000C0000)  //!< FUNC[1:0] Port function  bits
#define GPIO_PFR_FUNC9_0                      ((uint32_t)0x00040000)  //!< bit
#define GPIO_PFR_FUNC9_1                      ((uint32_t)0x00080000)  //!< bit
#define GPIO_PFR_FUNC10                       ((uint32_t)0x00300000)  //!< FUNC0[1:0] Port function  bits
#define GPIO_PFR_FUNC10_0                     ((uint32_t)0x00100000)  //!< bit
#define GPIO_PFR_FUNC10_1                     ((uint32_t)0x00200000)  //!< bit
#define GPIO_PFR_FUNC11                       ((uint32_t)0x00C00000)  //!< FUNC1[1:0] Port function  bits
#define GPIO_PFR_FUNC11_0                     ((uint32_t)0x00400000)  //!< bit
#define GPIO_PFR_FUNC11_1                     ((uint32_t)0x00800000)  //!< bit
#define GPIO_PFR_FUNC12                       ((uint32_t)0x03000000)  //!< FUNC2[1:0] Port function  bits
#define GPIO_PFR_FUNC12_0                     ((uint32_t)0x01000000)  //!< bit
#define GPIO_PFR_FUNC12_1                     ((uint32_t)0x02000000)  //!< bit
#define GPIO_PFR_FUNC13                       ((uint32_t)0x0C000000)  //!< FUNC3[1:0] Port function  bits
#define GPIO_PFR_FUNC13_0                     ((uint32_t)0x04000000)  //!< bit
#define GPIO_PFR_FUNC13_1                     ((uint32_t)0x08000000)  //!< bit
#define GPIO_PFR_FUNC14                       ((uint32_t)0x30000000)  //!< FUNC4[1:0] Port function  bits
#define GPIO_PFR_FUNC14_0                     ((uint32_t)0x10000000)  //!< bit
#define GPIO_PFR_FUNC14_1                     ((uint32_t)0x20000000)  //!< bit
#define GPIO_PFR_FUNC15                       ((uint32_t)0xC0000000)  //!< FUNC5[1:0] Port function  bits
#define GPIO_PFR_FUNC15_0                     ((uint32_t)0x40000000)  //!< bit
#define GPIO_PFR_FUNC15_1                     ((uint32_t)0x80000000)  //!< bit

/**
* @brief GPIO_PODENR register Bit definition
*/
#define GPIO_PODENR_ODEN_0                    ((uint32_t)0x00000001)  //!< Portbit 0 output open-drain enable
#define GPIO_PODENR_ODEN_1                    ((uint32_t)0x00000002)  //!< Portbit 1 output open-drain enable
#define GPIO_PODENR_ODEN_2                    ((uint32_t)0x00000004)  //!< Portbit 2 output open-drain enable
#define GPIO_PODENR_ODEN_3                    ((uint32_t)0x00000008)  //!< Portbit 3 output open-drain enable
#define GPIO_PODENR_ODEN_4                    ((uint32_t)0x00000010)  //!< Portbit 4 output open-drain enable
#define GPIO_PODENR_ODEN_5                    ((uint32_t)0x00000020)  //!< Portbit 5 output open-drain enable
#define GPIO_PODENR_ODEN_6                    ((uint32_t)0x00000040)  //!< Portbit 6 output open-drain enable
#define GPIO_PODENR_ODEN_7                    ((uint32_t)0x00000080)  //!< Portbit 7 output open-drain enable
#define GPIO_PODENR_ODEN_8                    ((uint32_t)0x00000100)  //!< Portbit 8 output open-drain enable
#define GPIO_PODENR_ODEN_9                    ((uint32_t)0x00000200)  //!< Portbit 9 output open-drain enable
#define GPIO_PODENR_ODEN_10                   ((uint32_t)0x00000400)  //!< Portbit 10 output open-drain enable
#define GPIO_PODENR_ODEN_11                   ((uint32_t)0x00000800)  //!< Portbit 11 output open-drain enable
#define GPIO_PODENR_ODEN_12                   ((uint32_t)0x00001000)  //!< Portbit 12 output open-drain enable
#define GPIO_PODENR_ODEN_13                   ((uint32_t)0x00002000)  //!< Portbit 13 output open-drain enable
#define GPIO_PODENR_ODEN_14                   ((uint32_t)0x00004000)  //!< Portbit 14 output open-drain enable
#define GPIO_PODENR_ODEN_15                   ((uint32_t)0x00008000)  //!< Portbit 15 output open-drain enable

/**
* @brief GPIO_POSR register Bit definition
*/
#define GPIO_POSR_OS0                         ((uint32_t)0x00000003)  //!< OS0[:0] (output speed)
#define GPIO_POSR_OS0_0                       ((uint32_t)0x00000001)  //!< bit
#define GPIO_POSR_OS0_1                       ((uint32_t)0x00000002)  //!< bit
#define GPIO_POSR_OS1                         ((uint32_t)0x0000000C)  //!<OS1[10] (output speed)
#define GPIO_POSR_OS1_0                       ((uint32_t)0x00000004)  //!< bit
#define GPIO_POSR_OS1_1                       ((uint32_t)0x00000008)  //!< bit
#define GPIO_POSR_OS2                         ((uint32_t)0x00000030)  //!< OS2[:0] (output speed)
#define GPIO_POSR_OS2_0                       ((uint32_t)0x00000010)  //!< bit
#define GPIO_POSR_OS2_1                       ((uint32_t)0x00000020)  //!< bit
#define GPIO_POSR_OS3                         ((uint32_t)0x000000C0)  //!< OS3[:0] (output speed)
#define GPIO_POSR_OS3_0                       ((uint32_t)0x00000040)  //!< bit
#define GPIO_POSR_OS3_1                       ((uint32_t)0x00000080)  //!< bit
#define GPIO_POSR_OS4                         ((uint32_t)0x00000300)  //!< OS4[:0] (output speed)
#define GPIO_POSR_OS4_0                       ((uint32_t)0x00000100)  //!< bit
#define GPIO_POSR_OS4_1                       ((uint32_t)0x00000200)  //!< bit
#define GPIO_POSR_OS5                         ((uint32_t)0x00000C00)  //!< OS5[:0] (output speed)
#define GPIO_POSR_OS5_0                       ((uint32_t)0x00000400)  //!< bit
#define GPIO_POSR_OS5_1                       ((uint32_t)0x00000800)  //!< bit
#define GPIO_POSR_OS6                         ((uint32_t)0x00003000)  //!< OS6[:0] (output speed)
#define GPIO_POSR_OS6_0                       ((uint32_t)0x00001000)  //!< bit
#define GPIO_POSR_OS6_1                       ((uint32_t)0x00002000)  //!< bit
#define GPIO_POSR_OS7                         ((uint32_t)0x0000C000)  //!< OS7[:0] (output speed)
#define GPIO_POSR_OS7_0                       ((uint32_t)0x00004000)  //!< bit
#define GPIO_POSR_OS7_1                       ((uint32_t)0x00008000)  //!< bit
#define GPIO_POSR_OS8                         ((uint32_t)0x00030000)  //!< OS8[:0] (output speed)
#define GPIO_POSR_OS8_0                       ((uint32_t)0x00010000)  //!< bit
#define GPIO_POSR_OS8_1                       ((uint32_t)0x00020000)  //!< bit
#define GPIO_POSR_OS9                         ((uint32_t)0x000C0000)  //!< OS9[:0] (output speed)
#define GPIO_POSR_OS9_0                       ((uint32_t)0x00040000)  //!< bit
#define GPIO_POSR_OS9_1                       ((uint32_t)0x00080000)  //!< bit
#define GPIO_POSR_OS10                        ((uint32_t)0x00300000)  //!< OS101:0] (output speed)
#define GPIO_POSR_OS10_0                      ((uint32_t)0x00100000)  //!< bit
#define GPIO_POSR_OS10_1                      ((uint32_t)0x00200000)  //!< bit
#define GPIO_POSR_OS11                        ((uint32_t)0x00C00000)  //!< OS111:0] (output speed)
#define GPIO_POSR_OS11_0                      ((uint32_t)0x00400000)  //!< bit
#define GPIO_POSR_OS11_1                      ((uint32_t)0x00800000)  //!< bit
#define GPIO_POSR_OS12                        ((uint32_t)0x03000000)  //!< OS121:0] (output speed)
#define GPIO_POSR_OS12_0                      ((uint32_t)0x01000000)  //!< bit
#define GPIO_POSR_OS12_1                      ((uint32_t)0x02000000)  //!< bit
#define GPIO_POSR_OS13                        ((uint32_t)0x0C000000)  //!< OS131:0] (output speed)
#define GPIO_POSR_OS13_0                      ((uint32_t)0x04000000)  //!< bit
#define GPIO_POSR_OS13_1                      ((uint32_t)0x08000000)  //!< bit
#define GPIO_POSR_OS14                        ((uint32_t)0x30000000)  //!< OS141:0] (output speed)
#define GPIO_POSR_OS14_0                      ((uint32_t)0x10000000)  //!< bit
#define GPIO_POSR_OS14_1                      ((uint32_t)0x20000000)  //!< bit
#define GPIO_POSR_OS15                        ((uint32_t)0xC0000000)  //!< OS151:0] (output speed)
#define GPIO_POSR_OS15_0                      ((uint32_t)0x40000000)  //!< bit
#define GPIO_POSR_OS15_1                      ((uint32_t)0x80000000)  //!< bit


/**
* @brief GPIO_PUPDR register Bit definition
*/
#define GPIO_PUPDR_PUPD0                      ((uint32_t)0x00000003)  //!< PUPD0[1:0]config (pull-up/pull-down )
#define GPIO_PUPDR_PUPD0_0                    ((uint32_t)0x00000001)  //!< bit 0
#define GPIO_PUPDR_PUPD0_1                    ((uint32_t)0x00000002)  //!< bit 1
#define GPIO_PUPDR_PUPD1                      ((uint32_t)0x0000000C)  //!< PUPD1[1:0]config (pull-up/pull-down )
#define GPIO_PUPDR_PUPD1_0                    ((uint32_t)0x00000004)  //!< bit 0
#define GPIO_PUPDR_PUPD1_1                    ((uint32_t)0x00000008)  //!< bit 1
#define GPIO_PUPDR_PUPD2                      ((uint32_t)0x00000030)  //!< PUPD2[1:0]config (pull-up/pull-down )
#define GPIO_PUPDR_PUPD2_0                    ((uint32_t)0x00000010)  //!< bit 0
#define GPIO_PUPDR_PUPD2_1                    ((uint32_t)0x00000020)  //!< bit 1
#define GPIO_PUPDR_PUPD3                      ((uint32_t)0x000000C0)  //!< PUPD3[1:0]config (pull-up/pull-down )
#define GPIO_PUPDR_PUPD3_0                    ((uint32_t)0x00000040)  //!< bit 0
#define GPIO_PUPDR_PUPD3_1                    ((uint32_t)0x00000080)  //!< bit 1
#define GPIO_PUPDR_PUPD4                      ((uint32_t)0x00000300)  //!< PUPD4[1:0]config (pull-up/pull-down )
#define GPIO_PUPDR_PUPD4_0                    ((uint32_t)0x00000100)  //!< bit 0
#define GPIO_PUPDR_PUPD4_1                    ((uint32_t)0x00000200)  //!< bit 1
#define GPIO_PUPDR_PUPD5                      ((uint32_t)0x00000C00)  //!< PUPD5[1:0]config (pull-up/pull-down )
#define GPIO_PUPDR_PUPD5_0                    ((uint32_t)0x00000400)  //!< bit 0
#define GPIO_PUPDR_PUPD5_1                    ((uint32_t)0x00000800)  //!< bit 1
#define GPIO_PUPDR_PUPD6                      ((uint32_t)0x00003000)  //!< PUPD6[1:0]config (pull-up/pull-down )
#define GPIO_PUPDR_PUPD6_0                    ((uint32_t)0x00001000)  //!< bit 0
#define GPIO_PUPDR_PUPD6_1                    ((uint32_t)0x00002000)  //!< bit 1
#define GPIO_PUPDR_PUPD7                      ((uint32_t)0x0000C000)  //!< PUPD7[1:0]config (pull-up/pull-down )
#define GPIO_PUPDR_PUPD7_0                    ((uint32_t)0x00004000)  //!< bit 0
#define GPIO_PUPDR_PUPD7_1                    ((uint32_t)0x00008000)  //!< bit 1
#define GPIO_PUPDR_PUPD8                      ((uint32_t)0x00030000)  //!< PUPD8[1:0]config (pull-up/pull-down )
#define GPIO_PUPDR_PUPD8_0                    ((uint32_t)0x00010000)  //!< bit 0
#define GPIO_PUPDR_PUPD8_1                    ((uint32_t)0x00020000)  //!< bit 1
#define GPIO_PUPDR_PUPD9                      ((uint32_t)0x000C0000)  //!< PUPD9[1:0]config (pull-up/pull-down )
#define GPIO_PUPDR_PUPD9_0                    ((uint32_t)0x00040000)  //!< bit 0
#define GPIO_PUPDR_PUPD9_1                    ((uint32_t)0x00080000)  //!< bit 1
#define GPIO_PUPDR_PUPD10                     ((uint32_t)0x00300000)  //!< PUPD10[1:0]config (pull-up/pull-down )
#define GPIO_PUPDR_PUPD10_0                   ((uint32_t)0x00100000)  //!< bit 0
#define GPIO_PUPDR_PUPD10_1                   ((uint32_t)0x00200000)  //!< bit 1
#define GPIO_PUPDR_PUPD11                     ((uint32_t)0x00C00000)  //!< PUPD11[1:0]config (pull-up/pull-down )
#define GPIO_PUPDR_PUPD11_0                   ((uint32_t)0x00400000)  //!< bit 0
#define GPIO_PUPDR_PUPD11_1                   ((uint32_t)0x00800000)  //!< bit 1
#define GPIO_PUPDR_PUPD12                     ((uint32_t)0x03000000)  //!< PUPD12[1:0]config (pull-up/pull-down )
#define GPIO_PUPDR_PUPD12_0                   ((uint32_t)0x01000000)  //!< bit 0
#define GPIO_PUPDR_PUPD12_1                   ((uint32_t)0x02000000)  //!< bit 1
#define GPIO_PUPDR_PUPD13                     ((uint32_t)0x0C000000)  //!< PUPD13[1:0]config (pull-up/pull-down )
#define GPIO_PUPDR_PUPD13_0                   ((uint32_t)0x04000000)  //!< bit 0
#define GPIO_PUPDR_PUPD13_1                   ((uint32_t)0x08000000)  //!< bit 1
#define GPIO_PUPDR_PUPD14                     ((uint32_t)0x30000000)  //!< PUPD14[1:0]config (pull-up/pull-down )
#define GPIO_PUPDR_PUPD14_0                   ((uint32_t)0x10000000)  //!< bit 0
#define GPIO_PUPDR_PUPD14_1                   ((uint32_t)0x20000000)  //!< bit 1
#define GPIO_PUPDR_PUPD15                     ((uint32_t)0xC0000000)  //!< PUPD15[1:0]config (pull-up/pull-down )
#define GPIO_PUPDR_PUPD15_0                   ((uint32_t)0x40000000)  //!< bit 0
#define GPIO_PUPDR_PUPD15_1                   ((uint32_t)0x80000000)  //!< bit 1

/**
* @brief GPIO_DI register Bit definition
*/
#define GPIO_DI_0                             ((uint32_t)0x00000001)  //!< Portx bit 0 data input
#define GPIO_DI_1                             ((uint32_t)0x00000002)  //!< Portx bit 1 data input
#define GPIO_DI_2                             ((uint32_t)0x00000004)  //!< Portx bit 2 data input
#define GPIO_DI_3                             ((uint32_t)0x00000008)  //!< Portx bit 3 data input
#define GPIO_DI_4                             ((uint32_t)0x00000010)  //!< Portx bit 4 data input
#define GPIO_DI_5                             ((uint32_t)0x00000020)  //!< Portx bit 5 data input
#define GPIO_DI_6                             ((uint32_t)0x00000040)  //!< Portx bit 6 data input
#define GPIO_DI_7                             ((uint32_t)0x00000080)  //!< Portx bit 7 data input
#define GPIO_DI_8                             ((uint32_t)0x00000100)  //!< Portx bit 8 data input
#define GPIO_DI_9                             ((uint32_t)0x00000200)  //!< Portx bit 9 data input
#define GPIO_DI_10                            ((uint32_t)0x00000400)  //!< Portx bit 10 data input
#define GPIO_DI_11                            ((uint32_t)0x00000800)  //!< Portx bit 11 data input
#define GPIO_DI_12                            ((uint32_t)0x00001000)  //!< Portx bit 12 data input
#define GPIO_DI_13                            ((uint32_t)0x00002000)  //!< Portx bit 13 data input
#define GPIO_DI_14                            ((uint32_t)0x00004000)  //!< Portx bit 14 data input
#define GPIO_DI_15                            ((uint32_t)0x00008000)  //!< Portx bit 15 data input

/**
* @brief GPIO_DO register Bit definition
*/
#define GPIO_DO_0                             ((uint32_t)0x00000001)  //!< Portx bit 0 data output
#define GPIO_DO_1                             ((uint32_t)0x00000002)  //!< Portx bit 1 data output
#define GPIO_DO_2                             ((uint32_t)0x00000004)  //!< Portx bit 2 data output
#define GPIO_DO_3                             ((uint32_t)0x00000008)  //!< Portx bit 3 data output
#define GPIO_DO_4                             ((uint32_t)0x00000010)  //!< Portx bit 4 data output
#define GPIO_DO_5                             ((uint32_t)0x00000020)  //!< Portx bit 5 data output
#define GPIO_DO_6                             ((uint32_t)0x00000040)  //!< Portx bit 6 data output
#define GPIO_DO_7                             ((uint32_t)0x00000080)  //!< Portx bit 7 data output
#define GPIO_DO_8                             ((uint32_t)0x00000100)  //!< Portx bit 8 data output
#define GPIO_DO_9                             ((uint32_t)0x00000200)  //!< Portx bit 9 data output
#define GPIO_DO_10                            ((uint32_t)0x00000400)  //!< Portx bit 10 data output
#define GPIO_DO_11                            ((uint32_t)0x00000800)  //!< Portx bit 11 data output
#define GPIO_DO_12                            ((uint32_t)0x00001000)  //!< Portx bit 12 data output
#define GPIO_DO_13                            ((uint32_t)0x00002000)  //!< Portx bit 13 data output
#define GPIO_DO_14                            ((uint32_t)0x00004000)  //!< Portx bit 14 data output
#define GPIO_DO_15                            ((uint32_t)0x00008000)  //!< Portx bit 15 data output
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
