lyy622516-web/phase_shifter/(commit log)

2026-10-31 Initial import of hardware project
    [3D_PHASE_SHIFTER_2026-10-27.step, 3D_PHASE_SHIFTER_2026-10-31.step, AIP74LVC8T245TA24.TR.PrjPcb, AIP74LVC8T245TA24.TR.pcbdoc, AIP74LVC8T245TA24.TR.schdoc, B5819W_C7420330.PrjPcb, B5819W_C7420330.pcbdoc, B5819W_C7420330.schdoc]
2026-11-02 Add six enclosure engineering drawings and complete delivery package
    [前侧板_4mm.SLDPRT, 前侧板_4mm_工程图.SLDDRW, 前侧板_4mm_工程图.dxf, 右射频侧板_4mm.SLDPRT, 右射频侧板_4mm_工程图.SLDDRW, 右射频侧板_4mm_工程图.dxf, 后接口侧板_4mm.SLDPRT, 后接口侧板_4mm_工程图.SLDDRW]
2026-11-02 Add 3D enclosure assembly, referenced parts, STEP exports and previews
    [0805~R0805____________~hDe1.step.SLDPRT, 3D_PHASE_SHIFTER_2026-10-31.step, 3D_PHASE_SHIFTER_2026-10-31.step.SLDASM, Board~SNnK.step.SLDPRT, C5~0805~R0805____________~LFKa.step.SLDASM, CRYSTAL-SMD_4P-L3.2-W2.5-BL~CRYSTAL-SMD_4P-L3.2-W2.5-BL~fSab.step.SLDPRT, J1~TYPEC_16PIN~TYPE-C-SMD_TYPE-C-16PIN-L7.35~CO1h.step.SLDASM, J2~TYPEC_16PIN~TYPE-C-SMD_TYPE-C-16PIN-L7.35~P95g.step.SLDASM]
2026-11-02 Add packaging structure design report (six-piece enclosure) 20261102
2026-11-03 Enlarge Type-C side openings, clean legacy features and refresh drawings
    [0805~R0805____________~hDe1.step.SLDPRT, 3D_PHASE_SHIFTER_2026-10-31.step.SLDASM, Board~SNnK.step.SLDPRT, C5~0805~R0805____________~LFKa.step.SLDASM, CRYSTAL-SMD_4P-L3.2-W2.5-BL~CRYSTAL-SMD_4P-L3.2-W2.5-BL~fSab.step.SLDPRT, J1~TYPEC_16PIN~TYPE-C-SMD_TYPE-C-16PIN-L7.35~CO1h.step.SLDASM, J2~TYPEC_16PIN~TYPE-C-SMD_TYPE-C-16PIN-L7.35~P95g.step.SLDASM, J4_1.25~CONN-SMD_4P-P1.25_XUNPU_WAFER-GH1.25-4PWB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]
2026-11-03 Replace enclosure with flat base design and nine-part SMA assembly
    [0805~R0805____________~hDe1.step.SLDPRT, 3D_PHASE_SHIFTER_2026-10-31.step, 3D_PHASE_SHIFTER_2026-10-31.step.SLDASM, Board~SNnK.step.SLDPRT, C5~0805~R0805____________~LFKa.step.SLDASM, CRYSTAL-SMD_4P-L3.2-W2.5-BL~CRYSTAL-SMD_4P-L3.2-W2.5-BL~fSab.step.SLDPRT, J1~TYPEC_16PIN~TYPE-C-SMD_TYPE-C-16PIN-L7.35~CO1h.step.SLDASM, J2~TYPEC_16PIN~TYPE-C-SMD_TYPE-C-16PIN-L7.35~P95g.step.SLDASM]
2026-11-03 Add paired M2 corner fasteners and refresh enclosure drawings
    [corner_draw_part0.tsv, corner_draw_part1.tsv, corner_draw_part2.tsv, corner_draw_part3.tsv, corner_draw_part4.tsv, corner_draw_part5.tsv, corner_draw_part6.tsv, drawing_static_part0.tsv]
2026-11-04 Add flat-base enclosure report (four-corner double screws) 20261104
2026-11-04 Replace enclosure with side-fastened CAD models
    [PCB参考.step, SMA右.step, SMA左.step, corner_draw_part0.tsv, corner_draw_part1.tsv, corner_draw_part2.tsv, corner_draw_part3.tsv, corner_draw_part4.tsv]
2026-11-04 Update six enclosure drawings for side fastening
    [前侧板_工程图.SLDDRW, 前侧板_工程图.dxf, 右射频侧板_工程图.SLDDRW, 右射频侧板_工程图.dxf, 后接口侧板_工程图.SLDDRW, 后接口侧板_工程图.dxf, 左射频侧板_工程图.SLDDRW, 左射频侧板_工程图.dxf]
2026-11-04 Update report to side-fastened enclosure model 20261104
2026-11-04 Add 3D and drawing previews for six enclosure parts
2026-11-04 Add 3D and drawing figures to side-fastened enclosure report
2026-11-04 Add user-edited side-fastened enclosure folder
    [PCB参考.SLDPRT, SMA右.SLDPRT, SMA左.SLDPRT, 前侧板.SLDPRT, 前侧板_工程图.SLDDRW, 右射频侧板.SLDPRT, 右射频侧板_工程图.SLDDRW, 后接口侧板.SLDPRT]
2026-11-05 Create 上位机软件
